hakanuzum/gmktec-k11-dual-fan-case/README.md

# GMKtec K11 Dual-Fan Case

**English** · [Türkçe](README.tr.md)

A 3D-printable enclosure that turns a GMKtec K11 mini PC into a small, closed tower with two 120 mm fans. The fans are powered from the K11's own USB ports, so there is no soldering and no extra power supply. The front and rear ports stay fully accessible.

| | |
|---|---|
| **Live 3D viewer** | **[hakanuzum.github.io/gmktec-k11-dual-fan-case](https://hakanuzum.github.io/gmktec-k11-dual-fan-case/viewer/)**: rotate, explode, cut a section, show the airflow, colour-code every part and see through the case (**Show how it fits together**), click any part to see what it does |
| **3D preview here** | [Below](#3d-preview): GitHub renders it, drag to rotate |
| **Single parts in 3D** | Click any file in [`stl/`](stl/): GitHub opens it in a 3D viewer |
| **Print files** | [`stl/`](stl/): 4 parts |
| **Editable source** | [`cad/k11_dual_fan_case.scad`](cad/k11_dual_fan_case.scad) (OpenSCAD, with Customizer sliders) |

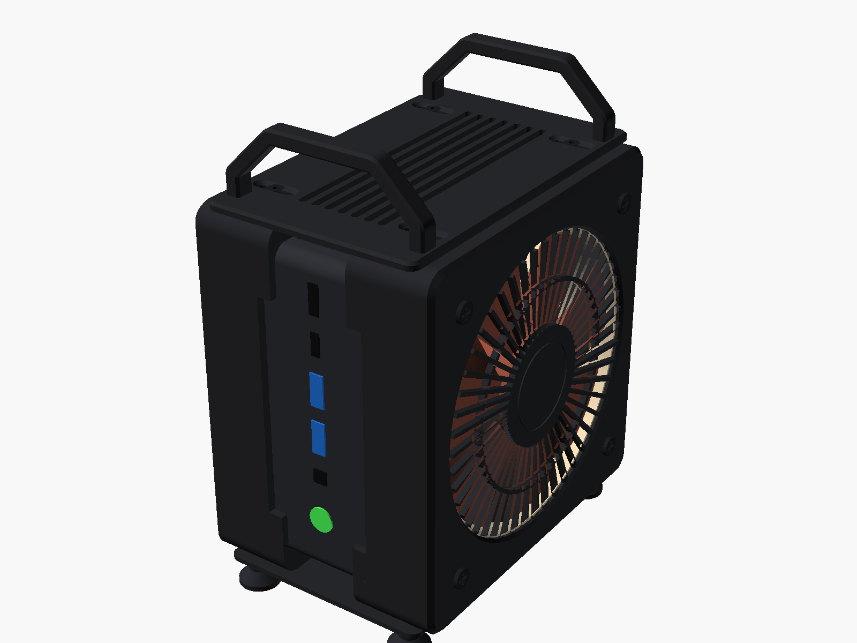
[picture p1: docs/images/hero.png]
Assembled case, black, with Noctua fans


> **Status:** designed and checked in software (see [Verification](#verification)); not yet printed and fitted on a real K11. Print one fan holder first and dry-fit it before printing the rest. Feedback and photos are welcome in the issues.

## 3D preview

Monochrome, low-poly preview of the closed case with a stand-in K11. Use the [live viewer](https://hakanuzum.github.io/gmktec-k11-dual-fan-case/viewer/) for colours, the exploded view and the airflow.

<!-- model:start -->
```stl
solid K11_DUAL_FAN_CASE_PREVIEW
facet normal 0.7 -0.3 -0.7
outer loop
vertex 50 -65.5 17
vertex 48 -61.5 13
vertex 50 -61.5 15
endloop
endfacet
facet normal 0.7 -0.3 -0.7
outer loop
vertex 50 -65.5 17
vertex 48 -67 15.5
vertex 48 -61.5 13
endloop
endfacet
facet normal 0.7 -0.7 -0.3
outer loop
vertex 50 -65.5 17
vertex 50 -67.5 21
vertex 48 -69.5 21
endloop
endfacet
facet normal 0.7 -0.7 -0.3
outer loop
vertex 50 -65.5 17
vertex 48 -69.5 21
vertex 48 -67 15.5
endloop
endfacet
facet normal 1 -0 -0
outer loop
vertex 50 -65.5 17
vertex 50 -61.5 15
vertex 50 -67.5 21
endloop
endfacet
facet normal 1 0 0
outer loop
vertex 50 -61.5 15
vertex 50 -55 30
vertex 50 -55 33
endloop
endfacet
facet normal 1 0 -0
outer loop
vertex 50 -61.5 15
vertex 50 -52.5 29
vertex 50 -55 30
endloop
endfacet
facet normal 1 0 -0
outer loop
vertex 50 -61.5 15
vertex 50 -18 29
vertex 50 -52.5 29
endloop
endfacet
facet normal 1 0 -0
outer loop
vertex 50 -61.5 15
vertex 50 -55 33
vertex 50 -55 66
endloop
endfacet
facet normal 1 0 0
outer loop
vertex 50 -52.5 34
vertex 50 -55 66
vertex 50 -55 33
endloop
endfacet
facet normal 1 0 -0
outer loop
vertex 50 -52.5 29
vertex 50 -34 37
vertex 50 -50 30
endloop
endfacet
facet normal 1 -0 0
outer loop
vertex 50 -52.5 34
vertex 50 -50 33
vertex 50 -47 50
endloop
endfacet
facet normal 1 0 -0
outer loop
vertex 50 -50 30
vertex 50 -41 44
vertex 50 -50 33
endloop
endfacet
facet normal 1 0 -0
outer loop
vertex 50 -50 30
vertex 50 -40 43
vertex 50 -41 44
endloop
endfacet
facet normal 1 -0 -0
outer loop
vertex 50 -52.5 29
vertex 50 -18 29
vertex 50 -34 37
endloop
endfacet
facet normal 1 0 -0
outer loop
vertex 50 -50 30
vertex 50 -34 37
vertex 50 -40 43
endloop
endfacet
facet normal 1 0 -0
outer loop
vertex 50 -50 33
vertex 50 -41 44
vertex 50 -47 50
endloop
endfacet
facet normal -0 -0.4 -0.9
outer loop
vertex 48 -67 15.5
vertex 22 -67 15.5
vertex 48 -61.5 13
endloop
endfacet
facet normal -0 -0.9 -0.4
outer loop
vertex 48 -67 15.5
vertex 48 -69.5 21
vertex 22 -69.5 21
endloop
endfacet
facet normal 0.7 0 -0.7
outer loop
vertex 50 -61.5 15
vertex 48 -61.5 13
vertex 48 61.5 13
endloop
endfacet
facet normal 1 0 -0
outer loop
vertex 50 -61.5 15
vertex 50 -1 26
vertex 50 -18 29
endloop
endfacet
facet normal 1 0 -0
outer loop
vertex 50 -61.5 15
vertex 50 1 26
vertex 50 -1 26
endloop
endfacet
facet normal 1 0 -0
outer loop
vertex 50 -61.5 15
vertex 50 -55 66
vertex 50 -58 83
endloop
endfacet
facet normal 1 0 0
outer loop
vertex 50 -61.5 15
vertex 50 -67.5 147
vertex 50 -67.5 21
endloop
endfacet
facet normal 0.7 -0.7 0
outer loop
vertex 50 -67.5 21
vertex 48 -69.5 147
vertex 48 -69.5 21
endloop
endfacet
facet normal 1 0 0
outer loop
vertex 50 -61.5 15
vertex 50 -58 83
vertex 50 -58 85
endloop
endfacet
facet normal 1 0 -0
outer loop
vertex 50 -52.5 34
vertex 50 -47 50
vertex 50 -55 66
endloop
endfacet
facet normal 1 0 -0
outer loop
vertex 50 -61.5 15
vertex 50 -58 85
vertex 50 -67.5 147
endloop
endfacet
facet normal 1 0 -0
outer loop
vertex 50 -58 83
vertex 50 -23 83
vertex 50 -58 85
endloop
endfacet
facet normal 1 0 -0
outer loop
vertex 50 -40 43
vertex 50 -15 67.5
vertex 50 -41 44
endloop
endfacet
facet normal 1 0 -0
outer loop
vertex 50 -41 44
vertex 50 -15 67.5
vertex 50 -16.5 69
endloop
endfacet
facet normal 1 0 -0
outer loop
vertex 50 -1 26
vertex 50 1 61
vertex 50 -1 61
endloop
endfacet
facet normal 1 0 0
outer loop
vertex 50 -15 67.5
vertex 50 -11.5 64
vertex 50 -1 61
endloop
endfacet
facet normal 1 -0 -0
outer loop
vertex 50 -15 67.5
vertex 50 -1 61
vertex 50 -16.5 69
endloop
endfacet
facet normal 1 -0 -0
outer loop
vertex 50 -23 83
vertex 50 -20 72.5
vertex 50 -23 85
endloop
endfacet
facet normal 1 0 0
outer loop
vertex 50 -1 61
vertex 50 -20 72.5
vertex 50 -16.5 69
endloop
endfacet
facet normal 1 0 0
outer loop
vertex 50 -1 61
vertex 50 -23 85
vertex 50 -20 72.5
endloop
endfacet
facet normal 1 0 0
outer loop
vertex 50 1 61
vertex 50 -23 85
vertex 50 -1 61
endloop
endfacet
facet normal 1 0 -0
outer loop
vertex 50 1 61
vertex 50 11.5 64
vertex 50 -23 85
endloop
endfacet
facet normal 1 0 0
outer loop
vertex 50 16.5 69
vertex 50 -20 95.5
vertex 50 -23 85
endloop
endfacet
facet normal 0 -0.9 -0.4
outer loop
vertex 48 -67 15.5
vertex 22 -69.5 21
vertex 22 -67 15.5
endloop
endfacet
facet normal 0 -0.4 -0.9
outer loop
vertex 48 -61.5 13
vertex 22 -67 15.5
vertex 22 -61.5 13
endloop
endfacet
facet normal 0 0 -1
outer loop
vertex 48 -61.5 13
vertex 22 -61.5 13
vertex 22 -51.5 13
endloop
endfacet
facet normal 0 0 -1
outer loop
vertex 48 -61.5 13
vertex 22 -51.5 13
vertex 22 -44 13
endloop
endfacet
facet normal -0 -1 -0
outer loop
vertex 48 -69.5 21
vertex 22 -69.5 40
vertex 22 -69.5 21
endloop
endfacet
facet normal 0 0 -1
outer loop
vertex 48 -61.5 13
vertex 22 -44 13
vertex 22 -42.5 13
endloop
endfacet
facet normal 0 -0.4 -0.9
outer loop
vertex 22 -67 15.5
vertex 22 -61.5 13
vertex 22 -61.5 13
endloop
endfacet
facet normal 0 0 -1
outer loop
vertex 22 -61.5 13
vertex 22 -61.5 13
vertex 22 -51.5 13
endloop
endfacet
facet normal -1 0 -0
outer loop
vertex 22 -60.5 21
vertex 22 -52.5 22
vertex 22 -52.5 21
endloop
endfacet
facet normal -1 0 0
outer loop
vertex 22 -65 22.5
vertex 22 -66.5 27
vertex 22 -66.5 40
endloop
endfacet
facet normal -1 0 0
outer loop
vertex 22 -60.5 21
vertex 22 -60.5 23.5
vertex 22 -52.5 22
endloop
endfacet
facet normal -1 0 0
outer loop
vertex 22 -52.5 22
vertex 22 -60.5 23.5
vertex 22 -52 22.5
endloop
endfacet
facet normal -1 0 0
outer loop
vertex 22 -52 22.5
vertex 22 -60.5 23.5
vertex 22 -51.5 23
endloop
endfacet
facet normal 0 0 -1
outer loop
vertex 48 -61.5 13
vertex 22 -42.5 13
vertex 22 42.5 13
endloop
endfacet
facet normal -1 0 0
outer loop
vertex 22 -42.5 13
vertex 22 -42 13.5
vertex 22 42 13.5
endloop
endfacet
facet normal -1 0 0
outer loop
vertex 22 -42 13.5
vertex 22 -41.5 14
vertex 22 41.5 14
endloop
endfacet
facet normal -1 0 0
outer loop
vertex 22 -41.5 14
vertex 22 -41.5 22
vertex 22 41.5 22
endloop
endfacet
facet normal -1 0 0
outer loop
vertex 22 -51.5 23
vertex 22 -60.5 23.5
vertex 22 60.5 23.5
endloop
endfacet
facet normal -1 0 0
outer loop
vertex 22 -41.5 22
vertex 22 -42 22.5
vertex 22 42 22.5
endloop
endfacet
facet normal -1 0 0
outer loop
vertex 22 -42 22.5
vertex 22 -42.5 23
vertex 22 42.5 23
endloop
endfacet
facet normal -1 0 -0
outer loop
vertex 22 -51.5 23
vertex 22 60.5 23.5
vertex 22 -42.5 23
endloop
endfacet
facet normal -0 -1 -0
outer loop
vertex 48 -69.5 21
vertex 22 -69.5 128
vertex 22 -69.5 40
endloop
endfacet
facet normal -1 0 0
outer loop
vertex 22 -60.5 21
vertex 22 -65 22.5
vertex 22 -66.5 128
endloop
endfacet
facet normal -1 0 0
outer loop
vertex 22 -60.5 21
vertex 22 -66.5 128
vertex 22 -60.5 23.5
endloop
endfacet
facet normal -1 0 0
outer loop
vertex 22 -65 22.5
vertex 22 -66.5 40
vertex 22 -66.5 128
endloop
endfacet
facet normal -1 0 0
outer loop
vertex 22 -69.5 40
vertex 22 -69.5 128
vertex 22 -66.5 40
endloop
endfacet
facet normal 1 0 -0
outer loop
vertex 50 -61.5 15
vertex 50 67.5 21
vertex 50 1 26
endloop
endfacet
facet normal 0 0 -1
outer loop
vertex 48 -61.5 13
vertex 47.5 42.5 13
vertex 47.5 51.5 13
endloop
endfacet
facet normal 0 0 -1
outer loop
vertex 48 -61.5 13
vertex 47.5 51.5 13
vertex 48 61.5 13
endloop
endfacet
facet normal 0.7 0 -0.7
outer loop
vertex 50 -61.5 15
vertex 48 61.5 13
vertex 50 61.5 15
endloop
endfacet
facet normal 1 0 0
outer loop
vertex 50 -61.5 15
vertex 50 61.5 15
vertex 50 67.5 21
endloop
endfacet
facet normal 1 0 0
outer loop
vertex 50 67.5 21
vertex 50 18 29
vertex 50 1 26
endloop
endfacet
facet normal 1 0 0
outer loop
vertex 50 -1 26
vertex 50 1 26
vertex 50 1 61
endloop
endfacet
facet normal 0 0 -1
outer loop
vertex 48 -61.5 13
vertex 22 42.5 13
vertex 47.5 42.5 13
endloop
endfacet
facet normal 1 0 0
outer loop
vertex 50 67.5 21
vertex 50 52.5 29
vertex 50 18 29
endloop
endfacet
facet normal 0.7 0.3 -0.7
outer loop
vertex 50 61.5 15
vertex 48 61.5 13
vertex 50 65.5 17
endloop
endfacet
facet normal 0.7 0.3 -0.7
outer loop
vertex 48 61.5 13
vertex 48 67 15.5
vertex 50 65.5 17
endloop
endfacet
facet normal 1 0 0
outer loop
vertex 50 61.5 15
vertex 50 65.5 17
vertex 50 67.5 21
endloop
endfacet
facet normal 0.7 0.7 -0.3
outer loop
vertex 50 65.5 17
vertex 48 69.5 21
vertex 50 67.5 21
endloop
endfacet
facet normal 0.7 0.7 -0.3
outer loop
vertex 50 65.5 17
vertex 48 67 15.5
vertex 48 69.5 21
endloop
endfacet
facet normal 1 0 0
outer loop
vertex 50 67.5 21
vertex 50 55 30
vertex 50 52.5 29
endloop
endfacet
facet normal 1 0 0
outer loop
vertex 50 67.5 21
vertex 50 55 33
vertex 50 55 30
endloop
endfacet
facet normal 1 0 -0
outer loop
vertex 50 18 29
vertex 50 52.5 29
vertex 50 34 37
endloop
endfacet
facet normal 1 0 0
outer loop
vertex 50 40 43
vertex 50 34 37
vertex 50 50 30
endloop
endfacet
facet normal 1 -0 -0
outer loop
vertex 50 34 37
vertex 50 52.5 29
vertex 50 50 30
endloop
endfacet
facet normal 1 0 -0
outer loop
vertex 50 50 30
vertex 50 50 33
vertex 50 41 44
endloop
endfacet
facet normal 1 -0 -0
outer loop
vertex 50 40 43
vertex 50 50 30
vertex 50 41 44
endloop
endfacet
facet normal 1 -0 0
outer loop
vertex 50 47 50
vertex 50 50 33
vertex 50 52.5 34
endloop
endfacet
facet normal 1 0 0
outer loop
vertex 50 47 50
vertex 50 52.5 34
vertex 50 55 33
endloop
endfacet
facet normal 1 0 0
outer loop
vertex 50 47 50
vertex 50 41 44
vertex 50 50 33
endloop
endfacet
facet normal 1 0 0
outer loop
vertex 50 67.5 21
vertex 50 47 50
vertex 50 55 33
endloop
endfacet
facet normal 1 0 0
outer loop
vertex 50 67.5 21
vertex 50 55 66
vertex 50 47 50
endloop
endfacet
facet normal 0 1 -0
outer loop
vertex 48 69.5 21
vertex 40 69.5 36.5
vertex 41.5 69.5 39
endloop
endfacet
facet normal 0 1 -0
outer loop
vertex 48 69.5 21
vertex 37.5 69.5 35
vertex 40 69.5 36.5
endloop
endfacet
facet normal 0 0 -1
outer loop
vertex 47.5 51.5 13
vertex 22 61.5 13
vertex 48 61.5 13
endloop
endfacet
facet normal 0 0.4 -0.9
outer loop
vertex 48 61.5 13
vertex 22 61.5 13
vertex 48 67 15.5
endloop
endfacet
facet normal 0 0.9 -0.4
outer loop
vertex 48 67 15.5
vertex 22 69.5 21
vertex 48 69.5 21
endloop
endfacet
facet normal 0 1 -0
outer loop
vertex 48 69.5 21
vertex 32 69.5 35
vertex 37.5 69.5 35
endloop
endfacet
facet normal 0 1 -0
outer loop
vertex 48 69.5 21
vertex 22 69.5 21
vertex 32 69.5 35
endloop
endfacet
facet normal 1 0 0
outer loop
vertex 50 41 44
vertex 50 16.5 69
vertex 50 40 43
endloop
endfacet
facet normal 1 -0 -0
outer loop
vertex 50 15 67.5
vertex 50 40 43
vertex 50 16.5 69
endloop
endfacet
facet normal 1 0 -0
outer loop
vertex 50 11.5 64
vertex 50 15 67.5
vertex 50 -23 85
endloop
endfacet
facet normal 1 0 0
outer loop
vertex 50 16.5 69
vertex 50 -23 85
vertex 50 15 67.5
endloop
endfacet
facet normal 1 0 -0
outer loop
vertex 50 16.5 69
vertex 50 20 72.5
vertex 50 15 100.5
endloop
endfacet
facet normal 1 0 -0
outer loop
vertex 50 23 83
vertex 50 58 83
vertex 50 23 85
endloop
endfacet
facet normal 1 0 0
outer loop
vertex 50 67.5 21
vertex 50 58 83
vertex 50 55 66
endloop
endfacet
facet normal 0.7 0.7 -0
outer loop
vertex 50 67.5 21
vertex 48 69.5 21
vertex 48 69.5 147
endloop
endfacet
facet normal 0 1 -0
outer loop
vertex 48 69.5 21
vertex 41.5 69.5 39
vertex 48 69.5 147
endloop
endfacet
facet normal 0 1 0
outer loop
vertex 48 69.5 147
vertex 41.5 69.5 39
vertex 40 69.5 41.5
endloop
endfacet
facet normal 0 1 0
outer loop
vertex 48 69.5 147
vertex 40 69.5 41.5
vertex 37.5 69.5 43
endloop
endfacet
facet normal 0 1 0
outer loop
vertex 48 69.5 147
vertex 37.5 69.5 43
vertex 32 69.5 43
endloop
endfacet
facet normal 0 1 0
outer loop
vertex 48 69.5 147
vertex 32 69.5 43
vertex 29.5 69.5 41.5
endloop
endfacet
facet normal 0 1 0
outer loop
vertex 48 69.5 147
vertex 29.5 69.5 41.5
vertex 28.5 69.5 39
endloop
endfacet
facet normal -1 0 0
outer loop
vertex 22 -42.5 13
vertex 22 42 13.5
vertex 22 42.5 13
endloop
endfacet
facet normal -1 0 0
outer loop
vertex 22 -42 13.5
vertex 22 41.5 14
vertex 22 42 13.5
endloop
endfacet
facet normal -1 0 0
outer loop
vertex 22 -41.5 14
vertex 22 41.5 22
vertex 22 41.5 14
endloop
endfacet
facet normal -1 0 -0
outer loop
vertex 22 -41.5 22
vertex 22 42 22.5
vertex 22 41.5 22
endloop
endfacet
facet normal -1 0 -0
outer loop
vertex 22 -42 22.5
vertex 22 42.5 23
vertex 22 42 22.5
endloop
endfacet
facet normal -1 0 -0
outer loop
vertex 22 -42.5 23
vertex 22 60.5 23.5
vertex 22 42.5 23
endloop
endfacet
facet normal 0 0 -1
outer loop
vertex 47.5 51.5 13
vertex 22 51.5 13
vertex 22 61.5 13
endloop
endfacet
facet normal 0 0.4 -0.9
outer loop
vertex 48 67 15.5
vertex 22 61.5 13
vertex 22 67 15.5
endloop
endfacet
facet normal 0 0.9 -0.4
outer loop
vertex 48 67 15.5
vertex 22 67 15.5
vertex 22 69.5 21
endloop
endfacet
facet normal -0 1 0
outer loop
vertex 22 69.5 21
vertex 29.5 69.5 36.5
vertex 32 69.5 35
endloop
endfacet
facet normal -0 1 0
outer loop
vertex 22 69.5 21
vertex 28.5 69.5 39
vertex 29.5 69.5 36.5
endloop
endfacet
facet normal 0 0 -1
outer loop
vertex 22 44 13
vertex 22 44 13
vertex 22 51.5 13
endloop
endfacet
facet normal -1 0 -0
outer loop
vertex 22 42.5 23
vertex 22 60.5 23.5
vertex 22 51.5 23
endloop
endfacet
facet normal 0 0 -1
outer loop
vertex 22 44 13
vertex 22 61.5 13
vertex 22 51.5 13
endloop
endfacet
facet normal -1 0 0
outer loop
vertex 22 52.5 21
vertex 22 52.5 22
vertex 22 60.5 21
endloop
endfacet
facet normal -1 0 0
outer loop
vertex 22 60.5 21
vertex 22 52.5 22
vertex 22 52 22.5
endloop
endfacet
facet normal -1 0 -0
outer loop
vertex 22 51.5 23
vertex 22 60.5 23.5
vertex 22 52 22.5
endloop
endfacet
facet normal -1 0 0
outer loop
vertex 22 60.5 21
vertex 22 52 22.5
vertex 22 60.5 23.5
endloop
endfacet
facet normal -1 0 0
outer loop
vertex 22 60.5 21
vertex 22 60.5 23.5
vertex 22 65 22.5
endloop
endfacet
facet normal -0 1 0
outer loop
vertex 22 69.5 21
vertex 48 69.5 147
vertex 28.5 69.5 39
endloop
endfacet
facet normal 0 1 0
outer loop
vertex 22 69.5 21
vertex 22 69.5 40
vertex 48 69.5 147
endloop
endfacet
facet normal -1 0 0
outer loop
vertex 22 65 22.5
vertex 22 60.5 23.5
vertex 22 60.5 144.5
endloop
endfacet
facet normal -1 0 0
outer loop
vertex 22 65 22.5
vertex 22 60.5 144.5
vertex 22 66.5 27
endloop
endfacet
facet normal -1 0 0
outer loop
vertex 22 66.5 27
vertex 22 60.5 144.5
vertex 22 66.5 40
endloop
endfacet
facet normal -1 0 0
outer loop
vertex 22 66.5 40
vertex 22 66.5 128
vertex 22 69.5 40
endloop
endfacet
facet normal 0.7 -0.7 0
outer loop
vertex 50 -67.5 21
vertex 50 -67.5 147
vertex 48 -69.5 147
endloop
endfacet
facet normal 1 -0 0
outer loop
vertex 50 -67.5 147
vertex 50 -58 85
vertex 50 -55 102
endloop
endfacet
facet normal 0 -1 0
outer loop
vertex 48 -69.5 21
vertex 48 -69.5 147
vertex 22 -69.5 147
endloop
endfacet
facet normal 1 0 -0
outer loop
vertex 50 -23 83
vertex 50 -23 85
vertex 50 -58 85
endloop
endfacet
facet normal 1 0 0
outer loop
vertex 50 16.5 69
vertex 50 -16.5 99
vertex 50 -20 95.5
endloop
endfacet
facet normal 1 -0 -0
outer loop
vertex 50 -16.5 99
vertex 50 16.5 69
vertex 50 -15 100.5
endloop
endfacet
facet normal 1 0 0
outer loop
vertex 50 16.5 69
vertex 50 -11.5 104
vertex 50 -15 100.5
endloop
endfacet
facet normal 1 0 0
outer loop
vertex 50 -15 100.5
vertex 50 -40 125
vertex 50 -16.5 99
endloop
endfacet
facet normal 1 0 0
outer loop
vertex 50 -16.5 99
vertex 50 -40 125
vertex 50 -41 124
endloop
endfacet
facet normal 1 -0 0
outer loop
vertex 50 -67.5 147
vertex 50 -55 102
vertex 50 -47 118
endloop
endfacet
facet normal 1 -0 -0
outer loop
vertex 50 -67.5 147
vertex 50 -47 118
vertex 50 -55 135
endloop
endfacet
facet normal 1 0 -0
outer loop
vertex 50 -47 118
vertex 50 -41 124
vertex 50 -50 135
endloop
endfacet
facet normal 1 0 0
outer loop
vertex 50 -40 125
vertex 50 -50 135
vertex 50 -41 124
endloop
endfacet
facet normal 1 0 0
outer loop
vertex 50 -47 118
vertex 50 -52.5 134
vertex 50 -55 135
endloop
endfacet
facet normal 1 0 0
outer loop
vertex 50 -47 118
vertex 50 -50 135
vertex 50 -52.5 134
endloop
endfacet
facet normal 1 0 0
outer loop
vertex 50 -34 131
vertex 50 -50 138
vertex 50 -50 135
endloop
endfacet
facet normal 1 0 -0
outer loop
vertex 50 -40 125
vertex 50 -34 131
vertex 50 -50 135
endloop
endfacet
facet normal 1 -0 0
outer loop
vertex 50 -67.5 147
vertex 50 -55 135
vertex 50 -55 138
endloop
endfacet
facet normal 1 -0 0
outer loop
vertex 50 -67.5 147
vertex 50 -55 138
vertex 50 -52.5 139
endloop
endfacet
facet normal 0.7 -0.7 0.3
outer loop
vertex 50 -67.5 147
vertex 50 -65.5 151
vertex 48 -69.5 147
endloop
endfacet
facet normal 0.7 -0.7 0.3
outer loop
vertex 48 -69.5 147
vertex 50 -65.5 151
vertex 48 -67 152.5
endloop
endfacet
facet normal 1 0 -0
outer loop
vertex 50 -67.5 147
vertex 50 -61.5 153
vertex 50 -65.5 151
endloop
endfacet
facet normal 0.7 -0.3 0.7
outer loop
vertex 50 -65.5 151
vertex 50 -61.5 153
vertex 48 -61.5 155
endloop
endfacet
facet normal 0.7 -0.3 0.7
outer loop
vertex 50 -65.5 151
vertex 48 -61.5 155
vertex 48 -67 152.5
endloop
endfacet
facet normal 1 -0 0
outer loop
vertex 50 -67.5 147
vertex 50 -52.5 139
vertex 50 -18 139
endloop
endfacet
facet normal 1 -0 0
outer loop
vertex 50 -52.5 139
vertex 50 -50 138
vertex 50 -18 139
endloop
endfacet
facet normal 0 -0.9 0.4
outer loop
vertex 48 -69.5 147
vertex 48 -67 152.5
vertex 22 -69.5 147
endloop
endfacet
facet normal 0 -0.4 0.9
outer loop
vertex 48 -67 152.5
vertex 48 -61.5 155
vertex 22 -67 152.5
endloop
endfacet
facet normal 0 0 1
outer loop
vertex 48 -61.5 155
vertex 47.5 -51.5 155
vertex 22 -51.5 155
endloop
endfacet
facet normal 1 0 -0
outer loop
vertex 50 -34 131
vertex 50 -18 139
vertex 50 -50 138
endloop
endfacet
facet normal 1 0 -0
outer loop
vertex 50 -1 107
vertex 50 1 142
vertex 50 -1 142
endloop
endfacet
facet normal 1 -0 0
outer loop
vertex 50 -67.5 147
vertex 50 -18 139
vertex 50 -1 142
endloop
endfacet
facet normal 1 -0 0
outer loop
vertex 50 -67.5 147
vertex 50 -1 142
vertex 50 1 142
endloop
endfacet
facet normal 1 0 -0
outer loop
vertex 50 -67.5 147
vertex 50 65.5 151
vertex 50 -61.5 153
endloop
endfacet
facet normal 0.7 0 0.7
outer loop
vertex 50 -61.5 153
vertex 48 61.5 155
vertex 48 -61.5 155
endloop
endfacet
facet normal 0 -0 1
outer loop
vertex 48 -61.5 155
vertex 48 61.5 155
vertex 47.5 -51.5 155
endloop
endfacet
facet normal 0 -0 1
outer loop
vertex 47.5 -51.5 155
vertex 48 61.5 155
vertex 47.5 -42.5 155
endloop
endfacet
facet normal 1 -0 0
outer loop
vertex 50 -67.5 147
vertex 50 1 142
vertex 50 65.5 151
endloop
endfacet
facet normal 0 -0 1
outer loop
vertex 47.5 -42.5 155
vertex 47.5 51.5 155
vertex 22 -44 155
endloop
endfacet
facet normal -0 -1 -0
outer loop
vertex 48 -69.5 21
vertex 22 -69.5 147
vertex 22 -69.5 128
endloop
endfacet
facet normal -1 0 0
outer loop
vertex 22 -66.5 40
vertex 22 -69.5 128
vertex 22 -66.5 128
endloop
endfacet
facet normal -1 0 0
outer loop
vertex 22 -66.5 128
vertex 22 -66.5 141
vertex 22 -60.5 23.5
endloop
endfacet
facet normal -1 0 0
outer loop
vertex 22 -66.5 141
vertex 22 -65 145.5
vertex 22 -60.5 23.5
endloop
endfacet
facet normal -1 0 0
outer loop
vertex 22 -65 145.5
vertex 22 -60.5 144.5
vertex 22 -60.5 23.5
endloop
endfacet
facet normal 0 -0.9 0.4
outer loop
vertex 48 -67 152.5
vertex 22 -67 152.5
vertex 22 -69.5 147
endloop
endfacet
facet normal 0 -0.4 0.9
outer loop
vertex 48 -61.5 155
vertex 22 -61.5 155
vertex 22 -67 152.5
endloop
endfacet
facet normal 0 0 1
outer loop
vertex 48 -61.5 155
vertex 22 -51.5 155
vertex 22 -61.5 155
endloop
endfacet
facet normal -1 0 0
outer loop
vertex 22 -65 145.5
vertex 22 -60.5 147
vertex 22 -60.5 144.5
endloop
endfacet
facet normal -1 -0 0
outer loop
vertex 22 -52 145.5
vertex 22 -60.5 144.5
vertex 22 -60.5 147
endloop
endfacet
facet normal -1 0 -0
outer loop
vertex 22 -52 145.5
vertex 22 -51.5 145
vertex 22 -60.5 144.5
endloop
endfacet
facet normal -1 0 0
outer loop
vertex 22 -52 145.5
vertex 22 -60.5 147
vertex 22 -52.5 146
endloop
endfacet
facet normal 0 -0.4 0.9
outer loop
vertex 22 -67 152.5
vertex 22 -61.5 155
vertex 22 -61.5 155
endloop
endfacet
facet normal -1 0 0
outer loop
vertex 22 -52.5 146
vertex 22 -60.5 147
vertex 22 -52.5 147
endloop
endfacet
facet normal -1 0 -0
outer loop
vertex 22 -51.5 145
vertex 22 -42.5 145
vertex 22 -60.5 144.5
endloop
endfacet
facet normal -1 -0 -0
outer loop
vertex 22 -42.5 145
vertex 22 -42 144.5
vertex 22 -60.5 144.5
endloop
endfacet
facet normal -1 0 -0
outer loop
vertex 22 -42.5 145
vertex 22 -42 145.5
vertex 22 -42 144.5
endloop
endfacet
facet normal 0 0 1
outer loop
vertex 22 -44 155
vertex 22 -42.5 155
vertex 22 -44 155
endloop
endfacet
facet normal -1 0 -0
outer loop
vertex 22 -42 145.5
vertex 22 42 145.5
vertex 22 -42 144.5
endloop
endfacet
facet normal -1 0 0
outer loop
vertex 22 -42 145.5
vertex 22 -41.5 146
vertex 22 41.5 146
endloop
endfacet
facet normal -1 0 0
outer loop
vertex 22 -41.5 146
vertex 22 -41.5 154
vertex 22 41.5 154
endloop
endfacet
facet normal 0 0 1
outer loop
vertex 22 -44 155
vertex 22 42.5 155
vertex 22 -42.5 155
endloop
endfacet
facet normal -1 -0 -0
outer loop
vertex 22 -42.5 155
vertex 22 42 154.5
vertex 22 -42 154.5
endloop
endfacet
facet normal -1 0 0
outer loop
vertex 22 -41.5 154
vertex 22 -42 154.5
vertex 22 41.5 154
endloop
endfacet
facet normal 1 0 0
outer loop
vertex 50 16.5 69
vertex 50 15 100.5
vertex 50 11.5 104
endloop
endfacet
facet normal 1 0 0
outer loop
vertex 50 16.5 69
vertex 50 -1 107
vertex 50 -11.5 104
endloop
endfacet
facet normal 1 0 0
outer loop
vertex 50 16.5 69
vertex 50 1 107
vertex 50 -1 107
endloop
endfacet
facet normal 1 0 0
outer loop
vertex 50 16.5 69
vertex 50 11.5 104
vertex 50 1 107
endloop
endfacet
facet normal 1 0 -0
outer loop
vertex 50 20 72.5
vertex 50 23 83
vertex 50 15 100.5
endloop
endfacet
facet normal 1 0 -0
outer loop
vertex 50 23 83
vertex 50 23 85
vertex 50 15 100.5
endloop
endfacet
facet normal 1 0 0
outer loop
vertex 50 16.5 99
vertex 50 15 100.5
vertex 50 23 85
endloop
endfacet
facet normal 1 0 0
outer loop
vertex 50 20 95.5
vertex 50 16.5 99
vertex 50 23 85
endloop
endfacet
facet normal 1 0 -0
outer loop
vertex 50 1 107
vertex 50 1 142
vertex 50 -1 107
endloop
endfacet
facet normal 1 0 -0
outer loop
vertex 50 16.5 99
vertex 50 41 124
vertex 50 15 100.5
endloop
endfacet
facet normal 1 0 -0
outer loop
vertex 50 15 100.5
vertex 50 41 124
vertex 50 40 125
endloop
endfacet
facet normal 1 0 -0
outer loop
vertex 50 58 83
vertex 50 58 85
vertex 50 23 85
endloop
endfacet
facet normal 1 0 0
outer loop
vertex 50 67.5 21
vertex 50 65.5 151
vertex 50 58 83
endloop
endfacet
facet normal 1 0 0
outer loop
vertex 50 55 102
vertex 50 52.5 134
vertex 50 47 118
endloop
endfacet
facet normal 1 0 0
outer loop
vertex 50 65.5 151
vertex 50 58 85
vertex 50 58 83
endloop
endfacet
facet normal 0.7 0.7 0
outer loop
vertex 50 67.5 21
vertex 48 69.5 147
vertex 50 67.5 147
endloop
endfacet
facet normal 1 0 -0
outer loop
vertex 50 67.5 21
vertex 50 67.5 147
vertex 50 65.5 151
endloop
endfacet
facet normal 1 0 0
outer loop
vertex 50 65.5 151
vertex 50 55 102
vertex 50 58 85
endloop
endfacet
facet normal 1 -0 0
outer loop
vertex 50 18 139
vertex 50 34 131
vertex 50 50 138
endloop
endfacet
facet normal 1 0 0
outer loop
vertex 50 65.5 151
vertex 50 1 142
vertex 50 18 139
endloop
endfacet
facet normal 0.7 -0 0.7
outer loop
vertex 50 -61.5 153
vertex 50 61.5 153
vertex 48 61.5 155
endloop
endfacet
facet normal 1 -0 -0
outer loop
vertex 50 -61.5 153
vertex 50 65.5 151
vertex 50 61.5 153
endloop
endfacet
facet normal 0 -0 1
outer loop
vertex 47.5 -42.5 155
vertex 48 61.5 155
vertex 47.5 51.5 155
endloop
endfacet
facet normal 1 -0 0
outer loop
vertex 50 41 124
vertex 50 47 118
vertex 50 50 135
endloop
endfacet
facet normal 1 -0 0
outer loop
vertex 50 34 131
vertex 50 40 125
vertex 50 50 138
endloop
endfacet
facet normal 1 0 -0
outer loop
vertex 50 41 124
vertex 50 50 138
vertex 50 40 125
endloop
endfacet
facet normal 1 0 0
outer loop
vertex 50 41 124
vertex 50 50 135
vertex 50 50 138
endloop
endfacet
facet normal 1 0 -0
outer loop
vertex 50 47 118
vertex 50 52.5 134
vertex 50 50 135
endloop
endfacet
facet normal 1 0 0
outer loop
vertex 50 55 102
vertex 50 55 135
vertex 50 52.5 134
endloop
endfacet
facet normal 1 0 0
outer loop
vertex 50 65.5 151
vertex 50 55 135
vertex 50 55 102
endloop
endfacet
facet normal 1 -0 0
outer loop
vertex 50 18 139
vertex 50 50 138
vertex 50 52.5 139
endloop
endfacet
facet normal 1 0 0
outer loop
vertex 50 65.5 151
vertex 50 18 139
vertex 50 52.5 139
endloop
endfacet
facet normal 1 0 0
outer loop
vertex 50 65.5 151
vertex 50 55 138
vertex 50 55 135
endloop
endfacet
facet normal 1 0 0
outer loop
vertex 50 65.5 151
vertex 50 52.5 139
vertex 50 55 138
endloop
endfacet
facet normal 0.7 0.7 0.3
outer loop
vertex 50 67.5 147
vertex 48 69.5 147
vertex 50 65.5 151
endloop
endfacet
facet normal 0.7 0.7 0.3
outer loop
vertex 48 69.5 147
vertex 48 67 152.5
vertex 50 65.5 151
endloop
endfacet
facet normal 0.7 0.3 0.7
outer loop
vertex 50 61.5 153
vertex 50 65.5 151
vertex 48 61.5 155
endloop
endfacet
facet normal 0.7 0.3 0.7
outer loop
vertex 48 61.5 155
vertex 50 65.5 151
vertex 48 67 152.5
endloop
endfacet
facet normal 0 -0 1
outer loop
vertex 47.5 51.5 155
vertex 48 61.5 155
vertex 22 51.5 155
endloop
endfacet
facet normal -0 0.9 0.4
outer loop
vertex 48 69.5 147
vertex 22 67 152.5
vertex 48 67 152.5
endloop
endfacet
facet normal 0 0.4 0.9
outer loop
vertex 48 61.5 155
vertex 48 67 152.5
vertex 22 67 152.5
endloop
endfacet
facet normal 0 1 0
outer loop
vertex 22 69.5 40
vertex 22 69.5 128
vertex 48 69.5 147
endloop
endfacet
facet normal -1 0 0
outer loop
vertex 22 69.5 40
vertex 22 66.5 128
vertex 22 69.5 128
endloop
endfacet
facet normal -1 0 0
outer loop
vertex 22 66.5 40
vertex 22 60.5 144.5
vertex 22 66.5 128
endloop
endfacet
facet normal 0 -0 1
outer loop
vertex 22 -44 155
vertex 47.5 51.5 155
vertex 22 42.5 155
endloop
endfacet
facet normal -1 -0 0
outer loop
vertex 22 42.5 145
vertex 22 -42 144.5
vertex 22 42 145.5
endloop
endfacet
facet normal -1 0 0
outer loop
vertex 22 -42 145.5
vertex 22 41.5 146
vertex 22 42 145.5
endloop
endfacet
facet normal -1 0 -0
outer loop
vertex 22 42.5 145
vertex 22 51.5 145
vertex 22 -42 144.5
endloop
endfacet
facet normal -1 0 0
outer loop
vertex 22 -41.5 146
vertex 22 41.5 154
vertex 22 41.5 146
endloop
endfacet
facet normal -1 0 -0
outer loop
vertex 22 -42 154.5
vertex 22 42 154.5
vertex 22 41.5 154
endloop
endfacet
facet normal -1 0 -0
outer loop
vertex 22 -42.5 155
vertex 22 42.5 155
vertex 22 42 154.5
endloop
endfacet
facet normal -1 -0 -0
outer loop
vertex 22 51.5 145
vertex 22 60.5 144.5
vertex 22 -42 144.5
endloop
endfacet
facet normal 0 1 -0
outer loop
vertex 48 69.5 147
vertex 22 69.5 128
vertex 22 69.5 147
endloop
endfacet
facet normal 0 0 1
outer loop
vertex 48 61.5 155
vertex 22 61.5 155
vertex 22 51.5 155
endloop
endfacet
facet normal 0 0.9 0.4
outer loop
vertex 48 69.5 147
vertex 22 69.5 147
vertex 22 67 152.5
endloop
endfacet
facet normal 0 0.4 0.9
outer loop
vertex 48 61.5 155
vertex 22 67 152.5
vertex 22 61.5 155
endloop
endfacet
facet normal -1 0 0
outer loop
vertex 22 51.5 145
vertex 22 52 145.5
vertex 22 60.5 144.5
endloop
endfacet
facet normal -1 0 0
outer loop
vertex 22 52 145.5
vertex 22 52.5 146
vertex 22 60.5 147
endloop
endfacet
facet normal -1 0 -0
outer loop
vertex 22 52 145.5
vertex 22 60.5 147
vertex 22 60.5 144.5
endloop
endfacet
facet normal -1 0 0
outer loop
vertex 22 66.5 128
vertex 22 60.5 147
vertex 22 66.5 141
endloop
endfacet
facet normal -1 0 0
outer loop
vertex 22 66.5 128
vertex 22 60.5 144.5
vertex 22 60.5 147
endloop
endfacet
facet normal -1 0 0
outer loop
vertex 22 66.5 141
vertex 22 60.5 147
vertex 22 65 145.5
endloop
endfacet
facet normal -1 0 0
outer loop
vertex 22 52.5 146
vertex 22 52.5 147
vertex 22 60.5 147
endloop
endfacet
facet normal 0 0.4 0.9
outer loop
vertex 22 61.5 155
vertex 22 67 152.5
vertex 22 61.5 155
endloop
endfacet
facet normal -1 0 -0
outer loop
vertex 47.5 -65.5 17
vertex 47.5 -52.5 22
vertex 47.5 -61.5 15.5
endloop
endfacet
facet normal -1 0 0
outer loop
vertex 47.5 -65.5 17
vertex 47.5 -52.5 24
vertex 47.5 -52.5 22
endloop
endfacet
facet normal -1 0 0
outer loop
vertex 47.5 -61.5 15.5
vertex 47.5 -52.5 22
vertex 47.5 -52.5 15.5
endloop
endfacet
facet normal -1 0 0
outer loop
vertex 47.5 -65.5 17
vertex 47.5 -55 30
vertex 47.5 -52.5 24
endloop
endfacet
facet normal -1 0 0
outer loop
vertex 47.5 -52.5 22
vertex 47.5 -52.5 24
vertex 47.5 -52 22.5
endloop
endfacet
facet normal -1 0 0
outer loop
vertex 47.5 -65.5 17
vertex 47.5 -55 33
vertex 47.5 -55 30
endloop
endfacet
facet normal -1 0 -0
outer loop
vertex 47.5 -65.5 17
vertex 47.5 -53.5 35.5
vertex 47.5 -55 33
endloop
endfacet
facet normal -1 -0 -0
outer loop
vertex 47.5 -53 29
vertex 47.5 -52.5 24
vertex 47.5 -55 30
endloop
endfacet
facet normal -1 0 -0
outer loop
vertex 47.5 -52.5 29
vertex 47.5 -52.5 29
vertex 47.5 -52.5 29
endloop
endfacet
facet normal -1 0 0
outer loop
vertex 47.5 -52.5 29
vertex 47.5 -52.5 29
vertex 47.5 -52 29
endloop
endfacet
facet normal -1 0 0
outer loop
vertex 47.5 -52.5 29
vertex 47.5 -52 29
vertex 47.5 -52 29
endloop
endfacet
facet normal 0 0.4 0.9
outer loop
vertex 47.5 -65.5 17
vertex 47.5 -61.5 15.5
vertex 31.5 -61.5 15.5
endloop
endfacet
facet normal -0 0.9 0.4
outer loop
vertex 47.5 -65.5 17
vertex 31.5 -67 21
vertex 47.5 -67 21
endloop
endfacet
facet normal 0 -0 1
outer loop
vertex 47.5 -61.5 15.5
vertex 47.5 -52.5 15.5
vertex 31.5 -61.5 15.5
endloop
endfacet
facet normal -1 0 0
outer loop
vertex 47.5 -52 22.5
vertex 47.5 -52.5 24
vertex 47.5 -51.5 23
endloop
endfacet
facet normal -1 0 0
outer loop
vertex 47.5 -51.5 23
vertex 47.5 -52.5 24
vertex 47.5 -42 24.5
endloop
endfacet
facet normal -1 0 -0
outer loop
vertex 47.5 -51.5 23
vertex 47.5 -42 24.5
vertex 47.5 -42.5 23
endloop
endfacet
facet normal -1 0 0
outer loop
vertex 47.5 -50 30
vertex 47.5 -52 29
vertex 47.5 -52.5 29
endloop
endfacet
facet normal -1 0 0
outer loop
vertex 47.5 -52 29
vertex 47.5 -50 30
vertex 47.5 -44 33
endloop
endfacet
facet normal -1 0 0
outer loop
vertex 47.5 -42 22.5
vertex 47.5 -42.5 23
vertex 47.5 -42 24.5
endloop
endfacet
facet normal -1 0 -0
outer loop
vertex 47.5 -53.5 35.5
vertex 47.5 -52.5 34
vertex 47.5 -55 33
endloop
endfacet
facet normal -1 0 -0
outer loop
vertex 47.5 -53 36
vertex 47.5 -52.5 34
vertex 47.5 -52.5 34
endloop
endfacet
facet normal -1 0 0
outer loop
vertex 47.5 -53 36
vertex 47.5 -52.5 34.5
vertex 47.5 -52.5 34
endloop
endfacet
facet normal -1 0 0
outer loop
vertex 47.5 -53.5 35.5
vertex 47.5 -53 36
vertex 47.5 -52.5 34
endloop
endfacet
facet normal -1 0 0
outer loop
vertex 47.5 -65.5 17
vertex 47.5 -56 70.5
vertex 47.5 -53.5 35.5
endloop
endfacet
facet normal -1 0 0
outer loop
vertex 47.5 -50 30
vertex 47.5 -50 33
vertex 47.5 -44 33
endloop
endfacet
facet normal -1 0 -0
outer loop
vertex 47.5 -52.5 34
vertex 47.5 -44 33
vertex 47.5 -50 33
endloop
endfacet
facet normal -1 0 0
outer loop
vertex 47.5 -52.5 34
vertex 47.5 -52.5 34
vertex 47.5 -44 33
endloop
endfacet
facet normal -1 0 0
outer loop
vertex 47.5 -52.5 34
vertex 47.5 -45 39.5
vertex 47.5 -44 33
endloop
endfacet
facet normal -1 0 0
outer loop
vertex 47.5 -42 24.5
vertex 47.5 -45.5 48.5
vertex 47.5 -34 37
endloop
endfacet
facet normal -1 -0 0
outer loop
vertex 47.5 -46.5 49.5
vertex 47.5 -52.5 34.5
vertex 47.5 -52.5 37.5
endloop
endfacet
facet normal -1 -0 0
outer loop
vertex 47.5 -46.5 49.5
vertex 47.5 -52.5 37.5
vertex 47.5 -47 50
endloop
endfacet
facet normal -1 0 0
outer loop
vertex 47.5 -34 37
vertex 47.5 -45.5 48.5
vertex 47.5 -40 43
endloop
endfacet
facet normal -1 0 0
outer loop
vertex 47.5 -45.5 48.5
vertex 47.5 -41 44
vertex 47.5 -40 43
endloop
endfacet
facet normal 0 0.4 0.9
outer loop
vertex 47.5 -65.5 17
vertex 31.5 -61.5 15.5
vertex 31.5 -65.5 17
endloop
endfacet
facet normal 0 0.9 0.4
outer loop
vertex 47.5 -65.5 17
vertex 31.5 -65.5 17
vertex 31.5 -67 21
endloop
endfacet
facet normal 0 0 1
outer loop
vertex 47.5 -52.5 15.5
vertex 31.5 -52.5 15.5
vertex 31.5 -61.5 15.5
endloop
endfacet
facet normal -1 0 0
outer loop
vertex 47.5 -42 22.5
vertex 47.5 -42 24.5
vertex 47.5 -18 29
endloop
endfacet
facet normal -1 0 0
outer loop
vertex 47.5 -42 24.5
vertex 47.5 -34 37
vertex 47.5 -18 29
endloop
endfacet
facet normal -1 0 0
outer loop
vertex 47.5 -42 22.5
vertex 47.5 -18 29
vertex 47.5 -1 26
endloop
endfacet
facet normal -1 0 0
outer loop
vertex 47.5 -41.5 15.5
vertex 47.5 -41.5 22
vertex 47.5 41.5 22
endloop
endfacet
facet normal -1 0 0
outer loop
vertex 47.5 -41.5 22
vertex 47.5 -42 22.5
vertex 47.5 42 22.5
endloop
endfacet
facet normal -1 0 0
outer loop
vertex 47.5 -42 22.5
vertex 47.5 -1 26
vertex 47.5 42 22.5
endloop
endfacet
facet normal 0 -0 1
outer loop
vertex 47.5 -41.5 15.5
vertex 47.5 41.5 15.5
vertex 31.5 -41.5 15.5
endloop
endfacet
facet normal -1 0 0
outer loop
vertex 47.5 -65.5 17
vertex 47.5 -58 83
vertex 47.5 -56 70.5
endloop
endfacet
facet normal -1 0 0
outer loop
vertex 47.5 -65.5 17
vertex 47.5 -67 21
vertex 47.5 -67 147
endloop
endfacet
facet normal -1 -0 0
outer loop
vertex 47.5 -55 65.5
vertex 47.5 -55 63.5
vertex 47.5 -55 66
endloop
endfacet
facet normal -1 0 0
outer loop
vertex 47.5 -55.5 68
vertex 47.5 -55 66
vertex 47.5 -55 63.5
endloop
endfacet
facet normal 0 1 -0
outer loop
vertex 47.5 -67 21
vertex 31.5 -67 21
vertex 47.5 -67 147
endloop
endfacet
facet normal -1 0 -0
outer loop
vertex 47.5 -55 65.5
vertex 47.5 -47 50
vertex 47.5 -52.5 37.5
endloop
endfacet
facet normal -1 0 -0
outer loop
vertex 47.5 -57 85
vertex 47.5 -56.5 83
vertex 47.5 -58 83
endloop
endfacet
facet normal -1 0 0
outer loop
vertex 47.5 -40 43
vertex 47.5 -41 44
vertex 47.5 -15 67.5
endloop
endfacet
facet normal -1 0 0
outer loop
vertex 47.5 -41 44
vertex 47.5 -16.5 69
vertex 47.5 -15 67.5
endloop
endfacet
facet normal -1 0 0
outer loop
vertex 47.5 -1 26
vertex 47.5 -1 61
vertex 47.5 1 61
endloop
endfacet
facet normal -1 0 -0
outer loop
vertex 47.5 -15 67.5
vertex 47.5 8.5 64.5
vertex 47.5 -11.5 64
endloop
endfacet
facet normal -1 0 0
outer loop
vertex 47.5 1 61
vertex 47.5 -1 61
vertex 47.5 -11.5 64
endloop
endfacet
facet normal -1 0 0
outer loop
vertex 47.5 1 61
vertex 47.5 -11.5 64
vertex 47.5 8.5 64.5
endloop
endfacet
facet normal -1 0 0
outer loop
vertex 47.5 -51 83
vertex 47.5 -23 85
vertex 47.5 -23 83
endloop
endfacet
facet normal -1 -0 -0
outer loop
vertex 47.5 -20 72.5
vertex 47.5 8.5 64.5
vertex 47.5 -16.5 69
endloop
endfacet
facet normal -1 -0 -0
outer loop
vertex 47.5 -23 83
vertex 47.5 8.5 64.5
vertex 47.5 -20 72.5
endloop
endfacet
facet normal -1 0 0
outer loop
vertex 47.5 -15 67.5
vertex 47.5 -16.5 69
vertex 47.5 8.5 64.5
endloop
endfacet
facet normal -1 0 0
outer loop
vertex 47.5 -23 83
vertex 47.5 -23 85
vertex 47.5 8.5 64.5
endloop
endfacet
facet normal -1 0 0
outer loop
vertex 47.5 8.5 64.5
vertex 47.5 -23 85
vertex 47.5 -20 95.5
endloop
endfacet
facet normal 0.7 0.3 0.7
outer loop
vertex 31.5 -65.5 17
vertex 31.5 -61.5 15.5
vertex 23 -60.5 23.5
endloop
endfacet
facet normal 0.7 0.7 0.3
outer loop
vertex 31.5 -65.5 17
vertex 23 -60.5 23.5
vertex 31.5 -67 21
endloop
endfacet
facet normal 0.7 -0 0.7
outer loop
vertex 31.5 -61.5 15.5
vertex 31.5 -52.5 15.5
vertex 23 -60.5 23.5
endloop
endfacet
facet normal 0.7 0 0.7
outer loop
vertex 31.5 -52.5 15.5
vertex 24.5 -52.5 22
vertex 23 -60.5 23.5
endloop
endfacet
facet normal 0.7 -0 0.7
outer loop
vertex 24.5 -52.5 22
vertex 24 -52 22.5
vertex 23 -60.5 23.5
endloop
endfacet
facet normal 0.7 0 0.7
outer loop
vertex 24 -52 22.5
vertex 23.5 -51.5 23
vertex 23 -60.5 23.5
endloop
endfacet
facet normal 0.7 -0 0.7
outer loop
vertex 31.5 -41.5 15.5
vertex 31.5 41.5 15.5
vertex 24.5 -41.5 22
endloop
endfacet
facet normal 0.7 -0 0.7
outer loop
vertex 24.5 -41.5 22
vertex 24.5 41.5 22
vertex 24 -42 22.5
endloop
endfacet
facet normal 0.7 0 0.7
outer loop
vertex 23.5 -51.5 23
vertex 23 60.5 23.5
vertex 23 -60.5 23.5
endloop
endfacet
facet normal 0.7 -0 0.7
outer loop
vertex 23.5 -51.5 23
vertex 23.5 -42.5 23
vertex 23 60.5 23.5
endloop
endfacet
facet normal 0.7 -0 0.7
outer loop
vertex 24 -42 22.5
vertex 23 60.5 23.5
vertex 23.5 -42.5 23
endloop
endfacet
facet normal 0.6 0.8 0
outer loop
vertex 31.5 -67 21
vertex 23 -60.5 23.5
vertex 31.5 -67 147
endloop
endfacet
facet normal -1 0 0
outer loop
vertex 47.5 -41.5 15.5
vertex 47.5 41.5 22
vertex 47.5 41.5 15.5
endloop
endfacet
facet normal -1 0 -0
outer loop
vertex 47.5 -41.5 22
vertex 47.5 42 22.5
vertex 47.5 41.5 22
endloop
endfacet
facet normal -1 0 0
outer loop
vertex 47.5 42 22.5
vertex 47.5 -1 26
vertex 47.5 1 26
endloop
endfacet
facet normal -1 0 0
outer loop
vertex 47.5 42 22.5
vertex 47.5 1 26
vertex 47.5 18 29
endloop
endfacet
facet normal -1 0 0
outer loop
vertex 47.5 42 22.5
vertex 47.5 18 29
vertex 47.5 40.5 24.5
endloop
endfacet
facet normal -1 0 0
outer loop
vertex 47.5 18 29
vertex 47.5 37 29
vertex 47.5 40.5 24.5
endloop
endfacet
facet normal -1 0 0
outer loop
vertex 47.5 -1 26
vertex 47.5 1 61
vertex 47.5 1 26
endloop
endfacet
facet normal -1 0 -0
outer loop
vertex 47.5 34 37
vertex 47.5 37 29
vertex 47.5 18 29
endloop
endfacet
facet normal 0 -0 1
outer loop
vertex 31.5 -41.5 15.5
vertex 47.5 41.5 15.5
vertex 31.5 41.5 15.5
endloop
endfacet
facet normal -1 0 0
outer loop
vertex 47.5 42 22.5
vertex 47.5 40.5 24.5
vertex 47.5 42.5 23
endloop
endfacet
facet normal -1 0 0
outer loop
vertex 47.5 42.5 23
vertex 47.5 40.5 24.5
vertex 47.5 60.5 23.5
endloop
endfacet
facet normal -1 0 -0
outer loop
vertex 47.5 42.5 23
vertex 47.5 60.5 23.5
vertex 47.5 51.5 23
endloop
endfacet
facet normal -1 0 0
outer loop
vertex 47.5 51 29
vertex 47.5 50 30
vertex 47.5 52.5 29
endloop
endfacet
facet normal -1 0 0
outer loop
vertex 47.5 51 29
vertex 47.5 50 30
vertex 47.5 50 30
endloop
endfacet
facet normal -1 0 0
outer loop
vertex 47.5 52.5 15.5
vertex 47.5 52.5 22
vertex 47.5 61.5 15.5
endloop
endfacet
facet normal -1 0 0
outer loop
vertex 47.5 61.5 15.5
vertex 47.5 52.5 22
vertex 47.5 52 22.5
endloop
endfacet
facet normal -1 0 0
outer loop
vertex 47.5 61.5 15.5
vertex 47.5 52 22.5
vertex 47.5 60.5 23.5
endloop
endfacet
facet normal -1 0 -0
outer loop
vertex 47.5 61.5 15.5
vertex 47.5 67 21
vertex 47.5 65.5 17
endloop
endfacet
facet normal -1 0 -0
outer loop
vertex 47.5 51.5 23
vertex 47.5 60.5 23.5
vertex 47.5 52 22.5
endloop
endfacet
facet normal -1 0 0
outer loop
vertex 47.5 61.5 15.5
vertex 47.5 60.5 23.5
vertex 47.5 60 35
endloop
endfacet
facet normal -1 0 0
outer loop
vertex 47.5 51 29
vertex 47.5 52.5 29
vertex 47.5 60 23.5
endloop
endfacet
facet normal -1 0 0
outer loop
vertex 47.5 52.5 29
vertex 47.5 55 30
vertex 47.5 60 23.5
endloop
endfacet
facet normal -1 -0 -0
outer loop
vertex 47.5 55 33
vertex 47.5 60 23.5
vertex 47.5 55 30
endloop
endfacet
facet normal -1 0 0
outer loop
vertex 47.5 61.5 15.5
vertex 47.5 60 35
vertex 47.5 59.5 41
endloop
endfacet
facet normal 0 -0 1
outer loop
vertex 47.5 52.5 15.5
vertex 47.5 61.5 15.5
vertex 31.5 52.5 15.5
endloop
endfacet
facet normal 0 -0.4 0.9
outer loop
vertex 47.5 61.5 15.5
vertex 47.5 65.5 17
vertex 31.5 65.5 17
endloop
endfacet
facet normal 0 -0.9 0.4
outer loop
vertex 47.5 65.5 17
vertex 47.5 67 21
vertex 31.5 65.5 17
endloop
endfacet
facet normal -1 0 0
outer loop
vertex 47.5 37 29
vertex 47.5 34 37
vertex 47.5 38 29
endloop
endfacet
facet normal -1 0 0
outer loop
vertex 47.5 38 29
vertex 47.5 34 37
vertex 47.5 42.5 33.5
endloop
endfacet
facet normal -1 -0 -0
outer loop
vertex 47.5 37 40
vertex 47.5 42.5 33.5
vertex 47.5 34 37
endloop
endfacet
facet normal -1 -0 -0
outer loop
vertex 47.5 40 43
vertex 47.5 50 33
vertex 47.5 40 42.5
endloop
endfacet
facet normal -1 -0 0
outer loop
vertex 47.5 50 30
vertex 47.5 50 30
vertex 47.5 50 33
endloop
endfacet
facet normal -1 0 0
outer loop
vertex 47.5 50 30
vertex 47.5 40 42.5
vertex 47.5 50 33
endloop
endfacet
facet normal -1 0 0
outer loop
vertex 47.5 50 33
vertex 47.5 41 44
vertex 47.5 52.5 34
endloop
endfacet
facet normal -1 0 -0
outer loop
vertex 47.5 38.5 44.5
vertex 47.5 41 44
vertex 47.5 40 43
endloop
endfacet
facet normal -1 -0 -0
outer loop
vertex 47.5 29.5 55.5
vertex 47.5 41 44
vertex 47.5 38.5 44.5
endloop
endfacet
facet normal -1 0 0
outer loop
vertex 47.5 40 43
vertex 47.5 41 44
vertex 47.5 50 33
endloop
endfacet
facet normal -1 0 0
outer loop
vertex 47.5 52.5 34
vertex 47.5 41 44
vertex 47.5 47 50
endloop
endfacet
facet normal -1 0 0
outer loop
vertex 47.5 55 33
vertex 47.5 54 64
vertex 47.5 60 23.5
endloop
endfacet
facet normal -1 0 0
outer loop
vertex 47.5 52.5 34
vertex 47.5 54 64
vertex 47.5 55 33
endloop
endfacet
facet normal -1 -0 -0
outer loop
vertex 47.5 60 35
vertex 47.5 60.5 23.5
vertex 47.5 54.5 64.5
endloop
endfacet
facet normal -1 0 0
outer loop
vertex 47.5 61.5 15.5
vertex 47.5 59.5 41
vertex 47.5 58 85
endloop
endfacet
facet normal -0 -1 0
outer loop
vertex 47.5 67 21
vertex 41.5 67 39
vertex 40 67 36.5
endloop
endfacet
facet normal -0 -1 0
outer loop
vertex 47.5 67 21
vertex 40 67 36.5
vertex 37.5 67 35
endloop
endfacet
facet normal 0 -1 0
outer loop
vertex 47.5 67 21
vertex 37.5 67 35
vertex 32 67 35
endloop
endfacet
facet normal 0 0 1
outer loop
vertex 47.5 61.5 15.5
vertex 31.5 61.5 15.5
vertex 31.5 52.5 15.5
endloop
endfacet
facet normal 0 -0.4 0.9
outer loop
vertex 47.5 61.5 15.5
vertex 31.5 65.5 17
vertex 31.5 61.5 15.5
endloop
endfacet
facet normal 0 -0.9 0.4
outer loop
vertex 47.5 67 21
vertex 31.5 67 21
vertex 31.5 65.5 17
endloop
endfacet
facet normal -0 -1 0
outer loop
vertex 47.5 67 21
vertex 32 67 35
vertex 31.5 67 21
endloop
endfacet
facet normal -1 -0 0
outer loop
vertex 47.5 9.5 63.5
vertex 47.5 1 61
vertex 47.5 8.5 64.5
endloop
endfacet
facet normal -1 0 -0
outer loop
vertex 47.5 10 63.5
vertex 47.5 13.5 67
vertex 47.5 11.5 64
endloop
endfacet
facet normal -1 0 -0
outer loop
vertex 47.5 13.5 67
vertex 47.5 15 67.5
vertex 47.5 11.5 64
endloop
endfacet
facet normal -1 -0 -0
outer loop
vertex 47.5 28 57
vertex 47.5 32 52
vertex 47.5 16.5 69
endloop
endfacet
facet normal -1 0 0
outer loop
vertex 47.5 11.5 64
vertex 47.5 15 67.5
vertex 47.5 15 67.5
endloop
endfacet
facet normal -1 0 0
outer loop
vertex 47.5 19.5 63.5
vertex 47.5 15 67.5
vertex 47.5 10 73
endloop
endfacet
facet normal -1 0 0
outer loop
vertex 47.5 15 67.5
vertex 47.5 10 73
vertex 47.5 15 67.5
endloop
endfacet
facet normal -1 0 0
outer loop
vertex 47.5 16.5 69
vertex 47.5 16 72
vertex 47.5 17 70.5
endloop
endfacet
facet normal -1 0 0
outer loop
vertex 47.5 5.5 79.5
vertex 47.5 16 72
vertex 47.5 16.5 69
endloop
endfacet
facet normal -1 -0 0
outer loop
vertex 47.5 20 72.5
vertex 47.5 17.5 71
vertex 47.5 -6 100.5
endloop
endfacet
facet normal -1 0 0
outer loop
vertex 47.5 5.5 79.5
vertex 47.5 16.5 69
vertex 47.5 32 52
endloop
endfacet
facet normal -1 0 -0
outer loop
vertex 47.5 17 70.5
vertex 47.5 20 72.5
vertex 47.5 16.5 69
endloop
endfacet
facet normal -1 0 0
outer loop
vertex 47.5 17 70.5
vertex 47.5 17.5 71
vertex 47.5 20 72.5
endloop
endfacet
facet normal -1 -0 0
outer loop
vertex 47.5 54 64
vertex 47.5 52.5 34
vertex 47.5 47 50
endloop
endfacet
facet normal -1 0 0
outer loop
vertex 47.5 54.5 64.5
vertex 47.5 55 66
vertex 47.5 60 35
endloop
endfacet
facet normal -1 -0 -0
outer loop
vertex 47.5 57 76.5
vertex 47.5 60 35
vertex 47.5 55 66
endloop
endfacet
facet normal -1 0 0
outer loop
vertex 47.5 61.5 15.5
vertex 47.5 65.5 151
vertex 47.5 67 21
endloop
endfacet
facet normal -1 -0 -0
outer loop
vertex 47.5 51 85
vertex 47.5 51 83
vertex 47.5 23 83
endloop
endfacet
facet normal -1 0 0
outer loop
vertex 47.5 57 78.5
vertex 47.5 58 83
vertex 47.5 59.5 41
endloop
endfacet
facet normal -1 0 0
outer loop
vertex 47.5 59.5 41
vertex 47.5 58 83
vertex 47.5 58 85
endloop
endfacet
facet normal -1 0 0
outer loop
vertex 47.5 57 83
vertex 47.5 58 85
vertex 47.5 58 83
endloop
endfacet
facet normal -1 0 0
outer loop
vertex 47.5 61.5 15.5
vertex 47.5 58 85
vertex 47.5 65.5 151
endloop
endfacet
facet normal -0 -1 0
outer loop
vertex 47.5 67 21
vertex 47.5 67 147
vertex 41.5 67 39
endloop
endfacet
facet normal 0 -1 -0
outer loop
vertex 47.5 67 147
vertex 40 67 41.5
vertex 41.5 67 39
endloop
endfacet
facet normal 0 -1 -0
outer loop
vertex 47.5 67 147
vertex 37.5 67 43
vertex 40 67 41.5
endloop
endfacet
facet normal 0 -1 0
outer loop
vertex 31.5 67 147
vertex 32 67 43
vertex 37.5 67 43
endloop
endfacet
facet normal 0.7 0 0.7
outer loop
vertex 24.5 -41.5 22
vertex 31.5 41.5 15.5
vertex 24.5 41.5 22
endloop
endfacet
facet normal 0.7 0 0.7
outer loop
vertex 24 -42 22.5
vertex 24.5 41.5 22
vertex 24 42 22.5
endloop
endfacet
facet normal 0.7 -0 0.7
outer loop
vertex 24 -42 22.5
vertex 24 42 22.5
vertex 23.5 42.5 23
endloop
endfacet
facet normal 0.7 0 0.7
outer loop
vertex 24 -42 22.5
vertex 23.5 42.5 23
vertex 23 60.5 23.5
endloop
endfacet
facet normal 0.7 -0 0.7
outer loop
vertex 31.5 52.5 15.5
vertex 31.5 61.5 15.5
vertex 24.5 52.5 22
endloop
endfacet
facet normal 0 -1 0
outer loop
vertex 31.5 67 21
vertex 32 67 35
vertex 31.5 67 35.5
endloop
endfacet
facet normal 0.7 -0 0.7
outer loop
vertex 31.5 61.5 15.5
vertex 23 60.5 23.5
vertex 24.5 52.5 22
endloop
endfacet
facet normal 0.7 -0.3 0.7
outer loop
vertex 31.5 61.5 15.5
vertex 31.5 65.5 17
vertex 23 60.5 23.5
endloop
endfacet
facet normal 0.7 -0.7 0.3
outer loop
vertex 31.5 65.5 17
vertex 31.5 67 21
vertex 23 60.5 23.5
endloop
endfacet
facet normal 0.6 -0.8 -0
outer loop
vertex 31.5 67 21
vertex 29.5 65.5 36.5
vertex 23 60.5 23.5
endloop
endfacet
facet normal 0.6 -0.8 0
outer loop
vertex 31.5 67 21
vertex 31.5 67 35.5
vertex 29.5 65.5 36.5
endloop
endfacet
facet normal 0.6 -0.8 0
outer loop
vertex 29.5 65.5 36.5
vertex 28.5 64.5 39
vertex 23 60.5 23.5
endloop
endfacet
facet normal 0.7 -0 0.7
outer loop
vertex 23.5 42.5 23
vertex 23.5 51.5 23
vertex 23 60.5 23.5
endloop
endfacet
facet normal 0.7 0 0.7
outer loop
vertex 24.5 52.5 22
vertex 23 60.5 23.5
vertex 24 52 22.5
endloop
endfacet
facet normal 0.7 -0 0.7
outer loop
vertex 23.5 51.5 23
vertex 24 52 22.5
vertex 23 60.5 23.5
endloop
endfacet
facet normal 0 -1 0
outer loop
vertex 31.5 67 147
vertex 31.5 67 42.5
vertex 32 67 43
endloop
endfacet
facet normal 0.6 -0.8 0
outer loop
vertex 28.5 64.5 39
vertex 29.5 65.5 41.5
vertex 23 60.5 144.5
endloop
endfacet
facet normal 0.6 -0.8 0
outer loop
vertex 28.5 64.5 39
vertex 23 60.5 144.5
vertex 23 60.5 23.5
endloop
endfacet
facet normal 0.6 -0.8 -0
outer loop
vertex 31.5 67 42.5
vertex 23 60.5 144.5
vertex 29.5 65.5 41.5
endloop
endfacet
facet normal -1 0 0
outer loop
vertex 47.5 -65.5 17
vertex 47.5 -61.5 152.5
vertex 47.5 -58 83
endloop
endfacet
facet normal -1 -0 0
outer loop
vertex 47.5 -57 85
vertex 47.5 -58 83
vertex 47.5 -58 85
endloop
endfacet
facet normal -1 0 0
outer loop
vertex 47.5 -51 83
vertex 47.5 -51 85
vertex 47.5 -23 85
endloop
endfacet
facet normal -1 0 0
outer loop
vertex 47.5 -65.5 17
vertex 47.5 -67 147
vertex 47.5 -61.5 152.5
endloop
endfacet
facet normal -1 0 0
outer loop
vertex 47.5 -58 83
vertex 47.5 -60.5 138
vertex 47.5 -58 85
endloop
endfacet
facet normal -1 -0 0
outer loop
vertex 47.5 -57 89.5
vertex 47.5 -58 85
vertex 47.5 -60.5 138
endloop
endfacet
facet normal -1 0 0
outer loop
vertex 47.5 -57 91.5
vertex 47.5 -60.5 139.5
vertex 47.5 -55 102
endloop
endfacet
facet normal -1 -0 0
outer loop
vertex 47.5 -54.5 103.5
vertex 47.5 -55 102
vertex 47.5 -60.5 139.5
endloop
endfacet
facet normal 0 1 0
outer loop
vertex 31.5 -67 21
vertex 31.5 -67 147
vertex 47.5 -67 147
endloop
endfacet
facet normal -1 -0 -0
outer loop
vertex 47.5 -18 97.5
vertex 47.5 8.5 64.5
vertex 47.5 -20 95.5
endloop
endfacet
facet normal -1 0 0
outer loop
vertex 47.5 -17.5 98
vertex 47.5 -16.5 99
vertex 47.5 -5.5 88.5
endloop
endfacet
facet normal -1 -0 -0
outer loop
vertex 47.5 -17.5 98
vertex 47.5 -5.5 88.5
vertex 47.5 -13.5 92.5
endloop
endfacet
facet normal -1 -0 -0
outer loop
vertex 47.5 -28 111
vertex 47.5 -5.5 88.5
vertex 47.5 -16.5 99
endloop
endfacet
facet normal -1 0 0
outer loop
vertex 47.5 -19.5 104.5
vertex 47.5 -15 100.5
vertex 47.5 -8 92.5
endloop
endfacet
facet normal -1 -0 0
outer loop
vertex 47.5 -11.5 104
vertex 47.5 -14.5 100.5
vertex 47.5 -15 100.5
endloop
endfacet
facet normal -1 0 0
outer loop
vertex 47.5 -8 92.5
vertex 47.5 -15 100.5
vertex 47.5 -14.5 100.5
endloop
endfacet
facet normal -1 0 -0
outer loop
vertex 47.5 -14.5 100.5
vertex 47.5 -11.5 104
vertex 47.5 -12.5 100.5
endloop
endfacet
facet normal -1 -0 -0
outer loop
vertex 47.5 -19.5 104.5
vertex 47.5 -15 100.5
vertex 47.5 -19.5 104.5
endloop
endfacet
facet normal -1 0 0
outer loop
vertex 47.5 -12.5 100.5
vertex 47.5 -11.5 104
vertex 47.5 -9.5 103.5
endloop
endfacet
facet normal -1 -0 -0
outer loop
vertex 47.5 -10 104.5
vertex 47.5 -9.5 103.5
vertex 47.5 -11.5 104
endloop
endfacet
facet normal -1 0 -0
outer loop
vertex 47.5 -9.5 104.5
vertex 47.5 -1 107
vertex 47.5 -6 100.5
endloop
endfacet
facet normal -1 0 0
outer loop
vertex 47.5 -54 104
vertex 47.5 -60 144.5
vertex 47.5 -47 118
endloop
endfacet
facet normal -1 0 0
outer loop
vertex 47.5 -61.5 152.5
vertex 47.5 -60.5 138
vertex 47.5 -58 83
endloop
endfacet
facet normal -1 0 0
outer loop
vertex 47.5 -60.5 139.5
vertex 47.5 -60.5 144.5
vertex 47.5 -54.5 103.5
endloop
endfacet
facet normal -1 0 0
outer loop
vertex 47.5 -47 118
vertex 47.5 -60 144.5
vertex 47.5 -55 135
endloop
endfacet
facet normal -1 0 -0
outer loop
vertex 47.5 -47 134.5
vertex 47.5 -41 124
vertex 47.5 -47 118
endloop
endfacet
facet normal -1 -0 -0
outer loop
vertex 47.5 -38.5 123.5
vertex 47.5 -29.5 112.5
vertex 47.5 -41 124
endloop
endfacet
facet normal -1 0 0
outer loop
vertex 47.5 -38.5 123.5
vertex 47.5 -41 124
vertex 47.5 -40 125
endloop
endfacet
facet normal -1 0 -0
outer loop
vertex 47.5 -47 134.5
vertex 47.5 -40 125
vertex 47.5 -41 124
endloop
endfacet
facet normal -1 0 0
outer loop
vertex 47.5 -47 118
vertex 47.5 -55 135
vertex 47.5 -52.5 134
endloop
endfacet
facet normal -1 0 0
outer loop
vertex 47.5 -47 118
vertex 47.5 -52.5 134
vertex 47.5 -50 135
endloop
endfacet
facet normal -1 -0 -0
outer loop
vertex 47.5 -47 134.5
vertex 47.5 -47 118
vertex 47.5 -50 135
endloop
endfacet
facet normal -1 0 0
outer loop
vertex 47.5 -50 135
vertex 47.5 -50 138
vertex 47.5 -49.5 138
endloop
endfacet
facet normal -1 0 0
outer loop
vertex 47.5 -50 135
vertex 47.5 -49.5 138
vertex 47.5 -47 134.5
endloop
endfacet
facet normal -1 0 0
outer loop
vertex 47.5 -40 125
vertex 47.5 -47 134.5
vertex 47.5 -41 132.5
endloop
endfacet
facet normal -1 0 0
outer loop
vertex 47.5 -40 125
vertex 47.5 -41 132.5
vertex 47.5 -34 131
endloop
endfacet
facet normal -1 -0 0
outer loop
vertex 47.5 -37 138.5
vertex 47.5 -41 132.5
vertex 47.5 -42.5 134.5
endloop
endfacet
facet normal -1 -0 -0
outer loop
vertex 47.5 -37 138.5
vertex 47.5 -34 131
vertex 47.5 -41 132.5
endloop
endfacet
facet normal -1 0 0
outer loop
vertex 47.5 -37 138.5
vertex 47.5 -36.5 138.5
vertex 47.5 -34 131
endloop
endfacet
facet normal -1 0 0
outer loop
vertex 47.5 -61.5 152.5
vertex 47.5 -60.5 139.5
vertex 47.5 -60.5 138
endloop
endfacet
facet normal -1 0 0
outer loop
vertex 47.5 -60 144.5
vertex 47.5 -55 138
vertex 47.5 -55 135
endloop
endfacet
facet normal -1 0 0
outer loop
vertex 47.5 -55 138
vertex 47.5 -60 144.5
vertex 47.5 -52.5 139
endloop
endfacet
facet normal -1 0 0
outer loop
vertex 47.5 -52.5 139
vertex 47.5 -60 144.5
vertex 47.5 -51 139
endloop
endfacet
facet normal -1 0 -0
outer loop
vertex 47.5 -61.5 152.5
vertex 47.5 -60.5 144.5
vertex 47.5 -60.5 139.5
endloop
endfacet
facet normal -1 0 -0
outer loop
vertex 47.5 -52 145.5
vertex 47.5 -51.5 145
vertex 47.5 -60.5 144.5
endloop
endfacet
facet normal -1 0 0
outer loop
vertex 47.5 -67 147
vertex 47.5 -65.5 151
vertex 47.5 -61.5 152.5
endloop
endfacet
facet normal -1 -0 0
outer loop
vertex 47.5 -52 145.5
vertex 47.5 -60.5 144.5
vertex 47.5 -61.5 152.5
endloop
endfacet
facet normal -1 0 0
outer loop
vertex 47.5 -52 145.5
vertex 47.5 -61.5 152.5
vertex 47.5 -52.5 146
endloop
endfacet
facet normal -1 0 0
outer loop
vertex 47.5 -52.5 146
vertex 47.5 -61.5 152.5
vertex 47.5 -52.5 152.5
endloop
endfacet
facet normal 0 0.9 -0.4
outer loop
vertex 47.5 -67 147
vertex 31.5 -67 147
vertex 47.5 -65.5 151
endloop
endfacet
facet normal 0 0.4 -0.9
outer loop
vertex 47.5 -65.5 151
vertex 31.5 -61.5 152.5
vertex 47.5 -61.5 152.5
endloop
endfacet
facet normal 0 0 -1
outer loop
vertex 47.5 -61.5 152.5
vertex 31.5 -52.5 152.5
vertex 47.5 -52.5 152.5
endloop
endfacet
facet normal -1 0 0
outer loop
vertex 47.5 -50 138
vertex 47.5 -51 139
vertex 47.5 -49.5 138
endloop
endfacet
facet normal -1 0 0
outer loop
vertex 47.5 -52.5 139
vertex 47.5 -51 139
vertex 47.5 -50 138
endloop
endfacet
facet normal -1 0 -0
outer loop
vertex 47.5 -51.5 145
vertex 47.5 -42.5 145
vertex 47.5 -60.5 144.5
endloop
endfacet
facet normal -1 -0 -0
outer loop
vertex 47.5 -42.5 145
vertex 47.5 -41 144.5
vertex 47.5 -60.5 144.5
endloop
endfacet
facet normal -1 0 0
outer loop
vertex 47.5 -42.5 145
vertex 47.5 -42 145.5
vertex 47.5 -41 144.5
endloop
endfacet
facet normal 0 0.9 -0.4
outer loop
vertex 47.5 -65.5 151
vertex 31.5 -67 147
vertex 31.5 -65.5 151
endloop
endfacet
facet normal 0 0.4 -0.9
outer loop
vertex 47.5 -65.5 151
vertex 31.5 -65.5 151
vertex 31.5 -61.5 152.5
endloop
endfacet
facet normal 0 0 -1
outer loop
vertex 47.5 -61.5 152.5
vertex 31.5 -61.5 152.5
vertex 31.5 -52.5 152.5
endloop
endfacet
facet normal -1 0 0
outer loop
vertex 47.5 -34 131
vertex 47.5 -36.5 138.5
vertex 47.5 -18 139
endloop
endfacet
facet normal -1 0 0
outer loop
vertex 47.5 -1 107
vertex 47.5 -1 142
vertex 47.5 1 142
endloop
endfacet
facet normal -1 0 0
outer loop
vertex 47.5 -36.5 138.5
vertex 47.5 -41 144.5
vertex 47.5 -18 139
endloop
endfacet
facet normal -1 -0 -0
outer loop
vertex 47.5 -42 145.5
vertex 47.5 -18 139
vertex 47.5 -41 144.5
endloop
endfacet
facet normal -1 0 -0
outer loop
vertex 47.5 -42 145.5
vertex 47.5 -1 142
vertex 47.5 -18 139
endloop
endfacet
facet normal -1 0 0
outer loop
vertex 47.5 -42 145.5
vertex 47.5 -41.5 146
vertex 47.5 41.5 146
endloop
endfacet
facet normal -1 0 -0
outer loop
vertex 47.5 -42 145.5
vertex 47.5 42 145.5
vertex 47.5 -1 142
endloop
endfacet
facet normal -1 0 0
outer loop
vertex 47.5 -41.5 146
vertex 47.5 -41.5 152.5
vertex 47.5 41.5 152.5
endloop
endfacet
facet normal 0 0 -1
outer loop
vertex 47.5 -41.5 152.5
vertex 31.5 -41.5 152.5
vertex 31.5 41.5 152.5
endloop
endfacet
facet normal 0.6 0.8 -0
outer loop
vertex 31.5 -67 147
vertex 23 -60.5 23.5
vertex 23 -60.5 144.5
endloop
endfacet
facet normal 0.7 0 -0.7
outer loop
vertex 31.5 -61.5 152.5
vertex 24.5 -52.5 146
vertex 31.5 -52.5 152.5
endloop
endfacet
facet normal 0.7 0.7 -0.3
outer loop
vertex 31.5 -67 147
vertex 23 -60.5 144.5
vertex 31.5 -65.5 151
endloop
endfacet
facet normal 0.7 0.3 -0.7
outer loop
vertex 31.5 -65.5 151
vertex 23 -60.5 144.5
vertex 31.5 -61.5 152.5
endloop
endfacet
facet normal 0.7 0 -0.7
outer loop
vertex 31.5 -61.5 152.5
vertex 23 -60.5 144.5
vertex 24.5 -52.5 146
endloop
endfacet
facet normal 0.7 0 -0.7
outer loop
vertex 24 -52 145.5
vertex 23 -60.5 144.5
vertex 23.5 -51.5 145
endloop
endfacet
facet normal 0.7 -0 -0.7
outer loop
vertex 24.5 -52.5 146
vertex 23 -60.5 144.5
vertex 24 -52 145.5
endloop
endfacet
facet normal 0.7 0 -0.7
outer loop
vertex 23.5 -51.5 145
vertex 23 -60.5 144.5
vertex 23.5 -42.5 145
endloop
endfacet
facet normal 0.7 0 -0.7
outer loop
vertex 31.5 -41.5 152.5
vertex 24.5 -41.5 146
vertex 24.5 41.5 146
endloop
endfacet
facet normal 0.7 -0 -0.7
outer loop
vertex 23.5 -42.5 145
vertex 23 -60.5 144.5
vertex 24 42 145.5
endloop
endfacet
facet normal 0.7 0 -0.7
outer loop
vertex 24.5 -41.5 146
vertex 24 -42 145.5
vertex 24 42 145.5
endloop
endfacet
facet normal 0.7 0 -0.7
outer loop
vertex 24 -42 145.5
vertex 23.5 -42.5 145
vertex 24 42 145.5
endloop
endfacet
facet normal -1 0 0
outer loop
vertex 47.5 20 72.5
vertex 47.5 -6 100.5
vertex 47.5 23 83
endloop
endfacet
facet normal -1 0 0
outer loop
vertex 47.5 23 83
vertex 47.5 -1 107
vertex 47.5 23 85
endloop
endfacet
facet normal -1 0 0
outer loop
vertex 47.5 23 83
vertex 47.5 -6 100.5
vertex 47.5 -1 107
endloop
endfacet
facet normal -1 0 0
outer loop
vertex 47.5 -1 107
vertex 47.5 16.5 99
vertex 47.5 23 85
endloop
endfacet
facet normal -1 -0 0
outer loop
vertex 47.5 51 85
vertex 47.5 23 83
vertex 47.5 23 85
endloop
endfacet
facet normal -1 -0 -0
outer loop
vertex 47.5 20 95.5
vertex 47.5 23 85
vertex 47.5 16.5 99
endloop
endfacet
facet normal -1 -0 -0
outer loop
vertex 47.5 1 107
vertex 47.5 11.5 104
vertex 47.5 -1 107
endloop
endfacet
facet normal -1 0 0
outer loop
vertex 47.5 -1 107
vertex 47.5 11.5 104
vertex 47.5 15 100.5
endloop
endfacet
facet normal -1 0 0
outer loop
vertex 47.5 -1 107
vertex 47.5 15 100.5
vertex 47.5 16.5 99
endloop
endfacet
facet normal -1 0 0
outer loop
vertex 47.5 1 107
vertex 47.5 -1 107
vertex 47.5 1 142
endloop
endfacet
facet normal -1 0 0
outer loop
vertex 47.5 16.5 99
vertex 47.5 15 100.5
vertex 47.5 41 124
endloop
endfacet
facet normal -1 0 0
outer loop
vertex 47.5 15 100.5
vertex 47.5 40 125
vertex 47.5 41 124
endloop
endfacet
facet normal -1 0 0
outer loop
vertex 47.5 57 83
vertex 47.5 56.5 85
vertex 47.5 58 85
endloop
endfacet
facet normal -1 0 0
outer loop
vertex 47.5 55.5 100
vertex 47.5 55 102
vertex 47.5 55.5 102.5
endloop
endfacet
facet normal -1 0 0
outer loop
vertex 47.5 47 118
vertex 47.5 52.5 133.5
vertex 47.5 55.5 102.5
endloop
endfacet
facet normal -1 0 -0
outer loop
vertex 47.5 47 118
vertex 47.5 55.5 102.5
vertex 47.5 55 102
endloop
endfacet
facet normal -1 0 0
outer loop
vertex 47.5 67 21
vertex 47.5 65.5 151
vertex 47.5 67 147
endloop
endfacet
facet normal -1 -0 0
outer loop
vertex 47.5 65.5 151
vertex 47.5 58 85
vertex 47.5 56 97.5
endloop
endfacet
facet normal -0 -1 -0
outer loop
vertex 47.5 67 147
vertex 31.5 67 147
vertex 37.5 67 43
endloop
endfacet
facet normal -1 -0 0
outer loop
vertex 47.5 42 145.5
vertex 47.5 1 142
vertex 47.5 -1 142
endloop
endfacet
facet normal -1 0 0
outer loop
vertex 47.5 -42 145.5
vertex 47.5 41.5 146
vertex 47.5 42 145.5
endloop
endfacet
facet normal -1 0 0
outer loop
vertex 47.5 -41.5 146
vertex 47.5 41.5 152.5
vertex 47.5 41.5 146
endloop
endfacet
facet normal 0 0 -1
outer loop
vertex 47.5 -41.5 152.5
vertex 31.5 41.5 152.5
vertex 47.5 41.5 152.5
endloop
endfacet
facet normal -1 -0 0
outer loop
vertex 47.5 42 145.5
vertex 47.5 18 139
vertex 47.5 1 142
endloop
endfacet
facet normal -1 0 -0
outer loop
vertex 47.5 18 139
vertex 47.5 42 144.5
vertex 47.5 34 131
endloop
endfacet
facet normal -1 0 -0
outer loop
vertex 47.5 42 145.5
vertex 47.5 42 144.5
vertex 47.5 18 139
endloop
endfacet
facet normal -1 -0 0
outer loop
vertex 47.5 44.5 127
vertex 47.5 41 124
vertex 47.5 40 125
endloop
endfacet
facet normal -1 0 -0
outer loop
vertex 47.5 34 131
vertex 47.5 44.5 127
vertex 47.5 40 125
endloop
endfacet
facet normal -1 0 -0
outer loop
vertex 47.5 41 124
vertex 47.5 52.5 133.5
vertex 47.5 47 118
endloop
endfacet
facet normal -1 0 0
outer loop
vertex 47.5 41 124
vertex 47.5 44.5 127
vertex 47.5 52.5 133.5
endloop
endfacet
facet normal -1 0 0
outer loop
vertex 47.5 34 131
vertex 47.5 42 144.5
vertex 47.5 44.5 127
endloop
endfacet
facet normal -1 0 0
outer loop
vertex 47.5 44.5 127
vertex 47.5 45 127.5
vertex 47.5 52.5 133.5
endloop
endfacet
facet normal -1 -0 0
outer loop
vertex 47.5 52.5 134
vertex 47.5 45 128.5
vertex 47.5 44 135
endloop
endfacet
facet normal -1 0 0
outer loop
vertex 47.5 52.5 134
vertex 47.5 44 135
vertex 47.5 50 135
endloop
endfacet
facet normal -1 0 0
outer loop
vertex 47.5 44 135
vertex 47.5 50 138
vertex 47.5 50 135
endloop
endfacet
facet normal -1 0 0
outer loop
vertex 47.5 52.5 133.5
vertex 47.5 52.5 134
vertex 47.5 55.5 102.5
endloop
endfacet
facet normal -1 0 0
outer loop
vertex 47.5 55.5 102.5
vertex 47.5 52.5 134
vertex 47.5 52.5 134
endloop
endfacet
facet normal -1 -0 -0
outer loop
vertex 47.5 53 134
vertex 47.5 55.5 102.5
vertex 47.5 52.5 134
endloop
endfacet
facet normal -1 0 0
outer loop
vertex 47.5 53.5 134.5
vertex 47.5 55 135
vertex 47.5 56 97.5
endloop
endfacet
facet normal -1 -0 0
outer loop
vertex 47.5 65.5 151
vertex 47.5 56 97.5
vertex 47.5 55 135
endloop
endfacet
facet normal -1 -0 0
outer loop
vertex 47.5 42.5 145
vertex 47.5 42 144.5
vertex 47.5 42 145.5
endloop
endfacet
facet normal -1 0 0
outer loop
vertex 47.5 52 139
vertex 47.5 50 138
vertex 47.5 44 135
endloop
endfacet
facet normal -1 0 0
outer loop
vertex 47.5 50 138
vertex 47.5 52 139
vertex 47.5 52.5 139
endloop
endfacet
facet normal -1 0 -0
outer loop
vertex 47.5 42.5 145
vertex 47.5 51.5 145
vertex 47.5 42 144.5
endloop
endfacet
facet normal -1 -0 -0
outer loop
vertex 47.5 51.5 145
vertex 47.5 52.5 144.5
vertex 47.5 42 144.5
endloop
endfacet
facet normal -1 0 0
outer loop
vertex 47.5 51.5 145
vertex 47.5 52 145.5
vertex 47.5 52.5 144.5
endloop
endfacet
facet normal -1 0 -0
outer loop
vertex 47.5 52 139
vertex 47.5 52.5 139
vertex 47.5 52.5 139
endloop
endfacet
facet normal -1 0 0
outer loop
vertex 47.5 52.5 139
vertex 47.5 52.5 139
vertex 47.5 52.5 139
endloop
endfacet
facet normal -1 0 0
outer loop
vertex 47.5 53 139
vertex 47.5 52.5 144.5
vertex 47.5 55 138
endloop
endfacet
facet normal -1 -0 0
outer loop
vertex 47.5 65.5 151
vertex 47.5 55 135
vertex 47.5 55 138
endloop
endfacet
facet normal -1 0 0
outer loop
vertex 47.5 52 145.5
vertex 47.5 52.5 146
vertex 47.5 52.5 144.5
endloop
endfacet
facet normal -1 -0 0
outer loop
vertex 47.5 65.5 151
vertex 47.5 55 138
vertex 47.5 52.5 144.5
endloop
endfacet
facet normal -1 0 0
outer loop
vertex 47.5 52.5 146
vertex 47.5 52.5 152.5
vertex 47.5 61.5 152.5
endloop
endfacet
facet normal -1 0 -0
outer loop
vertex 47.5 52.5 146
vertex 47.5 65.5 151
vertex 47.5 52.5 144.5
endloop
endfacet
facet normal -1 0 0
outer loop
vertex 47.5 52.5 146
vertex 47.5 61.5 152.5
vertex 47.5 65.5 151
endloop
endfacet
facet normal 0 0 -1
outer loop
vertex 47.5 52.5 152.5
vertex 31.5 61.5 152.5
vertex 47.5 61.5 152.5
endloop
endfacet
facet normal -0 -0.9 -0.4
outer loop
vertex 47.5 67 147
vertex 47.5 65.5 151
vertex 31.5 65.5 151
endloop
endfacet
facet normal 0 -0.4 -0.9
outer loop
vertex 47.5 61.5 152.5
vertex 31.5 65.5 151
vertex 47.5 65.5 151
endloop
endfacet
facet normal 0 0 -1
outer loop
vertex 47.5 52.5 152.5
vertex 31.5 52.5 152.5
vertex 31.5 61.5 152.5
endloop
endfacet
facet normal 0 -0.9 -0.4
outer loop
vertex 47.5 67 147
vertex 31.5 65.5 151
vertex 31.5 67 147
endloop
endfacet
facet normal -0 -0.4 -0.9
outer loop
vertex 47.5 61.5 152.5
vertex 31.5 61.5 152.5
vertex 31.5 65.5 151
endloop
endfacet
facet normal 0.6 -0.8 0
outer loop
vertex 31.5 67 147
vertex 23 60.5 144.5
vertex 31.5 67 42.5
endloop
endfacet
facet normal 0.7 0 -0.7
outer loop
vertex 31.5 -41.5 152.5
vertex 24.5 41.5 146
vertex 31.5 41.5 152.5
endloop
endfacet
facet normal 0.7 0 -0.7
outer loop
vertex 24 42 145.5
vertex 23 -60.5 144.5
vertex 23.5 42.5 145
endloop
endfacet
facet normal 0.7 0 -0.7
outer loop
vertex 23.5 42.5 145
vertex 23 -60.5 144.5
vertex 23.5 51.5 145
endloop
endfacet
facet normal 0.7 0 -0.7
outer loop
vertex 24.5 -41.5 146
vertex 24 42 145.5
vertex 24.5 41.5 146
endloop
endfacet
facet normal 0.7 0 -0.7
outer loop
vertex 23.5 51.5 145
vertex 23 -60.5 144.5
vertex 23 60.5 144.5
endloop
endfacet
facet normal 0.7 0 -0.7
outer loop
vertex 31.5 52.5 152.5
vertex 23 60.5 144.5
vertex 31.5 61.5 152.5
endloop
endfacet
facet normal 0.7 -0 -0.7
outer loop
vertex 31.5 52.5 152.5
vertex 24.5 52.5 146
vertex 23 60.5 144.5
endloop
endfacet
facet normal 0.7 -0.7 -0.3
outer loop
vertex 31.5 67 147
vertex 31.5 65.5 151
vertex 23 60.5 144.5
endloop
endfacet
facet normal 0.7 -0.3 -0.7
outer loop
vertex 31.5 61.5 152.5
vertex 23 60.5 144.5
vertex 31.5 65.5 151
endloop
endfacet
facet normal 0.7 -0 -0.7
outer loop
vertex 23.5 51.5 145
vertex 23 60.5 144.5
vertex 24 52 145.5
endloop
endfacet
facet normal 0.7 0 -0.7
outer loop
vertex 24.5 52.5 146
vertex 24 52 145.5
vertex 23 60.5 144.5
endloop
endfacet
facet normal -0 -1 0
outer loop
vertex 47.5 -52.5 15.5
vertex 47.5 -52.5 22
vertex 31.5 -52.5 15.5
endloop
endfacet
facet normal 0 1 -0
outer loop
vertex 47.5 -41.5 15.5
vertex 31.5 -41.5 15.5
vertex 47.5 -41.5 22
endloop
endfacet
facet normal 0 -0.9 0.4
outer loop
vertex 47.5 -52.5 22
vertex 47.5 -52 22.5
vertex 24.5 -52.5 22
endloop
endfacet
facet normal -0 -1 -0
outer loop
vertex 47.5 -52.5 22
vertex 24.5 -52.5 22
vertex 31.5 -52.5 15.5
endloop
endfacet
facet normal 0 -0.4 0.9
outer loop
vertex 47.5 -52 22.5
vertex 47.5 -51.5 23
vertex 24 -52 22.5
endloop
endfacet
facet normal 0 -0 1
outer loop
vertex 47.5 -51.5 23
vertex 47.5 -42.5 23
vertex 23.5 -51.5 23
endloop
endfacet
facet normal -0 0.9 0.4
outer loop
vertex 47.5 -41.5 22
vertex 24 -42 22.5
vertex 47.5 -42 22.5
endloop
endfacet
facet normal -0 0.4 0.9
outer loop
vertex 47.5 -42 22.5
vertex 23.5 -42.5 23
vertex 47.5 -42.5 23
endloop
endfacet
facet normal 0 1 0
outer loop
vertex 47.5 -41.5 22
vertex 31.5 -41.5 15.5
vertex 24.5 -41.5 22
endloop
endfacet
facet normal 0 -0.9 0.4
outer loop
vertex 47.5 -52 22.5
vertex 24 -52 22.5
vertex 24.5 -52.5 22
endloop
endfacet
facet normal 0 -0.4 0.9
outer loop
vertex 47.5 -51.5 23
vertex 23.5 -51.5 23
vertex 24 -52 22.5
endloop
endfacet
facet normal 0 0 1
outer loop
vertex 47.5 -42.5 23
vertex 23.5 -42.5 23
vertex 23.5 -51.5 23
endloop
endfacet
facet normal 0 0.9 0.4
outer loop
vertex 47.5 -41.5 22
vertex 24.5 -41.5 22
vertex 24 -42 22.5
endloop
endfacet
facet normal 0 0.4 0.9
outer loop
vertex 47.5 -42 22.5
vertex 24 -42 22.5
vertex 23.5 -42.5 23
endloop
endfacet
facet normal -1 0 0
outer loop
vertex 22 -52.5 21
vertex 22 -52.5 22
vertex 22 -51.5 23
endloop
endfacet
facet normal 0 0 -1
outer loop
vertex 22 -51.5 13
vertex 22 -51.5 13
vertex 22 -44 13
endloop
endfacet
facet normal -1 0 0
outer loop
vertex 22 -44 13
vertex 22 -44 21
vertex 22 -42.5 13
endloop
endfacet
facet normal -1 -0 0
outer loop
vertex 22 -52.5 21
vertex 22 -42.5 23
vertex 22 -44 21
endloop
endfacet
facet normal -1 0 -0
outer loop
vertex 22 -42.5 13
vertex 22 -41.5 14
vertex 22 -42 13.5
endloop
endfacet
facet normal -1 0 0
outer loop
vertex 22 -42.5 13
vertex 22 -41.5 22
vertex 22 -41.5 14
endloop
endfacet
facet normal -1 0 -0
outer loop
vertex 22 -44 21
vertex 22 -41.5 22
vertex 22 -42.5 13
endloop
endfacet
facet normal -1 0 0
outer loop
vertex 22 -52.5 22
vertex 22 -52 22.5
vertex 22 -51.5 23
endloop
endfacet
facet normal -1 0 0
outer loop
vertex 22 -52.5 21
vertex 22 -51.5 23
vertex 22 -42.5 23
endloop
endfacet
facet normal -1 0 0
outer loop
vertex 22 -44 21
vertex 22 -42 22.5
vertex 22 -41.5 22
endloop
endfacet
facet normal -1 0 0
outer loop
vertex 22 -44 21
vertex 22 -42.5 23
vertex 22 -42 22.5
endloop
endfacet
facet normal -0 -1 0
outer loop
vertex 47.5 41.5 15.5
vertex 47.5 41.5 22
vertex 31.5 41.5 15.5
endloop
endfacet
facet normal 0 1 -0
outer loop
vertex 47.5 52.5 15.5
vertex 31.5 52.5 15.5
vertex 47.5 52.5 22
endloop
endfacet
facet normal 0 0 -1
outer loop
vertex 47.5 42.5 13
vertex 22 51.5 13
vertex 47.5 51.5 13
endloop
endfacet
facet normal 0 -0.9 0.4
outer loop
vertex 47.5 41.5 22
vertex 47.5 42 22.5
vertex 24.5 41.5 22
endloop
endfacet
facet normal 0 -0.4 0.9
outer loop
vertex 47.5 42 22.5
vertex 47.5 42.5 23
vertex 24 42 22.5
endloop
endfacet
facet normal 0 -0 1
outer loop
vertex 47.5 42.5 23
vertex 47.5 51.5 23
vertex 23.5 42.5 23
endloop
endfacet
facet normal 0 0.4 0.9
outer loop
vertex 47.5 51.5 23
vertex 47.5 52 22.5
vertex 23.5 51.5 23
endloop
endfacet
facet normal -0 -1 -0
outer loop
vertex 47.5 41.5 22
vertex 24.5 41.5 22
vertex 31.5 41.5 15.5
endloop
endfacet
facet normal -0 0.9 0.4
outer loop
vertex 47.5 52.5 22
vertex 24 52 22.5
vertex 47.5 52 22.5
endloop
endfacet
facet normal 0 1 0
outer loop
vertex 47.5 52.5 22
vertex 31.5 52.5 15.5
vertex 24.5 52.5 22
endloop
endfacet
facet normal 0 0 -1
outer loop
vertex 47.5 42.5 13
vertex 22 42.5 13
vertex 22 44 13
endloop
endfacet
facet normal 0 0 -1
outer loop
vertex 47.5 42.5 13
vertex 22 44 13
vertex 22 51.5 13
endloop
endfacet
facet normal 0 -0.9 0.4
outer loop
vertex 47.5 42 22.5
vertex 24 42 22.5
vertex 24.5 41.5 22
endloop
endfacet
facet normal 0 -0.4 0.9
outer loop
vertex 47.5 42.5 23
vertex 23.5 42.5 23
vertex 24 42 22.5
endloop
endfacet
facet normal 0 0 1
outer loop
vertex 47.5 51.5 23
vertex 23.5 51.5 23
vertex 23.5 42.5 23
endloop
endfacet
facet normal 0 0.4 0.9
outer loop
vertex 47.5 52 22.5
vertex 24 52 22.5
vertex 23.5 51.5 23
endloop
endfacet
facet normal 0 0.9 0.4
outer loop
vertex 47.5 52.5 22
vertex 24.5 52.5 22
vertex 24 52 22.5
endloop
endfacet
facet normal -1 -0 -0
outer loop
vertex 22 42 13.5
vertex 22 44 13
vertex 22 42.5 13
endloop
endfacet
facet normal -1 0 0
outer loop
vertex 22 42 13.5
vertex 22 41.5 14
vertex 22 44 13
endloop
endfacet
facet normal -1 0 0
outer loop
vertex 22 41.5 14
vertex 22 42.5 23
vertex 22 44 13
endloop
endfacet
facet normal -1 0 0
outer loop
vertex 22 41.5 14
vertex 22 41.5 22
vertex 22 42.5 23
endloop
endfacet
facet normal 0 0 -1
outer loop
vertex 22 42.5 13
vertex 22 44 13
vertex 22 44 13
endloop
endfacet
facet normal -1 -0 -0
outer loop
vertex 22 44 13
vertex 22 42.5 23
vertex 22 44 21
endloop
endfacet
facet normal -1 0 0
outer loop
vertex 22 44 21
vertex 22 52.5 22
vertex 22 52.5 21
endloop
endfacet
facet normal -1 0 0
outer loop
vertex 22 41.5 22
vertex 22 42 22.5
vertex 22 42.5 23
endloop
endfacet
facet normal -1 0 0
outer loop
vertex 22 44 21
vertex 22 42.5 23
vertex 22 51.5 23
endloop
endfacet
facet normal -1 0 0
outer loop
vertex 22 44 21
vertex 22 51.5 23
vertex 22 52 22.5
endloop
endfacet
facet normal -1 0 0
outer loop
vertex 22 44 21
vertex 22 52 22.5
vertex 22 52.5 22
endloop
endfacet
facet normal 0 -1 0
outer loop
vertex 47.5 -52.5 146
vertex 47.5 -52.5 152.5
vertex 31.5 -52.5 152.5
endloop
endfacet
facet normal 0 1 -0
outer loop
vertex 47.5 -41.5 146
vertex 31.5 -41.5 152.5
vertex 47.5 -41.5 152.5
endloop
endfacet
facet normal 0 -0.9 -0.4
outer loop
vertex 47.5 -52 145.5
vertex 47.5 -52.5 146
vertex 24 -52 145.5
endloop
endfacet
facet normal -0 -1 0
outer loop
vertex 47.5 -52.5 146
vertex 31.5 -52.5 152.5
vertex 24.5 -52.5 146
endloop
endfacet
facet normal 0 -0.4 -0.9
outer loop
vertex 47.5 -52 145.5
vertex 23.5 -51.5 145
vertex 47.5 -51.5 145
endloop
endfacet
facet normal 0 0 -1
outer loop
vertex 47.5 -51.5 145
vertex 23.5 -42.5 145
vertex 47.5 -42.5 145
endloop
endfacet
facet normal 0 0.9 -0.4
outer loop
vertex 47.5 -42 145.5
vertex 24.5 -41.5 146
vertex 47.5 -41.5 146
endloop
endfacet
facet normal 0 0.4 -0.9
outer loop
vertex 47.5 -42.5 145
vertex 24 -42 145.5
vertex 47.5 -42 145.5
endloop
endfacet
facet normal 0 -0 1
outer loop
vertex 47.5 -51.5 155
vertex 47.5 -42.5 155
vertex 22 -51.5 155
endloop
endfacet
facet normal 0 1 -0
outer loop
vertex 47.5 -41.5 146
vertex 24.5 -41.5 146
vertex 31.5 -41.5 152.5
endloop
endfacet
facet normal -0 -0.9 -0.4
outer loop
vertex 47.5 -52.5 146
vertex 24.5 -52.5 146
vertex 24 -52 145.5
endloop
endfacet
facet normal -0 -0.4 -0.9
outer loop
vertex 47.5 -52 145.5
vertex 24 -52 145.5
vertex 23.5 -51.5 145
endloop
endfacet
facet normal 0 0 -1
outer loop
vertex 47.5 -51.5 145
vertex 23.5 -51.5 145
vertex 23.5 -42.5 145
endloop
endfacet
facet normal 0 0.9 -0.4
outer loop
vertex 47.5 -42 145.5
vertex 24 -42 145.5
vertex 24.5 -41.5 146
endloop
endfacet
facet normal 0 0.4 -0.9
outer loop
vertex 47.5 -42.5 145
vertex 23.5 -42.5 145
vertex 24 -42 145.5
endloop
endfacet
facet normal 0 0 1
outer loop
vertex 47.5 -42.5 155
vertex 22 -44 155
vertex 22 -51.5 155
endloop
endfacet
facet normal -1 -0 -0
outer loop
vertex 22 -52 145.5
vertex 22 -52.5 146
vertex 22 -44 147
endloop
endfacet
facet normal -1 -0 -0
outer loop
vertex 22 -52 145.5
vertex 22 -44 147
vertex 22 -51.5 145
endloop
endfacet
facet normal -1 0 -0
outer loop
vertex 22 -51.5 145
vertex 22 -44 147
vertex 22 -42.5 145
endloop
endfacet
facet normal -1 0 -0
outer loop
vertex 22 -42.5 145
vertex 22 -41.5 146
vertex 22 -42 145.5
endloop
endfacet
facet normal -1 -0 0
outer loop
vertex 22 -52.5 146
vertex 22 -52.5 147
vertex 22 -44 147
endloop
endfacet
facet normal -1 0 0
outer loop
vertex 22 -42.5 145
vertex 22 -44 147
vertex 22 -44 155
endloop
endfacet
facet normal 0 0 1
outer loop
vertex 22 -44 155
vertex 22 -44 155
vertex 22 -44 155
endloop
endfacet
facet normal -1 0 0
outer loop
vertex 22 -42.5 145
vertex 22 -41.5 154
vertex 22 -41.5 146
endloop
endfacet
facet normal -1 0 -0
outer loop
vertex 22 -42.5 145
vertex 22 -44 155
vertex 22 -41.5 154
endloop
endfacet
facet normal -1 0 0
outer loop
vertex 22 -44 155
vertex 22 -42 154.5
vertex 22 -41.5 154
endloop
endfacet
facet normal -1 0 0
outer loop
vertex 22 -44 155
vertex 22 -42.5 155
vertex 22 -42 154.5
endloop
endfacet
facet normal 0 -1 0
outer loop
vertex 47.5 41.5 146
vertex 47.5 41.5 152.5
vertex 31.5 41.5 152.5
endloop
endfacet
facet normal 0 1 -0
outer loop
vertex 47.5 52.5 146
vertex 31.5 52.5 152.5
vertex 47.5 52.5 152.5
endloop
endfacet
facet normal 0 -0.9 -0.4
outer loop
vertex 47.5 42 145.5
vertex 47.5 41.5 146
vertex 24 42 145.5
endloop
endfacet
facet normal 0 -0.4 -0.9
outer loop
vertex 47.5 42.5 145
vertex 47.5 42 145.5
vertex 23.5 42.5 145
endloop
endfacet
facet normal 0 0 -1
outer loop
vertex 47.5 42.5 145
vertex 23.5 51.5 145
vertex 47.5 51.5 145
endloop
endfacet
facet normal 0 0.4 -0.9
outer loop
vertex 47.5 51.5 145
vertex 24 52 145.5
vertex 47.5 52 145.5
endloop
endfacet
facet normal -0 -1 0
outer loop
vertex 47.5 41.5 146
vertex 31.5 41.5 152.5
vertex 24.5 41.5 146
endloop
endfacet
facet normal 0 0.9 -0.4
outer loop
vertex 47.5 52 145.5
vertex 24.5 52.5 146
vertex 47.5 52.5 146
endloop
endfacet
facet normal 0 1 -0
outer loop
vertex 47.5 52.5 146
vertex 24.5 52.5 146
vertex 31.5 52.5 152.5
endloop
endfacet
facet normal -0 -0.9 -0.4
outer loop
vertex 47.5 41.5 146
vertex 24.5 41.5 146
vertex 24 42 145.5
endloop
endfacet
facet normal -0 -0.4 -0.9
outer loop
vertex 47.5 42 145.5
vertex 24 42 145.5
vertex 23.5 42.5 145
endloop
endfacet
facet normal 0 0 -1
outer loop
vertex 47.5 42.5 145
vertex 23.5 42.5 145
vertex 23.5 51.5 145
endloop
endfacet
facet normal 0 0.4 -0.9
outer loop
vertex 47.5 51.5 145
vertex 23.5 51.5 145
vertex 24 52 145.5
endloop
endfacet
facet normal 0 0 1
outer loop
vertex 47.5 51.5 155
vertex 22 51.5 155
vertex 22 42.5 155
endloop
endfacet
facet normal 0 0.9 -0.4
outer loop
vertex 47.5 52 145.5
vertex 24 52 145.5
vertex 24.5 52.5 146
endloop
endfacet
facet normal -1 -0 -0
outer loop
vertex 22 42.5 145
vertex 22 42 145.5
vertex 22 44 147
endloop
endfacet
facet normal -1 -0 -0
outer loop
vertex 22 42 145.5
vertex 22 41.5 146
vertex 22 44 147
endloop
endfacet
facet normal -1 0 -0
outer loop
vertex 22 42.5 145
vertex 22 52.5 147
vertex 22 51.5 145
endloop
endfacet
facet normal -1 0 -0
outer loop
vertex 22 51.5 145
vertex 22 52.5 146
vertex 22 52 145.5
endloop
endfacet
facet normal -1 -0 0
outer loop
vertex 22 41.5 146
vertex 22 42.5 155
vertex 22 44 147
endloop
endfacet
facet normal -1 0 0
outer loop
vertex 22 41.5 146
vertex 22 41.5 154
vertex 22 42.5 155
endloop
endfacet
facet normal -1 0 0
outer loop
vertex 22 41.5 154
vertex 22 42 154.5
vertex 22 42.5 155
endloop
endfacet
facet normal -1 0 -0
outer loop
vertex 22 42.5 145
vertex 22 44 147
vertex 22 52.5 147
endloop
endfacet
facet normal -1 -0 -0
outer loop
vertex 22 42.5 155
vertex 22 44 155
vertex 22 44 147
endloop
endfacet
facet normal 0 -0 1
outer loop
vertex 22 42.5 155
vertex 22 51.5 155
vertex 22 44 155
endloop
endfacet
facet normal 0 -0 1
outer loop
vertex 22 44 155
vertex 22 51.5 155
vertex 22 51.5 155
endloop
endfacet
facet normal -1 0 0
outer loop
vertex 22 51.5 145
vertex 22 52.5 147
vertex 22 52.5 146
endloop
endfacet
facet normal 0 0 -1
outer loop
vertex 22 -61.5 13
vertex 22 -51.5 13
vertex 22 -51.5 13
endloop
endfacet
facet normal 0 -0.9 -0.4
outer loop
vertex 22 -67 15.5
vertex 22 -69.5 21
vertex 16 -67 15.5
endloop
endfacet
facet normal 0 -0.4 -0.9
outer loop
vertex 22 -67 15.5
vertex 16 -61.5 13
vertex 22 -61.5 13
endloop
endfacet
facet normal -0 -0.4 -0.9
outer loop
vertex 22 -67 15.5
vertex 16 -67 15.5
vertex 16 -61.5 13
endloop
endfacet
facet normal -1 0 -0
outer loop
vertex 16 -67 15.5
vertex 16 -60.5 21
vertex 16 -61.5 13
endloop
endfacet
facet normal -0 -0.9 -0.4
outer loop
vertex 22 -69.5 21
vertex 16 -69.5 21
vertex 16 -67 15.5
endloop
endfacet
facet normal -1 0 0
outer loop
vertex 16 -67 15.5
vertex 16 -69.5 21
vertex 16 -65 22.5
endloop
endfacet
facet normal 0 0.4 0.9
outer loop
vertex 22 -60.5 21
vertex 16 -60.5 21
vertex 16 -65 22.5
endloop
endfacet
facet normal -1 0 0
outer loop
vertex 16 -67 15.5
vertex 16 -65 22.5
vertex 16 -60.5 21
endloop
endfacet
facet normal 0 0 -1
outer loop
vertex 22 -61.5 13
vertex 16 -44 13
vertex 22 -51.5 13
endloop
endfacet
facet normal 0 -0 1
outer loop
vertex 22 -60.5 21
vertex 22 -52.5 21
vertex 16 -60.5 21
endloop
endfacet
facet normal 0 0 -1
outer loop
vertex 22 -61.5 13
vertex 16 -61.5 13
vertex 16 -44 13
endloop
endfacet
facet normal -1 0 0
outer loop
vertex 16 -61.5 13
vertex 16 -60.5 21
vertex 16 -44 13
endloop
endfacet
facet normal 0 0 1
outer loop
vertex 22 -52.5 21
vertex 16 -44 21
vertex 16 -60.5 21
endloop
endfacet
facet normal -0 0.9 0.4
outer loop
vertex 22 -65 22.5
vertex 16 -66.5 27
vertex 22 -66.5 27
endloop
endfacet
facet normal -0 0.4 0.9
outer loop
vertex 22 -60.5 21
vertex 16 -65 22.5
vertex 22 -65 22.5
endloop
endfacet
facet normal -0 -1 0
outer loop
vertex 22 -69.5 21
vertex 22 -69.5 40
vertex 16 -69.5 21
endloop
endfacet
facet normal 0 0.9 0.4
outer loop
vertex 22 -65 22.5
vertex 16 -65 22.5
vertex 16 -66.5 27
endloop
endfacet
facet normal -1 0 0
outer loop
vertex 16 -69.5 21
vertex 16 -66.5 27
vertex 16 -65 22.5
endloop
endfacet
facet normal -1 0 0
outer loop
vertex 16 -69.5 21
vertex 16 -69.5 40
vertex 16 -66.5 27
endloop
endfacet
facet normal 0 0 -1
outer loop
vertex 22 -51.5 13
vertex 16 -44 13
vertex 22 -44 13
endloop
endfacet
facet normal 0 1 -0
outer loop
vertex 22 -44 13
vertex 16 -44 13
vertex 22 -44 21
endloop
endfacet
facet normal 0 0 1
outer loop
vertex 22 -52.5 21
vertex 22 -44 21
vertex 16 -44 21
endloop
endfacet
facet normal -1 0 0
outer loop
vertex 16 -60.5 21
vertex 16 -44 21
vertex 16 -44 13
endloop
endfacet
facet normal 0 1 -0
outer loop
vertex 22 -44 21
vertex 16 -44 13
vertex 16 -44 21
endloop
endfacet
facet normal 0 1 -0
outer loop
vertex 22 -66.5 27
vertex 16 -66.5 40
vertex 22 -66.5 40
endloop
endfacet
facet normal 0 1 -0
outer loop
vertex 22 -66.5 27
vertex 16 -66.5 27
vertex 16 -66.5 40
endloop
endfacet
facet normal 0 -1 0
outer loop
vertex 16 -69.5 21
vertex 22 -69.5 40
vertex 16 -69.5 40
endloop
endfacet
facet normal -1 0 0
outer loop
vertex 16 -66.5 27
vertex 16 -69.5 40
vertex 16 -66.5 40
endloop
endfacet
facet normal 0 -0 1
outer loop
vertex 22 -69.5 40
vertex 22 -66.5 40
vertex 16 -69.5 40
endloop
endfacet
facet normal 0 0 1
outer loop
vertex 22 -66.5 40
vertex 16 -66.5 40
vertex 16 -69.5 40
endloop
endfacet
facet normal 0 -1 0
outer loop
vertex 22 44 13
vertex 22 44 21
vertex 16 44 21
endloop
endfacet
facet normal 0 -0 1
outer loop
vertex 22 44 21
vertex 22 52.5 21
vertex 16 44 21
endloop
endfacet
facet normal -0 -1 -0
outer loop
vertex 22 44 13
vertex 16 44 21
vertex 16 44 13
endloop
endfacet
facet normal 0 0 -1
outer loop
vertex 22 44 13
vertex 16 44 13
vertex 16 61.5 13
endloop
endfacet
facet normal -1 0 0
outer loop
vertex 16 44 13
vertex 16 44 21
vertex 16 60.5 21
endloop
endfacet
facet normal 0 0 -1
outer loop
vertex 22 44 13
vertex 16 61.5 13
vertex 22 61.5 13
endloop
endfacet
facet normal 0 0 1
outer loop
vertex 16 44 21
vertex 22 52.5 21
vertex 22 60.5 21
endloop
endfacet
facet normal -1 0 0
outer loop
vertex 16 44 13
vertex 16 60.5 21
vertex 16 61.5 13
endloop
endfacet
facet normal 0 -0 1
outer loop
vertex 16 44 21
vertex 22 60.5 21
vertex 16 60.5 21
endloop
endfacet
facet normal 0 0.4 -0.9
outer loop
vertex 22 61.5 13
vertex 16 67 15.5
vertex 22 67 15.5
endloop
endfacet
facet normal 0 -0.4 0.9
outer loop
vertex 22 60.5 21
vertex 22 65 22.5
vertex 16 60.5 21
endloop
endfacet
facet normal 0 0.9 -0.4
outer loop
vertex 22 67 15.5
vertex 16 69.5 21
vertex 22 69.5 21
endloop
endfacet
facet normal 0 0.4 -0.9
outer loop
vertex 22 61.5 13
vertex 16 61.5 13
vertex 16 67 15.5
endloop
endfacet
facet normal -1 0 -0
outer loop
vertex 16 60.5 21
vertex 16 67 15.5
vertex 16 61.5 13
endloop
endfacet
facet normal 0 0.9 -0.4
outer loop
vertex 22 67 15.5
vertex 16 67 15.5
vertex 16 69.5 21
endloop
endfacet
facet normal -1 0 0
outer loop
vertex 16 60.5 21
vertex 16 65 22.5
vertex 16 67 15.5
endloop
endfacet
facet normal -1 0 0
outer loop
vertex 16 67 15.5
vertex 16 65 22.5
vertex 16 69.5 21
endloop
endfacet
facet normal 0 -0.9 0.4
outer loop
vertex 22 65 22.5
vertex 22 66.5 27
vertex 16 65 22.5
endloop
endfacet
facet normal 0 -0.4 0.9
outer loop
vertex 22 65 22.5
vertex 16 65 22.5
vertex 16 60.5 21
endloop
endfacet
facet normal 0 -0.9 0.4
outer loop
vertex 22 66.5 27
vertex 16 66.5 27
vertex 16 65 22.5
endloop
endfacet
facet normal -1 0 0
outer loop
vertex 16 69.5 21
vertex 16 65 22.5
vertex 16 66.5 27
endloop
endfacet
facet normal 0 1 -0
outer loop
vertex 22 69.5 21
vertex 16 69.5 21
vertex 16 69.5 40
endloop
endfacet
facet normal -1 0 0
outer loop
vertex 16 69.5 21
vertex 16 66.5 27
vertex 16 69.5 40
endloop
endfacet
facet normal -0 -1 0
outer loop
vertex 22 66.5 27
vertex 22 66.5 40
vertex 16 66.5 27
endloop
endfacet
facet normal 0 1 -0
outer loop
vertex 22 69.5 21
vertex 16 69.5 40
vertex 22 69.5 40
endloop
endfacet
facet normal 0 -1 0
outer loop
vertex 16 66.5 27
vertex 22 66.5 40
vertex 16 66.5 40
endloop
endfacet
facet normal -1 0 0
outer loop
vertex 16 66.5 27
vertex 16 66.5 40
vertex 16 69.5 40
endloop
endfacet
facet normal 0 -0 1
outer loop
vertex 22 66.5 40
vertex 22 69.5 40
vertex 16 66.5 40
endloop
endfacet
facet normal 0 0 1
outer loop
vertex 22 69.5 40
vertex 16 69.5 40
vertex 16 66.5 40
endloop
endfacet
facet normal 0 0 -1
outer loop
vertex 22 -69.5 128
vertex 16 -66.5 128
vertex 22 -66.5 128
endloop
endfacet
facet normal 0 0 -1
outer loop
vertex 22 -69.5 128
vertex 16 -69.5 128
vertex 16 -66.5 128
endloop
endfacet
facet normal -0 -1 0
outer loop
vertex 22 -69.5 128
vertex 22 -69.5 147
vertex 16 -69.5 128
endloop
endfacet
facet normal 0 1 -0
outer loop
vertex 22 -66.5 128
vertex 16 -66.5 141
vertex 22 -66.5 141
endloop
endfacet
facet normal 0 1 -0
outer loop
vertex 22 -66.5 128
vertex 16 -66.5 128
vertex 16 -66.5 141
endloop
endfacet
facet normal -1 0 0
outer loop
vertex 16 -69.5 128
vertex 16 -66.5 141
vertex 16 -66.5 128
endloop
endfacet
facet normal 0 -0 1
outer loop
vertex 22 -61.5 155
vertex 22 -51.5 155
vertex 22 -61.5 155
endloop
endfacet
facet normal 0 0.9 -0.4
outer loop
vertex 22 -66.5 141
vertex 16 -65 145.5
vertex 22 -65 145.5
endloop
endfacet
facet normal 0 -1 0
outer loop
vertex 16 -69.5 128
vertex 22 -69.5 147
vertex 16 -69.5 147
endloop
endfacet
facet normal -1 0 0
outer loop
vertex 16 -69.5 128
vertex 16 -69.5 147
vertex 16 -66.5 141
endloop
endfacet
facet normal 0 0.9 -0.4
outer loop
vertex 22 -66.5 141
vertex 16 -66.5 141
vertex 16 -65 145.5
endloop
endfacet
facet normal -1 0 0
outer loop
vertex 16 -66.5 141
vertex 16 -69.5 147
vertex 16 -65 145.5
endloop
endfacet
facet normal 0 0.4 -0.9
outer loop
vertex 22 -65 145.5
vertex 16 -65 145.5
vertex 16 -60.5 147
endloop
endfacet
facet normal 0 -0.9 0.4
outer loop
vertex 22 -69.5 147
vertex 22 -67 152.5
vertex 16 -69.5 147
endloop
endfacet
facet normal 0 0.4 -0.9
outer loop
vertex 22 -65 145.5
vertex 16 -60.5 147
vertex 22 -60.5 147
endloop
endfacet
facet normal 0 -0.4 0.9
outer loop
vertex 22 -67 152.5
vertex 22 -61.5 155
vertex 16 -67 152.5
endloop
endfacet
facet normal -1 0 0
outer loop
vertex 16 -65 145.5
vertex 16 -69.5 147
vertex 16 -67 152.5
endloop
endfacet
facet normal -1 0 0
outer loop
vertex 16 -65 145.5
vertex 16 -67 152.5
vertex 16 -60.5 147
endloop
endfacet
facet normal 0 -0.9 0.4
outer loop
vertex 22 -67 152.5
vertex 16 -67 152.5
vertex 16 -69.5 147
endloop
endfacet
facet normal 0 -0.4 0.9
outer loop
vertex 22 -61.5 155
vertex 16 -61.5 155
vertex 16 -67 152.5
endloop
endfacet
facet normal -1 0 0
outer loop
vertex 16 -67 152.5
vertex 16 -61.5 155
vertex 16 -60.5 147
endloop
endfacet
facet normal 0 0 -1
outer loop
vertex 22 -60.5 147
vertex 16 -44 147
vertex 22 -52.5 147
endloop
endfacet
facet normal 0 -0 1
outer loop
vertex 22 -61.5 155
vertex 22 -51.5 155
vertex 16 -61.5 155
endloop
endfacet
facet normal 0 -0 1
outer loop
vertex 16 -61.5 155
vertex 22 -51.5 155
vertex 22 -44 155
endloop
endfacet
facet normal 0 0 -1
outer loop
vertex 22 -60.5 147
vertex 16 -60.5 147
vertex 16 -44 147
endloop
endfacet
facet normal -1 0 -0
outer loop
vertex 16 -61.5 155
vertex 16 -44 155
vertex 16 -60.5 147
endloop
endfacet
facet normal 0 -0 1
outer loop
vertex 22 -51.5 155
vertex 22 -44 155
vertex 22 -44 155
endloop
endfacet
facet normal 0 0 -1
outer loop
vertex 22 -52.5 147
vertex 16 -44 147
vertex 22 -44 147
endloop
endfacet
facet normal 0 1 -0
outer loop
vertex 22 -44 147
vertex 16 -44 147
vertex 22 -44 155
endloop
endfacet
facet normal 0 -0 1
outer loop
vertex 22 -44 155
vertex 22 -44 155
vertex 16 -44 155
endloop
endfacet
facet normal -1 0 0
outer loop
vertex 16 -60.5 147
vertex 16 -44 155
vertex 16 -44 147
endloop
endfacet
facet normal 0 -0 1
outer loop
vertex 16 -61.5 155
vertex 22 -44 155
vertex 16 -44 155
endloop
endfacet
facet normal 0 1 -0
outer loop
vertex 22 -44 155
vertex 16 -44 147
vertex 16 -44 155
endloop
endfacet
facet normal 0 0 -1
outer loop
vertex 22 66.5 128
vertex 16 69.5 128
vertex 22 69.5 128
endloop
endfacet
facet normal 0 0 -1
outer loop
vertex 22 66.5 128
vertex 16 66.5 128
vertex 16 69.5 128
endloop
endfacet
facet normal -0 -1 0
outer loop
vertex 22 66.5 128
vertex 22 66.5 141
vertex 16 66.5 128
endloop
endfacet
facet normal -1 0 0
outer loop
vertex 16 66.5 128
vertex 16 66.5 141
vertex 16 69.5 128
endloop
endfacet
facet normal 0 1 -0
outer loop
vertex 22 69.5 128
vertex 16 69.5 128
vertex 16 69.5 147
endloop
endfacet
facet normal 0 -1 0
outer loop
vertex 16 66.5 128
vertex 22 66.5 141
vertex 16 66.5 141
endloop
endfacet
facet normal 0 0 -1
outer loop
vertex 22 44 147
vertex 16 44 147
vertex 22 52.5 147
endloop
endfacet
facet normal 0 -1 0
outer loop
vertex 22 44 147
vertex 22 44 155
vertex 16 44 155
endloop
endfacet
facet normal 0 -0 1
outer loop
vertex 22 44 155
vertex 22 51.5 155
vertex 16 44 155
endloop
endfacet
facet normal -0 -1 -0
outer loop
vertex 22 44 147
vertex 16 44 155
vertex 16 44 147
endloop
endfacet
facet normal -1 0 0
outer loop
vertex 16 44 147
vertex 16 44 155
vertex 16 60.5 147
endloop
endfacet
facet normal 0 -0 1
outer loop
vertex 22 51.5 155
vertex 22 61.5 155
vertex 22 51.5 155
endloop
endfacet
facet normal 0 1 -0
outer loop
vertex 22 69.5 128
vertex 16 69.5 147
vertex 22 69.5 147
endloop
endfacet
facet normal 0 -0.4 -0.9
outer loop
vertex 22 65 145.5
vertex 22 60.5 147
vertex 16 65 145.5
endloop
endfacet
facet normal 0 -0.9 -0.4
outer loop
vertex 22 66.5 141
vertex 22 65 145.5
vertex 16 66.5 141
endloop
endfacet
facet normal -1 0 0
outer loop
vertex 16 69.5 128
vertex 16 66.5 141
vertex 16 69.5 147
endloop
endfacet
facet normal -0 -0.9 -0.4
outer loop
vertex 22 65 145.5
vertex 16 65 145.5
vertex 16 66.5 141
endloop
endfacet
facet normal -1 0 0
outer loop
vertex 16 66.5 141
vertex 16 65 145.5
vertex 16 69.5 147
endloop
endfacet
facet normal 0 0 -1
outer loop
vertex 22 52.5 147
vertex 16 60.5 147
vertex 22 60.5 147
endloop
endfacet
facet normal 0 -0 1
outer loop
vertex 22 51.5 155
vertex 22 61.5 155
vertex 16 44 155
endloop
endfacet
facet normal 0 -0 1
outer loop
vertex 16 44 155
vertex 22 61.5 155
vertex 22 61.5 155
endloop
endfacet
facet normal 0 0 -1
outer loop
vertex 16 44 147
vertex 16 60.5 147
vertex 22 52.5 147
endloop
endfacet
facet normal 0 -0 1
outer loop
vertex 16 44 155
vertex 22 61.5 155
vertex 16 61.5 155
endloop
endfacet
facet normal -1 0 -0
outer loop
vertex 16 44 155
vertex 16 61.5 155
vertex 16 60.5 147
endloop
endfacet
facet normal 0 0.4 0.9
outer loop
vertex 22 61.5 155
vertex 22 67 152.5
vertex 16 61.5 155
endloop
endfacet
facet normal -0 0.9 0.4
outer loop
vertex 22 69.5 147
vertex 16 67 152.5
vertex 22 67 152.5
endloop
endfacet
facet normal -0 -0.4 -0.9
outer loop
vertex 22 60.5 147
vertex 16 60.5 147
vertex 16 65 145.5
endloop
endfacet
facet normal -1 0 0
outer loop
vertex 16 65 145.5
vertex 16 60.5 147
vertex 16 67 152.5
endloop
endfacet
facet normal 0 0.9 0.4
outer loop
vertex 22 69.5 147
vertex 16 69.5 147
vertex 16 67 152.5
endloop
endfacet
facet normal -1 0 0
outer loop
vertex 16 65 145.5
vertex 16 67 152.5
vertex 16 69.5 147
endloop
endfacet
facet normal -1 0 0
outer loop
vertex 16 60.5 147
vertex 16 61.5 155
vertex 16 67 152.5
endloop
endfacet
facet normal 0 0.4 0.9
outer loop
vertex 22 67 152.5
vertex 16 67 152.5
vertex 16 61.5 155
endloop
endfacet
facet normal 0 0.5 0.9
outer loop
vertex 47.5 -52.5 29
vertex 50 -55 30
vertex 50 -52.5 29
endloop
endfacet
facet normal 0 0.5 0.9
outer loop
vertex 47.5 -53 29
vertex 50 -55 30
vertex 47.5 -52.5 29
endloop
endfacet
facet normal 0 0.5 0.9
outer loop
vertex 47.5 -52.5 29
vertex 50 -55 30
vertex 47.5 -52.5 29
endloop
endfacet
facet normal -0 0.5 0.9
outer loop
vertex 47.5 -53 29
vertex 47.5 -55 30
vertex 50 -55 30
endloop
endfacet
facet normal 0 -0.5 0.9
outer loop
vertex 47.5 -50 30
vertex 50 -52.5 29
vertex 50 -50 30
endloop
endfacet
facet normal 0 -0.5 0.9
outer loop
vertex 47.5 -50 30
vertex 47.5 -52.5 29
vertex 50 -52.5 29
endloop
endfacet
facet normal 0 1 -0
outer loop
vertex 50 -55 30
vertex 47.5 -55 30
vertex 50 -55 33
endloop
endfacet
facet normal 0 0.5 -0.9
outer loop
vertex 47.5 -55 33
vertex 50 -52.5 34
vertex 50 -55 33
endloop
endfacet
facet normal -0 1 0
outer loop
vertex 47.5 -55 33
vertex 50 -55 33
vertex 47.5 -55 30
endloop
endfacet
facet normal 0 0.5 -0.9
outer loop
vertex 47.5 -55 33
vertex 47.5 -52.5 34
vertex 50 -52.5 34
endloop
endfacet
facet normal 0 -1 0
outer loop
vertex 47.5 -50 33
vertex 50 -50 30
vertex 50 -50 33
endloop
endfacet
facet normal -0 -0.5 -0.9
outer loop
vertex 50 -52.5 34
vertex 47.5 -52.5 34
vertex 50 -50 33
endloop
endfacet
facet normal 0 -1 0
outer loop
vertex 47.5 -50 33
vertex 47.5 -50 30
vertex 50 -50 30
endloop
endfacet
facet normal 0 -0.5 -0.9
outer loop
vertex 47.5 -52.5 34
vertex 47.5 -50 33
vertex 50 -50 33
endloop
endfacet
facet normal 0 0.5 0.9
outer loop
vertex 50 50 30
vertex 50 52.5 29
vertex 47.5 52.5 29
endloop
endfacet
facet normal 0 0.5 0.9
outer loop
vertex 50 50 30
vertex 47.5 52.5 29
vertex 47.5 50 30
endloop
endfacet
facet normal 0 -0.5 0.9
outer loop
vertex 50 52.5 29
vertex 50 55 30
vertex 47.5 55 30
endloop
endfacet
facet normal 0 -0.5 0.9
outer loop
vertex 50 52.5 29
vertex 47.5 55 30
vertex 47.5 52.5 29
endloop
endfacet
facet normal 0 1 -0
outer loop
vertex 50 50 30
vertex 47.5 50 30
vertex 50 50 33
endloop
endfacet
facet normal 0 0.5 -0.9
outer loop
vertex 50 52.5 34
vertex 50 50 33
vertex 47.5 50 33
endloop
endfacet
facet normal -0 1 0
outer loop
vertex 47.5 50 33
vertex 50 50 33
vertex 47.5 50 30
endloop
endfacet
facet normal 0 0.5 -0.9
outer loop
vertex 50 52.5 34
vertex 47.5 50 33
vertex 47.5 52.5 34
endloop
endfacet
facet normal -0 -1 -0
outer loop
vertex 50 55 33
vertex 47.5 55 33
vertex 50 55 30
endloop
endfacet
facet normal -0 -0.5 -0.9
outer loop
vertex 50 52.5 34
vertex 47.5 52.5 34
vertex 50 55 33
endloop
endfacet
facet normal -0 -1 -0
outer loop
vertex 50 55 30
vertex 47.5 55 33
vertex 47.5 55 30
endloop
endfacet
facet normal 0 -0.5 -0.9
outer loop
vertex 47.5 55 33
vertex 50 55 33
vertex 47.5 52.5 34
endloop
endfacet
facet normal 0 0.5 0.9
outer loop
vertex 47.5 -52.5 134
vertex 50 -55 135
vertex 50 -52.5 134
endloop
endfacet
facet normal 0 1 -0
outer loop
vertex 50 -55 135
vertex 47.5 -55 135
vertex 50 -55 138
endloop
endfacet
facet normal -0 0.5 0.9
outer loop
vertex 47.5 -52.5 134
vertex 47.5 -55 135
vertex 50 -55 135
endloop
endfacet
facet normal -0 1 0
outer loop
vertex 47.5 -55 138
vertex 50 -55 138
vertex 47.5 -55 135
endloop
endfacet
facet normal 0 -0.5 0.9
outer loop
vertex 47.5 -50 135
vertex 50 -52.5 134
vertex 50 -50 135
endloop
endfacet
facet normal 0 -1 0
outer loop
vertex 47.5 -50 138
vertex 50 -50 135
vertex 50 -50 138
endloop
endfacet
facet normal 0 -0.5 0.9
outer loop
vertex 47.5 -50 135
vertex 47.5 -52.5 134
vertex 50 -52.5 134
endloop
endfacet
facet normal 0 -1 0
outer loop
vertex 47.5 -50 138
vertex 47.5 -50 135
vertex 50 -50 135
endloop
endfacet
facet normal 0 0.5 -0.9
outer loop
vertex 50 -55 138
vertex 47.5 -55 138
vertex 50 -52.5 139
endloop
endfacet
facet normal 0 0.5 -0.9
outer loop
vertex 47.5 -55 138
vertex 47.5 -52.5 139
vertex 50 -52.5 139
endloop
endfacet
facet normal -0 -0.5 -0.9
outer loop
vertex 50 -52.5 139
vertex 47.5 -52.5 139
vertex 50 -50 138
endloop
endfacet
facet normal 0 -0.5 -0.9
outer loop
vertex 47.5 -50 138
vertex 50 -50 138
vertex 47.5 -52.5 139
endloop
endfacet
facet normal 0 0.5 0.9
outer loop
vertex 50 50 135
vertex 50 52.5 134
vertex 47.5 52.5 134
endloop
endfacet
facet normal 0 1 -0
outer loop
vertex 50 50 135
vertex 47.5 50 135
vertex 50 50 138
endloop
endfacet
facet normal -0 0.5 0.9
outer loop
vertex 47.5 52.5 134
vertex 47.5 50 135
vertex 50 50 135
endloop
endfacet
facet normal -0 0.5 0.9
outer loop
vertex 47.5 52.5 134
vertex 50 50 135
vertex 47.5 52.5 134
endloop
endfacet
facet normal -0 1 0
outer loop
vertex 47.5 50 138
vertex 50 50 138
vertex 47.5 50 135
endloop
endfacet
facet normal 0 -0.5 0.9
outer loop
vertex 50 52.5 134
vertex 50 55 135
vertex 47.5 55 135
endloop
endfacet
facet normal -0 -1 -0
outer loop
vertex 50 55 138
vertex 47.5 55 138
vertex 50 55 135
endloop
endfacet
facet normal 0 -0.5 0.9
outer loop
vertex 47.5 53 134
vertex 47.5 52.5 134
vertex 50 52.5 134
endloop
endfacet
facet normal -0 -0.5 0.9
outer loop
vertex 47.5 53 134
vertex 50 52.5 134
vertex 47.5 53.5 134.5
endloop
endfacet
facet normal 0 -0.5 0.9
outer loop
vertex 47.5 53.5 134.5
vertex 50 52.5 134
vertex 47.5 55 135
endloop
endfacet
facet normal -0 -1 -0
outer loop
vertex 50 55 135
vertex 47.5 55 138
vertex 47.5 55 135
endloop
endfacet
facet normal 0 0.5 -0.9
outer loop
vertex 50 50 138
vertex 47.5 50 138
vertex 50 52.5 139
endloop
endfacet
facet normal 0 0.5 -0.9
outer loop
vertex 47.5 50 138
vertex 47.5 52.5 139
vertex 50 52.5 139
endloop
endfacet
facet normal -0 -0.5 -0.9
outer loop
vertex 50 52.5 139
vertex 47.5 52.5 139
vertex 50 55 138
endloop
endfacet
facet normal 0 -0.5 -0.9
outer loop
vertex 47.5 53 139
vertex 47.5 55 138
vertex 50 55 138
endloop
endfacet
facet normal 0 -0.5 -0.9
outer loop
vertex 47.5 52.5 139
vertex 50 55 138
vertex 47.5 52.5 139
endloop
endfacet
facet normal -0 -0.5 -0.9
outer loop
vertex 47.5 52.5 139
vertex 47.5 53 139
vertex 50 55 138
endloop
endfacet
facet normal -1 0 0
outer loop
vertex 47.5 -53 29
vertex 47.5 -52.5 29
vertex 47.5 -52.5 24
endloop
endfacet
facet normal -1 0 0
outer loop
vertex 47.5 -52.5 29
vertex 47.5 -52.5 29
vertex 47.5 -52.5 24
endloop
endfacet
facet normal -1 0 -0
outer loop
vertex 47.5 -52.5 29
vertex 47.5 -52 29
vertex 47.5 -52.5 24
endloop
endfacet
facet normal -1 0 0
outer loop
vertex 47.5 -52.5 24
vertex 47.5 -52 29
vertex 47.5 -42 24.5
endloop
endfacet
facet normal -1 -0 -0
outer loop
vertex 47.5 -52 29
vertex 47.5 -42 24.5
vertex 47.5 -52 29
endloop
endfacet
facet normal -1 0 0
outer loop
vertex 47.5 -52 29
vertex 47.5 -44 33
vertex 47.5 -42 24.5
endloop
endfacet
facet normal -1 0 0
outer loop
vertex 47.5 -53 36
vertex 47.5 -52.5 37.5
vertex 47.5 -52.5 34.5
endloop
endfacet
facet normal -1 0 0
outer loop
vertex 47.5 -53.5 35.5
vertex 47.5 -55 63.5
vertex 47.5 -53 36
endloop
endfacet
facet normal -1 0 0
outer loop
vertex 47.5 -53 36
vertex 47.5 -55 63.5
vertex 47.5 -52.5 37.5
endloop
endfacet
facet normal -1 0 -0
outer loop
vertex 47.5 -52.5 34.5
vertex 47.5 -45.5 48.5
vertex 47.5 -52.5 34
endloop
endfacet
facet normal -1 0 0
outer loop
vertex 47.5 -42 24.5
vertex 47.5 -44 33
vertex 47.5 -45.5 48.5
endloop
endfacet
facet normal -1 -0 0
outer loop
vertex 47.5 -45 39.5
vertex 47.5 -52.5 34
vertex 47.5 -45.5 48.5
endloop
endfacet
facet normal -1 0 0
outer loop
vertex 47.5 -44 33
vertex 47.5 -45 39.5
vertex 47.5 -45.5 48.5
endloop
endfacet
facet normal -1 0 -0
outer loop
vertex 47.5 -46.5 49.5
vertex 47.5 -45.5 48.5
vertex 47.5 -52.5 34.5
endloop
endfacet
facet normal -1 0 0
outer loop
vertex 47.5 -55.5 68
vertex 47.5 -55 63.5
vertex 47.5 -53.5 35.5
endloop
endfacet
facet normal -1 -0 -0
outer loop
vertex 47.5 -55 65.5
vertex 47.5 -52.5 37.5
vertex 47.5 -55 63.5
endloop
endfacet
facet normal -1 0 0
outer loop
vertex 47.5 -56 70.5
vertex 47.5 -55.5 68
vertex 47.5 -53.5 35.5
endloop
endfacet
facet normal -1 -0 0
outer loop
vertex 47.5 -51 83
vertex 47.5 -56.5 83
vertex 47.5 -51 85
endloop
endfacet
facet normal -1 0 0
outer loop
vertex 47.5 8.5 64.5
vertex 47.5 -13.5 92.5
vertex 47.5 -5.5 88.5
endloop
endfacet
facet normal -1 0 0
outer loop
vertex 47.5 19.5 63.5
vertex 47.5 10 73
vertex 47.5 -29.5 112.5
endloop
endfacet
facet normal 0 -0 1
outer loop
vertex 22 -60.5 23.5
vertex 23 -60.5 23.5
vertex 22 60.5 23.5
endloop
endfacet
facet normal 0 1 -0
outer loop
vertex 23 -60.5 23.5
vertex 22 -60.5 23.5
vertex 23 -60.5 144.5
endloop
endfacet
facet normal -1 0 0
outer loop
vertex 47.5 37 29
vertex 47.5 38 29
vertex 47.5 40.5 24.5
endloop
endfacet
facet normal -1 0 -0
outer loop
vertex 47.5 38 29
vertex 47.5 51 29
vertex 47.5 40.5 24.5
endloop
endfacet
facet normal -1 -0 -0
outer loop
vertex 47.5 51 29
vertex 47.5 60.5 23.5
vertex 47.5 40.5 24.5
endloop
endfacet
facet normal -1 0 0
outer loop
vertex 47.5 38 29
vertex 47.5 50 30
vertex 47.5 51 29
endloop
endfacet
facet normal -1 0 0
outer loop
vertex 47.5 51 29
vertex 47.5 60 23.5
vertex 47.5 60.5 23.5
endloop
endfacet
facet normal -1 0 0
outer loop
vertex 47.5 38 29
vertex 47.5 42.5 33.5
vertex 47.5 50 30
endloop
endfacet
facet normal -1 0 0
outer loop
vertex 47.5 37 40
vertex 47.5 40 42.5
vertex 47.5 42.5 33.5
endloop
endfacet
facet normal -1 0 0
outer loop
vertex 47.5 42.5 33.5
vertex 47.5 40 42.5
vertex 47.5 50 30
endloop
endfacet
facet normal -1 -0 -0
outer loop
vertex 47.5 54.5 64.5
vertex 47.5 60.5 23.5
vertex 47.5 60 23.5
endloop
endfacet
facet normal -1 0 -0
outer loop
vertex 47.5 9.5 63.5
vertex 47.5 13.5 67
vertex 47.5 10 63.5
endloop
endfacet
facet normal -1 0 0
outer loop
vertex 47.5 9.5 63.5
vertex 47.5 8.5 64.5
vertex 47.5 13.5 67
endloop
endfacet
facet normal -1 -0 -0
outer loop
vertex 47.5 29.5 55.5
vertex 47.5 38.5 44.5
vertex 47.5 32 52
endloop
endfacet
facet normal -1 0 0
outer loop
vertex 47.5 28 57
vertex 47.5 29.5 55.5
vertex 47.5 32 52
endloop
endfacet
facet normal -1 0 0
outer loop
vertex 47.5 5.5 79.5
vertex 47.5 32 52
vertex 47.5 38.5 44.5
endloop
endfacet
facet normal -1 0 0
outer loop
vertex 47.5 8.5 64.5
vertex 47.5 10 73
vertex 47.5 13.5 67
endloop
endfacet
facet normal -1 0 0
outer loop
vertex 47.5 13.5 67
vertex 47.5 10 73
vertex 47.5 15 67.5
endloop
endfacet
facet normal -1 -0 -0
outer loop
vertex 47.5 5.5 79.5
vertex 47.5 38.5 44.5
vertex 47.5 -8 92.5
endloop
endfacet
facet normal -1 0 0
outer loop
vertex 47.5 19.5 63.5
vertex 47.5 -29.5 112.5
vertex 47.5 38.5 44.5
endloop
endfacet
facet normal -1 0 0
outer loop
vertex 47.5 8.5 64.5
vertex 47.5 -5.5 88.5
vertex 47.5 10 73
endloop
endfacet
facet normal -1 0 0
outer loop
vertex 47.5 38.5 44.5
vertex 47.5 -19.5 104.5
vertex 47.5 -8 92.5
endloop
endfacet
facet normal -1 0 0
outer loop
vertex 47.5 5.5 79.5
vertex 47.5 -6 100.5
vertex 47.5 16 72
endloop
endfacet
facet normal -1 -0 0
outer loop
vertex 47.5 17.5 71
vertex 47.5 17 70.5
vertex 47.5 -6 100.5
endloop
endfacet
facet normal -1 0 0
outer loop
vertex 47.5 16 72
vertex 47.5 -6 100.5
vertex 47.5 17 70.5
endloop
endfacet
facet normal -1 0 0
outer loop
vertex 47.5 60 23.5
vertex 47.5 54 64
vertex 47.5 54.5 64.5
endloop
endfacet
facet normal -1 0 0
outer loop
vertex 47.5 57 76.5
vertex 47.5 59.5 41
vertex 47.5 60 35
endloop
endfacet
facet normal -1 0 0
outer loop
vertex 47.5 57 76.5
vertex 47.5 57 78.5
vertex 47.5 59.5 41
endloop
endfacet
facet normal -1 0 0
outer loop
vertex 47.5 57 83
vertex 47.5 51 83
vertex 47.5 56.5 85
endloop
endfacet
facet normal -0 0 1
outer loop
vertex 22 60.5 23.5
vertex 23 -60.5 23.5
vertex 23 60.5 23.5
endloop
endfacet
facet normal -0 -1 -0
outer loop
vertex 23 60.5 23.5
vertex 22 60.5 144.5
vertex 22 60.5 23.5
endloop
endfacet
facet normal -1 0 -0
outer loop
vertex 47.5 -57 85
vertex 47.5 -51 85
vertex 47.5 -56.5 83
endloop
endfacet
facet normal -1 0 0
outer loop
vertex 47.5 -57 89.5
vertex 47.5 -60.5 138
vertex 47.5 -57 91.5
endloop
endfacet
facet normal -1 -0 0
outer loop
vertex 47.5 -54 104
vertex 47.5 -54.5 103.5
vertex 47.5 -60 144.5
endloop
endfacet
facet normal -1 0 0
outer loop
vertex 47.5 -18 97.5
vertex 47.5 -17.5 98
vertex 47.5 8.5 64.5
endloop
endfacet
facet normal -1 0 0
outer loop
vertex 47.5 8.5 64.5
vertex 47.5 -17.5 98
vertex 47.5 -13.5 92.5
endloop
endfacet
facet normal -1 0 0
outer loop
vertex 47.5 -29.5 112.5
vertex 47.5 -19.5 104.5
vertex 47.5 38.5 44.5
endloop
endfacet
facet normal -1 0 0
outer loop
vertex 47.5 -5.5 88.5
vertex 47.5 -29.5 112.5
vertex 47.5 10 73
endloop
endfacet
facet normal -1 0 0
outer loop
vertex 47.5 -8 92.5
vertex 47.5 -6 100.5
vertex 47.5 5.5 79.5
endloop
endfacet
facet normal -1 0 0
outer loop
vertex 47.5 -14.5 100.5
vertex 47.5 -12.5 100.5
vertex 47.5 -8 92.5
endloop
endfacet
facet normal -1 0 0
outer loop
vertex 47.5 -8 92.5
vertex 47.5 -12.5 100.5
vertex 47.5 -6 100.5
endloop
endfacet
facet normal -1 0 0
outer loop
vertex 47.5 -12.5 100.5
vertex 47.5 -9.5 103.5
vertex 47.5 -6 100.5
endloop
endfacet
facet normal -1 0 0
outer loop
vertex 47.5 -28 111
vertex 47.5 -29.5 112.5
vertex 47.5 -5.5 88.5
endloop
endfacet
facet normal -1 -0 -0
outer loop
vertex 47.5 -19.5 104.5
vertex 47.5 -19.5 104.5
vertex 47.5 -29.5 112.5
endloop
endfacet
facet normal -1 -0 -0
outer loop
vertex 47.5 -38.5 123.5
vertex 47.5 -19.5 104.5
vertex 47.5 -29.5 112.5
endloop
endfacet
facet normal -1 0 0
outer loop
vertex 47.5 -10 104.5
vertex 47.5 -9.5 104.5
vertex 47.5 -9.5 103.5
endloop
endfacet
facet normal -1 -0 -0
outer loop
vertex 47.5 -9.5 104.5
vertex 47.5 -6 100.5
vertex 47.5 -9.5 103.5
endloop
endfacet
facet normal -1 0 0
outer loop
vertex 47.5 -57 91.5
vertex 47.5 -60.5 138
vertex 47.5 -60.5 139.5
endloop
endfacet
facet normal -1 0 0
outer loop
vertex 47.5 -54.5 103.5
vertex 47.5 -60.5 144.5
vertex 47.5 -60 144.5
endloop
endfacet
facet normal -1 0 0
outer loop
vertex 47.5 -47 134.5
vertex 47.5 -49.5 138
vertex 47.5 -42.5 134.5
endloop
endfacet
facet normal -1 0 0
outer loop
vertex 47.5 -47 134.5
vertex 47.5 -42.5 134.5
vertex 47.5 -41 132.5
endloop
endfacet
facet normal -1 -0 0
outer loop
vertex 47.5 -37 138.5
vertex 47.5 -42.5 134.5
vertex 47.5 -49.5 138
endloop
endfacet
facet normal -1 -0 -0
outer loop
vertex 47.5 -60.5 144.5
vertex 47.5 -51 139
vertex 47.5 -60 144.5
endloop
endfacet
facet normal -1 0 0
outer loop
vertex 47.5 -49.5 138
vertex 47.5 -51 139
vertex 47.5 -41 144.5
endloop
endfacet
facet normal -1 0 0
outer loop
vertex 47.5 -51 139
vertex 47.5 -60.5 144.5
vertex 47.5 -41 144.5
endloop
endfacet
facet normal -1 0 0
outer loop
vertex 47.5 -49.5 138
vertex 47.5 -41 144.5
vertex 47.5 -37 138.5
endloop
endfacet
facet normal -1 0 0
outer loop
vertex 47.5 -37 138.5
vertex 47.5 -41 144.5
vertex 47.5 -36.5 138.5
endloop
endfacet
facet normal 0 1 0
outer loop
vertex 22 -60.5 23.5
vertex 22 -60.5 144.5
vertex 23 -60.5 144.5
endloop
endfacet
facet normal 0 0 -1
outer loop
vertex 22 -60.5 144.5
vertex 23 60.5 144.5
vertex 23 -60.5 144.5
endloop
endfacet
facet normal 0 0 -1
outer loop
vertex 22 -60.5 144.5
vertex 22 -42 144.5
vertex 23 60.5 144.5
endloop
endfacet
facet normal -1 0 -0
outer loop
vertex 47.5 51 85
vertex 47.5 56.5 85
vertex 47.5 51 83
endloop
endfacet
facet normal -1 0 0
outer loop
vertex 47.5 55.5 100
vertex 47.5 55.5 102.5
vertex 47.5 56 97.5
endloop
endfacet
facet normal -1 -0 -0
outer loop
vertex 47.5 53 134
vertex 47.5 56 97.5
vertex 47.5 55.5 102.5
endloop
endfacet
facet normal -1 0 0
outer loop
vertex 47.5 44.5 127
vertex 47.5 44 135
vertex 47.5 45 128.5
endloop
endfacet
facet normal -1 -0 0
outer loop
vertex 47.5 45 127.5
vertex 47.5 44.5 127
vertex 47.5 52.5 134
endloop
endfacet
facet normal -1 -0 0
outer loop
vertex 47.5 52.5 134
vertex 47.5 44.5 127
vertex 47.5 45 128.5
endloop
endfacet
facet normal -1 0 0
outer loop
vertex 47.5 45 127.5
vertex 47.5 52.5 134
vertex 47.5 52.5 133.5
endloop
endfacet
facet normal -1 0 0
outer loop
vertex 47.5 44.5 127
vertex 47.5 42 144.5
vertex 47.5 44 135
endloop
endfacet
facet normal -1 0 0
outer loop
vertex 47.5 53 134
vertex 47.5 53.5 134.5
vertex 47.5 56 97.5
endloop
endfacet
facet normal -1 -0 0
outer loop
vertex 47.5 52 139
vertex 47.5 44 135
vertex 47.5 42 144.5
endloop
endfacet
facet normal -1 0 -0
outer loop
vertex 47.5 42 144.5
vertex 47.5 52.5 139
vertex 47.5 52 139
endloop
endfacet
facet normal -1 0 0
outer loop
vertex 47.5 42 144.5
vertex 47.5 52.5 144.5
vertex 47.5 52.5 139
endloop
endfacet
facet normal -1 0 0
outer loop
vertex 47.5 52.5 139
vertex 47.5 52.5 139
vertex 47.5 52.5 144.5
endloop
endfacet
facet normal -1 0 0
outer loop
vertex 47.5 52.5 139
vertex 47.5 52.5 144.5
vertex 47.5 53 139
endloop
endfacet
facet normal 0 -1 0
outer loop
vertex 22 60.5 144.5
vertex 23 60.5 23.5
vertex 23 60.5 144.5
endloop
endfacet
facet normal 0 0 -1
outer loop
vertex 22 -42 144.5
vertex 22 60.5 144.5
vertex 23 60.5 144.5
endloop
endfacet
facet normal 0 0.7 0.7
outer loop
vertex 50 -34 37
vertex 47.5 -34 37
vertex 50 -40 43
endloop
endfacet
facet normal 0 0.7 0.7
outer loop
vertex 47.5 -45.5 48.5
vertex 50 -47 50
vertex 47.5 -41 44
endloop
endfacet
facet normal -0 0.7 0.7
outer loop
vertex 47.5 -40 43
vertex 50 -40 43
vertex 47.5 -34 37
endloop
endfacet
facet normal 0 0.7 0.7
outer loop
vertex 50 -47 50
vertex 50 -41 44
vertex 47.5 -41 44
endloop
endfacet
facet normal -0 0.2 1
outer loop
vertex 47.5 -18 29
vertex 50 -18 29
vertex 47.5 -1 26
endloop
endfacet
facet normal 0 0.2 1
outer loop
vertex 50 -18 29
vertex 50 -1 26
vertex 47.5 -1 26
endloop
endfacet
facet normal -0 0.5 0.9
outer loop
vertex 47.5 -34 37
vertex 50 -34 37
vertex 47.5 -18 29
endloop
endfacet
facet normal 0 0.5 0.9
outer loop
vertex 50 -18 29
vertex 47.5 -18 29
vertex 50 -34 37
endloop
endfacet
facet normal 0 -1 0
outer loop
vertex 47.5 -1 26
vertex 50 -1 26
vertex 47.5 -1 61
endloop
endfacet
facet normal -0 0.9 0.5
outer loop
vertex 47.5 -55 65.5
vertex 50 -55 66
vertex 47.5 -47 50
endloop
endfacet
facet normal -0 0.9 0.5
outer loop
vertex 47.5 -55 65.5
vertex 47.5 -55 66
vertex 50 -55 66
endloop
endfacet
facet normal -0 0.7 0.7
outer loop
vertex 47.5 -46.5 49.5
vertex 50 -47 50
vertex 47.5 -45.5 48.5
endloop
endfacet
facet normal -0 0.7 0.7
outer loop
vertex 47.5 -46.5 49.5
vertex 47.5 -47 50
vertex 50 -47 50
endloop
endfacet
facet normal 0 0.9 0.5
outer loop
vertex 50 -47 50
vertex 47.5 -47 50
vertex 50 -55 66
endloop
endfacet
facet normal 0 1 0.2
outer loop
vertex 50 -55 66
vertex 47.5 -55 66
vertex 50 -58 83
endloop
endfacet
facet normal 0 1 0.2
outer loop
vertex 47.5 -55.5 68
vertex 50 -58 83
vertex 47.5 -55 66
endloop
endfacet
facet normal 0 1 0.2
outer loop
vertex 47.5 -56 70.5
vertex 50 -58 83
vertex 47.5 -55.5 68
endloop
endfacet
facet normal -0 1 0.2
outer loop
vertex 47.5 -56 70.5
vertex 47.5 -58 83
vertex 50 -58 83
endloop
endfacet
facet normal 0 0 -1
outer loop
vertex 50 -58 83
vertex 47.5 -58 83
vertex 50 -23 83
endloop
endfacet
facet normal -0 0 -1
outer loop
vertex 47.5 -56.5 83
vertex 50 -23 83
vertex 47.5 -58 83
endloop
endfacet
facet normal 0 0 -1
outer loop
vertex 47.5 -56.5 83
vertex 47.5 -51 83
vertex 50 -23 83
endloop
endfacet
facet normal 0 0.7 -0.7
outer loop
vertex 50 -40 43
vertex 47.5 -40 43
vertex 50 -15 67.5
endloop
endfacet
facet normal 0 -0.7 0.7
outer loop
vertex 47.5 -41 44
vertex 50 -41 44
vertex 47.5 -16.5 69
endloop
endfacet
facet normal 0 -0.7 0.7
outer loop
vertex 50 -41 44
vertex 50 -16.5 69
vertex 47.5 -16.5 69
endloop
endfacet
facet normal 0 0.7 -0.7
outer loop
vertex 47.5 -15 67.5
vertex 50 -15 67.5
vertex 47.5 -40 43
endloop
endfacet
facet normal 0 -1 0
outer loop
vertex 50 -1 26
vertex 50 -1 61
vertex 47.5 -1 61
endloop
endfacet
facet normal 0 -0.7 -0.7
outer loop
vertex 50 -11.5 64
vertex 47.5 -15 67.5
vertex 47.5 -11.5 64
endloop
endfacet
facet normal -0 -0.3 -1
outer loop
vertex 50 -11.5 64
vertex 47.5 -11.5 64
vertex 50 -1 61
endloop
endfacet
facet normal 0 -0.3 -1
outer loop
vertex 47.5 -1 61
vertex 50 -1 61
vertex 47.5 -11.5 64
endloop
endfacet
facet normal 0 -0.7 -0.7
outer loop
vertex 50 -16.5 69
vertex 47.5 -20 72.5
vertex 47.5 -16.5 69
endloop
endfacet
facet normal -0 -0.7 -0.7
outer loop
vertex 50 -20 72.5
vertex 47.5 -20 72.5
vertex 50 -16.5 69
endloop
endfacet
facet normal 0 0 -1
outer loop
vertex 47.5 -51 83
vertex 47.5 -23 83
vertex 50 -23 83
endloop
endfacet
facet normal 0 -1 -0.3
outer loop
vertex 47.5 -20 72.5
vertex 50 -20 72.5
vertex 47.5 -23 83
endloop
endfacet
facet normal -0 -1 -0.3
outer loop
vertex 50 -23 83
vertex 47.5 -23 83
vertex 50 -20 72.5
endloop
endfacet
facet normal -0 -0.7 -0.7
outer loop
vertex 50 -15 67.5
vertex 47.5 -15 67.5
vertex 50 -11.5 64
endloop
endfacet
facet normal 0 -0.2 1
outer loop
vertex 50 1 26
vertex 47.5 18 29
vertex 47.5 1 26
endloop
endfacet
facet normal 0 -0.2 1
outer loop
vertex 50 1 26
vertex 50 18 29
vertex 47.5 18 29
endloop
endfacet
facet normal 0 1 0
outer loop
vertex 50 1 61
vertex 50 1 26
vertex 47.5 1 26
endloop
endfacet
facet normal 0 -0.5 0.9
outer loop
vertex 47.5 34 37
vertex 47.5 18 29
vertex 50 18 29
endloop
endfacet
facet normal 0 -0.5 0.9
outer loop
vertex 50 18 29
vertex 50 34 37
vertex 47.5 34 37
endloop
endfacet
facet normal 0 -0.7 0.7
outer loop
vertex 47.5 37 40
vertex 47.5 34 37
vertex 50 34 37
endloop
endfacet
facet normal 0 -0.7 0.7
outer loop
vertex 50 40 43
vertex 47.5 40 43
vertex 50 34 37
endloop
endfacet
facet normal -0 -0.7 0.7
outer loop
vertex 47.5 37 40
vertex 50 34 37
vertex 47.5 40 42.5
endloop
endfacet
facet normal 0 -0.7 0.7
outer loop
vertex 47.5 40 42.5
vertex 50 34 37
vertex 47.5 40 43
endloop
endfacet
facet normal 0 -0.7 -0.7
outer loop
vertex 47.5 38.5 44.5
vertex 47.5 40 43
vertex 50 40 43
endloop
endfacet
facet normal 0 -0.7 0.7
outer loop
vertex 50 47 50
vertex 47.5 41 44
vertex 50 41 44
endloop
endfacet
facet normal 0 -0.7 0.7
outer loop
vertex 47.5 41 44
vertex 50 47 50
vertex 47.5 47 50
endloop
endfacet
facet normal -0 1 0
outer loop
vertex 47.5 1 61
vertex 50 1 61
vertex 47.5 1 26
endloop
endfacet
facet normal 0 0.3 -1
outer loop
vertex 50 1 61
vertex 47.5 1 61
vertex 50 11.5 64
endloop
endfacet
facet normal 0 0.3 -1
outer loop
vertex 47.5 9.5 63.5
vertex 50 11.5 64
vertex 47.5 1 61
endloop
endfacet
facet normal 0 0.7 -0.7
outer loop
vertex 50 11.5 64
vertex 47.5 11.5 64
vertex 50 15 67.5
endloop
endfacet
facet normal -0 0.3 -1
outer loop
vertex 47.5 9.5 63.5
vertex 47.5 10 63.5
vertex 50 11.5 64
endloop
endfacet
facet normal 0 0.3 -1
outer loop
vertex 47.5 10 63.5
vertex 47.5 11.5 64
vertex 50 11.5 64
endloop
endfacet
facet normal 0 0.7 0.7
outer loop
vertex 50 41 44
vertex 47.5 41 44
vertex 50 16.5 69
endloop
endfacet
facet normal 0 -0.7 -0.7
outer loop
vertex 47.5 19.5 63.5
vertex 47.5 38.5 44.5
vertex 50 40 43
endloop
endfacet
facet normal 0 0.7 0.7
outer loop
vertex 47.5 29.5 55.5
vertex 50 16.5 69
vertex 47.5 41 44
endloop
endfacet
facet normal -0 -0.7 -0.7
outer loop
vertex 50 15 67.5
vertex 47.5 15 67.5
vertex 50 40 43
endloop
endfacet
facet normal 0 -0.7 -0.7
outer loop
vertex 47.5 19.5 63.5
vertex 50 40 43
vertex 47.5 15 67.5
endloop
endfacet
facet normal 0 0.7 0.7
outer loop
vertex 47.5 28 57
vertex 50 16.5 69
vertex 47.5 29.5 55.5
endloop
endfacet
facet normal -0 0.7 0.7
outer loop
vertex 47.5 28 57
vertex 47.5 16.5 69
vertex 50 16.5 69
endloop
endfacet
facet normal 0 0.7 -0.7
outer loop
vertex 47.5 11.5 64
vertex 47.5 15 67.5
vertex 50 15 67.5
endloop
endfacet
facet normal 0 0.7 -0.7
outer loop
vertex 50 16.5 69
vertex 47.5 16.5 69
vertex 50 20 72.5
endloop
endfacet
facet normal 0 0.7 -0.7
outer loop
vertex 47.5 16.5 69
vertex 47.5 20 72.5
vertex 50 20 72.5
endloop
endfacet
facet normal 0 1 -0.3
outer loop
vertex 50 20 72.5
vertex 47.5 20 72.5
vertex 50 23 83
endloop
endfacet
facet normal 0 1 -0.3
outer loop
vertex 47.5 23 83
vertex 50 23 83
vertex 47.5 20 72.5
endloop
endfacet
facet normal 0 0 -1
outer loop
vertex 50 23 83
vertex 47.5 23 83
vertex 50 58 83
endloop
endfacet
facet normal 0 -0.9 0.5
outer loop
vertex 47.5 54 64
vertex 47.5 47 50
vertex 50 47 50
endloop
endfacet
facet normal 0 -0.9 0.5
outer loop
vertex 47.5 54 64
vertex 50 47 50
vertex 47.5 54.5 64.5
endloop
endfacet
facet normal 0 -0.9 0.5
outer loop
vertex 50 47 50
vertex 50 55 66
vertex 47.5 55 66
endloop
endfacet
facet normal -0 -0.9 0.5
outer loop
vertex 47.5 54.5 64.5
vertex 50 47 50
vertex 47.5 55 66
endloop
endfacet
facet normal 0 -0 -1
outer loop
vertex 47.5 51 83
vertex 50 58 83
vertex 47.5 23 83
endloop
endfacet
facet normal 0 -1 0.2
outer loop
vertex 47.5 57 76.5
vertex 47.5 55 66
vertex 50 55 66
endloop
endfacet
facet normal 0 -1 0.2
outer loop
vertex 47.5 57 76.5
vertex 50 55 66
vertex 47.5 57 78.5
endloop
endfacet
facet normal 0 -1 0.2
outer loop
vertex 50 58 83
vertex 47.5 58 83
vertex 50 55 66
endloop
endfacet
facet normal -0 -1 0.2
outer loop
vertex 47.5 57 78.5
vertex 50 55 66
vertex 47.5 58 83
endloop
endfacet
facet normal 0 0 -1
outer loop
vertex 47.5 51 83
vertex 47.5 57 83
vertex 50 58 83
endloop
endfacet
facet normal 0 0 -1
outer loop
vertex 47.5 57 83
vertex 47.5 58 83
vertex 50 58 83
endloop
endfacet
facet normal -0 0 1
outer loop
vertex 47.5 -57 85
vertex 47.5 -58 85
vertex 50 -58 85
endloop
endfacet
facet normal -0 -0 1
outer loop
vertex 47.5 -57 85
vertex 50 -58 85
vertex 47.5 -51 85
endloop
endfacet
facet normal 0 1 -0.2
outer loop
vertex 50 -58 85
vertex 47.5 -58 85
vertex 50 -55 102
endloop
endfacet
facet normal 0 1 -0.2
outer loop
vertex 47.5 -57 89.5
vertex 50 -55 102
vertex 47.5 -58 85
endloop
endfacet
facet normal 0 1 -0.2
outer loop
vertex 47.5 -57 89.5
vertex 47.5 -57 91.5
vertex 50 -55 102
endloop
endfacet
facet normal 0 1 -0.2
outer loop
vertex 47.5 -57 91.5
vertex 47.5 -55 102
vertex 50 -55 102
endloop
endfacet
facet normal -0 -0 1
outer loop
vertex 47.5 -51 85
vertex 50 -58 85
vertex 47.5 -23 85
endloop
endfacet
facet normal 0 0.9 -0.5
outer loop
vertex 50 -55 102
vertex 47.5 -55 102
vertex 50 -47 118
endloop
endfacet
facet normal -0 0.9 -0.5
outer loop
vertex 47.5 -54.5 103.5
vertex 50 -47 118
vertex 47.5 -55 102
endloop
endfacet
facet normal 0 0.9 -0.5
outer loop
vertex 47.5 -54.5 103.5
vertex 47.5 -54 104
vertex 50 -47 118
endloop
endfacet
facet normal 0 0.9 -0.5
outer loop
vertex 47.5 -54 104
vertex 47.5 -47 118
vertex 50 -47 118
endloop
endfacet
facet normal 0 -0 1
outer loop
vertex 50 -58 85
vertex 50 -23 85
vertex 47.5 -23 85
endloop
endfacet
facet normal 0 -1 0.3
outer loop
vertex 47.5 -23 85
vertex 50 -23 85
vertex 47.5 -20 95.5
endloop
endfacet
facet normal 0 -1 0.3
outer loop
vertex 50 -23 85
vertex 50 -20 95.5
vertex 47.5 -20 95.5
endloop
endfacet
facet normal 0 -0.7 0.7
outer loop
vertex 47.5 -18 97.5
vertex 47.5 -20 95.5
vertex 50 -20 95.5
endloop
endfacet
facet normal -0 -0.7 0.7
outer loop
vertex 47.5 -18 97.5
vertex 50 -20 95.5
vertex 47.5 -17.5 98
endloop
endfacet
facet normal 0 -0.7 0.7
outer loop
vertex 50 -20 95.5
vertex 50 -16.5 99
vertex 47.5 -16.5 99
endloop
endfacet
facet normal -0 -0.7 0.7
outer loop
vertex 47.5 -17.5 98
vertex 50 -20 95.5
vertex 47.5 -16.5 99
endloop
endfacet
facet normal 0 -0.7 0.7
outer loop
vertex 47.5 -11.5 104
vertex 47.5 -15 100.5
vertex 50 -15 100.5
endloop
endfacet
facet normal 0 -0.7 -0.7
outer loop
vertex 47.5 -28 111
vertex 47.5 -16.5 99
vertex 50 -16.5 99
endloop
endfacet
facet normal 0 0.7 0.7
outer loop
vertex 50 -15 100.5
vertex 47.5 -15 100.5
vertex 50 -40 125
endloop
endfacet
facet normal 0 -0.7 -0.7
outer loop
vertex 47.5 -29.5 112.5
vertex 47.5 -28 111
vertex 50 -16.5 99
endloop
endfacet
facet normal 0 0.7 0.7
outer loop
vertex 47.5 -19.5 104.5
vertex 50 -40 125
vertex 47.5 -15 100.5
endloop
endfacet
facet normal -0 -0.7 -0.7
outer loop
vertex 47.5 -29.5 112.5
vertex 50 -16.5 99
vertex 47.5 -41 124
endloop
endfacet
facet normal 0 -0.7 -0.7
outer loop
vertex 47.5 -41 124
vertex 50 -16.5 99
vertex 50 -41 124
endloop
endfacet
facet normal -0 0.7 0.7
outer loop
vertex 47.5 -38.5 123.5
vertex 50 -40 125
vertex 47.5 -19.5 104.5
endloop
endfacet
facet normal 0 -0.7 0.7
outer loop
vertex 47.5 -11.5 104
vertex 50 -15 100.5
vertex 50 -11.5 104
endloop
endfacet
facet normal 0 -0.3 1
outer loop
vertex 47.5 -10 104.5
vertex 47.5 -11.5 104
vertex 50 -11.5 104
endloop
endfacet
facet normal 0 -0.3 1
outer loop
vertex 47.5 -10 104.5
vertex 50 -11.5 104
vertex 47.5 -9.5 104.5
endloop
endfacet
facet normal 0 -0.3 1
outer loop
vertex 50 -11.5 104
vertex 50 -1 107
vertex 47.5 -1 107
endloop
endfacet
facet normal 0 -0.3 1
outer loop
vertex 47.5 -9.5 104.5
vertex 50 -11.5 104
vertex 47.5 -1 107
endloop
endfacet
facet normal 0 -1 0
outer loop
vertex 47.5 -1 107
vertex 50 -1 107
vertex 47.5 -1 142
endloop
endfacet
facet normal 0 0.7 -0.7
outer loop
vertex 47.5 -41 124
vertex 50 -47 118
vertex 47.5 -47 118
endloop
endfacet
facet normal 0 0.7 -0.7
outer loop
vertex 50 -47 118
vertex 47.5 -41 124
vertex 50 -41 124
endloop
endfacet
facet normal -0 0.7 0.7
outer loop
vertex 47.5 -38.5 123.5
vertex 47.5 -40 125
vertex 50 -40 125
endloop
endfacet
facet normal 0 0.7 -0.7
outer loop
vertex 50 -40 125
vertex 47.5 -40 125
vertex 50 -34 131
endloop
endfacet
facet normal 0 0.7 -0.7
outer loop
vertex 47.5 -40 125
vertex 47.5 -34 131
vertex 50 -34 131
endloop
endfacet
facet normal 0 0.5 -0.9
outer loop
vertex 50 -34 131
vertex 47.5 -34 131
vertex 50 -18 139
endloop
endfacet
facet normal 0 0.5 -0.9
outer loop
vertex 47.5 -34 131
vertex 47.5 -18 139
vertex 50 -18 139
endloop
endfacet
facet normal 0 -1 0
outer loop
vertex 50 -1 107
vertex 50 -1 142
vertex 47.5 -1 142
endloop
endfacet
facet normal 0 0.2 -1
outer loop
vertex 50 -18 139
vertex 47.5 -18 139
vertex 50 -1 142
endloop
endfacet
facet normal 0 0.2 -1
outer loop
vertex 47.5 -1 142
vertex 50 -1 142
vertex 47.5 -18 139
endloop
endfacet
facet normal 0 0.7 0.7
outer loop
vertex 50 11.5 104
vertex 50 15 100.5
vertex 47.5 15 100.5
endloop
endfacet
facet normal 0 1 0.3
outer loop
vertex 47.5 20 95.5
vertex 50 23 85
vertex 47.5 23 85
endloop
endfacet
facet normal 0 1 0.3
outer loop
vertex 50 20 95.5
vertex 50 23 85
vertex 47.5 20 95.5
endloop
endfacet
facet normal -0 0 1
outer loop
vertex 47.5 51 85
vertex 47.5 23 85
vertex 50 23 85
endloop
endfacet
facet normal 0 0.7 0.7
outer loop
vertex 50 20 95.5
vertex 47.5 20 95.5
vertex 50 16.5 99
endloop
endfacet
facet normal -0 0.7 0.7
outer loop
vertex 47.5 16.5 99
vertex 50 16.5 99
vertex 47.5 20 95.5
endloop
endfacet
facet normal 0 0.3 1
outer loop
vertex 50 1 107
vertex 50 11.5 104
vertex 47.5 11.5 104
endloop
endfacet
facet normal -0 0.3 1
outer loop
vertex 47.5 1 107
vertex 50 1 107
vertex 47.5 11.5 104
endloop
endfacet
facet normal -0 0.7 0.7
outer loop
vertex 47.5 11.5 104
vertex 50 11.5 104
vertex 47.5 15 100.5
endloop
endfacet
facet normal 0 1 -0
outer loop
vertex 50 1 107
vertex 47.5 1 107
vertex 50 1 142
endloop
endfacet
facet normal 0 0.7 -0.7
outer loop
vertex 50 16.5 99
vertex 47.5 16.5 99
vertex 50 41 124
endloop
endfacet
facet normal 0 -0.7 0.7
outer loop
vertex 47.5 15 100.5
vertex 50 15 100.5
vertex 47.5 40 125
endloop
endfacet
facet normal 0 -0.7 0.7
outer loop
vertex 50 15 100.5
vertex 50 40 125
vertex 47.5 40 125
endloop
endfacet
facet normal 0 0.7 -0.7
outer loop
vertex 47.5 41 124
vertex 50 41 124
vertex 47.5 16.5 99
endloop
endfacet
facet normal 0 -0 1
outer loop
vertex 50 23 85
vertex 50 58 85
vertex 47.5 58 85
endloop
endfacet
facet normal -0 -0 1
outer loop
vertex 47.5 51 85
vertex 50 23 85
vertex 47.5 56.5 85
endloop
endfacet
facet normal -0 -0 1
outer loop
vertex 47.5 56.5 85
vertex 50 23 85
vertex 47.5 58 85
endloop
endfacet
facet normal 0 -1 -0.2
outer loop
vertex 47.5 56 97.5
vertex 47.5 58 85
vertex 50 58 85
endloop
endfacet
facet normal -0 -1 -0.2
outer loop
vertex 50 58 85
vertex 50 55 102
vertex 47.5 55 102
endloop
endfacet
facet normal 0 -1 -0.2
outer loop
vertex 47.5 55.5 100
vertex 47.5 56 97.5
vertex 50 58 85
endloop
endfacet
facet normal 0 -1 -0.2
outer loop
vertex 47.5 55.5 100
vertex 50 58 85
vertex 47.5 55 102
endloop
endfacet
facet normal -0 -0.9 -0.5
outer loop
vertex 50 55 102
vertex 50 47 118
vertex 47.5 47 118
endloop
endfacet
facet normal 0 -0.9 -0.5
outer loop
vertex 47.5 47 118
vertex 47.5 55 102
vertex 50 55 102
endloop
endfacet
facet normal -0 1 0
outer loop
vertex 47.5 1 142
vertex 50 1 142
vertex 47.5 1 107
endloop
endfacet
facet normal -0 -0.5 -0.9
outer loop
vertex 50 18 139
vertex 47.5 18 139
vertex 50 34 131
endloop
endfacet
facet normal 0 -0.5 -0.9
outer loop
vertex 47.5 34 131
vertex 50 34 131
vertex 47.5 18 139
endloop
endfacet
facet normal -0 -0.2 -1
outer loop
vertex 50 1 142
vertex 47.5 1 142
vertex 50 18 139
endloop
endfacet
facet normal 0 -0.2 -1
outer loop
vertex 47.5 18 139
vertex 50 18 139
vertex 47.5 1 142
endloop
endfacet
facet normal -0 -0.7 -0.7
outer loop
vertex 50 41 124
vertex 47.5 41 124
vertex 50 47 118
endloop
endfacet
facet normal 0 -0.7 -0.7
outer loop
vertex 47.5 40 125
vertex 50 40 125
vertex 47.5 34 131
endloop
endfacet
facet normal 0 -0.7 -0.7
outer loop
vertex 47.5 41 124
vertex 47.5 47 118
vertex 50 47 118
endloop
endfacet
facet normal -0 -0.7 -0.7
outer loop
vertex 50 34 131
vertex 47.5 34 131
vertex 50 40 125
endloop
endfacet
facet normal -0.9 0 0.4
outer loop
vertex 40 67 36.5
vertex 41.5 69.5 39
vertex 40 69.5 36.5
endloop
endfacet
facet normal -0.9 0 0.4
outer loop
vertex 40 67 36.5
vertex 41.5 67 39
vertex 41.5 69.5 39
endloop
endfacet
facet normal -0.4 0 0.9
outer loop
vertex 40 67 36.5
vertex 40 69.5 36.5
vertex 37.5 67 35
endloop
endfacet
facet normal -0.4 0 0.9
outer loop
vertex 37.5 67 35
vertex 40 69.5 36.5
vertex 37.5 69.5 35
endloop
endfacet
facet normal -0.9 0 -0.4
outer loop
vertex 41.5 67 39
vertex 40 69.5 41.5
vertex 41.5 69.5 39
endloop
endfacet
facet normal -0.9 0 -0.4
outer loop
vertex 41.5 67 39
vertex 40 67 41.5
vertex 40 69.5 41.5
endloop
endfacet
facet normal -0.4 0 -0.9
outer loop
vertex 40 67 41.5
vertex 37.5 69.5 43
vertex 40 69.5 41.5
endloop
endfacet
facet normal -0.4 0 -0.9
outer loop
vertex 40 67 41.5
vertex 37.5 67 43
vertex 37.5 69.5 43
endloop
endfacet
facet normal 0 -0 1
outer loop
vertex 37.5 67 35
vertex 37.5 69.5 35
vertex 32 67 35
endloop
endfacet
facet normal 0 -0 1
outer loop
vertex 32 67 35
vertex 37.5 69.5 35
vertex 32 69.5 35
endloop
endfacet
facet normal 0 0 -1
outer loop
vertex 37.5 67 43
vertex 32 69.5 43
vertex 37.5 69.5 43
endloop
endfacet
facet normal -0 -0 -1
outer loop
vertex 32 69.5 43
vertex 37.5 67 43
vertex 32 67 43
endloop
endfacet
facet normal 0.4 -0 0.9
outer loop
vertex 31.5 67 35.5
vertex 32 67 35
vertex 32 69.5 35
endloop
endfacet
facet normal 0.4 -0 0.9
outer loop
vertex 31.5 67 35.5
vertex 32 69.5 35
vertex 29.5 65.5 36.5
endloop
endfacet
facet normal 0.4 0 0.9
outer loop
vertex 32 69.5 35
vertex 29.5 69.5 36.5
vertex 29.5 65.5 36.5
endloop
endfacet
facet normal 0.9 -0 0.4
outer loop
vertex 29.5 65.5 36.5
vertex 29.5 69.5 36.5
vertex 28.5 64.5 39
endloop
endfacet
facet normal 0.4 0 -0.9
outer loop
vertex 31.5 67 42.5
vertex 32 69.5 43
vertex 32 67 43
endloop
endfacet
facet normal 0.4 -0 -0.9
outer loop
vertex 31.5 67 42.5
vertex 29.5 69.5 41.5
vertex 32 69.5 43
endloop
endfacet
facet normal 0.4 0 -0.9
outer loop
vertex 31.5 67 42.5
vertex 29.5 65.5 41.5
vertex 29.5 69.5 41.5
endloop
endfacet
facet normal 0.9 0 -0.4
outer loop
vertex 28.5 69.5 39
vertex 29.5 69.5 41.5
vertex 29.5 65.5 41.5
endloop
endfacet
facet normal 0.9 0 0.4
outer loop
vertex 29.5 69.5 36.5
vertex 28.5 69.5 39
vertex 28.5 64.5 39
endloop
endfacet
facet normal 0.9 0 -0.4
outer loop
vertex 28.5 69.5 39
vertex 29.5 65.5 41.5
vertex 28.5 64.5 39
endloop
endfacet
facet normal -0.7 -0.3 0.7
outer loop
vertex -50 -65.5 151
vertex -48 -61.5 155
vertex -50 -61.5 153
endloop
endfacet
facet normal -0.7 -0.3 0.7
outer loop
vertex -50 -65.5 151
vertex -48 -67 152.5
vertex -48 -61.5 155
endloop
endfacet
facet normal -0.7 -0.7 0.3
outer loop
vertex -50 -65.5 151
vertex -50 -67.5 147
vertex -48 -69.5 147
endloop
endfacet
facet normal -0.7 -0.7 0.3
outer loop
vertex -50 -65.5 151
vertex -48 -69.5 147
vertex -48 -67 152.5
endloop
endfacet
facet normal -1 0 -0
outer loop
vertex -50 -65.5 151
vertex -50 -61.5 153
vertex -50 -67.5 147
endloop
endfacet
facet normal -1 0 0
outer loop
vertex -50 -61.5 153
vertex -50 -55 138
vertex -50 -55 135
endloop
endfacet
facet normal -1 0 -0
outer loop
vertex -50 -61.5 153
vertex -50 -52.5 139
vertex -50 -55 138
endloop
endfacet
facet normal -1 0 -0
outer loop
vertex -50 -61.5 153
vertex -50 -18 139
vertex -50 -52.5 139
endloop
endfacet
facet normal -1 0 -0
outer loop
vertex -50 -61.5 153
vertex -50 -55 135
vertex -50 -55 102
endloop
endfacet
facet normal -1 -0 0
outer loop
vertex -50 -52.5 134
vertex -50 -55 102
vertex -50 -55 135
endloop
endfacet
facet normal -1 -0 -0
outer loop
vertex -50 -52.5 139
vertex -50 -34 131
vertex -50 -50 138
endloop
endfacet
facet normal -1 0 0
outer loop
vertex -50 -52.5 134
vertex -50 -50 135
vertex -50 -47 118
endloop
endfacet
facet normal -1 -0 -0
outer loop
vertex -50 -50 138
vertex -50 -41 124
vertex -50 -50 135
endloop
endfacet
facet normal -1 0 -0
outer loop
vertex -50 -50 138
vertex -50 -40 125
vertex -50 -41 124
endloop
endfacet
facet normal -1 0 -0
outer loop
vertex -50 -52.5 139
vertex -50 -18 139
vertex -50 -34 131
endloop
endfacet
facet normal -1 0 -0
outer loop
vertex -50 -50 138
vertex -50 -34 131
vertex -50 -40 125
endloop
endfacet
facet normal -1 0 -0
outer loop
vertex -50 -50 135
vertex -50 -41 124
vertex -50 -47 118
endloop
endfacet
facet normal 0 -0.4 0.9
outer loop
vertex -48 -67 152.5
vertex -22 -67 152.5
vertex -48 -61.5 155
endloop
endfacet
facet normal 0 -0.9 0.4
outer loop
vertex -48 -67 152.5
vertex -48 -69.5 147
vertex -22 -69.5 147
endloop
endfacet
facet normal -0.7 0 0.7
outer loop
vertex -50 -61.5 153
vertex -48 -61.5 155
vertex -48 61.5 155
endloop
endfacet
facet normal -1 0 -0
outer loop
vertex -50 -61.5 153
vertex -50 -1 142
vertex -50 -18 139
endloop
endfacet
facet normal -1 -0 -0
outer loop
vertex -50 -61.5 153
vertex -50 1 142
vertex -50 -1 142
endloop
endfacet
facet normal -1 0 -0
outer loop
vertex -50 -61.5 153
vertex -50 -55 102
vertex -50 -58 85
endloop
endfacet
facet normal -1 -0 0
outer loop
vertex -50 -61.5 153
vertex -50 -67.5 21
vertex -50 -67.5 147
endloop
endfacet
facet normal -0.7 -0.7 0
outer loop
vertex -50 -67.5 147
vertex -48 -69.5 21
vertex -48 -69.5 147
endloop
endfacet
facet normal -1 0 0
outer loop
vertex -50 -61.5 153
vertex -50 -58 85
vertex -50 -58 83
endloop
endfacet
facet normal -1 0 -0
outer loop
vertex -50 -52.5 134
vertex -50 -47 118
vertex -50 -55 102
endloop
endfacet
facet normal -1 0 -0
outer loop
vertex -50 -61.5 153
vertex -50 -58 83
vertex -50 -67.5 21
endloop
endfacet
facet normal -1 0 -0
outer loop
vertex -50 -58 85
vertex -50 -23 85
vertex -50 -58 83
endloop
endfacet
facet normal -1 -0 -0
outer loop
vertex -50 -40 125
vertex -50 -15 100.5
vertex -50 -41 124
endloop
endfacet
facet normal -1 0 -0
outer loop
vertex -50 -41 124
vertex -50 -15 100.5
vertex -50 -16.5 99
endloop
endfacet
facet normal -1 -0 -0
outer loop
vertex -50 -1 142
vertex -50 1 107
vertex -50 -1 107
endloop
endfacet
facet normal -1 0 0
outer loop
vertex -50 -15 100.5
vertex -50 -11.5 104
vertex -50 -1 107
endloop
endfacet
facet normal -1 0 -0
outer loop
vertex -50 -15 100.5
vertex -50 -1 107
vertex -50 -16.5 99
endloop
endfacet
facet normal -1 0 -0
outer loop
vertex -50 -23 85
vertex -50 -20 95.5
vertex -50 -23 83
endloop
endfacet
facet normal -1 -0 0
outer loop
vertex -50 -1 107
vertex -50 -20 95.5
vertex -50 -16.5 99
endloop
endfacet
facet normal -1 -0 0
outer loop
vertex -50 -1 107
vertex -50 -23 83
vertex -50 -20 95.5
endloop
endfacet
facet normal -1 -0 0
outer loop
vertex -50 1 107
vertex -50 -23 83
vertex -50 -1 107
endloop
endfacet
facet normal -1 0 -0
outer loop
vertex -50 1 107
vertex -50 11.5 104
vertex -50 -23 83
endloop
endfacet
facet normal -1 -0 0
outer loop
vertex -50 16.5 99
vertex -50 -20 72.5
vertex -50 -23 83
endloop
endfacet
facet normal 0 -0.9 0.4
outer loop
vertex -48 -67 152.5
vertex -22 -69.5 147
vertex -22 -67 152.5
endloop
endfacet
facet normal 0 -0.4 0.9
outer loop
vertex -48 -61.5 155
vertex -22 -67 152.5
vertex -22 -61.5 155
endloop
endfacet
facet normal 0 0 1
outer loop
vertex -48 -61.5 155
vertex -22 -61.5 155
vertex -22 -51.5 155
endloop
endfacet
facet normal 0 0 1
outer loop
vertex -48 -61.5 155
vertex -22 -51.5 155
vertex -22 -44 155
endloop
endfacet
facet normal 0 -1 0
outer loop
vertex -48 -69.5 147
vertex -22 -69.5 128
vertex -22 -69.5 147
endloop
endfacet
facet normal 0 -0 1
outer loop
vertex -48 -61.5 155
vertex -22 -44 155
vertex -22 -42.5 155
endloop
endfacet
facet normal 0 -0.4 0.9
outer loop
vertex -22 -67 152.5
vertex -22 -61.5 155
vertex -22 -61.5 155
endloop
endfacet
facet normal 0 0 1
outer loop
vertex -22 -61.5 155
vertex -22 -61.5 155
vertex -22 -51.5 155
endloop
endfacet
facet normal 1 -0 -0
outer loop
vertex -22 -60.5 147
vertex -22 -52.5 146
vertex -22 -52.5 147
endloop
endfacet
facet normal 1 0 0
outer loop
vertex -22 -65 145.5
vertex -22 -66.5 141
vertex -22 -66.5 128
endloop
endfacet
facet normal 1 -0 0
outer loop
vertex -22 -60.5 147
vertex -22 -60.5 144.5
vertex -22 -52.5 146
endloop
endfacet
facet normal 1 -0 0
outer loop
vertex -22 -52.5 146
vertex -22 -60.5 144.5
vertex -22 -52 145.5
endloop
endfacet
facet normal 1 -0 0
outer loop
vertex -22 -52 145.5
vertex -22 -60.5 144.5
vertex -22 -51.5 145
endloop
endfacet
facet normal 0 0 1
outer loop
vertex -48 -61.5 155
vertex -22 -42.5 155
vertex -22 42.5 155
endloop
endfacet
facet normal 1 -0 0
outer loop
vertex -22 -42.5 155
vertex -22 -42 154.5
vertex -22 42 154.5
endloop
endfacet
facet normal 1 -0 0
outer loop
vertex -22 -42 154.5
vertex -22 -41.5 154
vertex -22 41.5 154
endloop
endfacet
facet normal 1 -0 0
outer loop
vertex -22 -41.5 154
vertex -22 -41.5 146
vertex -22 41.5 146
endloop
endfacet
facet normal 1 -0 0
outer loop
vertex -22 -51.5 145
vertex -22 -60.5 144.5
vertex -22 60.5 144.5
endloop
endfacet
facet normal 1 -0 0
outer loop
vertex -22 -41.5 146
vertex -22 -42 145.5
vertex -22 42 145.5
endloop
endfacet
facet normal 1 -0 0
outer loop
vertex -22 -42 145.5
vertex -22 -42.5 145
vertex -22 42.5 145
endloop
endfacet
facet normal 1 -0 -0
outer loop
vertex -22 -51.5 145
vertex -22 60.5 144.5
vertex -22 -42.5 145
endloop
endfacet
facet normal 0 -1 0
outer loop
vertex -48 -69.5 147
vertex -22 -69.5 40
vertex -22 -69.5 128
endloop
endfacet
facet normal 1 0 0
outer loop
vertex -22 -60.5 147
vertex -22 -65 145.5
vertex -22 -66.5 40
endloop
endfacet
facet normal 1 -0 0
outer loop
vertex -22 -60.5 147
vertex -22 -66.5 40
vertex -22 -60.5 144.5
endloop
endfacet
facet normal 1 0 0
outer loop
vertex -22 -65 145.5
vertex -22 -66.5 128
vertex -22 -66.5 40
endloop
endfacet
facet normal 1 -0 0
outer loop
vertex -22 -69.5 128
vertex -22 -69.5 40
vertex -22 -66.5 128
endloop
endfacet
facet normal -1 0 -0
outer loop
vertex -50 -61.5 153
vertex -50 67.5 147
vertex -50 1 142
endloop
endfacet
facet normal 0 0 1
outer loop
vertex -48 -61.5 155
vertex -47.5 42.5 155
vertex -47.5 51.5 155
endloop
endfacet
facet normal 0 -0 1
outer loop
vertex -48 -61.5 155
vertex -47.5 51.5 155
vertex -48 61.5 155
endloop
endfacet
facet normal -0.7 0 0.7
outer loop
vertex -50 -61.5 153
vertex -48 61.5 155
vertex -50 61.5 153
endloop
endfacet
facet normal -1 0 0
outer loop
vertex -50 -61.5 153
vertex -50 61.5 153
vertex -50 67.5 147
endloop
endfacet
facet normal -1 -0 0
outer loop
vertex -50 67.5 147
vertex -50 18 139
vertex -50 1 142
endloop
endfacet
facet normal -1 0 0
outer loop
vertex -50 -1 142
vertex -50 1 142
vertex -50 1 107
endloop
endfacet
facet normal 0 -0 1
outer loop
vertex -48 -61.5 155
vertex -22 42.5 155
vertex -47.5 42.5 155
endloop
endfacet
facet normal -1 -0 0
outer loop
vertex -50 67.5 147
vertex -50 52.5 139
vertex -50 18 139
endloop
endfacet
facet normal -0.7 0.3 0.7
outer loop
vertex -50 61.5 153
vertex -48 61.5 155
vertex -50 65.5 151
endloop
endfacet
facet normal -0.7 0.3 0.7
outer loop
vertex -48 61.5 155
vertex -48 67 152.5
vertex -50 65.5 151
endloop
endfacet
facet normal -1 0 0
outer loop
vertex -50 61.5 153
vertex -50 65.5 151
vertex -50 67.5 147
endloop
endfacet
facet normal -0.7 0.7 0.3
outer loop
vertex -50 65.5 151
vertex -48 69.5 147
vertex -50 67.5 147
endloop
endfacet
facet normal -0.7 0.7 0.3
outer loop
vertex -50 65.5 151
vertex -48 67 152.5
vertex -48 69.5 147
endloop
endfacet
facet normal -1 -0 0
outer loop
vertex -50 67.5 147
vertex -50 55 138
vertex -50 52.5 139
endloop
endfacet
facet normal -1 -0 0
outer loop
vertex -50 67.5 147
vertex -50 55 135
vertex -50 55 138
endloop
endfacet
facet normal -1 0 -0
outer loop
vertex -50 18 139
vertex -50 52.5 139
vertex -50 34 131
endloop
endfacet
facet normal -1 0 0
outer loop
vertex -50 40 125
vertex -50 34 131
vertex -50 50 138
endloop
endfacet
facet normal -1 0 -0
outer loop
vertex -50 34 131
vertex -50 52.5 139
vertex -50 50 138
endloop
endfacet
facet normal -1 0 -0
outer loop
vertex -50 50 138
vertex -50 50 135
vertex -50 41 124
endloop
endfacet
facet normal -1 0 -0
outer loop
vertex -50 40 125
vertex -50 50 138
vertex -50 41 124
endloop
endfacet
facet normal -1 0 0
outer loop
vertex -50 47 118
vertex -50 50 135
vertex -50 52.5 134
endloop
endfacet
facet normal -1 0 0
outer loop
vertex -50 47 118
vertex -50 52.5 134
vertex -50 55 135
endloop
endfacet
facet normal -1 0 0
outer loop
vertex -50 47 118
vertex -50 41 124
vertex -50 50 135
endloop
endfacet
facet normal -1 -0 0
outer loop
vertex -50 67.5 147
vertex -50 47 118
vertex -50 55 135
endloop
endfacet
facet normal -1 -0 0
outer loop
vertex -50 67.5 147
vertex -50 55 102
vertex -50 47 118
endloop
endfacet
facet normal 0 -0 1
outer loop
vertex -47.5 51.5 155
vertex -22 61.5 155
vertex -48 61.5 155
endloop
endfacet
facet normal -0 0.4 0.9
outer loop
vertex -48 61.5 155
vertex -22 61.5 155
vertex -48 67 152.5
endloop
endfacet
facet normal 0 0.9 0.4
outer loop
vertex -48 67 152.5
vertex -22 69.5 147
vertex -48 69.5 147
endloop
endfacet
facet normal -1 -0 0
outer loop
vertex -50 41 124
vertex -50 16.5 99
vertex -50 40 125
endloop
endfacet
facet normal -1 0 -0
outer loop
vertex -50 15 100.5
vertex -50 40 125
vertex -50 16.5 99
endloop
endfacet
facet normal -1 0 -0
outer loop
vertex -50 11.5 104
vertex -50 15 100.5
vertex -50 -23 83
endloop
endfacet
facet normal -1 -0 0
outer loop
vertex -50 16.5 99
vertex -50 -23 83
vertex -50 15 100.5
endloop
endfacet
facet normal -1 0 -0
outer loop
vertex -50 16.5 99
vertex -50 20 95.5
vertex -50 15 67.5
endloop
endfacet
facet normal -1 0 -0
outer loop
vertex -50 23 85
vertex -50 58 85
vertex -50 23 83
endloop
endfacet
facet normal -1 -0 0
outer loop
vertex -50 67.5 147
vertex -50 58 85
vertex -50 55 102
endloop
endfacet
facet normal -0.7 0.7 0
outer loop
vertex -50 67.5 147
vertex -48 69.5 147
vertex -48 69.5 21
endloop
endfacet
facet normal -0 1 0
outer loop
vertex -48 69.5 147
vertex -22 69.5 147
vertex -48 69.5 21
endloop
endfacet
facet normal 1 -0 0
outer loop
vertex -22 -42.5 155
vertex -22 42 154.5
vertex -22 42.5 155
endloop
endfacet
facet normal 1 -0 0
outer loop
vertex -22 -42 154.5
vertex -22 41.5 154
vertex -22 42 154.5
endloop
endfacet
facet normal 1 -0 0
outer loop
vertex -22 -41.5 154
vertex -22 41.5 146
vertex -22 41.5 154
endloop
endfacet
facet normal 1 -0 -0
outer loop
vertex -22 -41.5 146
vertex -22 42 145.5
vertex -22 41.5 146
endloop
endfacet
facet normal 1 -0 -0
outer loop
vertex -22 -42 145.5
vertex -22 42.5 145
vertex -22 42 145.5
endloop
endfacet
facet normal 1 -0 -0
outer loop
vertex -22 -42.5 145
vertex -22 60.5 144.5
vertex -22 42.5 145
endloop
endfacet
facet normal 0 0 1
outer loop
vertex -47.5 51.5 155
vertex -22 51.5 155
vertex -22 61.5 155
endloop
endfacet
facet normal 0 0.4 0.9
outer loop
vertex -48 67 152.5
vertex -22 61.5 155
vertex -22 67 152.5
endloop
endfacet
facet normal -0 0.9 0.4
outer loop
vertex -48 67 152.5
vertex -22 67 152.5
vertex -22 69.5 147
endloop
endfacet
facet normal 0 -0 1
outer loop
vertex -22 44 155
vertex -22 44 155
vertex -22 51.5 155
endloop
endfacet
facet normal 1 -0 -0
outer loop
vertex -22 42.5 145
vertex -22 60.5 144.5
vertex -22 51.5 145
endloop
endfacet
facet normal 0 -0 1
outer loop
vertex -22 44 155
vertex -22 61.5 155
vertex -22 51.5 155
endloop
endfacet
facet normal 1 0 -0
outer loop
vertex -22 52.5 147
vertex -22 52.5 146
vertex -22 60.5 147
endloop
endfacet
facet normal 1 0 0
outer loop
vertex -22 60.5 147
vertex -22 52.5 146
vertex -22 52 145.5
endloop
endfacet
facet normal 1 -0 -0
outer loop
vertex -22 51.5 145
vertex -22 60.5 144.5
vertex -22 52 145.5
endloop
endfacet
facet normal 1 0 0
outer loop
vertex -22 60.5 147
vertex -22 52 145.5
vertex -22 60.5 144.5
endloop
endfacet
facet normal 1 -0 0
outer loop
vertex -22 60.5 147
vertex -22 60.5 144.5
vertex -22 65 145.5
endloop
endfacet
facet normal 0 1 0
outer loop
vertex -22 69.5 147
vertex -22 69.5 128
vertex -48 69.5 21
endloop
endfacet
facet normal 1 0 0
outer loop
vertex -22 65 145.5
vertex -22 60.5 144.5
vertex -22 60.5 23.5
endloop
endfacet
facet normal 1 -0 0
outer loop
vertex -22 65 145.5
vertex -22 60.5 23.5
vertex -22 66.5 141
endloop
endfacet
facet normal 1 -0 0
outer loop
vertex -22 66.5 141
vertex -22 60.5 23.5
vertex -22 66.5 128
endloop
endfacet
facet normal 1 -0 0
outer loop
vertex -22 66.5 128
vertex -22 66.5 40
vertex -22 69.5 128
endloop
endfacet
facet normal -0.7 -0.7 -0
outer loop
vertex -50 -67.5 147
vertex -50 -67.5 21
vertex -48 -69.5 21
endloop
endfacet
facet normal -1 0 0
outer loop
vertex -50 -67.5 21
vertex -50 -58 83
vertex -50 -55 66
endloop
endfacet
facet normal 0 -1 0
outer loop
vertex -48 -69.5 147
vertex -48 -69.5 21
vertex -22 -69.5 21
endloop
endfacet
facet normal -1 -0 -0
outer loop
vertex -50 -23 85
vertex -50 -23 83
vertex -50 -58 83
endloop
endfacet
facet normal -1 -0 0
outer loop
vertex -50 16.5 99
vertex -50 -16.5 69
vertex -50 -20 72.5
endloop
endfacet
facet normal -1 0 -0
outer loop
vertex -50 -16.5 69
vertex -50 16.5 99
vertex -50 -15 67.5
endloop
endfacet
facet normal -1 -0 0
outer loop
vertex -50 16.5 99
vertex -50 -11.5 64
vertex -50 -15 67.5
endloop
endfacet
facet normal -1 -0 0
outer loop
vertex -50 -15 67.5
vertex -50 -40 43
vertex -50 -16.5 69
endloop
endfacet
facet normal -1 -0 0
outer loop
vertex -50 -16.5 69
vertex -50 -40 43
vertex -50 -41 44
endloop
endfacet
facet normal -1 0 0
outer loop
vertex -50 -67.5 21
vertex -50 -55 66
vertex -50 -47 50
endloop
endfacet
facet normal -1 0 -0
outer loop
vertex -50 -67.5 21
vertex -50 -47 50
vertex -50 -55 33
endloop
endfacet
facet normal -1 0 -0
outer loop
vertex -50 -47 50
vertex -50 -41 44
vertex -50 -50 33
endloop
endfacet
facet normal -1 -0 0
outer loop
vertex -50 -40 43
vertex -50 -50 33
vertex -50 -41 44
endloop
endfacet
facet normal -1 0 0
outer loop
vertex -50 -47 50
vertex -50 -52.5 34
vertex -50 -55 33
endloop
endfacet
facet normal -1 -0 0
outer loop
vertex -50 -47 50
vertex -50 -50 33
vertex -50 -52.5 34
endloop
endfacet
facet normal -1 -0 0
outer loop
vertex -50 -34 37
vertex -50 -50 30
vertex -50 -50 33
endloop
endfacet
facet normal -1 0 -0
outer loop
vertex -50 -40 43
vertex -50 -34 37
vertex -50 -50 33
endloop
endfacet
facet normal -1 0 0
outer loop
vertex -50 -67.5 21
vertex -50 -55 33
vertex -50 -55 30
endloop
endfacet
facet normal -1 0 0
outer loop
vertex -50 -67.5 21
vertex -50 -55 30
vertex -50 -52.5 29
endloop
endfacet
facet normal -0.7 -0.7 -0.3
outer loop
vertex -50 -67.5 21
vertex -50 -65.5 17
vertex -48 -69.5 21
endloop
endfacet
facet normal -0.7 -0.7 -0.3
outer loop
vertex -48 -69.5 21
vertex -50 -65.5 17
vertex -48 -67 15.5
endloop
endfacet
facet normal -1 -0 -0
outer loop
vertex -50 -67.5 21
vertex -50 -61.5 15
vertex -50 -65.5 17
endloop
endfacet
facet normal -0.7 -0.3 -0.7
outer loop
vertex -50 -65.5 17
vertex -50 -61.5 15
vertex -48 -61.5 13
endloop
endfacet
facet normal -0.7 -0.3 -0.7
outer loop
vertex -50 -65.5 17
vertex -48 -61.5 13
vertex -48 -67 15.5
endloop
endfacet
facet normal -1 0 0
outer loop
vertex -50 -67.5 21
vertex -50 -52.5 29
vertex -50 -18 29
endloop
endfacet
facet normal -1 0 0
outer loop
vertex -50 -52.5 29
vertex -50 -50 30
vertex -50 -18 29
endloop
endfacet
facet normal 0 -0.9 -0.4
outer loop
vertex -48 -69.5 21
vertex -48 -67 15.5
vertex -22 -69.5 21
endloop
endfacet
facet normal 0 -0.4 -0.9
outer loop
vertex -48 -67 15.5
vertex -48 -61.5 13
vertex -22 -67 15.5
endloop
endfacet
facet normal 0 0 -1
outer loop
vertex -48 -61.5 13
vertex -47.5 -51.5 13
vertex -22 -51.5 13
endloop
endfacet
facet normal -1 -0 -0
outer loop
vertex -50 -34 37
vertex -50 -18 29
vertex -50 -50 30
endloop
endfacet
facet normal -1 -0 -0
outer loop
vertex -50 -1 61
vertex -50 1 26
vertex -50 -1 26
endloop
endfacet
facet normal -1 0 0
outer loop
vertex -50 -67.5 21
vertex -50 -18 29
vertex -50 -1 26
endloop
endfacet
facet normal -1 0 0
outer loop
vertex -50 -67.5 21
vertex -50 -1 26
vertex -50 1 26
endloop
endfacet
facet normal -1 0 -0
outer loop
vertex -50 -67.5 21
vertex -50 65.5 17
vertex -50 -61.5 15
endloop
endfacet
facet normal -0.7 -0 -0.7
outer loop
vertex -50 -61.5 15
vertex -48 61.5 13
vertex -48 -61.5 13
endloop
endfacet
facet normal 0 0 -1
outer loop
vertex -48 -61.5 13
vertex -48 61.5 13
vertex -47.5 -51.5 13
endloop
endfacet
facet normal 0 0 -1
outer loop
vertex -47.5 -51.5 13
vertex -48 61.5 13
vertex -47.5 -42.5 13
endloop
endfacet
facet normal -1 0 0
outer loop
vertex -50 -67.5 21
vertex -50 1 26
vertex -50 65.5 17
endloop
endfacet
facet normal 0 0 -1
outer loop
vertex -47.5 -42.5 13
vertex -47.5 51.5 13
vertex -22 -44 13
endloop
endfacet
facet normal 0 -1 0
outer loop
vertex -48 -69.5 147
vertex -22 -69.5 21
vertex -22 -69.5 40
endloop
endfacet
facet normal 1 -0 0
outer loop
vertex -22 -66.5 128
vertex -22 -69.5 40
vertex -22 -66.5 40
endloop
endfacet
facet normal 1 -0 0
outer loop
vertex -22 -66.5 40
vertex -22 -66.5 27
vertex -22 -60.5 144.5
endloop
endfacet
facet normal 1 -0 0
outer loop
vertex -22 -66.5 27
vertex -22 -65 22.5
vertex -22 -60.5 144.5
endloop
endfacet
facet normal 1 0 0
outer loop
vertex -22 -65 22.5
vertex -22 -60.5 23.5
vertex -22 -60.5 144.5
endloop
endfacet
facet normal 0 -0.9 -0.4
outer loop
vertex -48 -67 15.5
vertex -22 -67 15.5
vertex -22 -69.5 21
endloop
endfacet
facet normal 0 -0.4 -0.9
outer loop
vertex -48 -61.5 13
vertex -22 -61.5 13
vertex -22 -67 15.5
endloop
endfacet
facet normal 0 0 -1
outer loop
vertex -48 -61.5 13
vertex -22 -51.5 13
vertex -22 -61.5 13
endloop
endfacet
facet normal 1 -0 0
outer loop
vertex -22 -65 22.5
vertex -22 -60.5 21
vertex -22 -60.5 23.5
endloop
endfacet
facet normal 1 0 0
outer loop
vertex -22 -52 22.5
vertex -22 -60.5 23.5
vertex -22 -60.5 21
endloop
endfacet
facet normal 1 0 -0
outer loop
vertex -22 -52 22.5
vertex -22 -51.5 23
vertex -22 -60.5 23.5
endloop
endfacet
facet normal 1 -0 0
outer loop
vertex -22 -52 22.5
vertex -22 -60.5 21
vertex -22 -52.5 22
endloop
endfacet
facet normal 0 -0.4 -0.9
outer loop
vertex -22 -67 15.5
vertex -22 -61.5 13
vertex -22 -61.5 13
endloop
endfacet
facet normal 1 -0 0
outer loop
vertex -22 -52.5 22
vertex -22 -60.5 21
vertex -22 -52.5 21
endloop
endfacet
facet normal 1 0 -0
outer loop
vertex -22 -51.5 23
vertex -22 -42.5 23
vertex -22 -60.5 23.5
endloop
endfacet
facet normal 1 0 -0
outer loop
vertex -22 -42.5 23
vertex -22 -42 23.5
vertex -22 -60.5 23.5
endloop
endfacet
facet normal 1 -0 -0
outer loop
vertex -22 -42.5 23
vertex -22 -42 22.5
vertex -22 -42 23.5
endloop
endfacet
facet normal 0 0 -1
outer loop
vertex -22 -44 13
vertex -22 -42.5 13
vertex -22 -44 13
endloop
endfacet
facet normal 1 0 -0
outer loop
vertex -22 -42 22.5
vertex -22 42 22.5
vertex -22 -42 23.5
endloop
endfacet
facet normal 1 -0 0
outer loop
vertex -22 -42 22.5
vertex -22 -41.5 22
vertex -22 41.5 22
endloop
endfacet
facet normal 1 -0 0
outer loop
vertex -22 -41.5 22
vertex -22 -41.5 14
vertex -22 41.5 14
endloop
endfacet
facet normal 0 0 -1
outer loop
vertex -22 -44 13
vertex -22 42.5 13
vertex -22 -42.5 13
endloop
endfacet
facet normal 1 0 -0
outer loop
vertex -22 -42.5 13
vertex -22 42 13.5
vertex -22 -42 13.5
endloop
endfacet
facet normal 1 -0 0
outer loop
vertex -22 -41.5 14
vertex -22 -42 13.5
vertex -22 41.5 14
endloop
endfacet
facet normal -1 0 0
outer loop
vertex -50 16.5 99
vertex -50 15 67.5
vertex -50 11.5 64
endloop
endfacet
facet normal -1 -0 0
outer loop
vertex -50 16.5 99
vertex -50 -1 61
vertex -50 -11.5 64
endloop
endfacet
facet normal -1 -0 0
outer loop
vertex -50 16.5 99
vertex -50 1 61
vertex -50 -1 61
endloop
endfacet
facet normal -1 0 0
outer loop
vertex -50 16.5 99
vertex -50 11.5 64
vertex -50 1 61
endloop
endfacet
facet normal -1 0 -0
outer loop
vertex -50 20 95.5
vertex -50 23 85
vertex -50 15 67.5
endloop
endfacet
facet normal -1 0 -0
outer loop
vertex -50 23 85
vertex -50 23 83
vertex -50 15 67.5
endloop
endfacet
facet normal -1 -0 0
outer loop
vertex -50 16.5 69
vertex -50 15 67.5
vertex -50 23 83
endloop
endfacet
facet normal -1 -0 0
outer loop
vertex -50 20 72.5
vertex -50 16.5 69
vertex -50 23 83
endloop
endfacet
facet normal -1 -0 -0
outer loop
vertex -50 1 61
vertex -50 1 26
vertex -50 -1 61
endloop
endfacet
facet normal -1 -0 -0
outer loop
vertex -50 16.5 69
vertex -50 41 44
vertex -50 15 67.5
endloop
endfacet
facet normal -1 0 -0
outer loop
vertex -50 15 67.5
vertex -50 41 44
vertex -50 40 43
endloop
endfacet
facet normal -1 -0 -0
outer loop
vertex -50 58 85
vertex -50 58 83
vertex -50 23 83
endloop
endfacet
facet normal -1 -0 0
outer loop
vertex -50 67.5 147
vertex -50 65.5 17
vertex -50 58 85
endloop
endfacet
facet normal -1 -0 0
outer loop
vertex -50 55 66
vertex -50 52.5 34
vertex -50 47 50
endloop
endfacet
facet normal -1 0 0
outer loop
vertex -50 65.5 17
vertex -50 58 83
vertex -50 58 85
endloop
endfacet
facet normal -0.7 0.7 0
outer loop
vertex -50 67.5 147
vertex -48 69.5 21
vertex -50 67.5 21
endloop
endfacet
facet normal -1 0 -0
outer loop
vertex -50 67.5 147
vertex -50 67.5 21
vertex -50 65.5 17
endloop
endfacet
facet normal -1 0 0
outer loop
vertex -50 65.5 17
vertex -50 55 66
vertex -50 58 83
endloop
endfacet
facet normal 0 1 0
outer loop
vertex -22 69.5 128
vertex -37.5 69.5 43
vertex -40 69.5 41.5
endloop
endfacet
facet normal 0 1 0
outer loop
vertex -22 69.5 128
vertex -40 69.5 41.5
vertex -41.5 69.5 39
endloop
endfacet
facet normal 0 1 0
outer loop
vertex -22 69.5 128
vertex -41.5 69.5 39
vertex -48 69.5 21
endloop
endfacet
facet normal -1 0 0
outer loop
vertex -50 18 29
vertex -50 34 37
vertex -50 50 30
endloop
endfacet
facet normal -1 0 0
outer loop
vertex -50 65.5 17
vertex -50 1 26
vertex -50 18 29
endloop
endfacet
facet normal -0.7 0 -0.7
outer loop
vertex -50 -61.5 15
vertex -50 61.5 15
vertex -48 61.5 13
endloop
endfacet
facet normal -1 0 -0
outer loop
vertex -50 -61.5 15
vertex -50 65.5 17
vertex -50 61.5 15
endloop
endfacet
facet normal 0 0 -1
outer loop
vertex -47.5 -42.5 13
vertex -48 61.5 13
vertex -47.5 51.5 13
endloop
endfacet
facet normal -1 0 0
outer loop
vertex -50 41 44
vertex -50 47 50
vertex -50 50 33
endloop
endfacet
facet normal -1 0 0
outer loop
vertex -50 34 37
vertex -50 40 43
vertex -50 50 30
endloop
endfacet
facet normal -1 -0 -0
outer loop
vertex -50 41 44
vertex -50 50 30
vertex -50 40 43
endloop
endfacet
facet normal -1 0 0
outer loop
vertex -50 41 44
vertex -50 50 33
vertex -50 50 30
endloop
endfacet
facet normal -1 0 -0
outer loop
vertex -50 47 50
vertex -50 52.5 34
vertex -50 50 33
endloop
endfacet
facet normal -1 -0 0
outer loop
vertex -50 55 66
vertex -50 55 33
vertex -50 52.5 34
endloop
endfacet
facet normal -1 0 0
outer loop
vertex -50 65.5 17
vertex -50 55 33
vertex -50 55 66
endloop
endfacet
facet normal -0 1 0
outer loop
vertex -48 69.5 21
vertex -41.5 69.5 39
vertex -40 69.5 36.5
endloop
endfacet
facet normal -0 1 0
outer loop
vertex -48 69.5 21
vertex -40 69.5 36.5
vertex -37.5 69.5 35
endloop
endfacet
facet normal -1 0 0
outer loop
vertex -50 18 29
vertex -50 50 30
vertex -50 52.5 29
endloop
endfacet
facet normal -1 0 0
outer loop
vertex -50 65.5 17
vertex -50 18 29
vertex -50 52.5 29
endloop
endfacet
facet normal -1 0 0
outer loop
vertex -50 65.5 17
vertex -50 55 30
vertex -50 55 33
endloop
endfacet
facet normal -1 0 0
outer loop
vertex -50 65.5 17
vertex -50 52.5 29
vertex -50 55 30
endloop
endfacet
facet normal -0.7 0.7 -0.3
outer loop
vertex -50 67.5 21
vertex -48 69.5 21
vertex -50 65.5 17
endloop
endfacet
facet normal -0.7 0.7 -0.3
outer loop
vertex -48 69.5 21
vertex -48 67 15.5
vertex -50 65.5 17
endloop
endfacet
facet normal -0.7 0.3 -0.7
outer loop
vertex -50 61.5 15
vertex -50 65.5 17
vertex -48 61.5 13
endloop
endfacet
facet normal -0.7 0.3 -0.7
outer loop
vertex -48 61.5 13
vertex -50 65.5 17
vertex -48 67 15.5
endloop
endfacet
facet normal 0 1 0
outer loop
vertex -48 69.5 21
vertex -32 69.5 35
vertex -29.5 69.5 36.5
endloop
endfacet
facet normal 0 1 0
outer loop
vertex -48 69.5 21
vertex -29.5 69.5 36.5
vertex -22 69.5 40
endloop
endfacet
facet normal 0 1 0
outer loop
vertex -48 69.5 21
vertex -37.5 69.5 35
vertex -32 69.5 35
endloop
endfacet
facet normal 0 0 -1
outer loop
vertex -47.5 51.5 13
vertex -48 61.5 13
vertex -22 51.5 13
endloop
endfacet
facet normal 0 0.9 -0.4
outer loop
vertex -48 69.5 21
vertex -22 67 15.5
vertex -48 67 15.5
endloop
endfacet
facet normal 0 0.4 -0.9
outer loop
vertex -48 61.5 13
vertex -48 67 15.5
vertex -22 67 15.5
endloop
endfacet
facet normal 0 1 0
outer loop
vertex -22 69.5 128
vertex -32 69.5 43
vertex -37.5 69.5 43
endloop
endfacet
facet normal 0 1 0
outer loop
vertex -22 69.5 128
vertex -29.5 69.5 41.5
vertex -32 69.5 43
endloop
endfacet
facet normal 0 1 0
outer loop
vertex -22 69.5 128
vertex -28.5 69.5 39
vertex -29.5 69.5 41.5
endloop
endfacet
facet normal 0 1 0
outer loop
vertex -22 69.5 128
vertex -22 69.5 40
vertex -28.5 69.5 39
endloop
endfacet
facet normal 1 -0 0
outer loop
vertex -22 69.5 128
vertex -22 66.5 40
vertex -22 69.5 40
endloop
endfacet
facet normal 1 -0 0
outer loop
vertex -22 66.5 128
vertex -22 60.5 23.5
vertex -22 66.5 40
endloop
endfacet
facet normal 0 0 -1
outer loop
vertex -22 -44 13
vertex -47.5 51.5 13
vertex -22 42.5 13
endloop
endfacet
facet normal 1 0 0
outer loop
vertex -22 42.5 23
vertex -22 -42 23.5
vertex -22 42 22.5
endloop
endfacet
facet normal 1 -0 0
outer loop
vertex -22 -42 22.5
vertex -22 41.5 22
vertex -22 42 22.5
endloop
endfacet
facet normal 1 0 -0
outer loop
vertex -22 42.5 23
vertex -22 51.5 23
vertex -22 -42 23.5
endloop
endfacet
facet normal 1 -0 0
outer loop
vertex -22 -41.5 22
vertex -22 41.5 14
vertex -22 41.5 22
endloop
endfacet
facet normal 1 0 -0
outer loop
vertex -22 -42 13.5
vertex -22 42 13.5
vertex -22 41.5 14
endloop
endfacet
facet normal 1 0 -0
outer loop
vertex -22 -42.5 13
vertex -22 42.5 13
vertex -22 42 13.5
endloop
endfacet
facet normal 1 0 -0
outer loop
vertex -22 51.5 23
vertex -22 60.5 23.5
vertex -22 -42 23.5
endloop
endfacet
facet normal 0 1 -0
outer loop
vertex -22 69.5 40
vertex -29.5 69.5 36.5
vertex -28.5 69.5 39
endloop
endfacet
facet normal -0 1 0
outer loop
vertex -48 69.5 21
vertex -22 69.5 40
vertex -22 69.5 21
endloop
endfacet
facet normal 0 0 -1
outer loop
vertex -48 61.5 13
vertex -22 61.5 13
vertex -22 51.5 13
endloop
endfacet
facet normal 0 0.9 -0.4
outer loop
vertex -48 69.5 21
vertex -22 69.5 21
vertex -22 67 15.5
endloop
endfacet
facet normal 0 0.4 -0.9
outer loop
vertex -48 61.5 13
vertex -22 67 15.5
vertex -22 61.5 13
endloop
endfacet
facet normal 1 -0 0
outer loop
vertex -22 51.5 23
vertex -22 52 22.5
vertex -22 60.5 23.5
endloop
endfacet
facet normal 1 0 0
outer loop
vertex -22 52 22.5
vertex -22 52.5 22
vertex -22 60.5 21
endloop
endfacet
facet normal 1 -0 -0
outer loop
vertex -22 52 22.5
vertex -22 60.5 21
vertex -22 60.5 23.5
endloop
endfacet
facet normal 1 -0 0
outer loop
vertex -22 66.5 40
vertex -22 60.5 21
vertex -22 66.5 27
endloop
endfacet
facet normal 1 0 0
outer loop
vertex -22 66.5 40
vertex -22 60.5 23.5
vertex -22 60.5 21
endloop
endfacet
facet normal 1 -0 0
outer loop
vertex -22 66.5 27
vertex -22 60.5 21
vertex -22 65 22.5
endloop
endfacet
facet normal 1 -0 0
outer loop
vertex -22 52.5 22
vertex -22 52.5 21
vertex -22 60.5 21
endloop
endfacet
facet normal 0 0.4 -0.9
outer loop
vertex -22 61.5 13
vertex -22 67 15.5
vertex -22 61.5 13
endloop
endfacet
facet normal 1 -0 -0
outer loop
vertex -47.5 -65.5 151
vertex -47.5 -52.5 146
vertex -47.5 -61.5 152.5
endloop
endfacet
facet normal 1 -0 0
outer loop
vertex -47.5 -65.5 151
vertex -47.5 -52.5 144
vertex -47.5 -52.5 146
endloop
endfacet
facet normal 1 -0 0
outer loop
vertex -47.5 -61.5 152.5
vertex -47.5 -52.5 146
vertex -47.5 -52.5 152.5
endloop
endfacet
facet normal 1 -0 0
outer loop
vertex -47.5 -65.5 151
vertex -47.5 -55 138
vertex -47.5 -52.5 144
endloop
endfacet
facet normal 1 -0 0
outer loop
vertex -47.5 -52.5 146
vertex -47.5 -52.5 144
vertex -47.5 -52 145.5
endloop
endfacet
facet normal 1 -0 0
outer loop
vertex -47.5 -65.5 151
vertex -47.5 -55 135
vertex -47.5 -55 138
endloop
endfacet
facet normal 1 -0 -0
outer loop
vertex -47.5 -65.5 151
vertex -47.5 -53.5 132.5
vertex -47.5 -55 135
endloop
endfacet
facet normal 1 0 -0
outer loop
vertex -47.5 -53 139
vertex -47.5 -52.5 144
vertex -47.5 -55 138
endloop
endfacet
facet normal 1 0 -0
outer loop
vertex -47.5 -52.5 139
vertex -47.5 -52.5 139
vertex -47.5 -52.5 139
endloop
endfacet
facet normal 1 -0 0
outer loop
vertex -47.5 -52.5 139
vertex -47.5 -52.5 139
vertex -47.5 -52 139
endloop
endfacet
facet normal 1 -0 0
outer loop
vertex -47.5 -52.5 139
vertex -47.5 -52 139
vertex -47.5 -52 139
endloop
endfacet
facet normal 0 0.4 -0.9
outer loop
vertex -47.5 -65.5 151
vertex -47.5 -61.5 152.5
vertex -31.5 -61.5 152.5
endloop
endfacet
facet normal 0 0.9 -0.4
outer loop
vertex -47.5 -65.5 151
vertex -31.5 -67 147
vertex -47.5 -67 147
endloop
endfacet
facet normal 0 0 -1
outer loop
vertex -47.5 -61.5 152.5
vertex -47.5 -52.5 152.5
vertex -31.5 -61.5 152.5
endloop
endfacet
facet normal 1 -0 0
outer loop
vertex -47.5 -52 145.5
vertex -47.5 -52.5 144
vertex -47.5 -51.5 145
endloop
endfacet
facet normal 1 0 0
outer loop
vertex -47.5 -51.5 145
vertex -47.5 -52.5 144
vertex -47.5 -42 143.5
endloop
endfacet
facet normal 1 -0 -0
outer loop
vertex -47.5 -51.5 145
vertex -47.5 -42 143.5
vertex -47.5 -42.5 145
endloop
endfacet
facet normal 1 0 0
outer loop
vertex -47.5 -50 138
vertex -47.5 -52 139
vertex -47.5 -52.5 139
endloop
endfacet
facet normal 1 0 0
outer loop
vertex -47.5 -52 139
vertex -47.5 -50 138
vertex -47.5 -44 135
endloop
endfacet
facet normal 1 0 0
outer loop
vertex -47.5 -42 145.5
vertex -47.5 -42.5 145
vertex -47.5 -42 143.5
endloop
endfacet
facet normal 1 0 -0
outer loop
vertex -47.5 -53.5 132.5
vertex -47.5 -52.5 134
vertex -47.5 -55 135
endloop
endfacet
facet normal 1 0 -0
outer loop
vertex -47.5 -53 132
vertex -47.5 -52.5 134
vertex -47.5 -52.5 134
endloop
endfacet
facet normal 1 0 0
outer loop
vertex -47.5 -53 132
vertex -47.5 -52.5 133.5
vertex -47.5 -52.5 134
endloop
endfacet
facet normal 1 -0 0
outer loop
vertex -47.5 -53.5 132.5
vertex -47.5 -53 132
vertex -47.5 -52.5 134
endloop
endfacet
facet normal 1 -0 0
outer loop
vertex -47.5 -65.5 151
vertex -47.5 -56 97.5
vertex -47.5 -53.5 132.5
endloop
endfacet
facet normal 1 0 0
outer loop
vertex -47.5 -50 138
vertex -47.5 -50 135
vertex -47.5 -44 135
endloop
endfacet
facet normal 1 0 -0
outer loop
vertex -47.5 -52.5 134
vertex -47.5 -44 135
vertex -47.5 -50 135
endloop
endfacet
facet normal 1 -0 0
outer loop
vertex -47.5 -52.5 134
vertex -47.5 -52.5 134
vertex -47.5 -44 135
endloop
endfacet
facet normal 1 -0 0
outer loop
vertex -47.5 -52.5 134
vertex -47.5 -45 128.5
vertex -47.5 -44 135
endloop
endfacet
facet normal 1 -0 0
outer loop
vertex -47.5 -42 143.5
vertex -47.5 -45.5 119.5
vertex -47.5 -34 131
endloop
endfacet
facet normal 1 0 0
outer loop
vertex -47.5 -46.5 118.5
vertex -47.5 -52.5 133.5
vertex -47.5 -52.5 130.5
endloop
endfacet
facet normal 1 0 0
outer loop
vertex -47.5 -46.5 118.5
vertex -47.5 -52.5 130.5
vertex -47.5 -47 118
endloop
endfacet
facet normal 1 -0 0
outer loop
vertex -47.5 -34 131
vertex -47.5 -45.5 119.5
vertex -47.5 -40 125
endloop
endfacet
facet normal 1 0 0
outer loop
vertex -47.5 -45.5 119.5
vertex -47.5 -41 124
vertex -47.5 -40 125
endloop
endfacet
facet normal 0 0.4 -0.9
outer loop
vertex -47.5 -65.5 151
vertex -31.5 -61.5 152.5
vertex -31.5 -65.5 151
endloop
endfacet
facet normal 0 0.9 -0.4
outer loop
vertex -47.5 -65.5 151
vertex -31.5 -65.5 151
vertex -31.5 -67 147
endloop
endfacet
facet normal 0 0 -1
outer loop
vertex -47.5 -52.5 152.5
vertex -31.5 -52.5 152.5
vertex -31.5 -61.5 152.5
endloop
endfacet
facet normal 1 0 0
outer loop
vertex -47.5 -42 145.5
vertex -47.5 -42 143.5
vertex -47.5 -18 139
endloop
endfacet
facet normal 1 -0 0
outer loop
vertex -47.5 -42 143.5
vertex -47.5 -34 131
vertex -47.5 -18 139
endloop
endfacet
facet normal 1 -0 0
outer loop
vertex -47.5 -42 145.5
vertex -47.5 -18 139
vertex -47.5 -1 142
endloop
endfacet
facet normal 1 -0 0
outer loop
vertex -47.5 -41.5 152.5
vertex -47.5 -41.5 146
vertex -47.5 41.5 146
endloop
endfacet
facet normal 1 -0 0
outer loop
vertex -47.5 -41.5 146
vertex -47.5 -42 145.5
vertex -47.5 42 145.5
endloop
endfacet
facet normal 1 -0 0
outer loop
vertex -47.5 -42 145.5
vertex -47.5 -1 142
vertex -47.5 42 145.5
endloop
endfacet
facet normal 0 0 -1
outer loop
vertex -47.5 -41.5 152.5
vertex -47.5 41.5 152.5
vertex -31.5 -41.5 152.5
endloop
endfacet
facet normal 1 -0 0
outer loop
vertex -47.5 -65.5 151
vertex -47.5 -58 85
vertex -47.5 -56 97.5
endloop
endfacet
facet normal 1 0 0
outer loop
vertex -47.5 -65.5 151
vertex -47.5 -67 147
vertex -47.5 -67 21
endloop
endfacet
facet normal 1 0 0
outer loop
vertex -47.5 -55 102.5
vertex -47.5 -55 104.5
vertex -47.5 -55 102
endloop
endfacet
facet normal 1 0 0
outer loop
vertex -47.5 -55.5 100
vertex -47.5 -55 102
vertex -47.5 -55 104.5
endloop
endfacet
facet normal -0 1 0
outer loop
vertex -47.5 -67 147
vertex -31.5 -67 147
vertex -47.5 -67 21
endloop
endfacet
facet normal 1 0 -0
outer loop
vertex -47.5 -55 102.5
vertex -47.5 -47 118
vertex -47.5 -52.5 130.5
endloop
endfacet
facet normal 1 0 -0
outer loop
vertex -47.5 -57 83
vertex -47.5 -56.5 85
vertex -47.5 -58 85
endloop
endfacet
facet normal 1 0 0
outer loop
vertex -47.5 -40 125
vertex -47.5 -41 124
vertex -47.5 -15 100.5
endloop
endfacet
facet normal 1 -0 0
outer loop
vertex -47.5 -41 124
vertex -47.5 -16.5 99
vertex -47.5 -15 100.5
endloop
endfacet
facet normal 1 -0 0
outer loop
vertex -47.5 -1 142
vertex -47.5 -1 107
vertex -47.5 1 107
endloop
endfacet
facet normal 1 0 -0
outer loop
vertex -47.5 -15 100.5
vertex -47.5 8.5 103.5
vertex -47.5 -11.5 104
endloop
endfacet
facet normal 1 0 0
outer loop
vertex -47.5 1 107
vertex -47.5 -1 107
vertex -47.5 -11.5 104
endloop
endfacet
facet normal 1 0 0
outer loop
vertex -47.5 1 107
vertex -47.5 -11.5 104
vertex -47.5 8.5 103.5
endloop
endfacet
facet normal 1 -0 0
outer loop
vertex -47.5 -51 85
vertex -47.5 -23 83
vertex -47.5 -23 85
endloop
endfacet
facet normal 1 0 -0
outer loop
vertex -47.5 -20 95.5
vertex -47.5 8.5 103.5
vertex -47.5 -16.5 99
endloop
endfacet
facet normal 1 0 -0
outer loop
vertex -47.5 -23 85
vertex -47.5 8.5 103.5
vertex -47.5 -20 95.5
endloop
endfacet
facet normal 1 -0 0
outer loop
vertex -47.5 -15 100.5
vertex -47.5 -16.5 99
vertex -47.5 8.5 103.5
endloop
endfacet
facet normal 1 -0 0
outer loop
vertex -47.5 -23 85
vertex -47.5 -23 83
vertex -47.5 8.5 103.5
endloop
endfacet
facet normal 1 0 0
outer loop
vertex -47.5 8.5 103.5
vertex -47.5 -23 83
vertex -47.5 -20 72.5
endloop
endfacet
facet normal -0.7 0.3 -0.7
outer loop
vertex -31.5 -65.5 151
vertex -31.5 -61.5 152.5
vertex -23 -60.5 144.5
endloop
endfacet
facet normal -0.7 0.7 -0.3
outer loop
vertex -31.5 -65.5 151
vertex -23 -60.5 144.5
vertex -31.5 -67 147
endloop
endfacet
facet normal -0.7 0 -0.7
outer loop
vertex -31.5 -61.5 152.5
vertex -31.5 -52.5 152.5
vertex -23 -60.5 144.5
endloop
endfacet
facet normal -0.7 0 -0.7
outer loop
vertex -31.5 -52.5 152.5
vertex -24.5 -52.5 146
vertex -23 -60.5 144.5
endloop
endfacet
facet normal -0.7 -0 -0.7
outer loop
vertex -24.5 -52.5 146
vertex -24 -52 145.5
vertex -23 -60.5 144.5
endloop
endfacet
facet normal -0.7 0 -0.7
outer loop
vertex -24 -52 145.5
vertex -23.5 -51.5 145
vertex -23 -60.5 144.5
endloop
endfacet
facet normal -0.7 0 -0.7
outer loop
vertex -31.5 -41.5 152.5
vertex -31.5 41.5 152.5
vertex -24.5 -41.5 146
endloop
endfacet
facet normal -0.7 0 -0.7
outer loop
vertex -24.5 -41.5 146
vertex -24.5 41.5 146
vertex -24 -42 145.5
endloop
endfacet
facet normal -0.7 -0 -0.7
outer loop
vertex -23.5 -51.5 145
vertex -23 60.5 144.5
vertex -23 -60.5 144.5
endloop
endfacet
facet normal -0.7 0 -0.7
outer loop
vertex -23.5 -51.5 145
vertex -23.5 -42.5 145
vertex -23 60.5 144.5
endloop
endfacet
facet normal -0.7 -0 -0.7
outer loop
vertex -24 -42 145.5
vertex -23 60.5 144.5
vertex -23.5 -42.5 145
endloop
endfacet
facet normal -0.6 0.8 0
outer loop
vertex -31.5 -67 147
vertex -23 -60.5 144.5
vertex -31.5 -67 21
endloop
endfacet
facet normal 1 -0 0
outer loop
vertex -47.5 -41.5 152.5
vertex -47.5 41.5 146
vertex -47.5 41.5 152.5
endloop
endfacet
facet normal 1 -0 -0
outer loop
vertex -47.5 -41.5 146
vertex -47.5 42 145.5
vertex -47.5 41.5 146
endloop
endfacet
facet normal 1 -0 0
outer loop
vertex -47.5 42 145.5
vertex -47.5 -1 142
vertex -47.5 1 142
endloop
endfacet
facet normal 1 0 0
outer loop
vertex -47.5 42 145.5
vertex -47.5 1 142
vertex -47.5 18 139
endloop
endfacet
facet normal 1 -0 0
outer loop
vertex -47.5 42 145.5
vertex -47.5 18 139
vertex -47.5 40.5 143.5
endloop
endfacet
facet normal 1 -0 0
outer loop
vertex -47.5 18 139
vertex -47.5 37 139
vertex -47.5 40.5 143.5
endloop
endfacet
facet normal 1 -0 0
outer loop
vertex -47.5 -1 142
vertex -47.5 1 107
vertex -47.5 1 142
endloop
endfacet
facet normal 1 0 -0
outer loop
vertex -47.5 34 131
vertex -47.5 37 139
vertex -47.5 18 139
endloop
endfacet
facet normal 0 0 -1
outer loop
vertex -31.5 -41.5 152.5
vertex -47.5 41.5 152.5
vertex -31.5 41.5 152.5
endloop
endfacet
facet normal 1 -0 0
outer loop
vertex -47.5 42 145.5
vertex -47.5 40.5 143.5
vertex -47.5 42.5 145
endloop
endfacet
facet normal 1 -0 0
outer loop
vertex -47.5 42.5 145
vertex -47.5 40.5 143.5
vertex -47.5 60.5 144.5
endloop
endfacet
facet normal 1 -0 -0
outer loop
vertex -47.5 42.5 145
vertex -47.5 60.5 144.5
vertex -47.5 51.5 145
endloop
endfacet
facet normal 1 -0 0
outer loop
vertex -47.5 51 139
vertex -47.5 50 138
vertex -47.5 52.5 139
endloop
endfacet
facet normal 1 0 0
outer loop
vertex -47.5 51 139
vertex -47.5 50 138
vertex -47.5 50 138
endloop
endfacet
facet normal 1 -0 0
outer loop
vertex -47.5 52.5 152.5
vertex -47.5 52.5 146
vertex -47.5 61.5 152.5
endloop
endfacet
facet normal 1 0 0
outer loop
vertex -47.5 61.5 152.5
vertex -47.5 52.5 146
vertex -47.5 52 145.5
endloop
endfacet
facet normal 1 0 0
outer loop
vertex -47.5 61.5 152.5
vertex -47.5 52 145.5
vertex -47.5 60.5 144.5
endloop
endfacet
facet normal 1 -0 -0
outer loop
vertex -47.5 61.5 152.5
vertex -47.5 67 147
vertex -47.5 65.5 151
endloop
endfacet
facet normal 1 -0 -0
outer loop
vertex -47.5 51.5 145
vertex -47.5 60.5 144.5
vertex -47.5 52 145.5
endloop
endfacet
facet normal 1 0 0
outer loop
vertex -47.5 61.5 152.5
vertex -47.5 60.5 144.5
vertex -47.5 60 133
endloop
endfacet
facet normal 1 -0 0
outer loop
vertex -47.5 51 139
vertex -47.5 52.5 139
vertex -47.5 60 144.5
endloop
endfacet
facet normal 1 -0 0
outer loop
vertex -47.5 52.5 139
vertex -47.5 55 138
vertex -47.5 60 144.5
endloop
endfacet
facet normal 1 0 -0
outer loop
vertex -47.5 55 135
vertex -47.5 60 144.5
vertex -47.5 55 138
endloop
endfacet
facet normal 1 0 0
outer loop
vertex -47.5 61.5 152.5
vertex -47.5 60 133
vertex -47.5 59.5 127
endloop
endfacet
facet normal 0 0 -1
outer loop
vertex -47.5 52.5 152.5
vertex -47.5 61.5 152.5
vertex -31.5 52.5 152.5
endloop
endfacet
facet normal 0 -0.4 -0.9
outer loop
vertex -47.5 61.5 152.5
vertex -47.5 65.5 151
vertex -31.5 65.5 151
endloop
endfacet
facet normal 0 -0.9 -0.4
outer loop
vertex -47.5 65.5 151
vertex -47.5 67 147
vertex -31.5 65.5 151
endloop
endfacet
facet normal 1 -0 0
outer loop
vertex -47.5 37 139
vertex -47.5 34 131
vertex -47.5 38 139
endloop
endfacet
facet normal 1 -0 0
outer loop
vertex -47.5 38 139
vertex -47.5 34 131
vertex -47.5 42.5 134.5
endloop
endfacet
facet normal 1 0 -0
outer loop
vertex -47.5 37 128
vertex -47.5 42.5 134.5
vertex -47.5 34 131
endloop
endfacet
facet normal 1 0 -0
outer loop
vertex -47.5 40 125
vertex -47.5 50 135
vertex -47.5 40 125.5
endloop
endfacet
facet normal 1 0 0
outer loop
vertex -47.5 50 138
vertex -47.5 50 138
vertex -47.5 50 135
endloop
endfacet
facet normal 1 -0 0
outer loop
vertex -47.5 50 138
vertex -47.5 40 125.5
vertex -47.5 50 135
endloop
endfacet
facet normal 1 -0 0
outer loop
vertex -47.5 50 135
vertex -47.5 41 124
vertex -47.5 52.5 134
endloop
endfacet
facet normal 1 0 -0
outer loop
vertex -47.5 38.5 123.5
vertex -47.5 41 124
vertex -47.5 40 125
endloop
endfacet
facet normal 1 0 -0
outer loop
vertex -47.5 29.5 112.5
vertex -47.5 41 124
vertex -47.5 38.5 123.5
endloop
endfacet
facet normal 1 -0 0
outer loop
vertex -47.5 40 125
vertex -47.5 41 124
vertex -47.5 50 135
endloop
endfacet
facet normal 1 0 0
outer loop
vertex -47.5 52.5 134
vertex -47.5 41 124
vertex -47.5 47 118
endloop
endfacet
facet normal 1 -0 0
outer loop
vertex -47.5 55 135
vertex -47.5 54 104
vertex -47.5 60 144.5
endloop
endfacet
facet normal 1 -0 0
outer loop
vertex -47.5 52.5 134
vertex -47.5 54 104
vertex -47.5 55 135
endloop
endfacet
facet normal 1 0 -0
outer loop
vertex -47.5 60 133
vertex -47.5 60.5 144.5
vertex -47.5 54.5 103.5
endloop
endfacet
facet normal 1 0 0
outer loop
vertex -47.5 61.5 152.5
vertex -47.5 59.5 127
vertex -47.5 58 83
endloop
endfacet
facet normal 0 0 -1
outer loop
vertex -47.5 61.5 152.5
vertex -31.5 61.5 152.5
vertex -31.5 52.5 152.5
endloop
endfacet
facet normal 0 -0.4 -0.9
outer loop
vertex -47.5 61.5 152.5
vertex -31.5 65.5 151
vertex -31.5 61.5 152.5
endloop
endfacet
facet normal 0 -0.9 -0.4
outer loop
vertex -47.5 67 147
vertex -31.5 67 147
vertex -31.5 65.5 151
endloop
endfacet
facet normal 1 0 0
outer loop
vertex -47.5 9.5 104.5
vertex -47.5 1 107
vertex -47.5 8.5 103.5
endloop
endfacet
facet normal 1 -0 -0
outer loop
vertex -47.5 10 104.5
vertex -47.5 13.5 101
vertex -47.5 11.5 104
endloop
endfacet
facet normal 1 -0 -0
outer loop
vertex -47.5 13.5 101
vertex -47.5 15 100.5
vertex -47.5 11.5 104
endloop
endfacet
facet normal 1 0 -0
outer loop
vertex -47.5 28 111
vertex -47.5 32 116
vertex -47.5 16.5 99
endloop
endfacet
facet normal 1 0 0
outer loop
vertex -47.5 11.5 104
vertex -47.5 15 100.5
vertex -47.5 15 100.5
endloop
endfacet
facet normal 1 0 0
outer loop
vertex -47.5 19.5 104.5
vertex -47.5 15 100.5
vertex -47.5 10 95
endloop
endfacet
facet normal 1 -0 0
outer loop
vertex -47.5 15 100.5
vertex -47.5 10 95
vertex -47.5 15 100.5
endloop
endfacet
facet normal 1 -0 0
outer loop
vertex -47.5 16.5 99
vertex -47.5 16 96
vertex -47.5 17 97.5
endloop
endfacet
facet normal 1 0 0
outer loop
vertex -47.5 5.5 88.5
vertex -47.5 16 96
vertex -47.5 16.5 99
endloop
endfacet
facet normal 1 0 0
outer loop
vertex -47.5 20 95.5
vertex -47.5 17.5 97
vertex -47.5 -6 67.5
endloop
endfacet
facet normal 1 0 0
outer loop
vertex -47.5 5.5 88.5
vertex -47.5 16.5 99
vertex -47.5 32 116
endloop
endfacet
facet normal 1 -0 -0
outer loop
vertex -47.5 17 97.5
vertex -47.5 20 95.5
vertex -47.5 16.5 99
endloop
endfacet
facet normal 1 0 0
outer loop
vertex -47.5 17 97.5
vertex -47.5 17.5 97
vertex -47.5 20 95.5
endloop
endfacet
facet normal 1 0 0
outer loop
vertex -47.5 54 104
vertex -47.5 52.5 134
vertex -47.5 47 118
endloop
endfacet
facet normal 1 -0 0
outer loop
vertex -47.5 54.5 103.5
vertex -47.5 55 102
vertex -47.5 60 133
endloop
endfacet
facet normal 1 0 -0
outer loop
vertex -47.5 57 91.5
vertex -47.5 60 133
vertex -47.5 55 102
endloop
endfacet
facet normal 1 -0 0
outer loop
vertex -47.5 61.5 152.5
vertex -47.5 65.5 17
vertex -47.5 67 147
endloop
endfacet
facet normal 0 -1 0
outer loop
vertex -47.5 67 147
vertex -47.5 67 21
vertex -31.5 67 147
endloop
endfacet
facet normal 1 0 -0
outer loop
vertex -47.5 51 83
vertex -47.5 51 85
vertex -47.5 23 85
endloop
endfacet
facet normal 1 -0 0
outer loop
vertex -47.5 57 89.5
vertex -47.5 58 85
vertex -47.5 59.5 127
endloop
endfacet
facet normal 1 0 0
outer loop
vertex -47.5 59.5 127
vertex -47.5 58 85
vertex -47.5 58 83
endloop
endfacet
facet normal 1 -0 0
outer loop
vertex -47.5 57 85
vertex -47.5 58 83
vertex -47.5 58 85
endloop
endfacet
facet normal 1 0 0
outer loop
vertex -47.5 61.5 152.5
vertex -47.5 58 83
vertex -47.5 65.5 17
endloop
endfacet
facet normal -0.7 0 -0.7
outer loop
vertex -24.5 -41.5 146
vertex -31.5 41.5 152.5
vertex -24.5 41.5 146
endloop
endfacet
facet normal -0.7 0 -0.7
outer loop
vertex -24 -42 145.5
vertex -24.5 41.5 146
vertex -24 42 145.5
endloop
endfacet
facet normal -0.7 0 -0.7
outer loop
vertex -24 -42 145.5
vertex -24 42 145.5
vertex -23.5 42.5 145
endloop
endfacet
facet normal -0.7 0 -0.7
outer loop
vertex -24 -42 145.5
vertex -23.5 42.5 145
vertex -23 60.5 144.5
endloop
endfacet
facet normal -0.7 0 -0.7
outer loop
vertex -31.5 52.5 152.5
vertex -31.5 61.5 152.5
vertex -24.5 52.5 146
endloop
endfacet
facet normal -0.7 -0 -0.7
outer loop
vertex -31.5 61.5 152.5
vertex -23 60.5 144.5
vertex -24.5 52.5 146
endloop
endfacet
facet normal -0.7 -0.3 -0.7
outer loop
vertex -31.5 61.5 152.5
vertex -31.5 65.5 151
vertex -23 60.5 144.5
endloop
endfacet
facet normal -0.7 -0.7 -0.3
outer loop
vertex -31.5 65.5 151
vertex -31.5 67 147
vertex -23 60.5 144.5
endloop
endfacet
facet normal -0.7 0 -0.7
outer loop
vertex -23.5 42.5 145
vertex -23.5 51.5 145
vertex -23 60.5 144.5
endloop
endfacet
facet normal -0.7 0 -0.7
outer loop
vertex -24.5 52.5 146
vertex -23 60.5 144.5
vertex -24 52 145.5
endloop
endfacet
facet normal -0.7 -0 -0.7
outer loop
vertex -23.5 51.5 145
vertex -24 52 145.5
vertex -23 60.5 144.5
endloop
endfacet
facet normal -0.6 -0.8 0
outer loop
vertex -31.5 67 147
vertex -23 60.5 23.5
vertex -23 60.5 144.5
endloop
endfacet
facet normal 1 -0 0
outer loop
vertex -47.5 -65.5 151
vertex -47.5 -61.5 15.5
vertex -47.5 -58 85
endloop
endfacet
facet normal 1 0 0
outer loop
vertex -47.5 -57 83
vertex -47.5 -58 85
vertex -47.5 -58 83
endloop
endfacet
facet normal 1 -0 0
outer loop
vertex -47.5 -51 85
vertex -47.5 -51 83
vertex -47.5 -23 83
endloop
endfacet
facet normal 1 0 0
outer loop
vertex -47.5 -65.5 151
vertex -47.5 -67 21
vertex -47.5 -61.5 15.5
endloop
endfacet
facet normal 1 -0 0
outer loop
vertex -47.5 -58 85
vertex -47.5 -60.5 30
vertex -47.5 -58 83
endloop
endfacet
facet normal 1 0 0
outer loop
vertex -47.5 -57 78.5
vertex -47.5 -58 83
vertex -47.5 -60.5 30
endloop
endfacet
facet normal 1 -0 0
outer loop
vertex -47.5 -57 76.5
vertex -47.5 -60.5 28.5
vertex -47.5 -55 66
endloop
endfacet
facet normal 1 0 0
outer loop
vertex -47.5 -54.5 64.5
vertex -47.5 -55 66
vertex -47.5 -60.5 28.5
endloop
endfacet
facet normal 0 1 0
outer loop
vertex -31.5 -67 147
vertex -31.5 -67 21
vertex -47.5 -67 21
endloop
endfacet
facet normal 1 0 -0
outer loop
vertex -47.5 -18 70.5
vertex -47.5 8.5 103.5
vertex -47.5 -20 72.5
endloop
endfacet
facet normal 1 -0 0
outer loop
vertex -47.5 -17.5 70
vertex -47.5 -16.5 69
vertex -47.5 -5.5 79.5
endloop
endfacet
facet normal 1 0 -0
outer loop
vertex -47.5 -17.5 70
vertex -47.5 -5.5 79.5
vertex -47.5 -13.5 75.5
endloop
endfacet
facet normal 1 0 -0
outer loop
vertex -47.5 -28 57
vertex -47.5 -5.5 79.5
vertex -47.5 -16.5 69
endloop
endfacet
facet normal 1 0 0
outer loop
vertex -47.5 -19.5 63.5
vertex -47.5 -15 67.5
vertex -47.5 -8 75.5
endloop
endfacet
facet normal 1 0 0
outer loop
vertex -47.5 -11.5 64
vertex -47.5 -14.5 67.5
vertex -47.5 -15 67.5
endloop
endfacet
facet normal 1 -0 0
outer loop
vertex -47.5 -8 75.5
vertex -47.5 -15 67.5
vertex -47.5 -14.5 67.5
endloop
endfacet
facet normal 1 -0 -0
outer loop
vertex -47.5 -14.5 67.5
vertex -47.5 -11.5 64
vertex -47.5 -12.5 67.5
endloop
endfacet
facet normal 1 0 -0
outer loop
vertex -47.5 -19.5 63.5
vertex -47.5 -15 67.5
vertex -47.5 -19.5 63.5
endloop
endfacet
facet normal 1 -0 0
outer loop
vertex -47.5 -12.5 67.5
vertex -47.5 -11.5 64
vertex -47.5 -9.5 64.5
endloop
endfacet
facet normal 1 0 -0
outer loop
vertex -47.5 -10 63.5
vertex -47.5 -9.5 64.5
vertex -47.5 -11.5 64
endloop
endfacet
facet normal 1 -0 -0
outer loop
vertex -47.5 -9.5 63.5
vertex -47.5 -1 61
vertex -47.5 -6 67.5
endloop
endfacet
facet normal 1 -0 0
outer loop
vertex -47.5 -54 64
vertex -47.5 -60 23.5
vertex -47.5 -47 50
endloop
endfacet
facet normal 1 0 0
outer loop
vertex -47.5 -61.5 15.5
vertex -47.5 -60.5 30
vertex -47.5 -58 85
endloop
endfacet
facet normal 1 -0 0
outer loop
vertex -47.5 -60.5 28.5
vertex -47.5 -60.5 23.5
vertex -47.5 -54.5 64.5
endloop
endfacet
facet normal 1 -0 0
outer loop
vertex -47.5 -47 50
vertex -47.5 -60 23.5
vertex -47.5 -55 33
endloop
endfacet
facet normal 1 0 -0
outer loop
vertex -47.5 -47 33.5
vertex -47.5 -41 44
vertex -47.5 -47 50
endloop
endfacet
facet normal 1 0 -0
outer loop
vertex -47.5 -38.5 44.5
vertex -47.5 -29.5 55.5
vertex -47.5 -41 44
endloop
endfacet
facet normal 1 0 0
outer loop
vertex -47.5 -38.5 44.5
vertex -47.5 -41 44
vertex -47.5 -40 43
endloop
endfacet
facet normal 1 0 -0
outer loop
vertex -47.5 -47 33.5
vertex -47.5 -40 43
vertex -47.5 -41 44
endloop
endfacet
facet normal 1 -0 0
outer loop
vertex -47.5 -47 50
vertex -47.5 -55 33
vertex -47.5 -52.5 34
endloop
endfacet
facet normal 1 0 0
outer loop
vertex -47.5 -47 50
vertex -47.5 -52.5 34
vertex -47.5 -50 33
endloop
endfacet
facet normal 1 0 -0
outer loop
vertex -47.5 -47 33.5
vertex -47.5 -47 50
vertex -47.5 -50 33
endloop
endfacet
facet normal 1 0 0
outer loop
vertex -47.5 -50 33
vertex -47.5 -50 30
vertex -47.5 -49.5 30
endloop
endfacet
facet normal 1 -0 0
outer loop
vertex -47.5 -50 33
vertex -47.5 -49.5 30
vertex -47.5 -47 33.5
endloop
endfacet
facet normal 1 -0 0
outer loop
vertex -47.5 -40 43
vertex -47.5 -47 33.5
vertex -47.5 -41 35.5
endloop
endfacet
facet normal 1 -0 0
outer loop
vertex -47.5 -40 43
vertex -47.5 -41 35.5
vertex -47.5 -34 37
endloop
endfacet
facet normal 1 0 0
outer loop
vertex -47.5 -37 29.5
vertex -47.5 -41 35.5
vertex -47.5 -42.5 33.5
endloop
endfacet
facet normal 1 0 -0
outer loop
vertex -47.5 -37 29.5
vertex -47.5 -34 37
vertex -47.5 -41 35.5
endloop
endfacet
facet normal 1 -0 0
outer loop
vertex -47.5 -37 29.5
vertex -47.5 -36.5 29.5
vertex -47.5 -34 37
endloop
endfacet
facet normal 1 0 0
outer loop
vertex -47.5 -61.5 15.5
vertex -47.5 -60.5 28.5
vertex -47.5 -60.5 30
endloop
endfacet
facet normal 1 0 0
outer loop
vertex -47.5 -60 23.5
vertex -47.5 -55 30
vertex -47.5 -55 33
endloop
endfacet
facet normal 1 -0 0
outer loop
vertex -47.5 -55 30
vertex -47.5 -60 23.5
vertex -47.5 -52.5 29
endloop
endfacet
facet normal 1 -0 0
outer loop
vertex -47.5 -52.5 29
vertex -47.5 -60 23.5
vertex -47.5 -51 29
endloop
endfacet
facet normal 1 0 -0
outer loop
vertex -47.5 -61.5 15.5
vertex -47.5 -60.5 23.5
vertex -47.5 -60.5 28.5
endloop
endfacet
facet normal 1 0 -0
outer loop
vertex -47.5 -52 22.5
vertex -47.5 -51.5 23
vertex -47.5 -60.5 23.5
endloop
endfacet
facet normal 1 0 0
outer loop
vertex -47.5 -67 21
vertex -47.5 -65.5 17
vertex -47.5 -61.5 15.5
endloop
endfacet
facet normal 1 0 0
outer loop
vertex -47.5 -52 22.5
vertex -47.5 -60.5 23.5
vertex -47.5 -61.5 15.5
endloop
endfacet
facet normal 1 -0 0
outer loop
vertex -47.5 -52 22.5
vertex -47.5 -61.5 15.5
vertex -47.5 -52.5 22
endloop
endfacet
facet normal 1 -0 0
outer loop
vertex -47.5 -52.5 22
vertex -47.5 -61.5 15.5
vertex -47.5 -52.5 15.5
endloop
endfacet
facet normal -0 0.9 0.4
outer loop
vertex -47.5 -67 21
vertex -31.5 -67 21
vertex -47.5 -65.5 17
endloop
endfacet
facet normal 0 0.4 0.9
outer loop
vertex -47.5 -65.5 17
vertex -31.5 -61.5 15.5
vertex -47.5 -61.5 15.5
endloop
endfacet
facet normal 0 -0 1
outer loop
vertex -47.5 -61.5 15.5
vertex -31.5 -52.5 15.5
vertex -47.5 -52.5 15.5
endloop
endfacet
facet normal 1 -0 0
outer loop
vertex -47.5 -50 30
vertex -47.5 -51 29
vertex -47.5 -49.5 30
endloop
endfacet
facet normal 1 -0 0
outer loop
vertex -47.5 -52.5 29
vertex -47.5 -51 29
vertex -47.5 -50 30
endloop
endfacet
facet normal 1 0 -0
outer loop
vertex -47.5 -51.5 23
vertex -47.5 -42.5 23
vertex -47.5 -60.5 23.5
endloop
endfacet
facet normal 1 0 -0
outer loop
vertex -47.5 -42.5 23
vertex -47.5 -41 23.5
vertex -47.5 -60.5 23.5
endloop
endfacet
facet normal 1 -0 0
outer loop
vertex -47.5 -42.5 23
vertex -47.5 -42 22.5
vertex -47.5 -41 23.5
endloop
endfacet
facet normal 0 0.9 0.4
outer loop
vertex -47.5 -65.5 17
vertex -31.5 -67 21
vertex -31.5 -65.5 17
endloop
endfacet
facet normal -0 0.4 0.9
outer loop
vertex -47.5 -65.5 17
vertex -31.5 -65.5 17
vertex -31.5 -61.5 15.5
endloop
endfacet
facet normal 0 0 1
outer loop
vertex -47.5 -61.5 15.5
vertex -31.5 -61.5 15.5
vertex -31.5 -52.5 15.5
endloop
endfacet
facet normal 1 0 0
outer loop
vertex -47.5 -34 37
vertex -47.5 -36.5 29.5
vertex -47.5 -18 29
endloop
endfacet
facet normal 1 -0 0
outer loop
vertex -47.5 -1 61
vertex -47.5 -1 26
vertex -47.5 1 26
endloop
endfacet
facet normal 1 -0 0
outer loop
vertex -47.5 -36.5 29.5
vertex -47.5 -41 23.5
vertex -47.5 -18 29
endloop
endfacet
facet normal 1 0 -0
outer loop
vertex -47.5 -42 22.5
vertex -47.5 -18 29
vertex -47.5 -41 23.5
endloop
endfacet
facet normal 1 0 -0
outer loop
vertex -47.5 -42 22.5
vertex -47.5 -1 26
vertex -47.5 -18 29
endloop
endfacet
facet normal 1 -0 0
outer loop
vertex -47.5 -42 22.5
vertex -47.5 -41.5 22
vertex -47.5 41.5 22
endloop
endfacet
facet normal 1 0 -0
outer loop
vertex -47.5 -42 22.5
vertex -47.5 42 22.5
vertex -47.5 -1 26
endloop
endfacet
facet normal 1 -0 0
outer loop
vertex -47.5 -41.5 22
vertex -47.5 -41.5 15.5
vertex -47.5 41.5 15.5
endloop
endfacet
facet normal 0 0 1
outer loop
vertex -47.5 -41.5 15.5
vertex -31.5 -41.5 15.5
vertex -31.5 41.5 15.5
endloop
endfacet
facet normal -0.6 0.8 0
outer loop
vertex -31.5 -67 21
vertex -23 -60.5 144.5
vertex -23 -60.5 23.5
endloop
endfacet
facet normal -0.7 0 0.7
outer loop
vertex -31.5 -61.5 15.5
vertex -24.5 -52.5 22
vertex -31.5 -52.5 15.5
endloop
endfacet
facet normal -0.7 0.7 0.3
outer loop
vertex -31.5 -67 21
vertex -23 -60.5 23.5
vertex -31.5 -65.5 17
endloop
endfacet
facet normal -0.7 0.3 0.7
outer loop
vertex -31.5 -65.5 17
vertex -23 -60.5 23.5
vertex -31.5 -61.5 15.5
endloop
endfacet
facet normal -0.7 0 0.7
outer loop
vertex -31.5 -61.5 15.5
vertex -23 -60.5 23.5
vertex -24.5 -52.5 22
endloop
endfacet
facet normal -0.7 0 0.7
outer loop
vertex -24 -52 22.5
vertex -23 -60.5 23.5
vertex -23.5 -51.5 23
endloop
endfacet
facet normal -0.7 -0 0.7
outer loop
vertex -24.5 -52.5 22
vertex -23 -60.5 23.5
vertex -24 -52 22.5
endloop
endfacet
facet normal -0.7 0 0.7
outer loop
vertex -23.5 -51.5 23
vertex -23 -60.5 23.5
vertex -23.5 -42.5 23
endloop
endfacet
facet normal -0.7 0 0.7
outer loop
vertex -31.5 -41.5 15.5
vertex -24.5 -41.5 22
vertex -24.5 41.5 22
endloop
endfacet
facet normal -0.7 -0 0.7
outer loop
vertex -23.5 -42.5 23
vertex -23 -60.5 23.5
vertex -24 42 22.5
endloop
endfacet
facet normal -0.7 0 0.7
outer loop
vertex -24.5 -41.5 22
vertex -24 -42 22.5
vertex -24 42 22.5
endloop
endfacet
facet normal -0.7 0 0.7
outer loop
vertex -24 -42 22.5
vertex -23.5 -42.5 23
vertex -24 42 22.5
endloop
endfacet
facet normal 1 -0 0
outer loop
vertex -47.5 20 95.5
vertex -47.5 -6 67.5
vertex -47.5 23 85
endloop
endfacet
facet normal 1 -0 0
outer loop
vertex -47.5 23 85
vertex -47.5 -1 61
vertex -47.5 23 83
endloop
endfacet
facet normal 1 0 0
outer loop
vertex -47.5 23 85
vertex -47.5 -6 67.5
vertex -47.5 -1 61
endloop
endfacet
facet normal 1 0 0
outer loop
vertex -47.5 -1 61
vertex -47.5 16.5 69
vertex -47.5 23 83
endloop
endfacet
facet normal 1 0 0
outer loop
vertex -47.5 51 83
vertex -47.5 23 85
vertex -47.5 23 83
endloop
endfacet
facet normal 1 0 -0
outer loop
vertex -47.5 20 72.5
vertex -47.5 23 83
vertex -47.5 16.5 69
endloop
endfacet
facet normal 1 0 -0
outer loop
vertex -47.5 1 61
vertex -47.5 11.5 64
vertex -47.5 -1 61
endloop
endfacet
facet normal 1 0 0
outer loop
vertex -47.5 -1 61
vertex -47.5 11.5 64
vertex -47.5 15 67.5
endloop
endfacet
facet normal 1 0 0
outer loop
vertex -47.5 -1 61
vertex -47.5 15 67.5
vertex -47.5 16.5 69
endloop
endfacet
facet normal 1 0 0
outer loop
vertex -47.5 1 61
vertex -47.5 -1 61
vertex -47.5 1 26
endloop
endfacet
facet normal 1 0 0
outer loop
vertex -47.5 16.5 69
vertex -47.5 15 67.5
vertex -47.5 41 44
endloop
endfacet
facet normal 1 -0 0
outer loop
vertex -47.5 15 67.5
vertex -47.5 40 43
vertex -47.5 41 44
endloop
endfacet
facet normal 1 -0 0
outer loop
vertex -47.5 57 85
vertex -47.5 56.5 83
vertex -47.5 58 83
endloop
endfacet
facet normal 1 0 0
outer loop
vertex -47.5 55.5 68
vertex -47.5 55 66
vertex -47.5 55.5 65.5
endloop
endfacet
facet normal 1 -0 0
outer loop
vertex -47.5 47 50
vertex -47.5 52.5 34.5
vertex -47.5 55.5 65.5
endloop
endfacet
facet normal 1 0 -0
outer loop
vertex -47.5 47 50
vertex -47.5 55.5 65.5
vertex -47.5 55 66
endloop
endfacet
facet normal 1 -0 0
outer loop
vertex -47.5 67 147
vertex -47.5 65.5 17
vertex -47.5 67 21
endloop
endfacet
facet normal 1 0 0
outer loop
vertex -47.5 65.5 17
vertex -47.5 58 83
vertex -47.5 56 70.5
endloop
endfacet
facet normal 0 -1 -0
outer loop
vertex -31.5 67 147
vertex -41.5 67 39
vertex -40 67 41.5
endloop
endfacet
facet normal 0 -1 -0
outer loop
vertex -31.5 67 147
vertex -47.5 67 21
vertex -41.5 67 39
endloop
endfacet
facet normal 0 -1 -0
outer loop
vertex -31.5 67 147
vertex -40 67 41.5
vertex -37.5 67 43
endloop
endfacet
facet normal 0 -1 -0
outer loop
vertex -31.5 67 147
vertex -37.5 67 43
vertex -32 67 43
endloop
endfacet
facet normal 1 0 0
outer loop
vertex -47.5 42 22.5
vertex -47.5 1 26
vertex -47.5 -1 26
endloop
endfacet
facet normal 1 -0 0
outer loop
vertex -47.5 -42 22.5
vertex -47.5 41.5 22
vertex -47.5 42 22.5
endloop
endfacet
facet normal 1 -0 0
outer loop
vertex -47.5 -41.5 22
vertex -47.5 41.5 15.5
vertex -47.5 41.5 22
endloop
endfacet
facet normal 0 -0 1
outer loop
vertex -47.5 -41.5 15.5
vertex -31.5 41.5 15.5
vertex -47.5 41.5 15.5
endloop
endfacet
facet normal 1 0 0
outer loop
vertex -47.5 42 22.5
vertex -47.5 18 29
vertex -47.5 1 26
endloop
endfacet
facet normal 1 -0 -0
outer loop
vertex -47.5 18 29
vertex -47.5 42 23.5
vertex -47.5 34 37
endloop
endfacet
facet normal 1 0 -0
outer loop
vertex -47.5 42 22.5
vertex -47.5 42 23.5
vertex -47.5 18 29
endloop
endfacet
facet normal 1 0 0
outer loop
vertex -47.5 44.5 41
vertex -47.5 41 44
vertex -47.5 40 43
endloop
endfacet
facet normal 1 0 -0
outer loop
vertex -47.5 34 37
vertex -47.5 44.5 41
vertex -47.5 40 43
endloop
endfacet
facet normal 1 -0 -0
outer loop
vertex -47.5 41 44
vertex -47.5 52.5 34.5
vertex -47.5 47 50
endloop
endfacet
facet normal 1 0 0
outer loop
vertex -47.5 41 44
vertex -47.5 44.5 41
vertex -47.5 52.5 34.5
endloop
endfacet
facet normal 1 -0 0
outer loop
vertex -47.5 34 37
vertex -47.5 42 23.5
vertex -47.5 44.5 41
endloop
endfacet
facet normal 1 0 0
outer loop
vertex -47.5 44.5 41
vertex -47.5 45 40.5
vertex -47.5 52.5 34.5
endloop
endfacet
facet normal 1 0 0
outer loop
vertex -47.5 52.5 34
vertex -47.5 45 39.5
vertex -47.5 44 33
endloop
endfacet
facet normal 1 0 0
outer loop
vertex -47.5 52.5 34
vertex -47.5 44 33
vertex -47.5 50 33
endloop
endfacet
facet normal 1 -0 0
outer loop
vertex -47.5 44 33
vertex -47.5 50 30
vertex -47.5 50 33
endloop
endfacet
facet normal 1 -0 0
outer loop
vertex -47.5 52.5 34.5
vertex -47.5 52.5 34
vertex -47.5 55.5 65.5
endloop
endfacet
facet normal 1 -0 0
outer loop
vertex -47.5 55.5 65.5
vertex -47.5 52.5 34
vertex -47.5 52.5 34
endloop
endfacet
facet normal 1 0 -0
outer loop
vertex -47.5 53 34
vertex -47.5 55.5 65.5
vertex -47.5 52.5 34
endloop
endfacet
facet normal 1 -0 0
outer loop
vertex -47.5 53.5 33.5
vertex -47.5 55 33
vertex -47.5 56 70.5
endloop
endfacet
facet normal 1 0 0
outer loop
vertex -47.5 65.5 17
vertex -47.5 56 70.5
vertex -47.5 55 33
endloop
endfacet
facet normal 0 -1 0
outer loop
vertex -47.5 67 21
vertex -40 67 36.5
vertex -41.5 67 39
endloop
endfacet
facet normal 0 -1 0
outer loop
vertex -47.5 67 21
vertex -37.5 67 35
vertex -40 67 36.5
endloop
endfacet
facet normal 1 0 0
outer loop
vertex -47.5 42.5 23
vertex -47.5 42 23.5
vertex -47.5 42 22.5
endloop
endfacet
facet normal 1 0 0
outer loop
vertex -47.5 52 29
vertex -47.5 50 30
vertex -47.5 44 33
endloop
endfacet
facet normal 1 0 0
outer loop
vertex -47.5 50 30
vertex -47.5 52 29
vertex -47.5 52.5 29
endloop
endfacet
facet normal 1 0 -0
outer loop
vertex -47.5 42.5 23
vertex -47.5 51.5 23
vertex -47.5 42 23.5
endloop
endfacet
facet normal 1 0 -0
outer loop
vertex -47.5 51.5 23
vertex -47.5 52.5 23.5
vertex -47.5 42 23.5
endloop
endfacet
facet normal 1 -0 0
outer loop
vertex -47.5 51.5 23
vertex -47.5 52 22.5
vertex -47.5 52.5 23.5
endloop
endfacet
facet normal 1 -0 -0
outer loop
vertex -47.5 52 29
vertex -47.5 52.5 29
vertex -47.5 52.5 29
endloop
endfacet
facet normal 1 0 0
outer loop
vertex -47.5 52.5 29
vertex -47.5 52.5 29
vertex -47.5 52.5 29
endloop
endfacet
facet normal 1 -0 0
outer loop
vertex -47.5 53 29
vertex -47.5 52.5 23.5
vertex -47.5 55 30
endloop
endfacet
facet normal 1 0 0
outer loop
vertex -47.5 65.5 17
vertex -47.5 55 33
vertex -47.5 55 30
endloop
endfacet
facet normal 1 -0 0
outer loop
vertex -47.5 52 22.5
vertex -47.5 52.5 22
vertex -47.5 52.5 23.5
endloop
endfacet
facet normal 1 0 0
outer loop
vertex -47.5 65.5 17
vertex -47.5 55 30
vertex -47.5 52.5 23.5
endloop
endfacet
facet normal 1 -0 0
outer loop
vertex -47.5 52.5 22
vertex -47.5 52.5 15.5
vertex -47.5 61.5 15.5
endloop
endfacet
facet normal 1 -0 -0
outer loop
vertex -47.5 52.5 22
vertex -47.5 65.5 17
vertex -47.5 52.5 23.5
endloop
endfacet
facet normal 1 -0 0
outer loop
vertex -47.5 52.5 22
vertex -47.5 61.5 15.5
vertex -47.5 65.5 17
endloop
endfacet
facet normal 0 -0 1
outer loop
vertex -47.5 52.5 15.5
vertex -31.5 61.5 15.5
vertex -47.5 61.5 15.5
endloop
endfacet
facet normal 0 -0.9 0.4
outer loop
vertex -47.5 67 21
vertex -47.5 65.5 17
vertex -31.5 65.5 17
endloop
endfacet
facet normal 0 -0.4 0.9
outer loop
vertex -47.5 61.5 15.5
vertex -31.5 65.5 17
vertex -47.5 65.5 17
endloop
endfacet
facet normal 0 -1 0
outer loop
vertex -47.5 67 21
vertex -31.5 67 21
vertex -37.5 67 35
endloop
endfacet
facet normal 0 -1 0
outer loop
vertex -31.5 67 21
vertex -32 67 35
vertex -37.5 67 35
endloop
endfacet
facet normal 0 0 1
outer loop
vertex -47.5 52.5 15.5
vertex -31.5 52.5 15.5
vertex -31.5 61.5 15.5
endloop
endfacet
facet normal 0 -0.9 0.4
outer loop
vertex -47.5 67 21
vertex -31.5 65.5 17
vertex -31.5 67 21
endloop
endfacet
facet normal 0 -0.4 0.9
outer loop
vertex -47.5 61.5 15.5
vertex -31.5 61.5 15.5
vertex -31.5 65.5 17
endloop
endfacet
facet normal 0 -1 -0
outer loop
vertex -31.5 67 147
vertex -32 67 43
vertex -31.5 67 42.5
endloop
endfacet
facet normal -0.6 -0.8 -0
outer loop
vertex -31.5 67 147
vertex -31.5 67 42.5
vertex -29.5 65.5 41.5
endloop
endfacet
facet normal -0.6 -0.8 0
outer loop
vertex -31.5 67 147
vertex -29.5 65.5 41.5
vertex -28.5 64.5 39
endloop
endfacet
facet normal -0.6 -0.8 0
outer loop
vertex -31.5 67 147
vertex -28.5 64.5 39
vertex -23 60.5 23.5
endloop
endfacet
facet normal -0.7 0 0.7
outer loop
vertex -31.5 -41.5 15.5
vertex -24.5 41.5 22
vertex -31.5 41.5 15.5
endloop
endfacet
facet normal -0.7 0 0.7
outer loop
vertex -24 42 22.5
vertex -23 -60.5 23.5
vertex -23.5 42.5 23
endloop
endfacet
facet normal -0.7 0 0.7
outer loop
vertex -23.5 42.5 23
vertex -23 -60.5 23.5
vertex -23.5 51.5 23
endloop
endfacet
facet normal -0.7 0 0.7
outer loop
vertex -24.5 -41.5 22
vertex -24 42 22.5
vertex -24.5 41.5 22
endloop
endfacet
facet normal -0.7 0 0.7
outer loop
vertex -23.5 51.5 23
vertex -23 -60.5 23.5
vertex -23 60.5 23.5
endloop
endfacet
facet normal -0.6 -0.8 0
outer loop
vertex -23 60.5 23.5
vertex -29.5 65.5 36.5
vertex -31.5 67 35.5
endloop
endfacet
facet normal -0.6 -0.8 -0
outer loop
vertex -23 60.5 23.5
vertex -28.5 64.5 39
vertex -29.5 65.5 36.5
endloop
endfacet
facet normal -0 -1 0
outer loop
vertex -31.5 67 21
vertex -31.5 67 35.5
vertex -32 67 35
endloop
endfacet
facet normal -0.6 -0.8 0
outer loop
vertex -31.5 67 21
vertex -23 60.5 23.5
vertex -31.5 67 35.5
endloop
endfacet
facet normal -0.7 0 0.7
outer loop
vertex -31.5 52.5 15.5
vertex -23 60.5 23.5
vertex -31.5 61.5 15.5
endloop
endfacet
facet normal -0.7 -0 0.7
outer loop
vertex -31.5 52.5 15.5
vertex -24.5 52.5 22
vertex -23 60.5 23.5
endloop
endfacet
facet normal -0.7 -0.7 0.3
outer loop
vertex -31.5 67 21
vertex -31.5 65.5 17
vertex -23 60.5 23.5
endloop
endfacet
facet normal -0.7 -0.3 0.7
outer loop
vertex -31.5 61.5 15.5
vertex -23 60.5 23.5
vertex -31.5 65.5 17
endloop
endfacet
facet normal -0.7 -0 0.7
outer loop
vertex -23.5 51.5 23
vertex -23 60.5 23.5
vertex -24 52 22.5
endloop
endfacet
facet normal -0.7 0 0.7
outer loop
vertex -24.5 52.5 22
vertex -24 52 22.5
vertex -23 60.5 23.5
endloop
endfacet
facet normal 0 -1 0
outer loop
vertex -47.5 -52.5 152.5
vertex -47.5 -52.5 146
vertex -31.5 -52.5 152.5
endloop
endfacet
facet normal -0 1 0
outer loop
vertex -47.5 -41.5 152.5
vertex -31.5 -41.5 152.5
vertex -47.5 -41.5 146
endloop
endfacet
facet normal 0 -0.9 -0.4
outer loop
vertex -47.5 -52.5 146
vertex -47.5 -52 145.5
vertex -24.5 -52.5 146
endloop
endfacet
facet normal 0 -1 0
outer loop
vertex -47.5 -52.5 146
vertex -24.5 -52.5 146
vertex -31.5 -52.5 152.5
endloop
endfacet
facet normal 0 -0.4 -0.9
outer loop
vertex -47.5 -52 145.5
vertex -47.5 -51.5 145
vertex -24 -52 145.5
endloop
endfacet
facet normal 0 0 -1
outer loop
vertex -47.5 -51.5 145
vertex -47.5 -42.5 145
vertex -23.5 -51.5 145
endloop
endfacet
facet normal 0 0.9 -0.4
outer loop
vertex -47.5 -41.5 146
vertex -24 -42 145.5
vertex -47.5 -42 145.5
endloop
endfacet
facet normal 0 0.4 -0.9
outer loop
vertex -47.5 -42 145.5
vertex -23.5 -42.5 145
vertex -47.5 -42.5 145
endloop
endfacet
facet normal -0 1 0
outer loop
vertex -47.5 -41.5 146
vertex -31.5 -41.5 152.5
vertex -24.5 -41.5 146
endloop
endfacet
facet normal 0 -0.9 -0.4
outer loop
vertex -47.5 -52 145.5
vertex -24 -52 145.5
vertex -24.5 -52.5 146
endloop
endfacet
facet normal 0 -0.4 -0.9
outer loop
vertex -47.5 -51.5 145
vertex -23.5 -51.5 145
vertex -24 -52 145.5
endloop
endfacet
facet normal 0 0 -1
outer loop
vertex -47.5 -42.5 145
vertex -23.5 -42.5 145
vertex -23.5 -51.5 145
endloop
endfacet
facet normal 0 0.9 -0.4
outer loop
vertex -47.5 -41.5 146
vertex -24.5 -41.5 146
vertex -24 -42 145.5
endloop
endfacet
facet normal 0 0.4 -0.9
outer loop
vertex -47.5 -42 145.5
vertex -24 -42 145.5
vertex -23.5 -42.5 145
endloop
endfacet
facet normal 1 0 0
outer loop
vertex -22 -52.5 147
vertex -22 -52.5 146
vertex -22 -51.5 145
endloop
endfacet
facet normal 0 0 1
outer loop
vertex -22 -51.5 155
vertex -22 -51.5 155
vertex -22 -44 155
endloop
endfacet
facet normal 1 0 0
outer loop
vertex -22 -44 155
vertex -22 -44 147
vertex -22 -42.5 155
endloop
endfacet
facet normal 1 -0 -0
outer loop
vertex -22 -52.5 147
vertex -22 -42.5 145
vertex -22 -44 147
endloop
endfacet
facet normal 1 -0 -0
outer loop
vertex -22 -42.5 155
vertex -22 -41.5 154
vertex -22 -42 154.5
endloop
endfacet
facet normal 1 -0 0
outer loop
vertex -22 -42.5 155
vertex -22 -41.5 146
vertex -22 -41.5 154
endloop
endfacet
facet normal 1 0 0
outer loop
vertex -22 -44 147
vertex -22 -41.5 146
vertex -22 -42.5 155
endloop
endfacet
facet normal 1 0 0
outer loop
vertex -22 -52.5 146
vertex -22 -52 145.5
vertex -22 -51.5 145
endloop
endfacet
facet normal 1 -0 0
outer loop
vertex -22 -52.5 147
vertex -22 -51.5 145
vertex -22 -42.5 145
endloop
endfacet
facet normal 1 0 -0
outer loop
vertex -22 -44 147
vertex -22 -42 145.5
vertex -22 -41.5 146
endloop
endfacet
facet normal 1 0 -0
outer loop
vertex -22 -44 147
vertex -22 -42.5 145
vertex -22 -42 145.5
endloop
endfacet
facet normal 0 -1 0
outer loop
vertex -47.5 41.5 152.5
vertex -47.5 41.5 146
vertex -31.5 41.5 152.5
endloop
endfacet
facet normal -0 1 0
outer loop
vertex -47.5 52.5 152.5
vertex -31.5 52.5 152.5
vertex -47.5 52.5 146
endloop
endfacet
facet normal 0 -0 1
outer loop
vertex -47.5 42.5 155
vertex -22 51.5 155
vertex -47.5 51.5 155
endloop
endfacet
facet normal 0 -0.9 -0.4
outer loop
vertex -47.5 41.5 146
vertex -47.5 42 145.5
vertex -24.5 41.5 146
endloop
endfacet
facet normal 0 -0.4 -0.9
outer loop
vertex -47.5 42 145.5
vertex -47.5 42.5 145
vertex -24 42 145.5
endloop
endfacet
facet normal 0 0 -1
outer loop
vertex -47.5 42.5 145
vertex -47.5 51.5 145
vertex -23.5 42.5 145
endloop
endfacet
facet normal 0 0.4 -0.9
outer loop
vertex -47.5 51.5 145
vertex -47.5 52 145.5
vertex -23.5 51.5 145
endloop
endfacet
facet normal 0 -1 0
outer loop
vertex -47.5 41.5 146
vertex -24.5 41.5 146
vertex -31.5 41.5 152.5
endloop
endfacet
facet normal 0 0.9 -0.4
outer loop
vertex -47.5 52.5 146
vertex -24 52 145.5
vertex -47.5 52 145.5
endloop
endfacet
facet normal -0 1 0
outer loop
vertex -47.5 52.5 146
vertex -31.5 52.5 152.5
vertex -24.5 52.5 146
endloop
endfacet
facet normal 0 -0 1
outer loop
vertex -47.5 42.5 155
vertex -22 42.5 155
vertex -22 44 155
endloop
endfacet
facet normal 0 0 1
outer loop
vertex -47.5 42.5 155
vertex -22 44 155
vertex -22 51.5 155
endloop
endfacet
facet normal 0 -0.9 -0.4
outer loop
vertex -47.5 42 145.5
vertex -24 42 145.5
vertex -24.5 41.5 146
endloop
endfacet
facet normal 0 -0.4 -0.9
outer loop
vertex -47.5 42.5 145
vertex -23.5 42.5 145
vertex -24 42 145.5
endloop
endfacet
facet normal 0 0 -1
outer loop
vertex -47.5 51.5 145
vertex -23.5 51.5 145
vertex -23.5 42.5 145
endloop
endfacet
facet normal 0 0.4 -0.9
outer loop
vertex -47.5 52 145.5
vertex -24 52 145.5
vertex -23.5 51.5 145
endloop
endfacet
facet normal 0 0.9 -0.4
outer loop
vertex -47.5 52.5 146
vertex -24.5 52.5 146
vertex -24 52 145.5
endloop
endfacet
facet normal 1 0 -0
outer loop
vertex -22 42 154.5
vertex -22 44 155
vertex -22 42.5 155
endloop
endfacet
facet normal 1 -0 0
outer loop
vertex -22 42 154.5
vertex -22 41.5 154
vertex -22 44 155
endloop
endfacet
facet normal 1 -0 0
outer loop
vertex -22 41.5 154
vertex -22 42.5 145
vertex -22 44 155
endloop
endfacet
facet normal 1 0 0
outer loop
vertex -22 41.5 154
vertex -22 41.5 146
vertex -22 42.5 145
endloop
endfacet
facet normal 0 -0 1
outer loop
vertex -22 42.5 155
vertex -22 44 155
vertex -22 44 155
endloop
endfacet
facet normal 1 -0 0
outer loop
vertex -22 44 155
vertex -22 42.5 145
vertex -22 44 147
endloop
endfacet
facet normal 1 0 -0
outer loop
vertex -22 44 147
vertex -22 52.5 146
vertex -22 52.5 147
endloop
endfacet
facet normal 1 0 0
outer loop
vertex -22 41.5 146
vertex -22 42 145.5
vertex -22 42.5 145
endloop
endfacet
facet normal 1 0 -0
outer loop
vertex -22 44 147
vertex -22 42.5 145
vertex -22 51.5 145
endloop
endfacet
facet normal 1 0 -0
outer loop
vertex -22 44 147
vertex -22 51.5 145
vertex -22 52 145.5
endloop
endfacet
facet normal 1 0 -0
outer loop
vertex -22 44 147
vertex -22 52 145.5
vertex -22 52.5 146
endloop
endfacet
facet normal 0 -1 0
outer loop
vertex -47.5 -52.5 22
vertex -47.5 -52.5 15.5
vertex -31.5 -52.5 15.5
endloop
endfacet
facet normal 0 1 0
outer loop
vertex -47.5 -41.5 22
vertex -31.5 -41.5 15.5
vertex -47.5 -41.5 15.5
endloop
endfacet
facet normal 0 -0.9 0.4
outer loop
vertex -47.5 -52 22.5
vertex -47.5 -52.5 22
vertex -24 -52 22.5
endloop
endfacet
facet normal 0 -1 0
outer loop
vertex -47.5 -52.5 22
vertex -31.5 -52.5 15.5
vertex -24.5 -52.5 22
endloop
endfacet
facet normal 0 -0.4 0.9
outer loop
vertex -47.5 -52 22.5
vertex -23.5 -51.5 23
vertex -47.5 -51.5 23
endloop
endfacet
facet normal 0 -0 1
outer loop
vertex -47.5 -51.5 23
vertex -23.5 -42.5 23
vertex -47.5 -42.5 23
endloop
endfacet
facet normal 0 0.9 0.4
outer loop
vertex -47.5 -42 22.5
vertex -24.5 -41.5 22
vertex -47.5 -41.5 22
endloop
endfacet
facet normal 0 0.4 0.9
outer loop
vertex -47.5 -42.5 23
vertex -24 -42 22.5
vertex -47.5 -42 22.5
endloop
endfacet
facet normal 0 0 -1
outer loop
vertex -47.5 -51.5 13
vertex -47.5 -42.5 13
vertex -22 -51.5 13
endloop
endfacet
facet normal -0 1 0
outer loop
vertex -47.5 -41.5 22
vertex -24.5 -41.5 22
vertex -31.5 -41.5 15.5
endloop
endfacet
facet normal 0 -0.9 0.4
outer loop
vertex -47.5 -52.5 22
vertex -24.5 -52.5 22
vertex -24 -52 22.5
endloop
endfacet
facet normal 0 -0.4 0.9
outer loop
vertex -47.5 -52 22.5
vertex -24 -52 22.5
vertex -23.5 -51.5 23
endloop
endfacet
facet normal 0 0 1
outer loop
vertex -47.5 -51.5 23
vertex -23.5 -51.5 23
vertex -23.5 -42.5 23
endloop
endfacet
facet normal -0 0.9 0.4
outer loop
vertex -47.5 -42 22.5
vertex -24 -42 22.5
vertex -24.5 -41.5 22
endloop
endfacet
facet normal -0 0.4 0.9
outer loop
vertex -47.5 -42.5 23
vertex -23.5 -42.5 23
vertex -24 -42 22.5
endloop
endfacet
facet normal 0 0 -1
outer loop
vertex -47.5 -42.5 13
vertex -22 -44 13
vertex -22 -51.5 13
endloop
endfacet
facet normal 1 -0 0
outer loop
vertex -22 -52 22.5
vertex -22 -52.5 22
vertex -22 -44 21
endloop
endfacet
facet normal 1 -0 0
outer loop
vertex -22 -52 22.5
vertex -22 -44 21
vertex -22 -51.5 23
endloop
endfacet
facet normal 1 0 0
outer loop
vertex -22 -51.5 23
vertex -22 -44 21
vertex -22 -42.5 23
endloop
endfacet
facet normal 1 -0 -0
outer loop
vertex -22 -42.5 23
vertex -22 -41.5 22
vertex -22 -42 22.5
endloop
endfacet
facet normal 1 -0 0
outer loop
vertex -22 -52.5 22
vertex -22 -52.5 21
vertex -22 -44 21
endloop
endfacet
facet normal 1 0 0
outer loop
vertex -22 -42.5 23
vertex -22 -44 21
vertex -22 -44 13
endloop
endfacet
facet normal 0 0 -1
outer loop
vertex -22 -44 13
vertex -22 -44 13
vertex -22 -44 13
endloop
endfacet
facet normal 1 -0 0
outer loop
vertex -22 -42.5 23
vertex -22 -41.5 14
vertex -22 -41.5 22
endloop
endfacet
facet normal 1 0 0
outer loop
vertex -22 -42.5 23
vertex -22 -44 13
vertex -22 -41.5 14
endloop
endfacet
facet normal 1 0 -0
outer loop
vertex -22 -44 13
vertex -22 -42 13.5
vertex -22 -41.5 14
endloop
endfacet
facet normal 1 0 -0
outer loop
vertex -22 -44 13
vertex -22 -42.5 13
vertex -22 -42 13.5
endloop
endfacet
facet normal 0 -1 0
outer loop
vertex -47.5 41.5 22
vertex -47.5 41.5 15.5
vertex -31.5 41.5 15.5
endloop
endfacet
facet normal 0 1 0
outer loop
vertex -47.5 52.5 22
vertex -31.5 52.5 15.5
vertex -47.5 52.5 15.5
endloop
endfacet
facet normal 0 -0.9 0.4
outer loop
vertex -47.5 42 22.5
vertex -47.5 41.5 22
vertex -24 42 22.5
endloop
endfacet
facet normal 0 -0.4 0.9
outer loop
vertex -47.5 42.5 23
vertex -47.5 42 22.5
vertex -23.5 42.5 23
endloop
endfacet
facet normal 0 -0 1
outer loop
vertex -47.5 42.5 23
vertex -23.5 51.5 23
vertex -47.5 51.5 23
endloop
endfacet
facet normal 0 0.4 0.9
outer loop
vertex -47.5 51.5 23
vertex -24 52 22.5
vertex -47.5 52 22.5
endloop
endfacet
facet normal 0 -1 0
outer loop
vertex -47.5 41.5 22
vertex -31.5 41.5 15.5
vertex -24.5 41.5 22
endloop
endfacet
facet normal 0 0.9 0.4
outer loop
vertex -47.5 52 22.5
vertex -24.5 52.5 22
vertex -47.5 52.5 22
endloop
endfacet
facet normal -0 1 0
outer loop
vertex -47.5 52.5 22
vertex -24.5 52.5 22
vertex -31.5 52.5 15.5
endloop
endfacet
facet normal 0 -0.9 0.4
outer loop
vertex -47.5 41.5 22
vertex -24.5 41.5 22
vertex -24 42 22.5
endloop
endfacet
facet normal 0 -0.4 0.9
outer loop
vertex -47.5 42 22.5
vertex -24 42 22.5
vertex -23.5 42.5 23
endloop
endfacet
facet normal 0 0 1
outer loop
vertex -47.5 42.5 23
vertex -23.5 42.5 23
vertex -23.5 51.5 23
endloop
endfacet
facet normal -0 0.4 0.9
outer loop
vertex -47.5 51.5 23
vertex -23.5 51.5 23
vertex -24 52 22.5
endloop
endfacet
facet normal 0 0 -1
outer loop
vertex -47.5 51.5 13
vertex -22 51.5 13
vertex -22 42.5 13
endloop
endfacet
facet normal -0 0.9 0.4
outer loop
vertex -47.5 52 22.5
vertex -24 52 22.5
vertex -24.5 52.5 22
endloop
endfacet
facet normal 1 -0 0
outer loop
vertex -22 42.5 23
vertex -22 42 22.5
vertex -22 44 21
endloop
endfacet
facet normal 1 -0 0
outer loop
vertex -22 42 22.5
vertex -22 41.5 22
vertex -22 44 21
endloop
endfacet
facet normal 1 -0 -0
outer loop
vertex -22 42.5 23
vertex -22 52.5 21
vertex -22 51.5 23
endloop
endfacet
facet normal 1 -0 -0
outer loop
vertex -22 51.5 23
vertex -22 52.5 22
vertex -22 52 22.5
endloop
endfacet
facet normal 1 -0 -0
outer loop
vertex -22 41.5 22
vertex -22 42.5 13
vertex -22 44 21
endloop
endfacet
facet normal 1 0 0
outer loop
vertex -22 41.5 22
vertex -22 41.5 14
vertex -22 42.5 13
endloop
endfacet
facet normal 1 0 0
outer loop
vertex -22 41.5 14
vertex -22 42 13.5
vertex -22 42.5 13
endloop
endfacet
facet normal 1 0 0
outer loop
vertex -22 42.5 23
vertex -22 44 21
vertex -22 52.5 21
endloop
endfacet
facet normal 1 -0 0
outer loop
vertex -22 42.5 13
vertex -22 44 13
vertex -22 44 21
endloop
endfacet
facet normal 0 0 -1
outer loop
vertex -22 42.5 13
vertex -22 51.5 13
vertex -22 44 13
endloop
endfacet
facet normal 0 0 -1
outer loop
vertex -22 44 13
vertex -22 51.5 13
vertex -22 51.5 13
endloop
endfacet
facet normal 1 -0 0
outer loop
vertex -22 51.5 23
vertex -22 52.5 21
vertex -22 52.5 22
endloop
endfacet
facet normal 0 -0 1
outer loop
vertex -22 -61.5 155
vertex -22 -51.5 155
vertex -22 -51.5 155
endloop
endfacet
facet normal 0 -0.9 0.4
outer loop
vertex -22 -67 152.5
vertex -22 -69.5 147
vertex -16 -67 152.5
endloop
endfacet
facet normal 0 -0.4 0.9
outer loop
vertex -22 -67 152.5
vertex -16 -61.5 155
vertex -22 -61.5 155
endloop
endfacet
facet normal 0 -0.4 0.9
outer loop
vertex -22 -67 152.5
vertex -16 -67 152.5
vertex -16 -61.5 155
endloop
endfacet
facet normal 1 -0 -0
outer loop
vertex -16 -67 152.5
vertex -16 -60.5 147
vertex -16 -61.5 155
endloop
endfacet
facet normal 0 -0.9 0.4
outer loop
vertex -22 -69.5 147
vertex -16 -69.5 147
vertex -16 -67 152.5
endloop
endfacet
facet normal 1 0 0
outer loop
vertex -16 -67 152.5
vertex -16 -69.5 147
vertex -16 -65 145.5
endloop
endfacet
facet normal 0 0.4 -0.9
outer loop
vertex -22 -60.5 147
vertex -16 -60.5 147
vertex -16 -65 145.5
endloop
endfacet
facet normal 1 -0 0
outer loop
vertex -16 -67 152.5
vertex -16 -65 145.5
vertex -16 -60.5 147
endloop
endfacet
facet normal 0 -0 1
outer loop
vertex -22 -61.5 155
vertex -16 -44 155
vertex -22 -51.5 155
endloop
endfacet
facet normal 0 0 -1
outer loop
vertex -22 -60.5 147
vertex -22 -52.5 147
vertex -16 -60.5 147
endloop
endfacet
facet normal 0 0 1
outer loop
vertex -22 -61.5 155
vertex -16 -61.5 155
vertex -16 -44 155
endloop
endfacet
facet normal 1 -0 0
outer loop
vertex -16 -61.5 155
vertex -16 -60.5 147
vertex -16 -44 155
endloop
endfacet
facet normal 0 0 -1
outer loop
vertex -22 -52.5 147
vertex -16 -44 147
vertex -16 -60.5 147
endloop
endfacet
facet normal 0 0.9 -0.4
outer loop
vertex -22 -65 145.5
vertex -16 -66.5 141
vertex -22 -66.5 141
endloop
endfacet
facet normal 0 0.4 -0.9
outer loop
vertex -22 -60.5 147
vertex -16 -65 145.5
vertex -22 -65 145.5
endloop
endfacet
facet normal 0 -1 0
outer loop
vertex -22 -69.5 147
vertex -22 -69.5 128
vertex -16 -69.5 147
endloop
endfacet
facet normal 0 0.9 -0.4
outer loop
vertex -22 -65 145.5
vertex -16 -65 145.5
vertex -16 -66.5 141
endloop
endfacet
facet normal 1 -0 0
outer loop
vertex -16 -69.5 147
vertex -16 -66.5 141
vertex -16 -65 145.5
endloop
endfacet
facet normal 1 -0 0
outer loop
vertex -16 -69.5 147
vertex -16 -69.5 128
vertex -16 -66.5 141
endloop
endfacet
facet normal 0 -0 1
outer loop
vertex -22 -51.5 155
vertex -16 -44 155
vertex -22 -44 155
endloop
endfacet
facet normal -0 1 0
outer loop
vertex -22 -44 155
vertex -16 -44 155
vertex -22 -44 147
endloop
endfacet
facet normal 0 0 -1
outer loop
vertex -22 -52.5 147
vertex -22 -44 147
vertex -16 -44 147
endloop
endfacet
facet normal 1 0 0
outer loop
vertex -16 -60.5 147
vertex -16 -44 147
vertex -16 -44 155
endloop
endfacet
facet normal -0 1 0
outer loop
vertex -22 -44 147
vertex -16 -44 155
vertex -16 -44 147
endloop
endfacet
facet normal 0 1 0
outer loop
vertex -22 -66.5 141
vertex -16 -66.5 128
vertex -22 -66.5 128
endloop
endfacet
facet normal -0 1 0
outer loop
vertex -22 -66.5 141
vertex -16 -66.5 141
vertex -16 -66.5 128
endloop
endfacet
facet normal 0 -1 -0
outer loop
vertex -16 -69.5 147
vertex -22 -69.5 128
vertex -16 -69.5 128
endloop
endfacet
facet normal 1 -0 0
outer loop
vertex -16 -66.5 141
vertex -16 -69.5 128
vertex -16 -66.5 128
endloop
endfacet
facet normal 0 0 -1
outer loop
vertex -22 -69.5 128
vertex -22 -66.5 128
vertex -16 -69.5 128
endloop
endfacet
facet normal 0 0 -1
outer loop
vertex -22 -66.5 128
vertex -16 -66.5 128
vertex -16 -69.5 128
endloop
endfacet
facet normal 0 -1 0
outer loop
vertex -22 44 155
vertex -22 44 147
vertex -16 44 147
endloop
endfacet
facet normal 0 0 -1
outer loop
vertex -22 44 147
vertex -22 52.5 147
vertex -16 44 147
endloop
endfacet
facet normal 0 -1 0
outer loop
vertex -22 44 155
vertex -16 44 147
vertex -16 44 155
endloop
endfacet
facet normal 0 0 1
outer loop
vertex -22 44 155
vertex -16 44 155
vertex -16 61.5 155
endloop
endfacet
facet normal 1 -0 0
outer loop
vertex -16 44 155
vertex -16 44 147
vertex -16 60.5 147
endloop
endfacet
facet normal 0 -0 1
outer loop
vertex -22 44 155
vertex -16 61.5 155
vertex -22 61.5 155
endloop
endfacet
facet normal 0 0 -1
outer loop
vertex -16 44 147
vertex -22 52.5 147
vertex -22 60.5 147
endloop
endfacet
facet normal 1 -0 0
outer loop
vertex -16 44 155
vertex -16 60.5 147
vertex -16 61.5 155
endloop
endfacet
facet normal 0 0 -1
outer loop
vertex -16 44 147
vertex -22 60.5 147
vertex -16 60.5 147
endloop
endfacet
facet normal 0 0.4 0.9
outer loop
vertex -22 61.5 155
vertex -16 67 152.5
vertex -22 67 152.5
endloop
endfacet
facet normal 0 -0.4 -0.9
outer loop
vertex -22 60.5 147
vertex -22 65 145.5
vertex -16 60.5 147
endloop
endfacet
facet normal 0 0.9 0.4
outer loop
vertex -22 67 152.5
vertex -16 69.5 147
vertex -22 69.5 147
endloop
endfacet
facet normal -0 0.4 0.9
outer loop
vertex -22 61.5 155
vertex -16 61.5 155
vertex -16 67 152.5
endloop
endfacet
facet normal 1 0 -0
outer loop
vertex -16 60.5 147
vertex -16 67 152.5
vertex -16 61.5 155
endloop
endfacet
facet normal -0 0.9 0.4
outer loop
vertex -22 67 152.5
vertex -16 67 152.5
vertex -16 69.5 147
endloop
endfacet
facet normal 1 -0 0
outer loop
vertex -16 60.5 147
vertex -16 65 145.5
vertex -16 67 152.5
endloop
endfacet
facet normal 1 -0 0
outer loop
vertex -16 67 152.5
vertex -16 65 145.5
vertex -16 69.5 147
endloop
endfacet
facet normal 0 -0.9 -0.4
outer loop
vertex -22 65 145.5
vertex -22 66.5 141
vertex -16 65 145.5
endloop
endfacet
facet normal 0 -0.4 -0.9
outer loop
vertex -22 65 145.5
vertex -16 65 145.5
vertex -16 60.5 147
endloop
endfacet
facet normal 0 -0.9 -0.4
outer loop
vertex -22 66.5 141
vertex -16 66.5 141
vertex -16 65 145.5
endloop
endfacet
facet normal 1 0 0
outer loop
vertex -16 69.5 147
vertex -16 65 145.5
vertex -16 66.5 141
endloop
endfacet
facet normal -0 1 0
outer loop
vertex -22 69.5 147
vertex -16 69.5 147
vertex -16 69.5 128
endloop
endfacet
facet normal 1 0 0
outer loop
vertex -16 69.5 147
vertex -16 66.5 141
vertex -16 69.5 128
endloop
endfacet
facet normal 0 -1 0
outer loop
vertex -22 66.5 141
vertex -22 66.5 128
vertex -16 66.5 141
endloop
endfacet
facet normal 0 1 0
outer loop
vertex -22 69.5 147
vertex -16 69.5 128
vertex -22 69.5 128
endloop
endfacet
facet normal 0 -1 -0
outer loop
vertex -16 66.5 141
vertex -22 66.5 128
vertex -16 66.5 128
endloop
endfacet
facet normal 1 -0 0
outer loop
vertex -16 66.5 141
vertex -16 66.5 128
vertex -16 69.5 128
endloop
endfacet
facet normal 0 0 -1
outer loop
vertex -22 66.5 128
vertex -22 69.5 128
vertex -16 66.5 128
endloop
endfacet
facet normal 0 0 -1
outer loop
vertex -22 69.5 128
vertex -16 69.5 128
vertex -16 66.5 128
endloop
endfacet
facet normal 0 -0 1
outer loop
vertex -22 -69.5 40
vertex -16 -66.5 40
vertex -22 -66.5 40
endloop
endfacet
facet normal 0 0 1
outer loop
vertex -22 -69.5 40
vertex -16 -69.5 40
vertex -16 -66.5 40
endloop
endfacet
facet normal 0 -1 0
outer loop
vertex -22 -69.5 40
vertex -22 -69.5 21
vertex -16 -69.5 40
endloop
endfacet
facet normal 0 1 0
outer loop
vertex -22 -66.5 40
vertex -16 -66.5 27
vertex -22 -66.5 27
endloop
endfacet
facet normal -0 1 0
outer loop
vertex -22 -66.5 40
vertex -16 -66.5 40
vertex -16 -66.5 27
endloop
endfacet
facet normal 1 -0 0
outer loop
vertex -16 -69.5 40
vertex -16 -66.5 27
vertex -16 -66.5 40
endloop
endfacet
facet normal 0 0 -1
outer loop
vertex -22 -61.5 13
vertex -22 -51.5 13
vertex -22 -61.5 13
endloop
endfacet
facet normal 0 0.9 0.4
outer loop
vertex -22 -66.5 27
vertex -16 -65 22.5
vertex -22 -65 22.5
endloop
endfacet
facet normal 0 -1 -0
outer loop
vertex -16 -69.5 40
vertex -22 -69.5 21
vertex -16 -69.5 21
endloop
endfacet
facet normal 1 -0 0
outer loop
vertex -16 -69.5 40
vertex -16 -69.5 21
vertex -16 -66.5 27
endloop
endfacet
facet normal -0 0.9 0.4
outer loop
vertex -22 -66.5 27
vertex -16 -66.5 27
vertex -16 -65 22.5
endloop
endfacet
facet normal 1 -0 0
outer loop
vertex -16 -66.5 27
vertex -16 -69.5 21
vertex -16 -65 22.5
endloop
endfacet
facet normal -0 0.4 0.9
outer loop
vertex -22 -65 22.5
vertex -16 -65 22.5
vertex -16 -60.5 21
endloop
endfacet
facet normal 0 -0.9 -0.4
outer loop
vertex -22 -69.5 21
vertex -22 -67 15.5
vertex -16 -69.5 21
endloop
endfacet
facet normal 0 0.4 0.9
outer loop
vertex -22 -65 22.5
vertex -16 -60.5 21
vertex -22 -60.5 21
endloop
endfacet
facet normal 0 -0.4 -0.9
outer loop
vertex -22 -67 15.5
vertex -22 -61.5 13
vertex -16 -67 15.5
endloop
endfacet
facet normal 1 0 0
outer loop
vertex -16 -65 22.5
vertex -16 -69.5 21
vertex -16 -67 15.5
endloop
endfacet
facet normal 1 -0 0
outer loop
vertex -16 -65 22.5
vertex -16 -67 15.5
vertex -16 -60.5 21
endloop
endfacet
facet normal 0 -0.9 -0.4
outer loop
vertex -22 -67 15.5
vertex -16 -67 15.5
vertex -16 -69.5 21
endloop
endfacet
facet normal 0 -0.4 -0.9
outer loop
vertex -22 -61.5 13
vertex -16 -61.5 13
vertex -16 -67 15.5
endloop
endfacet
facet normal 1 -0 0
outer loop
vertex -16 -67 15.5
vertex -16 -61.5 13
vertex -16 -60.5 21
endloop
endfacet
facet normal 0 -0 1
outer loop
vertex -22 -60.5 21
vertex -16 -44 21
vertex -22 -52.5 21
endloop
endfacet
facet normal 0 0 -1
outer loop
vertex -22 -61.5 13
vertex -22 -51.5 13
vertex -16 -61.5 13
endloop
endfacet
facet normal 0 0 -1
outer loop
vertex -16 -61.5 13
vertex -22 -51.5 13
vertex -22 -44 13
endloop
endfacet
facet normal 0 0 1
outer loop
vertex -22 -60.5 21
vertex -16 -60.5 21
vertex -16 -44 21
endloop
endfacet
facet normal 1 0 -0
outer loop
vertex -16 -61.5 13
vertex -16 -44 13
vertex -16 -60.5 21
endloop
endfacet
facet normal 0 0 -1
outer loop
vertex -22 -51.5 13
vertex -22 -44 13
vertex -22 -44 13
endloop
endfacet
facet normal 0 -0 1
outer loop
vertex -22 -52.5 21
vertex -16 -44 21
vertex -22 -44 21
endloop
endfacet
facet normal -0 1 0
outer loop
vertex -22 -44 21
vertex -16 -44 21
vertex -22 -44 13
endloop
endfacet
facet normal 0 0 -1
outer loop
vertex -22 -44 13
vertex -22 -44 13
vertex -16 -44 13
endloop
endfacet
facet normal 1 -0 0
outer loop
vertex -16 -60.5 21
vertex -16 -44 13
vertex -16 -44 21
endloop
endfacet
facet normal 0 0 -1
outer loop
vertex -16 -61.5 13
vertex -22 -44 13
vertex -16 -44 13
endloop
endfacet
facet normal -0 1 0
outer loop
vertex -22 -44 13
vertex -16 -44 21
vertex -16 -44 13
endloop
endfacet
facet normal 0 -0 1
outer loop
vertex -22 66.5 40
vertex -16 69.5 40
vertex -22 69.5 40
endloop
endfacet
facet normal 0 0 1
outer loop
vertex -22 66.5 40
vertex -16 66.5 40
vertex -16 69.5 40
endloop
endfacet
facet normal 0 -1 0
outer loop
vertex -22 66.5 40
vertex -22 66.5 27
vertex -16 66.5 40
endloop
endfacet
facet normal 1 -0 0
outer loop
vertex -16 66.5 40
vertex -16 66.5 27
vertex -16 69.5 40
endloop
endfacet
facet normal -0 1 0
outer loop
vertex -22 69.5 40
vertex -16 69.5 40
vertex -16 69.5 21
endloop
endfacet
facet normal 0 -1 -0
outer loop
vertex -16 66.5 40
vertex -22 66.5 27
vertex -16 66.5 27
endloop
endfacet
facet normal 0 -0 1
outer loop
vertex -22 44 21
vertex -16 44 21
vertex -22 52.5 21
endloop
endfacet
facet normal 0 -1 0
outer loop
vertex -22 44 21
vertex -22 44 13
vertex -16 44 13
endloop
endfacet
facet normal 0 0 -1
outer loop
vertex -22 44 13
vertex -22 51.5 13
vertex -16 44 13
endloop
endfacet
facet normal 0 -1 0
outer loop
vertex -22 44 21
vertex -16 44 13
vertex -16 44 21
endloop
endfacet
facet normal 1 -0 0
outer loop
vertex -16 44 21
vertex -16 44 13
vertex -16 60.5 21
endloop
endfacet
facet normal 0 0 -1
outer loop
vertex -22 51.5 13
vertex -22 61.5 13
vertex -22 51.5 13
endloop
endfacet
facet normal 0 1 0
outer loop
vertex -22 69.5 40
vertex -16 69.5 21
vertex -22 69.5 21
endloop
endfacet
facet normal 0 -0.4 0.9
outer loop
vertex -22 65 22.5
vertex -22 60.5 21
vertex -16 65 22.5
endloop
endfacet
facet normal 0 -0.9 0.4
outer loop
vertex -22 66.5 27
vertex -22 65 22.5
vertex -16 66.5 27
endloop
endfacet
facet normal 1 0 0
outer loop
vertex -16 69.5 40
vertex -16 66.5 27
vertex -16 69.5 21
endloop
endfacet
facet normal 0 -0.9 0.4
outer loop
vertex -22 65 22.5
vertex -16 65 22.5
vertex -16 66.5 27
endloop
endfacet
facet normal 1 0 0
outer loop
vertex -16 66.5 27
vertex -16 65 22.5
vertex -16 69.5 21
endloop
endfacet
facet normal 0 -0 1
outer loop
vertex -22 52.5 21
vertex -16 60.5 21
vertex -22 60.5 21
endloop
endfacet
facet normal 0 0 -1
outer loop
vertex -22 51.5 13
vertex -22 61.5 13
vertex -16 44 13
endloop
endfacet
facet normal 0 0 -1
outer loop
vertex -16 44 13
vertex -22 61.5 13
vertex -22 61.5 13
endloop
endfacet
facet normal 0 -0 1
outer loop
vertex -16 44 21
vertex -16 60.5 21
vertex -22 52.5 21
endloop
endfacet
facet normal 0 0 -1
outer loop
vertex -16 44 13
vertex -22 61.5 13
vertex -16 61.5 13
endloop
endfacet
facet normal 1 0 -0
outer loop
vertex -16 44 13
vertex -16 61.5 13
vertex -16 60.5 21
endloop
endfacet
facet normal 0 0.4 -0.9
outer loop
vertex -22 61.5 13
vertex -22 67 15.5
vertex -16 61.5 13
endloop
endfacet
facet normal 0 0.9 -0.4
outer loop
vertex -22 69.5 21
vertex -16 67 15.5
vertex -22 67 15.5
endloop
endfacet
facet normal 0 -0.4 0.9
outer loop
vertex -22 60.5 21
vertex -16 60.5 21
vertex -16 65 22.5
endloop
endfacet
facet normal 1 0 0
outer loop
vertex -16 65 22.5
vertex -16 60.5 21
vertex -16 67 15.5
endloop
endfacet
facet normal 0 0.9 -0.4
outer loop
vertex -22 69.5 21
vertex -16 69.5 21
vertex -16 67 15.5
endloop
endfacet
facet normal 1 -0 0
outer loop
vertex -16 65 22.5
vertex -16 67 15.5
vertex -16 69.5 21
endloop
endfacet
facet normal 1 -0 0
outer loop
vertex -16 60.5 21
vertex -16 61.5 13
vertex -16 67 15.5
endloop
endfacet
facet normal 0 0.4 -0.9
outer loop
vertex -22 67 15.5
vertex -16 67 15.5
vertex -16 61.5 13
endloop
endfacet
facet normal 0 0.5 -0.9
outer loop
vertex -47.5 -52.5 139
vertex -50 -55 138
vertex -50 -52.5 139
endloop
endfacet
facet normal 0 0.5 -0.9
outer loop
vertex -47.5 -53 139
vertex -50 -55 138
vertex -47.5 -52.5 139
endloop
endfacet
facet normal -0 0.5 -0.9
outer loop
vertex -47.5 -52.5 139
vertex -50 -55 138
vertex -47.5 -52.5 139
endloop
endfacet
facet normal 0 0.5 -0.9
outer loop
vertex -47.5 -53 139
vertex -47.5 -55 138
vertex -50 -55 138
endloop
endfacet
facet normal 0 -0.5 -0.9
outer loop
vertex -47.5 -50 138
vertex -50 -52.5 139
vertex -50 -50 138
endloop
endfacet
facet normal -0 -0.5 -0.9
outer loop
vertex -47.5 -50 138
vertex -47.5 -52.5 139
vertex -50 -52.5 139
endloop
endfacet
facet normal -0 1 0
outer loop
vertex -50 -55 138
vertex -47.5 -55 138
vertex -50 -55 135
endloop
endfacet
facet normal 0 0.5 0.9
outer loop
vertex -47.5 -55 135
vertex -50 -52.5 134
vertex -50 -55 135
endloop
endfacet
facet normal 0 1 -0
outer loop
vertex -47.5 -55 135
vertex -50 -55 135
vertex -47.5 -55 138
endloop
endfacet
facet normal 0 0.5 0.9
outer loop
vertex -47.5 -55 135
vertex -47.5 -52.5 134
vertex -50 -52.5 134
endloop
endfacet
facet normal -0 -1 -0
outer loop
vertex -47.5 -50 135
vertex -50 -50 138
vertex -50 -50 135
endloop
endfacet
facet normal 0 -0.5 0.9
outer loop
vertex -50 -52.5 134
vertex -47.5 -52.5 134
vertex -50 -50 135
endloop
endfacet
facet normal 0 -1 0
outer loop
vertex -47.5 -50 135
vertex -47.5 -50 138
vertex -50 -50 138
endloop
endfacet
facet normal 0 -0.5 0.9
outer loop
vertex -47.5 -52.5 134
vertex -47.5 -50 135
vertex -50 -50 135
endloop
endfacet
facet normal 0 0.5 -0.9
outer loop
vertex -50 50 138
vertex -50 52.5 139
vertex -47.5 52.5 139
endloop
endfacet
facet normal 0 0.5 -0.9
outer loop
vertex -50 50 138
vertex -47.5 52.5 139
vertex -47.5 50 138
endloop
endfacet
facet normal 0 -0.5 -0.9
outer loop
vertex -50 52.5 139
vertex -50 55 138
vertex -47.5 55 138
endloop
endfacet
facet normal 0 -0.5 -0.9
outer loop
vertex -50 52.5 139
vertex -47.5 55 138
vertex -47.5 52.5 139
endloop
endfacet
facet normal -0 1 0
outer loop
vertex -50 50 138
vertex -47.5 50 138
vertex -50 50 135
endloop
endfacet
facet normal -0 0.5 0.9
outer loop
vertex -50 52.5 134
vertex -50 50 135
vertex -47.5 50 135
endloop
endfacet
facet normal 0 1 -0
outer loop
vertex -47.5 50 135
vertex -50 50 135
vertex -47.5 50 138
endloop
endfacet
facet normal 0 0.5 0.9
outer loop
vertex -50 52.5 134
vertex -47.5 50 135
vertex -47.5 52.5 134
endloop
endfacet
facet normal 0 -1 0
outer loop
vertex -50 55 135
vertex -47.5 55 135
vertex -50 55 138
endloop
endfacet
facet normal 0 -0.5 0.9
outer loop
vertex -50 52.5 134
vertex -47.5 52.5 134
vertex -50 55 135
endloop
endfacet
facet normal 0 -1 0
outer loop
vertex -50 55 138
vertex -47.5 55 135
vertex -47.5 55 138
endloop
endfacet
facet normal 0 -0.5 0.9
outer loop
vertex -47.5 55 135
vertex -50 55 135
vertex -47.5 52.5 134
endloop
endfacet
facet normal 0 0.5 -0.9
outer loop
vertex -47.5 -52.5 34
vertex -50 -55 33
vertex -50 -52.5 34
endloop
endfacet
facet normal -0 1 0
outer loop
vertex -50 -55 33
vertex -47.5 -55 33
vertex -50 -55 30
endloop
endfacet
facet normal 0 0.5 -0.9
outer loop
vertex -47.5 -52.5 34
vertex -47.5 -55 33
vertex -50 -55 33
endloop
endfacet
facet normal 0 1 -0
outer loop
vertex -47.5 -55 30
vertex -50 -55 30
vertex -47.5 -55 33
endloop
endfacet
facet normal 0 -0.5 -0.9
outer loop
vertex -47.5 -50 33
vertex -50 -52.5 34
vertex -50 -50 33
endloop
endfacet
facet normal -0 -1 -0
outer loop
vertex -47.5 -50 30
vertex -50 -50 33
vertex -50 -50 30
endloop
endfacet
facet normal -0 -0.5 -0.9
outer loop
vertex -47.5 -50 33
vertex -47.5 -52.5 34
vertex -50 -52.5 34
endloop
endfacet
facet normal 0 -1 0
outer loop
vertex -47.5 -50 30
vertex -47.5 -50 33
vertex -50 -50 33
endloop
endfacet
facet normal -0 0.5 0.9
outer loop
vertex -50 -55 30
vertex -47.5 -55 30
vertex -50 -52.5 29
endloop
endfacet
facet normal 0 0.5 0.9
outer loop
vertex -47.5 -55 30
vertex -47.5 -52.5 29
vertex -50 -52.5 29
endloop
endfacet
facet normal 0 -0.5 0.9
outer loop
vertex -50 -52.5 29
vertex -47.5 -52.5 29
vertex -50 -50 30
endloop
endfacet
facet normal 0 -0.5 0.9
outer loop
vertex -47.5 -50 30
vertex -50 -50 30
vertex -47.5 -52.5 29
endloop
endfacet
facet normal 0 0.5 -0.9
outer loop
vertex -50 50 33
vertex -50 52.5 34
vertex -47.5 52.5 34
endloop
endfacet
facet normal -0 1 0
outer loop
vertex -50 50 33
vertex -47.5 50 33
vertex -50 50 30
endloop
endfacet
facet normal 0 0.5 -0.9
outer loop
vertex -47.5 52.5 34
vertex -47.5 50 33
vertex -50 50 33
endloop
endfacet
facet normal 0 0.5 -0.9
outer loop
vertex -47.5 52.5 34
vertex -50 50 33
vertex -47.5 52.5 34
endloop
endfacet
facet normal 0 1 -0
outer loop
vertex -47.5 50 30
vertex -50 50 30
vertex -47.5 50 33
endloop
endfacet
facet normal 0 -0.5 -0.9
outer loop
vertex -50 52.5 34
vertex -50 55 33
vertex -47.5 55 33
endloop
endfacet
facet normal 0 -1 0
outer loop
vertex -50 55 30
vertex -47.5 55 30
vertex -50 55 33
endloop
endfacet
facet normal -0 -0.5 -0.9
outer loop
vertex -47.5 53 34
vertex -47.5 52.5 34
vertex -50 52.5 34
endloop
endfacet
facet normal -0 -0.5 -0.9
outer loop
vertex -47.5 53 34
vertex -50 52.5 34
vertex -47.5 53.5 33.5
endloop
endfacet
facet normal 0 -0.5 -0.9
outer loop
vertex -47.5 53.5 33.5
vertex -50 52.5 34
vertex -47.5 55 33
endloop
endfacet
facet normal 0 -1 0
outer loop
vertex -50 55 33
vertex -47.5 55 30
vertex -47.5 55 33
endloop
endfacet
facet normal -0 0.5 0.9
outer loop
vertex -50 50 30
vertex -47.5 50 30
vertex -50 52.5 29
endloop
endfacet
facet normal 0 0.5 0.9
outer loop
vertex -47.5 50 30
vertex -47.5 52.5 29
vertex -50 52.5 29
endloop
endfacet
facet normal 0 -0.5 0.9
outer loop
vertex -50 52.5 29
vertex -47.5 52.5 29
vertex -50 55 30
endloop
endfacet
facet normal 0 -0.5 0.9
outer loop
vertex -47.5 53 29
vertex -47.5 55 30
vertex -50 55 30
endloop
endfacet
facet normal 0 -0.5 0.9
outer loop
vertex -47.5 52.5 29
vertex -50 55 30
vertex -47.5 52.5 29
endloop
endfacet
facet normal -0 -0.5 0.9
outer loop
vertex -47.5 52.5 29
vertex -47.5 53 29
vertex -50 55 30
endloop
endfacet
facet normal 1 0 0
outer loop
vertex -47.5 -53 139
vertex -47.5 -52.5 139
vertex -47.5 -52.5 144
endloop
endfacet
facet normal 1 0 0
outer loop
vertex -47.5 -52.5 139
vertex -47.5 -52.5 139
vertex -47.5 -52.5 144
endloop
endfacet
facet normal 1 -0 -0
outer loop
vertex -47.5 -52.5 139
vertex -47.5 -52 139
vertex -47.5 -52.5 144
endloop
endfacet
facet normal 1 -0 0
outer loop
vertex -47.5 -52.5 144
vertex -47.5 -52 139
vertex -47.5 -42 143.5
endloop
endfacet
facet normal 1 0 -0
outer loop
vertex -47.5 -52 139
vertex -47.5 -42 143.5
vertex -47.5 -52 139
endloop
endfacet
facet normal 1 -0 0
outer loop
vertex -47.5 -52 139
vertex -47.5 -44 135
vertex -47.5 -42 143.5
endloop
endfacet
facet normal 1 -0 0
outer loop
vertex -47.5 -53 132
vertex -47.5 -52.5 130.5
vertex -47.5 -52.5 133.5
endloop
endfacet
facet normal 1 -0 0
outer loop
vertex -47.5 -53.5 132.5
vertex -47.5 -55 104.5
vertex -47.5 -53 132
endloop
endfacet
facet normal 1 -0 0
outer loop
vertex -47.5 -53 132
vertex -47.5 -55 104.5
vertex -47.5 -52.5 130.5
endloop
endfacet
facet normal 1 -0 -0
outer loop
vertex -47.5 -52.5 133.5
vertex -47.5 -45.5 119.5
vertex -47.5 -52.5 134
endloop
endfacet
facet normal 1 0 0
outer loop
vertex -47.5 -42 143.5
vertex -47.5 -44 135
vertex -47.5 -45.5 119.5
endloop
endfacet
facet normal 1 0 0
outer loop
vertex -47.5 -45 128.5
vertex -47.5 -52.5 134
vertex -47.5 -45.5 119.5
endloop
endfacet
facet normal 1 0 0
outer loop
vertex -47.5 -44 135
vertex -47.5 -45 128.5
vertex -47.5 -45.5 119.5
endloop
endfacet
facet normal 1 0 -0
outer loop
vertex -47.5 -46.5 118.5
vertex -47.5 -45.5 119.5
vertex -47.5 -52.5 133.5
endloop
endfacet
facet normal 1 0 0
outer loop
vertex -47.5 -55.5 100
vertex -47.5 -55 104.5
vertex -47.5 -53.5 132.5
endloop
endfacet
facet normal 1 0 -0
outer loop
vertex -47.5 -55 102.5
vertex -47.5 -52.5 130.5
vertex -47.5 -55 104.5
endloop
endfacet
facet normal 1 0 0
outer loop
vertex -47.5 -56 97.5
vertex -47.5 -55.5 100
vertex -47.5 -53.5 132.5
endloop
endfacet
facet normal 1 0 0
outer loop
vertex -47.5 -51 85
vertex -47.5 -56.5 85
vertex -47.5 -51 83
endloop
endfacet
facet normal 1 -0 0
outer loop
vertex -47.5 8.5 103.5
vertex -47.5 -13.5 75.5
vertex -47.5 -5.5 79.5
endloop
endfacet
facet normal 1 0 0
outer loop
vertex -47.5 19.5 104.5
vertex -47.5 10 95
vertex -47.5 -29.5 55.5
endloop
endfacet
facet normal 0 0 -1
outer loop
vertex -22 -60.5 144.5
vertex -23 -60.5 144.5
vertex -22 60.5 144.5
endloop
endfacet
facet normal -0 1 0
outer loop
vertex -23 -60.5 144.5
vertex -22 -60.5 144.5
vertex -23 -60.5 23.5
endloop
endfacet
facet normal 1 -0 0
outer loop
vertex -47.5 37 139
vertex -47.5 38 139
vertex -47.5 40.5 143.5
endloop
endfacet
facet normal 1 -0 -0
outer loop
vertex -47.5 38 139
vertex -47.5 51 139
vertex -47.5 40.5 143.5
endloop
endfacet
facet normal 1 0 -0
outer loop
vertex -47.5 51 139
vertex -47.5 60.5 144.5
vertex -47.5 40.5 143.5
endloop
endfacet
facet normal 1 -0 0
outer loop
vertex -47.5 38 139
vertex -47.5 50 138
vertex -47.5 51 139
endloop
endfacet
facet normal 1 0 0
outer loop
vertex -47.5 51 139
vertex -47.5 60 144.5
vertex -47.5 60.5 144.5
endloop
endfacet
facet normal 1 -0 0
outer loop
vertex -47.5 38 139
vertex -47.5 42.5 134.5
vertex -47.5 50 138
endloop
endfacet
facet normal 1 -0 0
outer loop
vertex -47.5 37 128
vertex -47.5 40 125.5
vertex -47.5 42.5 134.5
endloop
endfacet
facet normal 1 -0 0
outer loop
vertex -47.5 42.5 134.5
vertex -47.5 40 125.5
vertex -47.5 50 138
endloop
endfacet
facet normal 1 0 -0
outer loop
vertex -47.5 54.5 103.5
vertex -47.5 60.5 144.5
vertex -47.5 60 144.5
endloop
endfacet
facet normal 1 -0 -0
outer loop
vertex -47.5 9.5 104.5
vertex -47.5 13.5 101
vertex -47.5 10 104.5
endloop
endfacet
facet normal 1 0 0
outer loop
vertex -47.5 9.5 104.5
vertex -47.5 8.5 103.5
vertex -47.5 13.5 101
endloop
endfacet
facet normal 1 0 -0
outer loop
vertex -47.5 29.5 112.5
vertex -47.5 38.5 123.5
vertex -47.5 32 116
endloop
endfacet
facet normal 1 0 0
outer loop
vertex -47.5 28 111
vertex -47.5 29.5 112.5
vertex -47.5 32 116
endloop
endfacet
facet normal 1 0 0
outer loop
vertex -47.5 5.5 88.5
vertex -47.5 32 116
vertex -47.5 38.5 123.5
endloop
endfacet
facet normal 1 -0 0
outer loop
vertex -47.5 8.5 103.5
vertex -47.5 10 95
vertex -47.5 13.5 101
endloop
endfacet
facet normal 1 -0 0
outer loop
vertex -47.5 13.5 101
vertex -47.5 10 95
vertex -47.5 15 100.5
endloop
endfacet
facet normal 1 0 -0
outer loop
vertex -47.5 5.5 88.5
vertex -47.5 38.5 123.5
vertex -47.5 -8 75.5
endloop
endfacet
facet normal 1 -0 0
outer loop
vertex -47.5 19.5 104.5
vertex -47.5 -29.5 55.5
vertex -47.5 38.5 123.5
endloop
endfacet
facet normal 1 -0 0
outer loop
vertex -47.5 8.5 103.5
vertex -47.5 -5.5 79.5
vertex -47.5 10 95
endloop
endfacet
facet normal 1 -0 0
outer loop
vertex -47.5 38.5 123.5
vertex -47.5 -19.5 63.5
vertex -47.5 -8 75.5
endloop
endfacet
facet normal 1 -0 0
outer loop
vertex -47.5 5.5 88.5
vertex -47.5 -6 67.5
vertex -47.5 16 96
endloop
endfacet
facet normal 1 0 0
outer loop
vertex -47.5 17.5 97
vertex -47.5 17 97.5
vertex -47.5 -6 67.5
endloop
endfacet
facet normal 1 -0 0
outer loop
vertex -47.5 16 96
vertex -47.5 -6 67.5
vertex -47.5 17 97.5
endloop
endfacet
facet normal 1 0 0
outer loop
vertex -47.5 60 144.5
vertex -47.5 54 104
vertex -47.5 54.5 103.5
endloop
endfacet
facet normal 1 0 0
outer loop
vertex -47.5 57 91.5
vertex -47.5 59.5 127
vertex -47.5 60 133
endloop
endfacet
facet normal 1 -0 0
outer loop
vertex -47.5 57 91.5
vertex -47.5 57 89.5
vertex -47.5 59.5 127
endloop
endfacet
facet normal 1 0 0
outer loop
vertex -47.5 57 85
vertex -47.5 51 85
vertex -47.5 56.5 83
endloop
endfacet
facet normal -0 0 -1
outer loop
vertex -22 60.5 144.5
vertex -23 -60.5 144.5
vertex -23 60.5 144.5
endloop
endfacet
facet normal 0 -1 0
outer loop
vertex -23 60.5 144.5
vertex -22 60.5 23.5
vertex -22 60.5 144.5
endloop
endfacet
facet normal 1 0 -0
outer loop
vertex -47.5 -57 83
vertex -47.5 -51 83
vertex -47.5 -56.5 85
endloop
endfacet
facet normal 1 -0 0
outer loop
vertex -47.5 -57 78.5
vertex -47.5 -60.5 30
vertex -47.5 -57 76.5
endloop
endfacet
facet normal 1 0 0
outer loop
vertex -47.5 -54 64
vertex -47.5 -54.5 64.5
vertex -47.5 -60 23.5
endloop
endfacet
facet normal 1 -0 0
outer loop
vertex -47.5 -18 70.5
vertex -47.5 -17.5 70
vertex -47.5 8.5 103.5
endloop
endfacet
facet normal 1 -0 0
outer loop
vertex -47.5 8.5 103.5
vertex -47.5 -17.5 70
vertex -47.5 -13.5 75.5
endloop
endfacet
facet normal 1 0 0
outer loop
vertex -47.5 -29.5 55.5
vertex -47.5 -19.5 63.5
vertex -47.5 38.5 123.5
endloop
endfacet
facet normal 1 -0 0
outer loop
vertex -47.5 -5.5 79.5
vertex -47.5 -29.5 55.5
vertex -47.5 10 95
endloop
endfacet
facet normal 1 -0 0
outer loop
vertex -47.5 -8 75.5
vertex -47.5 -6 67.5
vertex -47.5 5.5 88.5
endloop
endfacet
facet normal 1 0 0
outer loop
vertex -47.5 -14.5 67.5
vertex -47.5 -12.5 67.5
vertex -47.5 -8 75.5
endloop
endfacet
facet normal 1 -0 0
outer loop
vertex -47.5 -8 75.5
vertex -47.5 -12.5 67.5
vertex -47.5 -6 67.5
endloop
endfacet
facet normal 1 -0 0
outer loop
vertex -47.5 -12.5 67.5
vertex -47.5 -9.5 64.5
vertex -47.5 -6 67.5
endloop
endfacet
facet normal 1 -0 0
outer loop
vertex -47.5 -28 57
vertex -47.5 -29.5 55.5
vertex -47.5 -5.5 79.5
endloop
endfacet
facet normal 1 0 -0
outer loop
vertex -47.5 -19.5 63.5
vertex -47.5 -19.5 63.5
vertex -47.5 -29.5 55.5
endloop
endfacet
facet normal 1 0 -0
outer loop
vertex -47.5 -38.5 44.5
vertex -47.5 -19.5 63.5
vertex -47.5 -29.5 55.5
endloop
endfacet
facet normal 1 -0 0
outer loop
vertex -47.5 -10 63.5
vertex -47.5 -9.5 63.5
vertex -47.5 -9.5 64.5
endloop
endfacet
facet normal 1 0 -0
outer loop
vertex -47.5 -9.5 63.5
vertex -47.5 -6 67.5
vertex -47.5 -9.5 64.5
endloop
endfacet
facet normal 1 0 0
outer loop
vertex -47.5 -57 76.5
vertex -47.5 -60.5 30
vertex -47.5 -60.5 28.5
endloop
endfacet
facet normal 1 -0 0
outer loop
vertex -47.5 -54.5 64.5
vertex -47.5 -60.5 23.5
vertex -47.5 -60 23.5
endloop
endfacet
facet normal 1 -0 0
outer loop
vertex -47.5 -47 33.5
vertex -47.5 -49.5 30
vertex -47.5 -42.5 33.5
endloop
endfacet
facet normal 1 -0 0
outer loop
vertex -47.5 -47 33.5
vertex -47.5 -42.5 33.5
vertex -47.5 -41 35.5
endloop
endfacet
facet normal 1 0 0
outer loop
vertex -47.5 -37 29.5
vertex -47.5 -42.5 33.5
vertex -47.5 -49.5 30
endloop
endfacet
facet normal 1 0 -0
outer loop
vertex -47.5 -60.5 23.5
vertex -47.5 -51 29
vertex -47.5 -60 23.5
endloop
endfacet
facet normal 1 0 0
outer loop
vertex -47.5 -49.5 30
vertex -47.5 -51 29
vertex -47.5 -41 23.5
endloop
endfacet
facet normal 1 -0 0
outer loop
vertex -47.5 -51 29
vertex -47.5 -60.5 23.5
vertex -47.5 -41 23.5
endloop
endfacet
facet normal 1 -0 0
outer loop
vertex -47.5 -49.5 30
vertex -47.5 -41 23.5
vertex -47.5 -37 29.5
endloop
endfacet
facet normal 1 -0 0
outer loop
vertex -47.5 -37 29.5
vertex -47.5 -41 23.5
vertex -47.5 -36.5 29.5
endloop
endfacet
facet normal 0 1 0
outer loop
vertex -22 -60.5 144.5
vertex -22 -60.5 23.5
vertex -23 -60.5 23.5
endloop
endfacet
facet normal 0 0 1
outer loop
vertex -22 -60.5 23.5
vertex -23 60.5 23.5
vertex -23 -60.5 23.5
endloop
endfacet
facet normal 0 -0 1
outer loop
vertex -22 -60.5 23.5
vertex -22 -42 23.5
vertex -23 60.5 23.5
endloop
endfacet
facet normal 1 0 -0
outer loop
vertex -47.5 51 83
vertex -47.5 56.5 83
vertex -47.5 51 85
endloop
endfacet
facet normal 1 -0 0
outer loop
vertex -47.5 55.5 68
vertex -47.5 55.5 65.5
vertex -47.5 56 70.5
endloop
endfacet
facet normal 1 0 -0
outer loop
vertex -47.5 53 34
vertex -47.5 56 70.5
vertex -47.5 55.5 65.5
endloop
endfacet
facet normal 1 -0 0
outer loop
vertex -47.5 44.5 41
vertex -47.5 44 33
vertex -47.5 45 39.5
endloop
endfacet
facet normal 1 0 0
outer loop
vertex -47.5 45 40.5
vertex -47.5 44.5 41
vertex -47.5 52.5 34
endloop
endfacet
facet normal 1 0 0
outer loop
vertex -47.5 52.5 34
vertex -47.5 44.5 41
vertex -47.5 45 39.5
endloop
endfacet
facet normal 1 -0 0
outer loop
vertex -47.5 45 40.5
vertex -47.5 52.5 34
vertex -47.5 52.5 34.5
endloop
endfacet
facet normal 1 -0 0
outer loop
vertex -47.5 44.5 41
vertex -47.5 42 23.5
vertex -47.5 44 33
endloop
endfacet
facet normal 1 -0 0
outer loop
vertex -47.5 53 34
vertex -47.5 53.5 33.5
vertex -47.5 56 70.5
endloop
endfacet
facet normal 1 0 0
outer loop
vertex -47.5 52 29
vertex -47.5 44 33
vertex -47.5 42 23.5
endloop
endfacet
facet normal 1 0 -0
outer loop
vertex -47.5 42 23.5
vertex -47.5 52.5 29
vertex -47.5 52 29
endloop
endfacet
facet normal 1 0 0
outer loop
vertex -47.5 42 23.5
vertex -47.5 52.5 23.5
vertex -47.5 52.5 29
endloop
endfacet
facet normal 1 0 0
outer loop
vertex -47.5 52.5 29
vertex -47.5 52.5 29
vertex -47.5 52.5 23.5
endloop
endfacet
facet normal 1 -0 0
outer loop
vertex -47.5 52.5 29
vertex -47.5 52.5 23.5
vertex -47.5 53 29
endloop
endfacet
facet normal 0 -1 0
outer loop
vertex -23 60.5 23.5
vertex -22 60.5 23.5
vertex -23 60.5 144.5
endloop
endfacet
facet normal 0 -0 1
outer loop
vertex -22 -42 23.5
vertex -22 60.5 23.5
vertex -23 60.5 23.5
endloop
endfacet
facet normal 0 0.7 -0.7
outer loop
vertex -50 -34 131
vertex -47.5 -34 131
vertex -50 -40 125
endloop
endfacet
facet normal -0 0.7 -0.7
outer loop
vertex -47.5 -45.5 119.5
vertex -50 -47 118
vertex -47.5 -41 124
endloop
endfacet
facet normal 0 0.7 -0.7
outer loop
vertex -47.5 -40 125
vertex -50 -40 125
vertex -47.5 -34 131
endloop
endfacet
facet normal 0 0.7 -0.7
outer loop
vertex -50 -47 118
vertex -50 -41 124
vertex -47.5 -41 124
endloop
endfacet
facet normal 0 0.2 -1
outer loop
vertex -47.5 -18 139
vertex -50 -18 139
vertex -47.5 -1 142
endloop
endfacet
facet normal 0 0.2 -1
outer loop
vertex -50 -18 139
vertex -50 -1 142
vertex -47.5 -1 142
endloop
endfacet
facet normal 0 0.5 -0.9
outer loop
vertex -47.5 -34 131
vertex -50 -34 131
vertex -47.5 -18 139
endloop
endfacet
facet normal 0 0.5 -0.9
outer loop
vertex -50 -18 139
vertex -47.5 -18 139
vertex -50 -34 131
endloop
endfacet
facet normal -0 -1 -0
outer loop
vertex -47.5 -1 142
vertex -50 -1 142
vertex -47.5 -1 107
endloop
endfacet
facet normal 0 0.9 -0.5
outer loop
vertex -47.5 -55 102.5
vertex -50 -55 102
vertex -47.5 -47 118
endloop
endfacet
facet normal 0 0.9 -0.5
outer loop
vertex -47.5 -55 102.5
vertex -47.5 -55 102
vertex -50 -55 102
endloop
endfacet
facet normal 0 0.7 -0.7
outer loop
vertex -47.5 -46.5 118.5
vertex -50 -47 118
vertex -47.5 -45.5 119.5
endloop
endfacet
facet normal 0 0.7 -0.7
outer loop
vertex -47.5 -46.5 118.5
vertex -47.5 -47 118
vertex -50 -47 118
endloop
endfacet
facet normal 0 0.9 -0.5
outer loop
vertex -50 -47 118
vertex -47.5 -47 118
vertex -50 -55 102
endloop
endfacet
facet normal 0 1 -0.2
outer loop
vertex -50 -55 102
vertex -47.5 -55 102
vertex -50 -58 85
endloop
endfacet
facet normal -0 1 -0.2
outer loop
vertex -47.5 -55.5 100
vertex -50 -58 85
vertex -47.5 -55 102
endloop
endfacet
facet normal 0 1 -0.2
outer loop
vertex -47.5 -56 97.5
vertex -50 -58 85
vertex -47.5 -55.5 100
endloop
endfacet
facet normal 0 1 -0.2
outer loop
vertex -47.5 -56 97.5
vertex -47.5 -58 85
vertex -50 -58 85
endloop
endfacet
facet normal -0 0 1
outer loop
vertex -50 -58 85
vertex -47.5 -58 85
vertex -50 -23 85
endloop
endfacet
facet normal 0 0 1
outer loop
vertex -47.5 -56.5 85
vertex -50 -23 85
vertex -47.5 -58 85
endloop
endfacet
facet normal -0 0 1
outer loop
vertex -47.5 -56.5 85
vertex -47.5 -51 85
vertex -50 -23 85
endloop
endfacet
facet normal -0 0.7 0.7
outer loop
vertex -50 -40 125
vertex -47.5 -40 125
vertex -50 -15 100.5
endloop
endfacet
facet normal -0 -0.7 -0.7
outer loop
vertex -47.5 -41 124
vertex -50 -41 124
vertex -47.5 -16.5 99
endloop
endfacet
facet normal 0 -0.7 -0.7
outer loop
vertex -50 -41 124
vertex -50 -16.5 99
vertex -47.5 -16.5 99
endloop
endfacet
facet normal 0 0.7 0.7
outer loop
vertex -47.5 -15 100.5
vertex -50 -15 100.5
vertex -47.5 -40 125
endloop
endfacet
facet normal 0 -1 0
outer loop
vertex -50 -1 142
vertex -50 -1 107
vertex -47.5 -1 107
endloop
endfacet
facet normal 0 -0.7 0.7
outer loop
vertex -50 -11.5 104
vertex -47.5 -15 100.5
vertex -47.5 -11.5 104
endloop
endfacet
facet normal 0 -0.3 1
outer loop
vertex -50 -11.5 104
vertex -47.5 -11.5 104
vertex -50 -1 107
endloop
endfacet
facet normal 0 -0.3 1
outer loop
vertex -47.5 -1 107
vertex -50 -1 107
vertex -47.5 -11.5 104
endloop
endfacet
facet normal 0 -0.7 0.7
outer loop
vertex -50 -16.5 99
vertex -47.5 -20 95.5
vertex -47.5 -16.5 99
endloop
endfacet
facet normal 0 -0.7 0.7
outer loop
vertex -50 -20 95.5
vertex -47.5 -20 95.5
vertex -50 -16.5 99
endloop
endfacet
facet normal 0 0 1
outer loop
vertex -47.5 -51 85
vertex -47.5 -23 85
vertex -50 -23 85
endloop
endfacet
facet normal 0 -1 0.3
outer loop
vertex -47.5 -20 95.5
vertex -50 -20 95.5
vertex -47.5 -23 85
endloop
endfacet
facet normal 0 -1 0.3
outer loop
vertex -50 -23 85
vertex -47.5 -23 85
vertex -50 -20 95.5
endloop
endfacet
facet normal 0 -0.7 0.7
outer loop
vertex -50 -15 100.5
vertex -47.5 -15 100.5
vertex -50 -11.5 104
endloop
endfacet
facet normal 0 -0.2 -1
outer loop
vertex -50 1 142
vertex -47.5 18 139
vertex -47.5 1 142
endloop
endfacet
facet normal 0 -0.2 -1
outer loop
vertex -50 1 142
vertex -50 18 139
vertex -47.5 18 139
endloop
endfacet
facet normal 0 1 0
outer loop
vertex -50 1 107
vertex -50 1 142
vertex -47.5 1 142
endloop
endfacet
facet normal -0 -0.5 -0.9
outer loop
vertex -47.5 34 131
vertex -47.5 18 139
vertex -50 18 139
endloop
endfacet
facet normal 0 -0.5 -0.9
outer loop
vertex -50 18 139
vertex -50 34 131
vertex -47.5 34 131
endloop
endfacet
facet normal -0 -0.7 -0.7
outer loop
vertex -47.5 37 128
vertex -47.5 34 131
vertex -50 34 131
endloop
endfacet
facet normal 0 -0.7 -0.7
outer loop
vertex -50 40 125
vertex -47.5 40 125
vertex -50 34 131
endloop
endfacet
facet normal 0 -0.7 -0.7
outer loop
vertex -47.5 37 128
vertex -50 34 131
vertex -47.5 40 125.5
endloop
endfacet
facet normal -0 -0.7 -0.7
outer loop
vertex -47.5 40 125.5
vertex -50 34 131
vertex -47.5 40 125
endloop
endfacet
facet normal 0 -0.7 0.7
outer loop
vertex -47.5 38.5 123.5
vertex -47.5 40 125
vertex -50 40 125
endloop
endfacet
facet normal -0 -0.7 -0.7
outer loop
vertex -50 47 118
vertex -47.5 41 124
vertex -50 41 124
endloop
endfacet
facet normal 0 -0.7 -0.7
outer loop
vertex -47.5 41 124
vertex -50 47 118
vertex -47.5 47 118
endloop
endfacet
facet normal 0 1 -0
outer loop
vertex -47.5 1 107
vertex -50 1 107
vertex -47.5 1 142
endloop
endfacet
facet normal -0 0.3 1
outer loop
vertex -50 1 107
vertex -47.5 1 107
vertex -50 11.5 104
endloop
endfacet
facet normal -0 0.3 1
outer loop
vertex -47.5 9.5 104.5
vertex -50 11.5 104
vertex -47.5 1 107
endloop
endfacet
facet normal -0 0.7 0.7
outer loop
vertex -50 11.5 104
vertex -47.5 11.5 104
vertex -50 15 100.5
endloop
endfacet
facet normal -0 0.3 1
outer loop
vertex -47.5 9.5 104.5
vertex -47.5 10 104.5
vertex -50 11.5 104
endloop
endfacet
facet normal 0 0.3 1
outer loop
vertex -47.5 10 104.5
vertex -47.5 11.5 104
vertex -50 11.5 104
endloop
endfacet
facet normal 0 0.7 -0.7
outer loop
vertex -50 41 124
vertex -47.5 41 124
vertex -50 16.5 99
endloop
endfacet
facet normal 0 -0.7 0.7
outer loop
vertex -47.5 19.5 104.5
vertex -47.5 38.5 123.5
vertex -50 40 125
endloop
endfacet
facet normal 0 0.7 -0.7
outer loop
vertex -47.5 29.5 112.5
vertex -50 16.5 99
vertex -47.5 41 124
endloop
endfacet
facet normal 0 -0.7 0.7
outer loop
vertex -50 15 100.5
vertex -47.5 15 100.5
vertex -50 40 125
endloop
endfacet
facet normal -0 -0.7 0.7
outer loop
vertex -47.5 19.5 104.5
vertex -50 40 125
vertex -47.5 15 100.5
endloop
endfacet
facet normal -0 0.7 -0.7
outer loop
vertex -47.5 28 111
vertex -50 16.5 99
vertex -47.5 29.5 112.5
endloop
endfacet
facet normal 0 0.7 -0.7
outer loop
vertex -47.5 28 111
vertex -47.5 16.5 99
vertex -50 16.5 99
endloop
endfacet
facet normal 0 0.7 0.7
outer loop
vertex -47.5 11.5 104
vertex -47.5 15 100.5
vertex -50 15 100.5
endloop
endfacet
facet normal -0 0.7 0.7
outer loop
vertex -50 16.5 99
vertex -47.5 16.5 99
vertex -50 20 95.5
endloop
endfacet
facet normal 0 0.7 0.7
outer loop
vertex -47.5 16.5 99
vertex -47.5 20 95.5
vertex -50 20 95.5
endloop
endfacet
facet normal -0 1 0.3
outer loop
vertex -50 20 95.5
vertex -47.5 20 95.5
vertex -50 23 85
endloop
endfacet
facet normal 0 1 0.3
outer loop
vertex -47.5 23 85
vertex -50 23 85
vertex -47.5 20 95.5
endloop
endfacet
facet normal 0 -0 1
outer loop
vertex -50 23 85
vertex -47.5 23 85
vertex -50 58 85
endloop
endfacet
facet normal -0 -0.9 -0.5
outer loop
vertex -47.5 54 104
vertex -47.5 47 118
vertex -50 47 118
endloop
endfacet
facet normal -0 -0.9 -0.5
outer loop
vertex -47.5 54 104
vertex -50 47 118
vertex -47.5 54.5 103.5
endloop
endfacet
facet normal 0 -0.9 -0.5
outer loop
vertex -50 47 118
vertex -50 55 102
vertex -47.5 55 102
endloop
endfacet
facet normal 0 -0.9 -0.5
outer loop
vertex -47.5 54.5 103.5
vertex -50 47 118
vertex -47.5 55 102
endloop
endfacet
facet normal 0 0 1
outer loop
vertex -47.5 51 85
vertex -50 58 85
vertex -47.5 23 85
endloop
endfacet
facet normal -0 -1 -0.2
outer loop
vertex -47.5 57 91.5
vertex -47.5 55 102
vertex -50 55 102
endloop
endfacet
facet normal -0 -1 -0.2
outer loop
vertex -47.5 57 91.5
vertex -50 55 102
vertex -47.5 57 89.5
endloop
endfacet
facet normal 0 -1 -0.2
outer loop
vertex -50 58 85
vertex -47.5 58 85
vertex -50 55 102
endloop
endfacet
facet normal 0 -1 -0.2
outer loop
vertex -47.5 57 89.5
vertex -50 55 102
vertex -47.5 58 85
endloop
endfacet
facet normal 0 -0 1
outer loop
vertex -47.5 51 85
vertex -47.5 57 85
vertex -50 58 85
endloop
endfacet
facet normal 0 -0 1
outer loop
vertex -47.5 57 85
vertex -47.5 58 85
vertex -50 58 85
endloop
endfacet
facet normal -0 -0 -1
outer loop
vertex -47.5 -57 83
vertex -47.5 -58 83
vertex -50 -58 83
endloop
endfacet
facet normal -0 0 -1
outer loop
vertex -47.5 -57 83
vertex -50 -58 83
vertex -47.5 -51 83
endloop
endfacet
facet normal -0 1 0.2
outer loop
vertex -50 -58 83
vertex -47.5 -58 83
vertex -50 -55 66
endloop
endfacet
facet normal -0 1 0.2
outer loop
vertex -47.5 -57 78.5
vertex -50 -55 66
vertex -47.5 -58 83
endloop
endfacet
facet normal -0 1 0.2
outer loop
vertex -47.5 -57 78.5
vertex -47.5 -57 76.5
vertex -50 -55 66
endloop
endfacet
facet normal 0 1 0.2
outer loop
vertex -47.5 -57 76.5
vertex -47.5 -55 66
vertex -50 -55 66
endloop
endfacet
facet normal -0 0 -1
outer loop
vertex -47.5 -51 83
vertex -50 -58 83
vertex -47.5 -23 83
endloop
endfacet
facet normal -0 0.9 0.5
outer loop
vertex -50 -55 66
vertex -47.5 -55 66
vertex -50 -47 50
endloop
endfacet
facet normal 0 0.9 0.5
outer loop
vertex -47.5 -54.5 64.5
vertex -50 -47 50
vertex -47.5 -55 66
endloop
endfacet
facet normal -0 0.9 0.5
outer loop
vertex -47.5 -54.5 64.5
vertex -47.5 -54 64
vertex -50 -47 50
endloop
endfacet
facet normal 0 0.9 0.5
outer loop
vertex -47.5 -54 64
vertex -47.5 -47 50
vertex -50 -47 50
endloop
endfacet
facet normal 0 0 -1
outer loop
vertex -50 -58 83
vertex -50 -23 83
vertex -47.5 -23 83
endloop
endfacet
facet normal -0 -1 -0.3
outer loop
vertex -47.5 -23 83
vertex -50 -23 83
vertex -47.5 -20 72.5
endloop
endfacet
facet normal 0 -1 -0.3
outer loop
vertex -50 -23 83
vertex -50 -20 72.5
vertex -47.5 -20 72.5
endloop
endfacet
facet normal -0 -0.7 -0.7
outer loop
vertex -47.5 -18 70.5
vertex -47.5 -20 72.5
vertex -50 -20 72.5
endloop
endfacet
facet normal 0 -0.7 -0.7
outer loop
vertex -47.5 -18 70.5
vertex -50 -20 72.5
vertex -47.5 -17.5 70
endloop
endfacet
facet normal 0 -0.7 -0.7
outer loop
vertex -50 -20 72.5
vertex -50 -16.5 69
vertex -47.5 -16.5 69
endloop
endfacet
facet normal 0 -0.7 -0.7
outer loop
vertex -47.5 -17.5 70
vertex -50 -20 72.5
vertex -47.5 -16.5 69
endloop
endfacet
facet normal -0 -0.7 -0.7
outer loop
vertex -47.5 -11.5 64
vertex -47.5 -15 67.5
vertex -50 -15 67.5
endloop
endfacet
facet normal 0 -0.7 0.7
outer loop
vertex -47.5 -28 57
vertex -47.5 -16.5 69
vertex -50 -16.5 69
endloop
endfacet
facet normal 0 0.7 -0.7
outer loop
vertex -50 -15 67.5
vertex -47.5 -15 67.5
vertex -50 -40 43
endloop
endfacet
facet normal -0 -0.7 0.7
outer loop
vertex -47.5 -29.5 55.5
vertex -47.5 -28 57
vertex -50 -16.5 69
endloop
endfacet
facet normal 0 0.7 -0.7
outer loop
vertex -47.5 -19.5 63.5
vertex -50 -40 43
vertex -47.5 -15 67.5
endloop
endfacet
facet normal 0 -0.7 0.7
outer loop
vertex -47.5 -29.5 55.5
vertex -50 -16.5 69
vertex -47.5 -41 44
endloop
endfacet
facet normal 0 -0.7 0.7
outer loop
vertex -47.5 -41 44
vertex -50 -16.5 69
vertex -50 -41 44
endloop
endfacet
facet normal -0 0.7 -0.7
outer loop
vertex -47.5 -38.5 44.5
vertex -50 -40 43
vertex -47.5 -19.5 63.5
endloop
endfacet
facet normal 0 -0.7 -0.7
outer loop
vertex -47.5 -11.5 64
vertex -50 -15 67.5
vertex -50 -11.5 64
endloop
endfacet
facet normal -0 -0.3 -1
outer loop
vertex -47.5 -10 63.5
vertex -47.5 -11.5 64
vertex -50 -11.5 64
endloop
endfacet
facet normal 0 -0.3 -1
outer loop
vertex -47.5 -10 63.5
vertex -50 -11.5 64
vertex -47.5 -9.5 63.5
endloop
endfacet
facet normal 0 -0.3 -1
outer loop
vertex -50 -11.5 64
vertex -50 -1 61
vertex -47.5 -1 61
endloop
endfacet
facet normal -0 -0.3 -1
outer loop
vertex -47.5 -9.5 63.5
vertex -50 -11.5 64
vertex -47.5 -1 61
endloop
endfacet
facet normal -0 -1 -0
outer loop
vertex -47.5 -1 61
vertex -50 -1 61
vertex -47.5 -1 26
endloop
endfacet
facet normal -0 0.7 0.7
outer loop
vertex -47.5 -41 44
vertex -50 -47 50
vertex -47.5 -47 50
endloop
endfacet
facet normal 0 0.7 0.7
outer loop
vertex -50 -47 50
vertex -47.5 -41 44
vertex -50 -41 44
endloop
endfacet
facet normal 0 0.7 -0.7
outer loop
vertex -47.5 -38.5 44.5
vertex -47.5 -40 43
vertex -50 -40 43
endloop
endfacet
facet normal -0 0.7 0.7
outer loop
vertex -50 -40 43
vertex -47.5 -40 43
vertex -50 -34 37
endloop
endfacet
facet normal 0 0.7 0.7
outer loop
vertex -47.5 -40 43
vertex -47.5 -34 37
vertex -50 -34 37
endloop
endfacet
facet normal -0 0.5 0.9
outer loop
vertex -50 -34 37
vertex -47.5 -34 37
vertex -50 -18 29
endloop
endfacet
facet normal 0 0.5 0.9
outer loop
vertex -47.5 -34 37
vertex -47.5 -18 29
vertex -50 -18 29
endloop
endfacet
facet normal 0 -1 0
outer loop
vertex -50 -1 61
vertex -50 -1 26
vertex -47.5 -1 26
endloop
endfacet
facet normal -0 0.2 1
outer loop
vertex -50 -18 29
vertex -47.5 -18 29
vertex -50 -1 26
endloop
endfacet
facet normal 0 0.2 1
outer loop
vertex -47.5 -1 26
vertex -50 -1 26
vertex -47.5 -18 29
endloop
endfacet
facet normal 0 0.7 -0.7
outer loop
vertex -50 11.5 64
vertex -50 15 67.5
vertex -47.5 15 67.5
endloop
endfacet
facet normal 0 1 -0.3
outer loop
vertex -47.5 20 72.5
vertex -50 23 83
vertex -47.5 23 83
endloop
endfacet
facet normal 0 1 -0.3
outer loop
vertex -50 20 72.5
vertex -50 23 83
vertex -47.5 20 72.5
endloop
endfacet
facet normal -0 -0 -1
outer loop
vertex -47.5 51 83
vertex -47.5 23 83
vertex -50 23 83
endloop
endfacet
facet normal 0 0.7 -0.7
outer loop
vertex -50 20 72.5
vertex -47.5 20 72.5
vertex -50 16.5 69
endloop
endfacet
facet normal 0 0.7 -0.7
outer loop
vertex -47.5 16.5 69
vertex -50 16.5 69
vertex -47.5 20 72.5
endloop
endfacet
facet normal 0 0.3 -1
outer loop
vertex -50 1 61
vertex -50 11.5 64
vertex -47.5 11.5 64
endloop
endfacet
facet normal 0 0.3 -1
outer loop
vertex -47.5 1 61
vertex -50 1 61
vertex -47.5 11.5 64
endloop
endfacet
facet normal 0 0.7 -0.7
outer loop
vertex -47.5 11.5 64
vertex -50 11.5 64
vertex -47.5 15 67.5
endloop
endfacet
facet normal -0 1 0
outer loop
vertex -50 1 61
vertex -47.5 1 61
vertex -50 1 26
endloop
endfacet
facet normal -0 0.7 0.7
outer loop
vertex -50 16.5 69
vertex -47.5 16.5 69
vertex -50 41 44
endloop
endfacet
facet normal -0 -0.7 -0.7
outer loop
vertex -47.5 15 67.5
vertex -50 15 67.5
vertex -47.5 40 43
endloop
endfacet
facet normal 0 -0.7 -0.7
outer loop
vertex -50 15 67.5
vertex -50 40 43
vertex -47.5 40 43
endloop
endfacet
facet normal 0 0.7 0.7
outer loop
vertex -47.5 41 44
vertex -50 41 44
vertex -47.5 16.5 69
endloop
endfacet
facet normal 0 0 -1
outer loop
vertex -50 23 83
vertex -50 58 83
vertex -47.5 58 83
endloop
endfacet
facet normal -0 0 -1
outer loop
vertex -47.5 51 83
vertex -50 23 83
vertex -47.5 56.5 83
endloop
endfacet
facet normal -0 0 -1
outer loop
vertex -47.5 56.5 83
vertex -50 23 83
vertex -47.5 58 83
endloop
endfacet
facet normal 0 -1 0.2
outer loop
vertex -47.5 56 70.5
vertex -47.5 58 83
vertex -50 58 83
endloop
endfacet
facet normal 0 -1 0.2
outer loop
vertex -50 58 83
vertex -50 55 66
vertex -47.5 55 66
endloop
endfacet
facet normal 0 -1 0.2
outer loop
vertex -47.5 55.5 68
vertex -47.5 56 70.5
vertex -50 58 83
endloop
endfacet
facet normal -0 -1 0.2
outer loop
vertex -47.5 55.5 68
vertex -50 58 83
vertex -47.5 55 66
endloop
endfacet
facet normal 0 -0.9 0.5
outer loop
vertex -50 55 66
vertex -50 47 50
vertex -47.5 47 50
endloop
endfacet
facet normal 0 -0.9 0.5
outer loop
vertex -47.5 47 50
vertex -47.5 55 66
vertex -50 55 66
endloop
endfacet
facet normal 0 1 -0
outer loop
vertex -47.5 1 26
vertex -50 1 26
vertex -47.5 1 61
endloop
endfacet
facet normal 0 -0.5 0.9
outer loop
vertex -50 18 29
vertex -47.5 18 29
vertex -50 34 37
endloop
endfacet
facet normal 0 -0.5 0.9
outer loop
vertex -47.5 34 37
vertex -50 34 37
vertex -47.5 18 29
endloop
endfacet
facet normal 0 -0.2 1
outer loop
vertex -50 1 26
vertex -47.5 1 26
vertex -50 18 29
endloop
endfacet
facet normal 0 -0.2 1
outer loop
vertex -47.5 18 29
vertex -50 18 29
vertex -47.5 1 26
endloop
endfacet
facet normal 0 -0.7 0.7
outer loop
vertex -50 41 44
vertex -47.5 41 44
vertex -50 47 50
endloop
endfacet
facet normal 0 -0.7 0.7
outer loop
vertex -47.5 40 43
vertex -50 40 43
vertex -47.5 34 37
endloop
endfacet
facet normal 0 -0.7 0.7
outer loop
vertex -47.5 41 44
vertex -47.5 47 50
vertex -50 47 50
endloop
endfacet
facet normal 0 -0.7 0.7
outer loop
vertex -50 34 37
vertex -47.5 34 37
vertex -50 40 43
endloop
endfacet
facet normal 0.9 0 -0.4
outer loop
vertex -40 67 41.5
vertex -41.5 69.5 39
vertex -40 69.5 41.5
endloop
endfacet
facet normal 0.9 0 -0.4
outer loop
vertex -40 67 41.5
vertex -41.5 67 39
vertex -41.5 69.5 39
endloop
endfacet
facet normal 0.4 0 -0.9
outer loop
vertex -40 67 41.5
vertex -40 69.5 41.5
vertex -37.5 67 43
endloop
endfacet
facet normal 0.4 0 -0.9
outer loop
vertex -37.5 67 43
vertex -40 69.5 41.5
vertex -37.5 69.5 43
endloop
endfacet
facet normal 0.9 0 0.4
outer loop
vertex -41.5 67 39
vertex -40 69.5 36.5
vertex -41.5 69.5 39
endloop
endfacet
facet normal 0.9 -0 0.4
outer loop
vertex -41.5 67 39
vertex -40 67 36.5
vertex -40 69.5 36.5
endloop
endfacet
facet normal 0.4 0 0.9
outer loop
vertex -40 67 36.5
vertex -37.5 69.5 35
vertex -40 69.5 36.5
endloop
endfacet
facet normal 0.4 -0 0.9
outer loop
vertex -40 67 36.5
vertex -37.5 67 35
vertex -37.5 69.5 35
endloop
endfacet
facet normal 0 0 -1
outer loop
vertex -37.5 67 43
vertex -37.5 69.5 43
vertex -32 67 43
endloop
endfacet
facet normal 0 0 -1
outer loop
vertex -32 67 43
vertex -37.5 69.5 43
vertex -32 69.5 43
endloop
endfacet
facet normal -0 0 1
outer loop
vertex -37.5 69.5 35
vertex -37.5 67 35
vertex -32 69.5 35
endloop
endfacet
facet normal 0 0 1
outer loop
vertex -37.5 67 35
vertex -32 67 35
vertex -32 69.5 35
endloop
endfacet
facet normal -0.4 0 -0.9
outer loop
vertex -31.5 67 42.5
vertex -32 67 43
vertex -32 69.5 43
endloop
endfacet
facet normal -0.4 -0 -0.9
outer loop
vertex -31.5 67 42.5
vertex -32 69.5 43
vertex -29.5 65.5 41.5
endloop
endfacet
facet normal -0.4 -0 -0.9
outer loop
vertex -32 69.5 43
vertex -29.5 69.5 41.5
vertex -29.5 65.5 41.5
endloop
endfacet
facet normal -0.9 0 -0.4
outer loop
vertex -29.5 65.5 41.5
vertex -29.5 69.5 41.5
vertex -28.5 64.5 39
endloop
endfacet
facet normal -0.4 0 0.9
outer loop
vertex -31.5 67 35.5
vertex -32 69.5 35
vertex -32 67 35
endloop
endfacet
facet normal -0.4 -0 0.9
outer loop
vertex -31.5 67 35.5
vertex -29.5 69.5 36.5
vertex -32 69.5 35
endloop
endfacet
facet normal -0.4 0 0.9
outer loop
vertex -31.5 67 35.5
vertex -29.5 65.5 36.5
vertex -29.5 69.5 36.5
endloop
endfacet
facet normal -0.9 0 0.4
outer loop
vertex -28.5 69.5 39
vertex -29.5 69.5 36.5
vertex -29.5 65.5 36.5
endloop
endfacet
facet normal -0.9 -0 -0.4
outer loop
vertex -29.5 69.5 41.5
vertex -28.5 69.5 39
vertex -28.5 64.5 39
endloop
endfacet
facet normal -0.9 0 0.4
outer loop
vertex -28.5 69.5 39
vertex -29.5 65.5 36.5
vertex -28.5 64.5 39
endloop
endfacet
facet normal -0.9 -0.4 0
outer loop
vertex -42 -68.5 155
vertex -42 -68.5 157
vertex -43 -65.5 155
endloop
endfacet
facet normal 0 0 -1
outer loop
vertex -42 -68.5 155
vertex -43 -65.5 155
vertex -42 -65.5 155
endloop
endfacet
facet normal 0 0 -1
outer loop
vertex -42 -68.5 155
vertex -42 -65.5 155
vertex -39 -69.5 155
endloop
endfacet
facet normal -0.4 -0.9 0
outer loop
vertex -42 -68.5 155
vertex -39 -69.5 155
vertex -42 -68.5 157
endloop
endfacet
facet normal -0.9 -0.4 0
outer loop
vertex -43 -65.5 155
vertex -42 -68.5 157
vertex -43 -65.5 157
endloop
endfacet
facet normal -0.4 -0.9 0
outer loop
vertex -39 -69.5 155
vertex -39 -69.5 157
vertex -42 -68.5 157
endloop
endfacet
facet normal -0.7 -0.3 0.7
outer loop
vertex -42 -68.5 157
vertex -41 -67.5 158
vertex -43 -65.5 157
endloop
endfacet
facet normal -0.7 -0.3 0.7
outer loop
vertex -43 -65.5 157
vertex -41 -67.5 158
vertex -42 -65.5 158
endloop
endfacet
facet normal -0.3 -0.7 0.7
outer loop
vertex -42 -68.5 157
vertex -39 -69.5 157
vertex -41 -67.5 158
endloop
endfacet
facet normal 0 0 1
outer loop
vertex -42 -65.5 158
vertex -41 -67.5 158
vertex -39 -68.5 158
endloop
endfacet
facet normal -0 0 1
outer loop
vertex -42 -65.5 158
vertex -40 -61.5 158
vertex -41 -60.5 158
endloop
endfacet
facet normal -0.3 -0.7 0.7
outer loop
vertex -41 -67.5 158
vertex -39 -69.5 157
vertex -39 -68.5 158
endloop
endfacet
facet normal -0 0 -1
outer loop
vertex -39 -69.5 155
vertex -38.5 -47 155
vertex -38 -48.5 155
endloop
endfacet
facet normal 0 -0 -1
outer loop
vertex -39 -69.5 155
vertex -38 -48.5 155
vertex -25 -48.5 155
endloop
endfacet
facet normal 0 0 1
outer loop
vertex -35 -54.5 158
vertex -37 -48.5 158
vertex -36 -53.5 158
endloop
endfacet
facet normal 0 -0 1
outer loop
vertex -40 -53.5 158
vertex -37 -48.5 158
vertex -38 -48 158
endloop
endfacet
facet normal 0 -0 1
outer loop
vertex -40 -53.5 158
vertex -38 -48 158
vertex -38.5 -47 158
endloop
endfacet
facet normal 0 -0 1
outer loop
vertex -40 -53.5 158
vertex -36 -53.5 158
vertex -37 -48.5 158
endloop
endfacet
facet normal 0 0 -1
outer loop
vertex -39 -69.5 155
vertex -25 -48.5 155
vertex -18 -51 155
endloop
endfacet
facet normal 0 0 -1
outer loop
vertex -39 -69.5 155
vertex -18 -51 155
vertex -16.5 -51.5 155
endloop
endfacet
facet normal 0 -0 1
outer loop
vertex -35 -54.5 158
vertex -16.5 -51.5 158
vertex -17.5 -51 158
endloop
endfacet
facet normal 0 0 1
outer loop
vertex -35 -54.5 158
vertex -24 -48.5 158
vertex -37 -48.5 158
endloop
endfacet
facet normal -0 -0 -1
outer loop
vertex -23.5 -48 155
vertex -18 -51 155
vertex -25 -48.5 155
endloop
endfacet
facet normal -0 -0 -1
outer loop
vertex -23 -47 155
vertex -18 -51 155
vertex -23.5 -48 155
endloop
endfacet
facet normal 0 0 -1
outer loop
vertex -24 -45.5 155
vertex -18 -51 155
vertex -23 -47 155
endloop
endfacet
facet normal -0 0 1
outer loop
vertex -35 -54.5 158
vertex -17.5 -51 158
vertex -24 -48.5 158
endloop
endfacet
facet normal -0 -0 1
outer loop
vertex -24 -48.5 158
vertex -18 -50 158
vertex -23 -47 158
endloop
endfacet
facet normal -0 -0 1
outer loop
vertex -23 -47 158
vertex -18 -50 158
vertex -23.5 -46 158
endloop
endfacet
facet normal 0 0 -1
outer loop
vertex -43 -65.5 155
vertex -43 65.5 155
vertex -42 -65.5 155
endloop
endfacet
facet normal 0 0 -1
outer loop
vertex -42 -65.5 155
vertex -42 68.5 155
vertex -39 -69.5 155
endloop
endfacet
facet normal -1 0 0
outer loop
vertex -43 -65.5 155
vertex -43 -65.5 157
vertex -43 65.5 157
endloop
endfacet
facet normal 0 -0 -1
outer loop
vertex -39 -69.5 155
vertex -37 45.5 155
vertex -38.5 -47 155
endloop
endfacet
facet normal -0.7 0 0.7
outer loop
vertex -43 -65.5 157
vertex -42 -65.5 158
vertex -43 65.5 157
endloop
endfacet
facet normal 0 -0 1
outer loop
vertex -42 -65.5 158
vertex -41 -60.5 158
vertex -41 67.5 158
endloop
endfacet
facet normal 0 -0 -1
outer loop
vertex -38.5 -47 155
vertex -37 45.5 155
vertex -38 -46 155
endloop
endfacet
facet normal 0 -0 1
outer loop
vertex -41 -60.5 158
vertex -41 -54.5 158
vertex -41 67.5 158
endloop
endfacet
facet normal 0 -0 1
outer loop
vertex -41 -54.5 158
vertex -40 -53.5 158
vertex -41 67.5 158
endloop
endfacet
facet normal 0 -0 1
outer loop
vertex -40 -53.5 158
vertex -38.5 -47 158
vertex -40 53.5 158
endloop
endfacet
facet normal 0 0 1
outer loop
vertex -40 53.5 158
vertex -38.5 -47 158
vertex -38 -45.5 158
endloop
endfacet
facet normal -0 -0 1
outer loop
vertex -40 53.5 158
vertex -38 -45.5 158
vertex -25 -45.5 158
endloop
endfacet
facet normal 0 0 1
outer loop
vertex -18 30 158
vertex -25 -45.5 158
vertex -23.5 -46 158
endloop
endfacet
facet normal 0 -0 -1
outer loop
vertex -38 -46 155
vertex -18 50 155
vertex -37 -45.5 155
endloop
endfacet
facet normal 0 -0 -1
outer loop
vertex -37 -45.5 155
vertex -18 50 155
vertex -24 -45.5 155
endloop
endfacet
facet normal 0 -0 1
outer loop
vertex -35 -54.5 158
vertex -11 -51.5 158
vertex -16.5 -51.5 158
endloop
endfacet
facet normal 0 -0 1
outer loop
vertex -35 -54.5 158
vertex -5.5 -51.5 158
vertex -11 -51.5 158
endloop
endfacet
facet normal 0 -1 0
outer loop
vertex -39 -69.5 155
vertex 39 -69.5 157
vertex -39 -69.5 157
endloop
endfacet
facet normal -0 -0 1
outer loop
vertex -42 -65.5 158
vertex 41 -67.5 158
vertex -40 -61.5 158
endloop
endfacet
facet normal 0 -0.7 0.7
outer loop
vertex -39 -69.5 157
vertex 39 -69.5 157
vertex -39 -68.5 158
endloop
endfacet
facet normal -0 0 1
outer loop
vertex -42 -65.5 158
vertex -39 -68.5 158
vertex 41 -67.5 158
endloop
endfacet
facet normal 0 0 1
outer loop
vertex -40 -61.5 158
vertex 41 -67.5 158
vertex -36 -61.5 158
endloop
endfacet
facet normal -0 -0 1
outer loop
vertex -18 -50 158
vertex -24 -48.5 158
vertex -17.5 -51 158
endloop
endfacet
facet normal 0 0 -1
outer loop
vertex -11 -51.5 155
vertex -15.5 -51 155
vertex -12 -51 155
endloop
endfacet
facet normal 0 0 -1
outer loop
vertex -15.5 -51 155
vertex -12.5 -50 155
vertex -12 -51 155
endloop
endfacet
facet normal -0 0 1
outer loop
vertex -16.5 -51.5 158
vertex -12 -51 158
vertex -15.5 -51 158
endloop
endfacet
facet normal -0 0 1
outer loop
vertex -15.5 -51 158
vertex -12 -51 158
vertex -15 -50 158
endloop
endfacet
facet normal 0 -0 1
outer loop
vertex -16.5 -51.5 158
vertex -11 -51.5 158
vertex -12 -51 158
endloop
endfacet
facet normal -0 -0 1
outer loop
vertex -36 -61.5 158
vertex 41 -67.5 158
vertex -35 -60.5 158
endloop
endfacet
facet normal -0 -0 1
outer loop
vertex -35 -60.5 158
vertex 41 -67.5 158
vertex -35 -54.5 158
endloop
endfacet
facet normal 0 0 -1
outer loop
vertex -39 -69.5 155
vertex -16.5 -51.5 155
vertex 42 -68.5 155
endloop
endfacet
facet normal 0 -0 1
outer loop
vertex -35 -54.5 158
vertex 35 -54.5 158
vertex -5.5 -51.5 158
endloop
endfacet
facet normal 0 0 -1
outer loop
vertex -10 -51 155
vertex -5.5 -51.5 155
vertex -11 -51.5 155
endloop
endfacet
facet normal -0 -0 -1
outer loop
vertex -10 -51 155
vertex -7 -50 155
vertex -6.5 -51 155
endloop
endfacet
facet normal -0 -0 -1
outer loop
vertex -10 -51 155
vertex -6.5 -51 155
vertex -5.5 -51.5 155
endloop
endfacet
facet normal -0 0 1
outer loop
vertex -11 -51.5 158
vertex -6.5 -51 158
vertex -10 -51 158
endloop
endfacet
facet normal -0 0 1
outer loop
vertex -10 -51 158
vertex -6.5 -51 158
vertex -9.5 -50 158
endloop
endfacet
facet normal 0 -0 1
outer loop
vertex -11 -51.5 158
vertex -5.5 -51.5 158
vertex -6.5 -51 158
endloop
endfacet
facet normal 0 0 -1
outer loop
vertex -4.5 -51 155
vertex 0 -51.5 155
vertex -5.5 -51.5 155
endloop
endfacet
facet normal -0 -0 -1
outer loop
vertex -4.5 -51 155
vertex -1.5 -50 155
vertex -1 -51 155
endloop
endfacet
facet normal -0 -0 -1
outer loop
vertex -4.5 -51 155
vertex -1 -51 155
vertex 0 -51.5 155
endloop
endfacet
facet normal 0 -0 1
outer loop
vertex -5.5 -51.5 158
vertex -1 -51 158
vertex -4.5 -51 158
endloop
endfacet
facet normal 0 -0 1
outer loop
vertex -4.5 -51 158
vertex -1.5 -50 158
vertex -4 -50 158
endloop
endfacet
facet normal 0 -0 1
outer loop
vertex -5.5 -51.5 158
vertex 0 -51.5 158
vertex -1 -51 158
endloop
endfacet
facet normal 0 -0 1
outer loop
vertex -4.5 -51 158
vertex -1 -51 158
vertex -1.5 -50 158
endloop
endfacet
facet normal 0 0 1
outer loop
vertex -18 30 158
vertex -23.5 -46 158
vertex -18 -50 158
endloop
endfacet
facet normal -0 -0 -1
outer loop
vertex -18 50 155
vertex -18 -51 155
vertex -24 -45.5 155
endloop
endfacet
facet normal 0 -0 -1
outer loop
vertex -15 50 155
vertex -12.5 -50 155
vertex -15.5 -51 155
endloop
endfacet
facet normal -0 0 1
outer loop
vertex -12.5 50 158
vertex -15 -50 158
vertex -12 -51 158
endloop
endfacet
facet normal -0 -0 -1
outer loop
vertex -9.5 50 155
vertex -7 -50 155
vertex -10 -51 155
endloop
endfacet
facet normal -0 0 1
outer loop
vertex -7 50 158
vertex -9.5 -50 158
vertex -6.5 -51 158
endloop
endfacet
facet normal -0 -0 -1
outer loop
vertex -4 50 155
vertex -1.5 -50 155
vertex -4.5 -51 155
endloop
endfacet
facet normal -0 0 1
outer loop
vertex -1.5 50 158
vertex -4 -50 158
vertex -1.5 -50 158
endloop
endfacet
facet normal 0 0 -1
outer loop
vertex -39 -69.5 155
vertex -38.5 47 155
vertex -38 46 155
endloop
endfacet
facet normal 0 0 -1
outer loop
vertex -39 -69.5 155
vertex -38 46 155
vertex -37 45.5 155
endloop
endfacet
facet normal 0 0 -1
outer loop
vertex -39 -69.5 155
vertex -42 68.5 155
vertex -38.5 47 155
endloop
endfacet
facet normal 0 0 -1
outer loop
vertex -38 -46 155
vertex -37 45.5 155
vertex -25 45.5 155
endloop
endfacet
facet normal 0 0 1
outer loop
vertex -25 -45.5 158
vertex -38 46 158
vertex -38.5 47 158
endloop
endfacet
facet normal 0 0 1
outer loop
vertex -25 -45.5 158
vertex -37 45.5 158
vertex -38 46 158
endloop
endfacet
facet normal 0 0 -1
outer loop
vertex -42 -65.5 155
vertex -43 65.5 155
vertex -42 68.5 155
endloop
endfacet
facet normal -1 0 0
outer loop
vertex -43 -65.5 155
vertex -43 65.5 157
vertex -43 65.5 155
endloop
endfacet
facet normal -0.7 0 0.7
outer loop
vertex -42 -65.5 158
vertex -42 65.5 158
vertex -43 65.5 157
endloop
endfacet
facet normal 0 -0 1
outer loop
vertex -42 -65.5 158
vertex -41 67.5 158
vertex -42 65.5 158
endloop
endfacet
facet normal 0 0 1
outer loop
vertex -40 -53.5 158
vertex -41 54.5 158
vertex -41 67.5 158
endloop
endfacet
facet normal 0 -0 1
outer loop
vertex -40 -53.5 158
vertex -40 53.5 158
vertex -41 54.5 158
endloop
endfacet
facet normal -0 -0 1
outer loop
vertex -40 53.5 158
vertex -25 -45.5 158
vertex -38.5 47 158
endloop
endfacet
facet normal 0 0 -1
outer loop
vertex -38 -46 155
vertex -25 45.5 155
vertex -23.5 46 155
endloop
endfacet
facet normal 0 0 -1
outer loop
vertex -38 -46 155
vertex -23.5 46 155
vertex -18 50 155
endloop
endfacet
facet normal 0 -0 1
outer loop
vertex -25 -45.5 158
vertex -18 30 158
vertex -37 45.5 158
endloop
endfacet
facet normal -0 0 1
outer loop
vertex -40 53.5 158
vertex -38.5 47 158
vertex -38 48 158
endloop
endfacet
facet normal -0 0 1
outer loop
vertex -40 53.5 158
vertex -38 48 158
vertex -37 48.5 158
endloop
endfacet
facet normal -0 0 1
outer loop
vertex -40 53.5 158
vertex -37 48.5 158
vertex -36 53.5 158
endloop
endfacet
facet normal -0 0 1
outer loop
vertex -36 53.5 158
vertex -37 48.5 158
vertex -25 48.5 158
endloop
endfacet
facet normal 0 -0 -1
outer loop
vertex -42 68.5 155
vertex -38 48 155
vertex -38.5 47 155
endloop
endfacet
facet normal 0 -0 -1
outer loop
vertex -42 68.5 155
vertex -37 48.5 155
vertex -38 48 155
endloop
endfacet
facet normal -0.9 0.4 0
outer loop
vertex -43 65.5 155
vertex -43 65.5 157
vertex -42 68.5 155
endloop
endfacet
facet normal -0.4 0.9 0
outer loop
vertex -42 68.5 155
vertex -42 68.5 157
vertex -39 69.5 155
endloop
endfacet
facet normal -0.9 0.4 0
outer loop
vertex -42 68.5 155
vertex -43 65.5 157
vertex -42 68.5 157
endloop
endfacet
facet normal -0.4 0.9 0
outer loop
vertex -39 69.5 155
vertex -42 68.5 157
vertex -39 69.5 157
endloop
endfacet
facet normal 0 -0 1
outer loop
vertex -41 54.5 158
vertex -41 60.5 158
vertex -41 67.5 158
endloop
endfacet
facet normal -0 -0 1
outer loop
vertex -41 60.5 158
vertex -40 61.5 158
vertex -41 67.5 158
endloop
endfacet
facet normal -0.7 0.3 0.7
outer loop
vertex -43 65.5 157
vertex -41 67.5 158
vertex -42 68.5 157
endloop
endfacet
facet normal -0.7 0.3 0.7
outer loop
vertex -43 65.5 157
vertex -42 65.5 158
vertex -41 67.5 158
endloop
endfacet
facet normal -0.3 0.7 0.7
outer loop
vertex -42 68.5 157
vertex -41 67.5 158
vertex -39 69.5 157
endloop
endfacet
facet normal 0 0 1
outer loop
vertex -41 67.5 158
vertex -40 61.5 158
vertex -36 61.5 158
endloop
endfacet
facet normal -0.3 0.7 0.7
outer loop
vertex -41 67.5 158
vertex -39 68.5 158
vertex -39 69.5 157
endloop
endfacet
facet normal -0 -0 -1
outer loop
vertex -42 68.5 155
vertex -25 48.5 155
vertex -37 48.5 155
endloop
endfacet
facet normal 0 0 1
outer loop
vertex -41 67.5 158
vertex -36 61.5 158
vertex -35 60.5 158
endloop
endfacet
facet normal -0 -0 1
outer loop
vertex -37 45.5 158
vertex -18 30 158
vertex -25 45.5 158
endloop
endfacet
facet normal -0 -0 1
outer loop
vertex -25 45.5 158
vertex -18 30 158
vertex -23.5 46 158
endloop
endfacet
facet normal 0 -0 -1
outer loop
vertex -23 47 155
vertex -18 50 155
vertex -23.5 46 155
endloop
endfacet
facet normal 0 -0 -1
outer loop
vertex -23.5 48 155
vertex -18 50 155
vertex -23 47 155
endloop
endfacet
facet normal -0 0 1
outer loop
vertex -35 54.5 158
vertex -25 48.5 158
vertex -18 51 158
endloop
endfacet
facet normal 0 -0 1
outer loop
vertex -23.5 46 158
vertex -18 51 158
vertex -23 47 158
endloop
endfacet
facet normal 0 -0 1
outer loop
vertex -23 47 158
vertex -18 51 158
vertex -23.5 48 158
endloop
endfacet
facet normal 0 -0 1
outer loop
vertex -23.5 48 158
vertex -18 51 158
vertex -25 48.5 158
endloop
endfacet
facet normal -0 -0 -1
outer loop
vertex -42 68.5 155
vertex -23.5 48 155
vertex -25 48.5 155
endloop
endfacet
facet normal 0 -0 -1
outer loop
vertex -42 68.5 155
vertex -18 50 155
vertex -23.5 48 155
endloop
endfacet
facet normal -0 -0 1
outer loop
vertex -36 53.5 158
vertex -25 48.5 158
vertex -35 54.5 158
endloop
endfacet
facet normal 0 -0 -1
outer loop
vertex -42 68.5 155
vertex -17.5 51 155
vertex -18 50 155
endloop
endfacet
facet normal 0 -0 -1
outer loop
vertex -42 68.5 155
vertex -16.5 51.5 155
vertex -17.5 51 155
endloop
endfacet
facet normal -0 0 1
outer loop
vertex -35 54.5 158
vertex -18 51 158
vertex -16.5 51.5 158
endloop
endfacet
facet normal 0 0 -1
outer loop
vertex -12.5 -50 155
vertex -15 50 155
vertex -12.5 50 155
endloop
endfacet
facet normal 0 0 1
outer loop
vertex -12.5 50 158
vertex -15 50 158
vertex -15 -50 158
endloop
endfacet
facet normal 0 0 -1
outer loop
vertex -7 -50 155
vertex -9.5 50 155
vertex -7 50 155
endloop
endfacet
facet normal 0 -0 1
outer loop
vertex -9.5 -50 158
vertex -7 50 158
vertex -9.5 50 158
endloop
endfacet
facet normal 0 0 -1
outer loop
vertex -1.5 -50 155
vertex -4 50 155
vertex -1.5 50 155
endloop
endfacet
facet normal 0 -0 1
outer loop
vertex -4 -50 158
vertex -1.5 50 158
vertex -4 50 158
endloop
endfacet
facet normal 0 -0 1
outer loop
vertex -18 30 158
vertex -18 51 158
vertex -23.5 46 158
endloop
endfacet
facet normal -0 -0 -1
outer loop
vertex -15.5 51 155
vertex -12.5 50 155
vertex -15 50 155
endloop
endfacet
facet normal 0 -0 -1
outer loop
vertex -15.5 51 155
vertex -12 51 155
vertex -12.5 50 155
endloop
endfacet
facet normal 0 0 -1
outer loop
vertex -12 51 155
vertex -15.5 51 155
vertex -11 51.5 155
endloop
endfacet
facet normal 0 -0 1
outer loop
vertex -15 50 158
vertex -12 51 158
vertex -15.5 51 158
endloop
endfacet
facet normal 0 -0 1
outer loop
vertex -15.5 51 158
vertex -11 51.5 158
vertex -16.5 51.5 158
endloop
endfacet
facet normal 0 0 1
outer loop
vertex -15 50 158
vertex -12.5 50 158
vertex -12 51 158
endloop
endfacet
facet normal 0 0 1
outer loop
vertex -15.5 51 158
vertex -12 51 158
vertex -11 51.5 158
endloop
endfacet
facet normal 0 -0 1
outer loop
vertex -35 54.5 158
vertex 35 60.5 158
vertex -35 60.5 158
endloop
endfacet
facet normal 0 0 -1
outer loop
vertex -42 68.5 155
vertex -39 69.5 155
vertex 39 69.5 155
endloop
endfacet
facet normal 0 1 0
outer loop
vertex -39 69.5 155
vertex -39 69.5 157
vertex 39 69.5 157
endloop
endfacet
facet normal -0 0 1
outer loop
vertex -41 67.5 158
vertex -35 60.5 158
vertex 35 60.5 158
endloop
endfacet
facet normal 0 -0 1
outer loop
vertex -41 67.5 158
vertex 39 68.5 158
vertex -39 68.5 158
endloop
endfacet
facet normal -0 0.7 0.7
outer loop
vertex -39 69.5 157
vertex -39 68.5 158
vertex 39 68.5 158
endloop
endfacet
facet normal -0 -0 -1
outer loop
vertex -10 51 155
vertex -7 50 155
vertex -9.5 50 155
endloop
endfacet
facet normal -0 -0 -1
outer loop
vertex -11 51.5 155
vertex -6.5 51 155
vertex -10 51 155
endloop
endfacet
facet normal 0 -0 -1
outer loop
vertex -10 51 155
vertex -6.5 51 155
vertex -7 50 155
endloop
endfacet
facet normal 0 -0 -1
outer loop
vertex -11 51.5 155
vertex -5.5 51.5 155
vertex -6.5 51 155
endloop
endfacet
facet normal 0 -0 1
outer loop
vertex -10 51 158
vertex -5.5 51.5 158
vertex -11 51.5 158
endloop
endfacet
facet normal 0 -0 1
outer loop
vertex -9.5 50 158
vertex -6.5 51 158
vertex -10 51 158
endloop
endfacet
facet normal 0 0 1
outer loop
vertex -9.5 50 158
vertex -7 50 158
vertex -6.5 51 158
endloop
endfacet
facet normal 0 0 1
outer loop
vertex -10 51 158
vertex -6.5 51 158
vertex -5.5 51.5 158
endloop
endfacet
facet normal -0 -0 -1
outer loop
vertex -5.5 51.5 155
vertex -1 51 155
vertex -4.5 51 155
endloop
endfacet
facet normal -0 -0 -1
outer loop
vertex -4.5 51 155
vertex -1.5 50 155
vertex -4 50 155
endloop
endfacet
facet normal 0 -0 -1
outer loop
vertex -4.5 51 155
vertex -1 51 155
vertex -1.5 50 155
endloop
endfacet
facet normal 0 -0 -1
outer loop
vertex -5.5 51.5 155
vertex 0 51.5 155
vertex -1 51 155
endloop
endfacet
facet normal 0 -0 1
outer loop
vertex -4 50 158
vertex -1 51 158
vertex -4.5 51 158
endloop
endfacet
facet normal 0 -0 1
outer loop
vertex -4.5 51 158
vertex 0 51.5 158
vertex -5.5 51.5 158
endloop
endfacet
facet normal 0 0 1
outer loop
vertex -4 50 158
vertex -1.5 50 158
vertex -1 51 158
endloop
endfacet
facet normal 0 0 1
outer loop
vertex -4.5 51 158
vertex -1 51 158
vertex 0 51.5 158
endloop
endfacet
facet normal -0 0 1
outer loop
vertex -35 54.5 158
vertex -16.5 51.5 158
vertex 35 60.5 158
endloop
endfacet
facet normal 0 -0 -1
outer loop
vertex -42 68.5 155
vertex 39 69.5 155
vertex -16.5 51.5 155
endloop
endfacet
facet normal 0 0 -1
outer loop
vertex 42 -68.5 155
vertex -16.5 -51.5 155
vertex -15.5 -51 155
endloop
endfacet
facet normal 0 0 -1
outer loop
vertex 42 -68.5 155
vertex -15.5 -51 155
vertex -11 -51.5 155
endloop
endfacet
facet normal 0 0 -1
outer loop
vertex 42 -68.5 155
vertex -11 -51.5 155
vertex -5.5 -51.5 155
endloop
endfacet
facet normal 0 0 1
outer loop
vertex 35 -54.5 158
vertex 0 -51.5 158
vertex -5.5 -51.5 158
endloop
endfacet
facet normal 0 0 -1
outer loop
vertex 0 -51.5 155
vertex 1 -51 155
vertex 5.5 -51.5 155
endloop
endfacet
facet normal -0 -0 -1
outer loop
vertex 1.5 -50 155
vertex 4.5 -51 155
vertex 1 -51 155
endloop
endfacet
facet normal 0 0 -1
outer loop
vertex 1.5 -50 155
vertex 4 -50 155
vertex 4.5 -51 155
endloop
endfacet
facet normal 0 0 -1
outer loop
vertex 1 -51 155
vertex 4.5 -51 155
vertex 5.5 -51.5 155
endloop
endfacet
facet normal 0 -0 1
outer loop
vertex 0 -51.5 158
vertex 4.5 -51 158
vertex 1 -51 158
endloop
endfacet
facet normal 0 -0 1
outer loop
vertex 1 -51 158
vertex 4 -50 158
vertex 1.5 -50 158
endloop
endfacet
facet normal 0 -0 1
outer loop
vertex 0 -51.5 158
vertex 5.5 -51.5 158
vertex 4.5 -51 158
endloop
endfacet
facet normal 0 -0 1
outer loop
vertex 1 -51 158
vertex 4.5 -51 158
vertex 4 -50 158
endloop
endfacet
facet normal -0 -0 -1
outer loop
vertex 6.5 -51 155
vertex 11 -51.5 155
vertex 5.5 -51.5 155
endloop
endfacet
facet normal -0 -0 -1
outer loop
vertex 7 -50 155
vertex 10 -51 155
vertex 6.5 -51 155
endloop
endfacet
facet normal 0 0 -1
outer loop
vertex 6.5 -51 155
vertex 10 -51 155
vertex 11 -51.5 155
endloop
endfacet
facet normal 0 0 -1
outer loop
vertex 7 -50 155
vertex 9.5 -50 155
vertex 10 -51 155
endloop
endfacet
facet normal 0 -0 1
outer loop
vertex 5.5 -51.5 158
vertex 10 -51 158
vertex 6.5 -51 158
endloop
endfacet
facet normal 0 -0 1
outer loop
vertex 6.5 -51 158
vertex 9.5 -50 158
vertex 7 -50 158
endloop
endfacet
facet normal 0 -0 1
outer loop
vertex 6.5 -51 158
vertex 10 -51 158
vertex 9.5 -50 158
endloop
endfacet
facet normal 0 -0 1
outer loop
vertex 5.5 -51.5 158
vertex 11 -51.5 158
vertex 10 -51 158
endloop
endfacet
facet normal 0 -1 0
outer loop
vertex -39 -69.5 155
vertex 39 -69.5 155
vertex 39 -69.5 157
endloop
endfacet
facet normal 0 -0 -1
outer loop
vertex -39 -69.5 155
vertex 42 -68.5 155
vertex 39 -69.5 155
endloop
endfacet
facet normal 0 -0.7 0.7
outer loop
vertex -39 -68.5 158
vertex 39 -69.5 157
vertex 39 -68.5 158
endloop
endfacet
facet normal 0 0 1
outer loop
vertex -39 -68.5 158
vertex 39 -68.5 158
vertex 41 -67.5 158
endloop
endfacet
facet normal -0 -0 1
outer loop
vertex -35 -54.5 158
vertex 41 -67.5 158
vertex 36 -61.5 158
endloop
endfacet
facet normal 0 0 -1
outer loop
vertex 42 -68.5 155
vertex -5.5 -51.5 155
vertex 0 -51.5 155
endloop
endfacet
facet normal 0 0 -1
outer loop
vertex 42 -68.5 155
vertex 0 -51.5 155
vertex 5.5 -51.5 155
endloop
endfacet
facet normal -0 -0 1
outer loop
vertex -35 -54.5 158
vertex 36 -61.5 158
vertex 35 -60.5 158
endloop
endfacet
facet normal -0 0 1
outer loop
vertex -35 -54.5 158
vertex 35 -60.5 158
vertex 35 -54.5 158
endloop
endfacet
facet normal 0 0 1
outer loop
vertex 35 -54.5 158
vertex 5.5 -51.5 158
vertex 0 -51.5 158
endloop
endfacet
facet normal 0 0 -1
outer loop
vertex 42 -68.5 155
vertex 5.5 -51.5 155
vertex 11 -51.5 155
endloop
endfacet
facet normal 0 0 1
outer loop
vertex 35 -54.5 158
vertex 11 -51.5 158
vertex 5.5 -51.5 158
endloop
endfacet
facet normal 0 0 1
outer loop
vertex 35 -54.5 158
vertex 16.5 -51.5 158
vertex 11 -51.5 158
endloop
endfacet
facet normal -0 -0 -1
outer loop
vertex 12 -51 155
vertex 16.5 -51.5 155
vertex 11 -51.5 155
endloop
endfacet
facet normal -0 -0 -1
outer loop
vertex 12.5 -50 155
vertex 15.5 -51 155
vertex 12 -51 155
endloop
endfacet
facet normal 0 0 -1
outer loop
vertex 12 -51 155
vertex 15.5 -51 155
vertex 16.5 -51.5 155
endloop
endfacet
facet normal 0 0 -1
outer loop
vertex 12.5 -50 155
vertex 15 -50 155
vertex 15.5 -51 155
endloop
endfacet
facet normal 0 -0 1
outer loop
vertex 11 -51.5 158
vertex 15.5 -51 158
vertex 12 -51 158
endloop
endfacet
facet normal 0 -0 1
outer loop
vertex 12 -51 158
vertex 15 -50 158
vertex 12.5 -50 158
endloop
endfacet
facet normal 0 -0 1
outer loop
vertex 11 -51.5 158
vertex 16.5 -51.5 158
vertex 15.5 -51 158
endloop
endfacet
facet normal 0 -0 1
outer loop
vertex 12 -51 158
vertex 15.5 -51 158
vertex 15 -50 158
endloop
endfacet
facet normal 0 -0 -1
outer loop
vertex 18 -50 155
vertex 23.5 -48 155
vertex 17.5 -51 155
endloop
endfacet
facet normal 0 -0 1
outer loop
vertex 18 -51 158
vertex 23.5 -46 158
vertex 18 -30 158
endloop
endfacet
facet normal -0 -0 -1
outer loop
vertex 1.5 50 155
vertex 4 -50 155
vertex 1.5 -50 155
endloop
endfacet
facet normal -0 0 1
outer loop
vertex 4 50 158
vertex 1.5 -50 158
vertex 4 -50 158
endloop
endfacet
facet normal -0 -0 -1
outer loop
vertex 7 50 155
vertex 9.5 -50 155
vertex 7 -50 155
endloop
endfacet
facet normal -0 0 1
outer loop
vertex 9.5 50 158
vertex 7 -50 158
vertex 9.5 -50 158
endloop
endfacet
facet normal 0 0 -1
outer loop
vertex 18 -50 155
vertex 18 32 155
vertex 23 -47 155
endloop
endfacet
facet normal -0 -0 -1
outer loop
vertex 12.5 50 155
vertex 15 -50 155
vertex 12.5 -50 155
endloop
endfacet
facet normal -0 0 1
outer loop
vertex 15 50 158
vertex 12.5 -50 158
vertex 15 -50 158
endloop
endfacet
facet normal 0 0 -1
outer loop
vertex 42 -68.5 155
vertex 11 -51.5 155
vertex 16.5 -51.5 155
endloop
endfacet
facet normal 0 0 -1
outer loop
vertex 42 -68.5 155
vertex 16.5 -51.5 155
vertex 17.5 -51 155
endloop
endfacet
facet normal 0 0 1
outer loop
vertex 35 -54.5 158
vertex 18 -51 158
vertex 16.5 -51.5 158
endloop
endfacet
facet normal 0 0 -1
outer loop
vertex 42 -68.5 155
vertex 17.5 -51 155
vertex 25 -48.5 155
endloop
endfacet
facet normal 0 -0 1
outer loop
vertex 35 -54.5 158
vertex 36 -53.5 158
vertex 25 -48.5 158
endloop
endfacet
facet normal -0 0 -1
outer loop
vertex 25 -48.5 155
vertex 17.5 -51 155
vertex 23.5 -48 155
endloop
endfacet
facet normal -0 0 -1
outer loop
vertex 23.5 -48 155
vertex 18 -50 155
vertex 23 -47 155
endloop
endfacet
facet normal -0 0 1
outer loop
vertex 23.5 -48 158
vertex 18 -51 158
vertex 25 -48.5 158
endloop
endfacet
facet normal -0 0 1
outer loop
vertex 23 -47 158
vertex 18 -51 158
vertex 23.5 -48 158
endloop
endfacet
facet normal -0 0 1
outer loop
vertex 23.5 -46 158
vertex 18 -51 158
vertex 23 -47 158
endloop
endfacet
facet normal 0 0 1
outer loop
vertex 35 -54.5 158
vertex 25 -48.5 158
vertex 18 -51 158
endloop
endfacet
facet normal 0 0 1
outer loop
vertex 25 -45.5 158
vertex 18 -30 158
vertex 23.5 -46 158
endloop
endfacet
facet normal 0 0 -1
outer loop
vertex 42 -68.5 155
vertex 25 -48.5 155
vertex 37 -48.5 155
endloop
endfacet
facet normal 0.4 -0.9 0
outer loop
vertex 39 -69.5 155
vertex 42 -68.5 155
vertex 39 -69.5 157
endloop
endfacet
facet normal 0.9 -0.4 0
outer loop
vertex 42 -68.5 155
vertex 43 -65.5 155
vertex 42 -68.5 157
endloop
endfacet
facet normal 0.4 -0.9 0
outer loop
vertex 42 -68.5 155
vertex 42 -68.5 157
vertex 39 -69.5 157
endloop
endfacet
facet normal 0.9 -0.4 0
outer loop
vertex 43 -65.5 155
vertex 43 -65.5 157
vertex 42 -68.5 157
endloop
endfacet
facet normal 0.3 -0.7 0.7
outer loop
vertex 39 -69.5 157
vertex 41 -67.5 158
vertex 39 -68.5 158
endloop
endfacet
facet normal -0 -0 1
outer loop
vertex 36 -61.5 158
vertex 41 -67.5 158
vertex 40 -61.5 158
endloop
endfacet
facet normal 0.3 -0.7 0.7
outer loop
vertex 39 -69.5 157
vertex 42 -68.5 157
vertex 41 -67.5 158
endloop
endfacet
facet normal 0.7 -0.3 0.7
outer loop
vertex 42 -68.5 157
vertex 43 -65.5 157
vertex 41 -67.5 158
endloop
endfacet
facet normal 0.7 -0.3 0.7
outer loop
vertex 43 -65.5 157
vertex 42 -65.5 158
vertex 41 -67.5 158
endloop
endfacet
facet normal 0 0 1
outer loop
vertex 40 -61.5 158
vertex 41 -67.5 158
vertex 41 -60.5 158
endloop
endfacet
facet normal 0 0 1
outer loop
vertex 41 -67.5 158
vertex 41 -54.5 158
vertex 41 -60.5 158
endloop
endfacet
facet normal 0 0 -1
outer loop
vertex 42 -68.5 155
vertex 37 -48.5 155
vertex 38 -48 155
endloop
endfacet
facet normal 0 0 -1
outer loop
vertex 42 -68.5 155
vertex 38 -48 155
vertex 38.5 -47 155
endloop
endfacet
facet normal 0 -0 1
outer loop
vertex 36 -53.5 158
vertex 37 -48.5 158
vertex 25 -48.5 158
endloop
endfacet
facet normal 0 -0 1
outer loop
vertex 36 -53.5 158
vertex 40 -53.5 158
vertex 37 -48.5 158
endloop
endfacet
facet normal 0 0 1
outer loop
vertex 40 -53.5 158
vertex 38 -48 158
vertex 37 -48.5 158
endloop
endfacet
facet normal 0 0 1
outer loop
vertex 40 -53.5 158
vertex 38.5 -47 158
vertex 38 -48 158
endloop
endfacet
facet normal 0 0 -1
outer loop
vertex 23 -47 155
vertex 18 32 155
vertex 23.5 -46 155
endloop
endfacet
facet normal 0 0 -1
outer loop
vertex 23.5 -46 155
vertex 18 32 155
vertex 25 -45.5 155
endloop
endfacet
facet normal 0 0 -1
outer loop
vertex 25 -45.5 155
vertex 18 32 155
vertex 37 -45.5 155
endloop
endfacet
facet normal -0 0 1
outer loop
vertex 18 -30 158
vertex 25 -45.5 158
vertex 37 45.5 158
endloop
endfacet
facet normal 0 0 -1
outer loop
vertex 42 -68.5 155
vertex 38.5 -47 155
vertex 38 46 155
endloop
endfacet
facet normal 0 0 -1
outer loop
vertex 42 -68.5 155
vertex 43 65.5 155
vertex 43 -65.5 155
endloop
endfacet
facet normal 1 0 -0
outer loop
vertex 43 -65.5 155
vertex 43 65.5 157
vertex 43 -65.5 157
endloop
endfacet
facet normal 0.7 0 0.7
outer loop
vertex 43 -65.5 157
vertex 42 65.5 158
vertex 42 -65.5 158
endloop
endfacet
facet normal 0 0 1
outer loop
vertex 41 -67.5 158
vertex 42 -65.5 158
vertex 42 65.5 158
endloop
endfacet
facet normal 0 -0 1
outer loop
vertex 41 -67.5 158
vertex 41 67.5 158
vertex 41 -54.5 158
endloop
endfacet
facet normal 0 0 -1
outer loop
vertex 37 -45.5 155
vertex 38 46 155
vertex 38 -46 155
endloop
endfacet
facet normal -0 0 1
outer loop
vertex 40 53.5 158
vertex 25 -45.5 158
vertex 37 -45.5 158
endloop
endfacet
facet normal 0 0 -1
outer loop
vertex 38 -46 155
vertex 38 46 155
vertex 38.5 -47 155
endloop
endfacet
facet normal 0 0 1
outer loop
vertex 40 53.5 158
vertex 38 -46 158
vertex 38.5 -47 158
endloop
endfacet
facet normal 0 -0 1
outer loop
vertex 40 -53.5 158
vertex 40 53.5 158
vertex 38.5 -47 158
endloop
endfacet
facet normal 0 0 1
outer loop
vertex 40 53.5 158
vertex 37 -45.5 158
vertex 38 -46 158
endloop
endfacet
facet normal -0 0 1
outer loop
vertex 40 -53.5 158
vertex 41 -54.5 158
vertex 41 67.5 158
endloop
endfacet
facet normal 0 0 -1
outer loop
vertex 4 -50 155
vertex 1.5 50 155
vertex 4 50 155
endloop
endfacet
facet normal 0 -0 1
outer loop
vertex 1.5 -50 158
vertex 4 50 158
vertex 1.5 50 158
endloop
endfacet
facet normal 0 0 -1
outer loop
vertex 9.5 -50 155
vertex 7 50 155
vertex 9.5 50 155
endloop
endfacet
facet normal 0 -0 1
outer loop
vertex 7 -50 158
vertex 9.5 50 158
vertex 7 50 158
endloop
endfacet
facet normal 0 0 -1
outer loop
vertex 15 -50 155
vertex 12.5 50 155
vertex 15 50 155
endloop
endfacet
facet normal 0 0 1
outer loop
vertex 15 50 158
vertex 12.5 50 158
vertex 12.5 -50 158
endloop
endfacet
facet normal 0 -0 1
outer loop
vertex 18 -30 158
vertex 23.5 46 158
vertex 18 50 158
endloop
endfacet
facet normal -0 -0 -1
outer loop
vertex 0 51.5 155
vertex 4.5 51 155
vertex 1 51 155
endloop
endfacet
facet normal -0 -0 -1
outer loop
vertex 1 51 155
vertex 4 50 155
vertex 1.5 50 155
endloop
endfacet
facet normal 0 -0 -1
outer loop
vertex 1 51 155
vertex 4.5 51 155
vertex 4 50 155
endloop
endfacet
facet normal 0 -0 -1
outer loop
vertex 0 51.5 155
vertex 5.5 51.5 155
vertex 4.5 51 155
endloop
endfacet
facet normal 0 -0 1
outer loop
vertex 1.5 50 158
vertex 4.5 51 158
vertex 1 51 158
endloop
endfacet
facet normal 0 -0 1
outer loop
vertex 1 51 158
vertex 5.5 51.5 158
vertex 0 51.5 158
endloop
endfacet
facet normal 0 0 1
outer loop
vertex 1.5 50 158
vertex 4 50 158
vertex 4.5 51 158
endloop
endfacet
facet normal 0 0 1
outer loop
vertex 1 51 158
vertex 4.5 51 158
vertex 5.5 51.5 158
endloop
endfacet
facet normal -0 -0 -1
outer loop
vertex 5.5 51.5 155
vertex 10 51 155
vertex 6.5 51 155
endloop
endfacet
facet normal -0 -0 -1
outer loop
vertex 6.5 51 155
vertex 9.5 50 155
vertex 7 50 155
endloop
endfacet
facet normal 0 -0 -1
outer loop
vertex 6.5 51 155
vertex 10 51 155
vertex 9.5 50 155
endloop
endfacet
facet normal 0 -0 -1
outer loop
vertex 5.5 51.5 155
vertex 11 51.5 155
vertex 10 51 155
endloop
endfacet
facet normal 0 -0 1
outer loop
vertex 7 50 158
vertex 10 51 158
vertex 6.5 51 158
endloop
endfacet
facet normal 0 -0 1
outer loop
vertex 6.5 51 158
vertex 11 51.5 158
vertex 5.5 51.5 158
endloop
endfacet
facet normal 0 0 1
outer loop
vertex 7 50 158
vertex 9.5 50 158
vertex 10 51 158
endloop
endfacet
facet normal 0 0 1
outer loop
vertex 6.5 51 158
vertex 10 51 158
vertex 11 51.5 158
endloop
endfacet
facet normal -0 0 -1
outer loop
vertex 39 69.5 155
vertex -15.5 51 155
vertex -16.5 51.5 155
endloop
endfacet
facet normal 0 0 -1
outer loop
vertex 39 69.5 155
vertex -11 51.5 155
vertex -15.5 51 155
endloop
endfacet
facet normal -0 0 1
outer loop
vertex 35 60.5 158
vertex -16.5 51.5 158
vertex -11 51.5 158
endloop
endfacet
facet normal -0 0 -1
outer loop
vertex 39 69.5 155
vertex -5.5 51.5 155
vertex -11 51.5 155
endloop
endfacet
facet normal -0 0 1
outer loop
vertex 35 60.5 158
vertex -11 51.5 158
vertex -5.5 51.5 158
endloop
endfacet
facet normal -0 0 1
outer loop
vertex 35 60.5 158
vertex -5.5 51.5 158
vertex 0 51.5 158
endloop
endfacet
facet normal -0 0 1
outer loop
vertex -41 67.5 158
vertex 35 60.5 158
vertex 36 61.5 158
endloop
endfacet
facet normal -0 -0 -1
outer loop
vertex 12 51 155
vertex 15 50 155
vertex 12.5 50 155
endloop
endfacet
facet normal -0 -0 -1
outer loop
vertex 11 51.5 155
vertex 15.5 51 155
vertex 12 51 155
endloop
endfacet
facet normal 0 -0 -1
outer loop
vertex 12 51 155
vertex 15.5 51 155
vertex 15 50 155
endloop
endfacet
facet normal 0 -0 -1
outer loop
vertex 11 51.5 155
vertex 16.5 51.5 155
vertex 15.5 51 155
endloop
endfacet
facet normal 0 -0 1
outer loop
vertex 12.5 50 158
vertex 15.5 51 158
vertex 12 51 158
endloop
endfacet
facet normal 0 -0 1
outer loop
vertex 12 51 158
vertex 16.5 51.5 158
vertex 11 51.5 158
endloop
endfacet
facet normal 0 0 1
outer loop
vertex 12.5 50 158
vertex 15 50 158
vertex 15.5 51 158
endloop
endfacet
facet normal 0 0 1
outer loop
vertex 12 51 158
vertex 15.5 51 158
vertex 16.5 51.5 158
endloop
endfacet
facet normal 0 0 -1
outer loop
vertex 18 32 155
vertex 18 50 155
vertex 23.5 46 155
endloop
endfacet
facet normal -0 -0 -1
outer loop
vertex 17.5 51 155
vertex 23.5 48 155
vertex 18 50 155
endloop
endfacet
facet normal -0 -0 1
outer loop
vertex 18 50 158
vertex 23.5 48 158
vertex 17.5 51 158
endloop
endfacet
facet normal -0 0 -1
outer loop
vertex 39 69.5 155
vertex 0 51.5 155
vertex -5.5 51.5 155
endloop
endfacet
facet normal -0 0 -1
outer loop
vertex 39 69.5 155
vertex 5.5 51.5 155
vertex 0 51.5 155
endloop
endfacet
facet normal -0 0 1
outer loop
vertex 35 60.5 158
vertex 0 51.5 158
vertex 5.5 51.5 158
endloop
endfacet
facet normal -0 1 0
outer loop
vertex -39 69.5 155
vertex 39 69.5 157
vertex 39 69.5 155
endloop
endfacet
facet normal -0 -0 1
outer loop
vertex -41 67.5 158
vertex 36 61.5 158
vertex 40 61.5 158
endloop
endfacet
facet normal 0 0.7 0.7
outer loop
vertex -39 69.5 157
vertex 39 68.5 158
vertex 39 69.5 157
endloop
endfacet
facet normal 0 0 1
outer loop
vertex -41 67.5 158
vertex 40 61.5 158
vertex 41 67.5 158
endloop
endfacet
facet normal 0 -0 1
outer loop
vertex -41 67.5 158
vertex 41 67.5 158
vertex 39 68.5 158
endloop
endfacet
facet normal -0 0 -1
outer loop
vertex 39 69.5 155
vertex 11 51.5 155
vertex 5.5 51.5 155
endloop
endfacet
facet normal -0 0 1
outer loop
vertex 35 60.5 158
vertex 5.5 51.5 158
vertex 11 51.5 158
endloop
endfacet
facet normal -0 0 1
outer loop
vertex 35 60.5 158
vertex 11 51.5 158
vertex 16.5 51.5 158
endloop
endfacet
facet normal 0 0 -1
outer loop
vertex 37 -45.5 155
vertex 18 32 155
vertex 37 45.5 155
endloop
endfacet
facet normal 0 -0 1
outer loop
vertex 18 -30 158
vertex 25 45.5 158
vertex 23.5 46 158
endloop
endfacet
facet normal 0 -0 1
outer loop
vertex 18 -30 158
vertex 37 45.5 158
vertex 25 45.5 158
endloop
endfacet
facet normal 0 0 -1
outer loop
vertex 37 -45.5 155
vertex 37 45.5 155
vertex 38 46 155
endloop
endfacet
facet normal 0 -0 1
outer loop
vertex 25 -45.5 158
vertex 38 46 158
vertex 37 45.5 158
endloop
endfacet
facet normal 0 -0 1
outer loop
vertex 25 -45.5 158
vertex 38.5 47 158
vertex 38 46 158
endloop
endfacet
facet normal 0 0 -1
outer loop
vertex 42 -68.5 155
vertex 38 46 155
vertex 38.5 47 155
endloop
endfacet
facet normal 0 0 -1
outer loop
vertex 42 -68.5 155
vertex 38.5 47 155
vertex 39 69.5 155
endloop
endfacet
facet normal 0 0 1
outer loop
vertex 40 53.5 158
vertex 38.5 47 158
vertex 25 -45.5 158
endloop
endfacet
facet normal 0 0 -1
outer loop
vertex 42 -68.5 155
vertex 39 69.5 155
vertex 43 65.5 155
endloop
endfacet
facet normal 1 0 0
outer loop
vertex 43 -65.5 155
vertex 43 65.5 155
vertex 43 65.5 157
endloop
endfacet
facet normal 0 -0 1
outer loop
vertex 40 -53.5 158
vertex 41 54.5 158
vertex 40 53.5 158
endloop
endfacet
facet normal 0.7 -0 0.7
outer loop
vertex 43 -65.5 157
vertex 43 65.5 157
vertex 42 65.5 158
endloop
endfacet
facet normal 0 -0 1
outer loop
vertex 40 -53.5 158
vertex 41 67.5 158
vertex 41 54.5 158
endloop
endfacet
facet normal 0 -0 1
outer loop
vertex 41 -67.5 158
vertex 42 65.5 158
vertex 41 67.5 158
endloop
endfacet
facet normal 0 0 -1
outer loop
vertex 18 32 155
vertex 23.5 46 155
vertex 25 45.5 155
endloop
endfacet
facet normal -0 0 -1
outer loop
vertex 37 45.5 155
vertex 18 32 155
vertex 25 45.5 155
endloop
endfacet
facet normal 0 0 -1
outer loop
vertex 23.5 46 155
vertex 18 50 155
vertex 23 47 155
endloop
endfacet
facet normal 0 0 -1
outer loop
vertex 23 47 155
vertex 18 50 155
vertex 23.5 48 155
endloop
endfacet
facet normal 0 0 -1
outer loop
vertex 23.5 48 155
vertex 17.5 51 155
vertex 25 48.5 155
endloop
endfacet
facet normal 0 0 1
outer loop
vertex 23 47 158
vertex 18 50 158
vertex 23.5 46 158
endloop
endfacet
facet normal 0 0 1
outer loop
vertex 23.5 48 158
vertex 18 50 158
vertex 23 47 158
endloop
endfacet
facet normal 0 0 1
outer loop
vertex 25 48.5 158
vertex 17.5 51 158
vertex 23.5 48 158
endloop
endfacet
facet normal -0 0 -1
outer loop
vertex 39 69.5 155
vertex 16.5 51.5 155
vertex 11 51.5 155
endloop
endfacet
facet normal -0 0 -1
outer loop
vertex 39 69.5 155
vertex 17.5 51 155
vertex 16.5 51.5 155
endloop
endfacet
facet normal 0 0 1
outer loop
vertex 35 60.5 158
vertex 16.5 51.5 158
vertex 17.5 51 158
endloop
endfacet
facet normal 0 0 1
outer loop
vertex 35 60.5 158
vertex 17.5 51 158
vertex 25 48.5 158
endloop
endfacet
facet normal -0 0 -1
outer loop
vertex 39 69.5 155
vertex 25 48.5 155
vertex 17.5 51 155
endloop
endfacet
facet normal 0 0 1
outer loop
vertex 36 53.5 158
vertex 35 54.5 158
vertex 25 48.5 158
endloop
endfacet
facet normal 0 -0 1
outer loop
vertex 35 54.5 158
vertex 35 60.5 158
vertex 25 48.5 158
endloop
endfacet
facet normal -0 0 1
outer loop
vertex 36 53.5 158
vertex 25 48.5 158
vertex 37 48.5 158
endloop
endfacet
facet normal -0 0 1
outer loop
vertex 36 53.5 158
vertex 37 48.5 158
vertex 40 53.5 158
endloop
endfacet
facet normal 0 0 1
outer loop
vertex 40 53.5 158
vertex 38 48 158
vertex 38.5 47 158
endloop
endfacet
facet normal 0 0 1
outer loop
vertex 40 53.5 158
vertex 37 48.5 158
vertex 38 48 158
endloop
endfacet
facet normal -0 0 -1
outer loop
vertex 39 69.5 155
vertex 37 48.5 155
vertex 25 48.5 155
endloop
endfacet
facet normal -0 0 -1
outer loop
vertex 39 69.5 155
vertex 38 48 155
vertex 37 48.5 155
endloop
endfacet
facet normal -0 0 -1
outer loop
vertex 39 69.5 155
vertex 38.5 47 155
vertex 38 48 155
endloop
endfacet
facet normal 0.4 0.9 -0
outer loop
vertex 39 69.5 155
vertex 39 69.5 157
vertex 42 68.5 155
endloop
endfacet
facet normal 0 0 -1
outer loop
vertex 39 69.5 155
vertex 42 68.5 155
vertex 43 65.5 155
endloop
endfacet
facet normal 0.9 0.4 0
outer loop
vertex 43 65.5 155
vertex 42 68.5 155
vertex 43 65.5 157
endloop
endfacet
facet normal 0.4 0.9 0
outer loop
vertex 42 68.5 155
vertex 39 69.5 157
vertex 42 68.5 157
endloop
endfacet
facet normal 0.9 0.4 -0
outer loop
vertex 42 68.5 155
vertex 42 68.5 157
vertex 43 65.5 157
endloop
endfacet
facet normal 0.3 0.7 0.7
outer loop
vertex 39 69.5 157
vertex 39 68.5 158
vertex 41 67.5 158
endloop
endfacet
facet normal 0 -0 1
outer loop
vertex 41 54.5 158
vertex 41 67.5 158
vertex 41 60.5 158
endloop
endfacet
facet normal 0 -0 1
outer loop
vertex 41 60.5 158
vertex 41 67.5 158
vertex 40 61.5 158
endloop
endfacet
facet normal 0.3 0.7 0.7
outer loop
vertex 39 69.5 157
vertex 41 67.5 158
vertex 42 68.5 157
endloop
endfacet
facet normal 0.7 0.3 0.7
outer loop
vertex 43 65.5 157
vertex 42 68.5 157
vertex 41 67.5 158
endloop
endfacet
facet normal 0.7 0.3 0.7
outer loop
vertex 43 65.5 157
vertex 41 67.5 158
vertex 42 65.5 158
endloop
endfacet
facet normal -0.7 -0.7 -0.3
outer loop
vertex -40 -61.5 158
vertex -41 -60.5 158
vertex -41 -60.5 158
endloop
endfacet
facet normal -0.9 -0 -0.4
outer loop
vertex -41 -60.5 158
vertex -41 -54.5 158
vertex -41 -60.5 158
endloop
endfacet
facet normal -0.9 0 -0.4
outer loop
vertex -41 -60.5 158
vertex -41 -54.5 158
vertex -41 -54.5 158
endloop
endfacet
facet normal -0.7 0.7 -0.3
outer loop
vertex -41 -54.5 158
vertex -40 -53.5 158
vertex -41 -54.5 158
endloop
endfacet
facet normal -0.7 0.7 -0.3
outer loop
vertex -41 -54.5 158
vertex -40 -53.5 158
vertex -40 -53.5 158
endloop
endfacet
facet normal -0 1 -0
outer loop
vertex -40 -53.5 158
vertex -40 -53.5 158
vertex -36 -53.5 158
endloop
endfacet
facet normal -0.7 -0.7 -0
outer loop
vertex -40 -61.5 158
vertex -41 -60.5 165
vertex -41 -60.5 158
endloop
endfacet
facet normal -0.7 -0.7 -0
outer loop
vertex -40 -61.5 158
vertex -40 -61.5 165
vertex -41 -60.5 165
endloop
endfacet
facet normal -1 0 -0
outer loop
vertex -41 -60.5 158
vertex -41 -54.5 165
vertex -41 -54.5 158
endloop
endfacet
facet normal -0.7 0.7 0
outer loop
vertex -41 -54.5 158
vertex -40 -53.5 165
vertex -40 -53.5 158
endloop
endfacet
facet normal 0 1 0
outer loop
vertex -40 -53.5 158
vertex -40 -53.5 165
vertex -36 -53.5 158
endloop
endfacet
facet normal -1 0 -0
outer loop
vertex -41 -60.5 158
vertex -41 -60.5 165
vertex -41 -54.5 165
endloop
endfacet
facet normal -0.7 0.7 0
outer loop
vertex -41 -54.5 158
vertex -41 -54.5 165
vertex -40 -53.5 165
endloop
endfacet
facet normal -0 -1 0
outer loop
vertex -40 -61.5 158
vertex -36 -61.5 158
vertex -36 -61.5 165.5
endloop
endfacet
facet normal 0.7 -0.7 0
outer loop
vertex -36 -61.5 158
vertex -35 -60.5 158
vertex -35 -60.5 165.5
endloop
endfacet
facet normal 1 0 0
outer loop
vertex -35 -60.5 158
vertex -35 -54.5 158
vertex -35 -54.5 165.5
endloop
endfacet
facet normal 0.7 0.7 -0
outer loop
vertex -35 -54.5 158
vertex -36 -53.5 158
vertex -36 -53.5 165.5
endloop
endfacet
facet normal -0 -1 0
outer loop
vertex -40 -61.5 158
vertex -36 -61.5 165.5
vertex -40 -61.5 165
endloop
endfacet
facet normal -0.7 -0.7 0.3
outer loop
vertex -40 -61.5 165
vertex -38.5 -61.5 168.5
vertex -41 -60.5 165
endloop
endfacet
facet normal -0 -1 -0
outer loop
vertex -40 -61.5 165
vertex -36 -61.5 165.5
vertex -38.5 -61.5 168.5
endloop
endfacet
facet normal -0.9 -0 0.4
outer loop
vertex -41 -60.5 165
vertex -39.5 -54.5 168.5
vertex -41 -54.5 165
endloop
endfacet
facet normal -0.7 0.7 0.3
outer loop
vertex -41 -54.5 165
vertex -39.5 -54.5 168.5
vertex -40 -53.5 165
endloop
endfacet
facet normal 0.7 -0.7 0
outer loop
vertex -36 -61.5 158
vertex -35 -60.5 165.5
vertex -36 -61.5 165.5
endloop
endfacet
facet normal 1 0 -0
outer loop
vertex -35 -60.5 158
vertex -35 -54.5 165.5
vertex -35 -60.5 165.5
endloop
endfacet
facet normal -0 1 0
outer loop
vertex -36 -53.5 158
vertex -40 -53.5 165
vertex -36 -53.5 165.5
endloop
endfacet
facet normal 0.7 0.7 0
outer loop
vertex -35 -54.5 158
vertex -36 -53.5 165.5
vertex -35 -54.5 165.5
endloop
endfacet
facet normal -0.7 -0.7 0.3
outer loop
vertex -41 -60.5 165
vertex -38.5 -61.5 168.5
vertex -39.5 -60.5 168.5
endloop
endfacet
facet normal -0.9 0 0.4
outer loop
vertex -41 -60.5 165
vertex -39.5 -60.5 168.5
vertex -39.5 -54.5 168.5
endloop
endfacet
facet normal -0.7 0.7 0.3
outer loop
vertex -40 -53.5 165
vertex -39.5 -54.5 168.5
vertex -38.5 -53.5 168.5
endloop
endfacet
facet normal 0.6 -0.6 -0.6
outer loop
vertex -36 -61.5 165.5
vertex -35 -60.5 165.5
vertex -20.5 -60.5 180
endloop
endfacet
facet normal 0.7 0 -0.7
outer loop
vertex -35 -60.5 165.5
vertex -35 -54.5 165.5
vertex -20.5 -60.5 180
endloop
endfacet
facet normal 0.6 0.6 -0.6
outer loop
vertex -35 -54.5 165.5
vertex -36 -53.5 165.5
vertex -20.5 -54.5 180
endloop
endfacet
facet normal -0.6 -0.6 0.6
outer loop
vertex -38.5 -61.5 168.5
vertex -23.5 -60.5 184.5
vertex -39.5 -60.5 168.5
endloop
endfacet
facet normal -0 1 -0
outer loop
vertex -40 -53.5 165
vertex -23.5 -53.5 183.5
vertex -36 -53.5 165.5
endloop
endfacet
facet normal 0 1 -0
outer loop
vertex -40 -53.5 165
vertex -38.5 -53.5 168.5
vertex -23.5 -53.5 183.5
endloop
endfacet
facet normal -0.6 0.6 0.6
outer loop
vertex -39.5 -54.5 168.5
vertex -23.5 -53.5 183.5
vertex -38.5 -53.5 168.5
endloop
endfacet
facet normal -0 -1 0
outer loop
vertex -36 -61.5 165.5
vertex -20.5 -61.5 181
vertex -38.5 -61.5 168.5
endloop
endfacet
facet normal -0.6 -0.6 0.6
outer loop
vertex -38.5 -61.5 168.5
vertex -23.5 -61.5 183.5
vertex -23.5 -60.5 184.5
endloop
endfacet
facet normal -0 -1 0
outer loop
vertex -38.5 -61.5 168.5
vertex -20.5 -61.5 181
vertex -23.5 -61.5 183.5
endloop
endfacet
facet normal 0 1 -0
outer loop
vertex -36 -53.5 165.5
vertex -23.5 -53.5 183.5
vertex -20.5 -53.5 181
endloop
endfacet
facet normal 0.6 -0.6 -0.6
outer loop
vertex -36 -61.5 165.5
vertex -20.5 -60.5 180
vertex -20.5 -61.5 181
endloop
endfacet
facet normal 0.7 0 -0.7
outer loop
vertex -35 -54.5 165.5
vertex -20.5 -54.5 180
vertex -20.5 -60.5 180
endloop
endfacet
facet normal 0.6 0.6 -0.6
outer loop
vertex -36 -53.5 165.5
vertex -20.5 -53.5 181
vertex -20.5 -54.5 180
endloop
endfacet
facet normal -0.7 0 0.7
outer loop
vertex -39.5 -54.5 168.5
vertex -39.5 -60.5 168.5
vertex -23.5 -54.5 184.5
endloop
endfacet
facet normal -0.6 0.6 0.6
outer loop
vertex -39.5 -54.5 168.5
vertex -23.5 -54.5 184.5
vertex -23.5 -53.5 183.5
endloop
endfacet
facet normal -0.3 -0.7 0.7
outer loop
vertex -23.5 -61.5 183.5
vertex -20 -60.5 186
vertex -23.5 -60.5 184.5
endloop
endfacet
facet normal -0.7 0 0.7
outer loop
vertex -39.5 -60.5 168.5
vertex -23.5 -60.5 184.5
vertex -23.5 -54.5 184.5
endloop
endfacet
facet normal -0.4 0 0.9
outer loop
vertex -23.5 -60.5 184.5
vertex -20 -54.5 186
vertex -23.5 -54.5 184.5
endloop
endfacet
facet normal -0.3 0.7 0.7
outer loop
vertex -23.5 -53.5 183.5
vertex -23.5 -54.5 184.5
vertex -20 -54.5 186
endloop
endfacet
facet normal -0.3 -0.7 0.7
outer loop
vertex -23.5 -61.5 183.5
vertex -20 -61.5 185
vertex -20 -60.5 186
endloop
endfacet
facet normal -0.4 0 0.9
outer loop
vertex -23.5 -60.5 184.5
vertex -20 -60.5 186
vertex -20 -54.5 186
endloop
endfacet
facet normal -0.3 0.7 0.7
outer loop
vertex -23.5 -53.5 183.5
vertex -20 -54.5 186
vertex -20 -53.5 185
endloop
endfacet
facet normal 0 -0.7 -0.7
outer loop
vertex -20.5 -61.5 181
vertex -20.5 -60.5 180
vertex 20.5 -60.5 180
endloop
endfacet
facet normal -0 -1 0
outer loop
vertex -23.5 -61.5 183.5
vertex -20.5 -61.5 181
vertex 23.5 -61.5 183.5
endloop
endfacet
facet normal 0 0 -1
outer loop
vertex -20.5 -60.5 180
vertex -20.5 -54.5 180
vertex 20.5 -54.5 180
endloop
endfacet
facet normal 0 0.7 -0.7
outer loop
vertex -20.5 -54.5 180
vertex -20.5 -53.5 181
vertex 20.5 -53.5 181
endloop
endfacet
facet normal 0 1 -0
outer loop
vertex -23.5 -53.5 183.5
vertex 23.5 -53.5 183.5
vertex -20.5 -53.5 181
endloop
endfacet
facet normal -0 -1 -0
outer loop
vertex -23.5 -61.5 183.5
vertex 23.5 -61.5 183.5
vertex -20 -61.5 185
endloop
endfacet
facet normal 0 -0.7 0.7
outer loop
vertex -20 -61.5 185
vertex 20 -61.5 185
vertex -20 -60.5 186
endloop
endfacet
facet normal 0 1 0
outer loop
vertex -23.5 -53.5 183.5
vertex -20 -53.5 185
vertex 23.5 -53.5 183.5
endloop
endfacet
facet normal 0 -0 1
outer loop
vertex -20 -60.5 186
vertex 20 -54.5 186
vertex -20 -54.5 186
endloop
endfacet
facet normal 0 0.7 0.7
outer loop
vertex -20 -53.5 185
vertex -20 -54.5 186
vertex 20 -53.5 185
endloop
endfacet
facet normal 0.7 -0.7 -0.3
outer loop
vertex 40 -61.5 158
vertex 41 -60.5 158
vertex 41 -60.5 158
endloop
endfacet
facet normal -0 1 0
outer loop
vertex 36 -53.5 158
vertex 40 -53.5 158
vertex 40 -53.5 158
endloop
endfacet
facet normal 0.7 0.7 -0.3
outer loop
vertex 40 -53.5 158
vertex 40 -53.5 158
vertex 41 -54.5 158
endloop
endfacet
facet normal 0.9 0 -0.4
outer loop
vertex 41 -60.5 158
vertex 41 -54.5 158
vertex 41 -60.5 158
endloop
endfacet
facet normal 0.9 0 -0.4
outer loop
vertex 41 -60.5 158
vertex 41 -54.5 158
vertex 41 -54.5 158
endloop
endfacet
facet normal 0.7 0.7 -0.3
outer loop
vertex 40 -53.5 158
vertex 41 -54.5 158
vertex 41 -54.5 158
endloop
endfacet
facet normal -0.7 -0.7 0
outer loop
vertex 36 -61.5 158
vertex 36 -61.5 165.5
vertex 35 -60.5 158
endloop
endfacet
facet normal 0 -1 0
outer loop
vertex 36 -61.5 158
vertex 40 -61.5 158
vertex 36 -61.5 165.5
endloop
endfacet
facet normal -1 0 0
outer loop
vertex 35 -60.5 158
vertex 35 -60.5 165.5
vertex 35 -54.5 158
endloop
endfacet
facet normal -0.7 0.7 0
outer loop
vertex 35 -54.5 158
vertex 35 -54.5 165.5
vertex 36 -53.5 158
endloop
endfacet
facet normal -0 1 0
outer loop
vertex 36 -53.5 158
vertex 36 -53.5 165.5
vertex 40 -53.5 158
endloop
endfacet
facet normal 0.7 -0.7 -0
outer loop
vertex 40 -61.5 158
vertex 41 -60.5 158
vertex 41 -60.5 165
endloop
endfacet
facet normal 0.7 -0.7 -0
outer loop
vertex 40 -61.5 158
vertex 41 -60.5 165
vertex 40 -61.5 165
endloop
endfacet
facet normal 1 0 -0
outer loop
vertex 41 -60.5 158
vertex 41 -54.5 158
vertex 41 -54.5 165
endloop
endfacet
facet normal 0.7 0.7 0
outer loop
vertex 40 -53.5 158
vertex 41 -54.5 165
vertex 41 -54.5 158
endloop
endfacet
facet normal 1 -0 0
outer loop
vertex 41 -60.5 158
vertex 41 -54.5 165
vertex 41 -60.5 165
endloop
endfacet
facet normal 0.7 0.7 0
outer loop
vertex 40 -53.5 158
vertex 40 -53.5 165
vertex 41 -54.5 165
endloop
endfacet
facet normal -0.6 -0.6 -0.6
outer loop
vertex 36 -61.5 165.5
vertex 20.5 -60.5 180
vertex 35 -60.5 165.5
endloop
endfacet
facet normal -0.7 0 -0.7
outer loop
vertex 35 -60.5 165.5
vertex 20.5 -54.5 180
vertex 35 -54.5 165.5
endloop
endfacet
facet normal -0.7 -0.7 0
outer loop
vertex 35 -60.5 158
vertex 36 -61.5 165.5
vertex 35 -60.5 165.5
endloop
endfacet
facet normal -1 0 0
outer loop
vertex 35 -54.5 158
vertex 35 -60.5 165.5
vertex 35 -54.5 165.5
endloop
endfacet
facet normal -0.7 0.7 0
outer loop
vertex 36 -53.5 158
vertex 35 -54.5 165.5
vertex 36 -53.5 165.5
endloop
endfacet
facet normal 0 -1 0
outer loop
vertex 40 -61.5 158
vertex 40 -61.5 165
vertex 36 -61.5 165.5
endloop
endfacet
facet normal 0 -1 -0
outer loop
vertex 36 -61.5 165.5
vertex 40 -61.5 165
vertex 38.5 -61.5 168.5
endloop
endfacet
facet normal 0.7 -0.7 0.3
outer loop
vertex 40 -61.5 165
vertex 41 -60.5 165
vertex 38.5 -61.5 168.5
endloop
endfacet
facet normal 0 1 0
outer loop
vertex 40 -53.5 158
vertex 36 -53.5 165.5
vertex 40 -53.5 165
endloop
endfacet
facet normal 0.9 -0 0.4
outer loop
vertex 41 -60.5 165
vertex 41 -54.5 165
vertex 39.5 -60.5 168.5
endloop
endfacet
facet normal 0 1 -0
outer loop
vertex 36 -53.5 165.5
vertex 38.5 -53.5 168.5
vertex 40 -53.5 165
endloop
endfacet
facet normal 0.7 0.7 0.3
outer loop
vertex 40 -53.5 165
vertex 38.5 -53.5 168.5
vertex 41 -54.5 165
endloop
endfacet
facet normal 0.7 -0.7 0.3
outer loop
vertex 41 -60.5 165
vertex 39.5 -60.5 168.5
vertex 38.5 -61.5 168.5
endloop
endfacet
facet normal 0.9 0 0.4
outer loop
vertex 41 -54.5 165
vertex 39.5 -54.5 168.5
vertex 39.5 -60.5 168.5
endloop
endfacet
facet normal 0.7 0.7 0.3
outer loop
vertex 41 -54.5 165
vertex 38.5 -53.5 168.5
vertex 39.5 -54.5 168.5
endloop
endfacet
facet normal 0 -0.7 -0.7
outer loop
vertex -20.5 -61.5 181
vertex 20.5 -60.5 180
vertex 20.5 -61.5 181
endloop
endfacet
facet normal 0 -1 0
outer loop
vertex -20.5 -61.5 181
vertex 20.5 -61.5 181
vertex 23.5 -61.5 183.5
endloop
endfacet
facet normal 0 0 -1
outer loop
vertex -20.5 -60.5 180
vertex 20.5 -54.5 180
vertex 20.5 -60.5 180
endloop
endfacet
facet normal 0 0.7 -0.7
outer loop
vertex -20.5 -54.5 180
vertex 20.5 -53.5 181
vertex 20.5 -54.5 180
endloop
endfacet
facet normal -0 1 0
outer loop
vertex -20.5 -53.5 181
vertex 23.5 -53.5 183.5
vertex 20.5 -53.5 181
endloop
endfacet
facet normal 0 -1 0
outer loop
vertex -20 -61.5 185
vertex 23.5 -61.5 183.5
vertex 20 -61.5 185
endloop
endfacet
facet normal 0 -0.7 0.7
outer loop
vertex -20 -60.5 186
vertex 20 -61.5 185
vertex 20 -60.5 186
endloop
endfacet
facet normal 0 0 1
outer loop
vertex -20 -60.5 186
vertex 20 -60.5 186
vertex 20 -54.5 186
endloop
endfacet
facet normal -0 1 0
outer loop
vertex -20 -53.5 185
vertex 20 -53.5 185
vertex 23.5 -53.5 183.5
endloop
endfacet
facet normal -0 0.7 0.7
outer loop
vertex -20 -54.5 186
vertex 20 -54.5 186
vertex 20 -53.5 185
endloop
endfacet
facet normal 0.3 -0.7 0.7
outer loop
vertex 20 -61.5 185
vertex 23.5 -61.5 183.5
vertex 20 -60.5 186
endloop
endfacet
facet normal 0.4 0 0.9
outer loop
vertex 20 -60.5 186
vertex 23.5 -54.5 184.5
vertex 20 -54.5 186
endloop
endfacet
facet normal 0.3 0.7 0.7
outer loop
vertex 20 -53.5 185
vertex 20 -54.5 186
vertex 23.5 -53.5 183.5
endloop
endfacet
facet normal 0 -1 0
outer loop
vertex 36 -61.5 165.5
vertex 38.5 -61.5 168.5
vertex 20.5 -61.5 181
endloop
endfacet
facet normal -0.6 0.6 -0.6
outer loop
vertex 35 -54.5 165.5
vertex 20.5 -53.5 181
vertex 36 -53.5 165.5
endloop
endfacet
facet normal -0 1 -0
outer loop
vertex 36 -53.5 165.5
vertex 20.5 -53.5 181
vertex 38.5 -53.5 168.5
endloop
endfacet
facet normal -0.6 -0.6 -0.6
outer loop
vertex 36 -61.5 165.5
vertex 20.5 -61.5 181
vertex 20.5 -60.5 180
endloop
endfacet
facet normal -0.7 0 -0.7
outer loop
vertex 35 -60.5 165.5
vertex 20.5 -60.5 180
vertex 20.5 -54.5 180
endloop
endfacet
facet normal -0.6 0.6 -0.6
outer loop
vertex 35 -54.5 165.5
vertex 20.5 -54.5 180
vertex 20.5 -53.5 181
endloop
endfacet
facet normal 0 -1 0
outer loop
vertex 38.5 -61.5 168.5
vertex 26 -61.5 181
vertex 20.5 -61.5 181
endloop
endfacet
facet normal 0.6 -0.6 0.6
outer loop
vertex 38.5 -61.5 168.5
vertex 27 -60.5 181
vertex 26 -61.5 181
endloop
endfacet
facet normal 0 1 -0
outer loop
vertex 38.5 -53.5 168.5
vertex 20.5 -53.5 181
vertex 26 -53.5 181
endloop
endfacet
facet normal 0.7 -0 0.7
outer loop
vertex 39.5 -60.5 168.5
vertex 23.5 -54.5 184.5
vertex 27 -60.5 181
endloop
endfacet
facet normal 0.7 0 0.7
outer loop
vertex 39.5 -60.5 168.5
vertex 27 -55 181
vertex 23.5 -54.5 184.5
endloop
endfacet
facet normal 0.6 -0.6 0.6
outer loop
vertex 39.5 -60.5 168.5
vertex 27 -60.5 181
vertex 27 -60.5 181
endloop
endfacet
facet normal 0.6 0.6 0.6
outer loop
vertex 38.5 -53.5 168.5
vertex 26 -53.5 181
vertex 27 -54.5 181
endloop
endfacet
facet normal 0.7 0 0.7
outer loop
vertex 39.5 -54.5 168.5
vertex 27 -54.5 181
vertex 27 -55 181
endloop
endfacet
facet normal 0.6 0.6 0.6
outer loop
vertex 39.5 -54.5 168.5
vertex 27 -54.5 181
vertex 27 -54.5 181
endloop
endfacet
facet normal 0.6 -0.6 0.6
outer loop
vertex 38.5 -61.5 168.5
vertex 39.5 -60.5 168.5
vertex 27 -60.5 181
endloop
endfacet
facet normal 0.6 0.6 0.6
outer loop
vertex 38.5 -53.5 168.5
vertex 27 -54.5 181
vertex 39.5 -54.5 168.5
endloop
endfacet
facet normal 0.7 -0 0.7
outer loop
vertex 39.5 -60.5 168.5
vertex 39.5 -54.5 168.5
vertex 27 -55 181
endloop
endfacet
facet normal 0 -1 0
outer loop
vertex 20.5 -61.5 181
vertex 26 -61.5 181
vertex 23.5 -61.5 183.5
endloop
endfacet
facet normal 0.6 -0.6 0.6
outer loop
vertex 26 -61.5 181
vertex 26 -61 181.5
vertex 23.5 -61.5 183.5
endloop
endfacet
facet normal 0.6 -0.6 0.6
outer loop
vertex 26 -61.5 181
vertex 27 -60.5 181
vertex 26 -61 181.5
endloop
endfacet
facet normal -0 1 0
outer loop
vertex 20.5 -53.5 181
vertex 23.5 -53.5 183.5
vertex 26 -53.5 181
endloop
endfacet
facet normal 0.6 -0.6 0.6
outer loop
vertex 26 -61 181.5
vertex 27 -60.5 181
vertex 27 -60.5 181
endloop
endfacet
facet normal 0.6 0.6 0.6
outer loop
vertex 26 -53.5 181
vertex 23.5 -53.5 183.5
vertex 26 -54 181.5
endloop
endfacet
facet normal 0.6 0.6 0.6
outer loop
vertex 26 -54 181.5
vertex 27 -54.5 181
vertex 27 -54.5 181
endloop
endfacet
facet normal 0.6 0.6 0.6
outer loop
vertex 26 -53.5 181
vertex 26 -54 181.5
vertex 27 -54.5 181
endloop
endfacet
facet normal 0.6 -0.6 0.6
outer loop
vertex 26 -61 181.5
vertex 23.5 -60.5 184.5
vertex 23.5 -61.5 183.5
endloop
endfacet
facet normal 0.3 -0.7 0.7
outer loop
vertex 20 -60.5 186
vertex 23.5 -61.5 183.5
vertex 23.5 -60.5 184.5
endloop
endfacet
facet normal 0.6 -0.6 0.6
outer loop
vertex 26 -61 181.5
vertex 27 -60.5 181
vertex 23.5 -60.5 184.5
endloop
endfacet
facet normal 0.7 -0 0.7
outer loop
vertex 23.5 -54.5 184.5
vertex 23.5 -60.5 184.5
vertex 27 -60.5 181
endloop
endfacet
facet normal 0.6 0.6 0.6
outer loop
vertex 26 -54 181.5
vertex 23.5 -54.5 184.5
vertex 27 -54.5 181
endloop
endfacet
facet normal 0.7 -0 0.7
outer loop
vertex 27 -55 181
vertex 27 -54.5 181
vertex 23.5 -54.5 184.5
endloop
endfacet
facet normal 0.6 0.6 0.6
outer loop
vertex 26 -54 181.5
vertex 23.5 -53.5 183.5
vertex 23.5 -54.5 184.5
endloop
endfacet
facet normal 0.4 -0 0.9
outer loop
vertex 20 -60.5 186
vertex 23.5 -60.5 184.5
vertex 23.5 -54.5 184.5
endloop
endfacet
facet normal 0.3 0.7 0.7
outer loop
vertex 20 -54.5 186
vertex 23.5 -54.5 184.5
vertex 23.5 -53.5 183.5
endloop
endfacet
facet normal -0.7 -0.7 -0.3
outer loop
vertex -41 54.5 158
vertex -41 54.5 158
vertex -40 53.5 158
endloop
endfacet
facet normal -0.9 -0 -0.4
outer loop
vertex -41 54.5 158
vertex -41 60.5 158
vertex -41 54.5 158
endloop
endfacet
facet normal -0.9 0 -0.4
outer loop
vertex -41 54.5 158
vertex -41 60.5 158
vertex -41 60.5 158
endloop
endfacet
facet normal -0.7 -0.7 -0.3
outer loop
vertex -41 54.5 158
vertex -40 53.5 158
vertex -40 53.5 158
endloop
endfacet
facet normal -0.7 0.7 -0.3
outer loop
vertex -41 60.5 158
vertex -40 61.5 158
vertex -41 60.5 158
endloop
endfacet
facet normal -0.7 -0.7 -0
outer loop
vertex -41 54.5 158
vertex -40 53.5 158
vertex -41 54.5 165
endloop
endfacet
facet normal -1 0 -0
outer loop
vertex -41 54.5 158
vertex -41 60.5 165
vertex -41 60.5 158
endloop
endfacet
facet normal -0 -1 0
outer loop
vertex -40 53.5 158
vertex -36 53.5 165.5
vertex -40 53.5 158
endloop
endfacet
facet normal -0.7 -0.7 0
outer loop
vertex -40 53.5 158
vertex -40 53.5 165
vertex -41 54.5 165
endloop
endfacet
facet normal -1 -0 -0
outer loop
vertex -41 54.5 158
vertex -41 54.5 165
vertex -41 60.5 165
endloop
endfacet
facet normal -0.7 0.7 -0
outer loop
vertex -41 60.5 158
vertex -40 61.5 165
vertex -40 61.5 158
endloop
endfacet
facet normal 0 1 -0
outer loop
vertex -40 61.5 158
vertex -40 61.5 165
vertex -36 61.5 158
endloop
endfacet
facet normal -0.7 0.7 -0
outer loop
vertex -41 60.5 158
vertex -41 60.5 165
vertex -40 61.5 165
endloop
endfacet
facet normal 0 -1 0
outer loop
vertex -40 53.5 158
vertex -36 53.5 158
vertex -36 53.5 165.5
endloop
endfacet
facet normal 0.7 -0.7 0
outer loop
vertex -36 53.5 158
vertex -35 54.5 158
vertex -35 54.5 165.5
endloop
endfacet
facet normal 1 0 0
outer loop
vertex -35 54.5 158
vertex -35 60.5 158
vertex -35 60.5 165.5
endloop
endfacet
facet normal 0.7 0.7 -0
outer loop
vertex -35 60.5 158
vertex -36 61.5 158
vertex -36 61.5 165.5
endloop
endfacet
facet normal -0 -1 0
outer loop
vertex -40 53.5 158
vertex -36 53.5 165.5
vertex -40 53.5 165
endloop
endfacet
facet normal -0.7 -0.7 0.3
outer loop
vertex -41 54.5 165
vertex -40 53.5 165
vertex -38.5 53.5 168.5
endloop
endfacet
facet normal -0 -1 -0
outer loop
vertex -40 53.5 165
vertex -36 53.5 165.5
vertex -38.5 53.5 168.5
endloop
endfacet
facet normal -0.9 -0 0.4
outer loop
vertex -41 54.5 165
vertex -39.5 60.5 168.5
vertex -41 60.5 165
endloop
endfacet
facet normal -0.7 0.7 0.3
outer loop
vertex -41 60.5 165
vertex -39.5 60.5 168.5
vertex -40 61.5 165
endloop
endfacet
facet normal 0.7 -0.7 0
outer loop
vertex -36 53.5 158
vertex -35 54.5 165.5
vertex -36 53.5 165.5
endloop
endfacet
facet normal 1 0 -0
outer loop
vertex -35 54.5 158
vertex -35 60.5 165.5
vertex -35 54.5 165.5
endloop
endfacet
facet normal 0 1 0
outer loop
vertex -36 61.5 158
vertex -40 61.5 165
vertex -36 61.5 165.5
endloop
endfacet
facet normal 0.7 0.7 0
outer loop
vertex -35 60.5 158
vertex -36 61.5 165.5
vertex -35 60.5 165.5
endloop
endfacet
facet normal -0.7 -0.7 0.3
outer loop
vertex -41 54.5 165
vertex -38.5 53.5 168.5
vertex -39.5 54.5 168.5
endloop
endfacet
facet normal -0.9 0 0.4
outer loop
vertex -41 54.5 165
vertex -39.5 54.5 168.5
vertex -39.5 60.5 168.5
endloop
endfacet
facet normal -0.7 0.7 0.3
outer loop
vertex -40 61.5 165
vertex -39.5 60.5 168.5
vertex -38.5 61.5 168.5
endloop
endfacet
facet normal 0.6 -0.6 -0.6
outer loop
vertex -36 53.5 165.5
vertex -35 54.5 165.5
vertex -20.5 54.5 180
endloop
endfacet
facet normal 0.7 0 -0.7
outer loop
vertex -35 54.5 165.5
vertex -35 60.5 165.5
vertex -20.5 54.5 180
endloop
endfacet
facet normal 0.6 0.6 -0.6
outer loop
vertex -35 60.5 165.5
vertex -36 61.5 165.5
vertex -20.5 60.5 180
endloop
endfacet
facet normal -0.6 -0.6 0.6
outer loop
vertex -39.5 54.5 168.5
vertex -38.5 53.5 168.5
vertex -23.5 54.5 184.5
endloop
endfacet
facet normal 0 1 0
outer loop
vertex -40 61.5 165
vertex -23.5 61.5 183.5
vertex -36 61.5 165.5
endloop
endfacet
facet normal 0 1 0
outer loop
vertex -40 61.5 165
vertex -38.5 61.5 168.5
vertex -23.5 61.5 183.5
endloop
endfacet
facet normal -0.6 0.6 0.6
outer loop
vertex -39.5 60.5 168.5
vertex -23.5 61.5 183.5
vertex -38.5 61.5 168.5
endloop
endfacet
facet normal -0 -1 0
outer loop
vertex -36 53.5 165.5
vertex -20.5 53.5 181
vertex -38.5 53.5 168.5
endloop
endfacet
facet normal -0.6 -0.6 0.6
outer loop
vertex -38.5 53.5 168.5
vertex -23.5 53.5 183.5
vertex -23.5 54.5 184.5
endloop
endfacet
facet normal 0 -1 -0
outer loop
vertex -38.5 53.5 168.5
vertex -20.5 53.5 181
vertex -23.5 53.5 183.5
endloop
endfacet
facet normal -0 1 0
outer loop
vertex -36 61.5 165.5
vertex -23.5 61.5 183.5
vertex -20.5 61.5 181
endloop
endfacet
facet normal 0.6 -0.6 -0.6
outer loop
vertex -36 53.5 165.5
vertex -20.5 54.5 180
vertex -20.5 53.5 181
endloop
endfacet
facet normal 0.7 0 -0.7
outer loop
vertex -35 60.5 165.5
vertex -20.5 60.5 180
vertex -20.5 54.5 180
endloop
endfacet
facet normal 0.6 0.6 -0.6
outer loop
vertex -36 61.5 165.5
vertex -20.5 61.5 181
vertex -20.5 60.5 180
endloop
endfacet
facet normal -0.7 0 0.7
outer loop
vertex -39.5 60.5 168.5
vertex -39.5 54.5 168.5
vertex -23.5 60.5 184.5
endloop
endfacet
facet normal -0.6 0.6 0.6
outer loop
vertex -39.5 60.5 168.5
vertex -23.5 60.5 184.5
vertex -23.5 61.5 183.5
endloop
endfacet
facet normal -0.7 -0 0.7
outer loop
vertex -39.5 54.5 168.5
vertex -23.5 54.5 184.5
vertex -23.5 60.5 184.5
endloop
endfacet
facet normal -0.3 -0.7 0.7
outer loop
vertex -23.5 53.5 183.5
vertex -20 54.5 186
vertex -23.5 54.5 184.5
endloop
endfacet
facet normal -0.4 -0 0.9
outer loop
vertex -23.5 54.5 184.5
vertex -20 60.5 186
vertex -23.5 60.5 184.5
endloop
endfacet
facet normal -0.3 0.7 0.7
outer loop
vertex -23.5 60.5 184.5
vertex -20 60.5 186
vertex -23.5 61.5 183.5
endloop
endfacet
facet normal -0.3 -0.7 0.7
outer loop
vertex -23.5 53.5 183.5
vertex -20 53.5 185
vertex -20 54.5 186
endloop
endfacet
facet normal -0.4 0 0.9
outer loop
vertex -23.5 54.5 184.5
vertex -20 54.5 186
vertex -20 60.5 186
endloop
endfacet
facet normal -0.3 0.7 0.7
outer loop
vertex -23.5 61.5 183.5
vertex -20 60.5 186
vertex -20 61.5 185
endloop
endfacet
facet normal 0 0 -1
outer loop
vertex -20.5 54.5 180
vertex -20.5 60.5 180
vertex 20.5 60.5 180
endloop
endfacet
facet normal 0 -0.7 -0.7
outer loop
vertex -20.5 54.5 180
vertex 20.5 54.5 180
vertex -20.5 53.5 181
endloop
endfacet
facet normal 0 -1 -0
outer loop
vertex -23.5 53.5 183.5
vertex -20.5 53.5 181
vertex 23.5 53.5 183.5
endloop
endfacet
facet normal 0 0.7 -0.7
outer loop
vertex -20.5 60.5 180
vertex -20.5 61.5 181
vertex 20.5 61.5 181
endloop
endfacet
facet normal -0 1 0
outer loop
vertex -23.5 61.5 183.5
vertex 23.5 61.5 183.5
vertex -20.5 61.5 181
endloop
endfacet
facet normal 0 -1 0
outer loop
vertex -23.5 53.5 183.5
vertex 23.5 53.5 183.5
vertex -20 53.5 185
endloop
endfacet
facet normal 0 -0.7 0.7
outer loop
vertex -20 53.5 185
vertex 20 53.5 185
vertex -20 54.5 186
endloop
endfacet
facet normal 0 -0 1
outer loop
vertex -20 54.5 186
vertex 20 60.5 186
vertex -20 60.5 186
endloop
endfacet
facet normal -0 1 -0
outer loop
vertex -23.5 61.5 183.5
vertex -20 61.5 185
vertex 23.5 61.5 183.5
endloop
endfacet
facet normal 0 0.7 0.7
outer loop
vertex -20 60.5 186
vertex 20 61.5 185
vertex -20 61.5 185
endloop
endfacet
facet normal 0 -1 0
outer loop
vertex 36 53.5 158
vertex 40 53.5 158
vertex 40 53.5 158
endloop
endfacet
facet normal 0.7 -0.7 -0.3
outer loop
vertex 40 53.5 158
vertex 41 54.5 158
vertex 40 53.5 158
endloop
endfacet
facet normal 0.7 -0.7 -0.3
outer loop
vertex 40 53.5 158
vertex 41 54.5 158
vertex 41 54.5 158
endloop
endfacet
facet normal 0.9 0 -0.4
outer loop
vertex 41 54.5 158
vertex 41 60.5 158
vertex 41 54.5 158
endloop
endfacet
facet normal 0.9 0 -0.4
outer loop
vertex 41 54.5 158
vertex 41 60.5 158
vertex 41 60.5 158
endloop
endfacet
facet normal 0.7 0.7 -0.3
outer loop
vertex 41 60.5 158
vertex 40 61.5 158
vertex 41 60.5 158
endloop
endfacet
facet normal -0.7 -0.7 0
outer loop
vertex 36 53.5 158
vertex 36 53.5 165.5
vertex 35 54.5 158
endloop
endfacet
facet normal 0 -1 0
outer loop
vertex 36 53.5 158
vertex 40 53.5 158
vertex 36 53.5 165.5
endloop
endfacet
facet normal -1 0 0
outer loop
vertex 35 54.5 158
vertex 35 54.5 165.5
vertex 35 60.5 158
endloop
endfacet
facet normal -0.7 0.7 0
outer loop
vertex 35 60.5 158
vertex 35 60.5 165.5
vertex 36 61.5 158
endloop
endfacet
facet normal -0 1 0
outer loop
vertex 36 61.5 158
vertex 36 61.5 165.5
vertex 40 61.5 158
endloop
endfacet
facet normal 0.7 -0.7 0
outer loop
vertex 40 53.5 158
vertex 41 54.5 158
vertex 41 54.5 165
endloop
endfacet
facet normal 1 -0 0
outer loop
vertex 41 54.5 158
vertex 41 60.5 158
vertex 41 60.5 165
endloop
endfacet
facet normal 0.7 -0.7 -0
outer loop
vertex 40 53.5 158
vertex 41 54.5 165
vertex 40 53.5 165
endloop
endfacet
facet normal 1 -0 0
outer loop
vertex 41 54.5 158
vertex 41 60.5 165
vertex 41 54.5 165
endloop
endfacet
facet normal 0.7 0.7 -0
outer loop
vertex 41 60.5 158
vertex 40 61.5 158
vertex 41 60.5 165
endloop
endfacet
facet normal 0.7 0.7 -0
outer loop
vertex 40 61.5 158
vertex 40 61.5 165
vertex 41 60.5 165
endloop
endfacet
facet normal -0.6 -0.6 -0.6
outer loop
vertex 36 53.5 165.5
vertex 20.5 54.5 180
vertex 35 54.5 165.5
endloop
endfacet
facet normal -0.7 0 -0.7
outer loop
vertex 35 54.5 165.5
vertex 20.5 60.5 180
vertex 35 60.5 165.5
endloop
endfacet
facet normal -0.7 -0.7 0
outer loop
vertex 35 54.5 158
vertex 36 53.5 165.5
vertex 35 54.5 165.5
endloop
endfacet
facet normal -1 0 0
outer loop
vertex 35 60.5 158
vertex 35 54.5 165.5
vertex 35 60.5 165.5
endloop
endfacet
facet normal -0.7 0.7 0
outer loop
vertex 36 61.5 158
vertex 35 60.5 165.5
vertex 36 61.5 165.5
endloop
endfacet
facet normal 0 -1 0
outer loop
vertex 40 53.5 158
vertex 40 53.5 165
vertex 36 53.5 165.5
endloop
endfacet
facet normal 0 -1 -0
outer loop
vertex 36 53.5 165.5
vertex 40 53.5 165
vertex 38.5 53.5 168.5
endloop
endfacet
facet normal 0.7 -0.7 0.3
outer loop
vertex 40 53.5 165
vertex 41 54.5 165
vertex 38.5 53.5 168.5
endloop
endfacet
facet normal 0.9 0 0.4
outer loop
vertex 41 54.5 165
vertex 41 60.5 165
vertex 39.5 54.5 168.5
endloop
endfacet
facet normal -0 1 -0
outer loop
vertex 40 61.5 158
vertex 36 61.5 165.5
vertex 40 61.5 165
endloop
endfacet
facet normal -0 1 0
outer loop
vertex 36 61.5 165.5
vertex 38.5 61.5 168.5
vertex 40 61.5 165
endloop
endfacet
facet normal 0.7 0.7 0.3
outer loop
vertex 41 60.5 165
vertex 40 61.5 165
vertex 38.5 61.5 168.5
endloop
endfacet
facet normal 0.7 -0.7 0.3
outer loop
vertex 41 54.5 165
vertex 39.5 54.5 168.5
vertex 38.5 53.5 168.5
endloop
endfacet
facet normal 0.9 0 0.4
outer loop
vertex 41 60.5 165
vertex 39.5 60.5 168.5
vertex 39.5 54.5 168.5
endloop
endfacet
facet normal 0.7 0.7 0.3
outer loop
vertex 41 60.5 165
vertex 38.5 61.5 168.5
vertex 39.5 60.5 168.5
endloop
endfacet
facet normal 0 0 -1
outer loop
vertex -20.5 54.5 180
vertex 20.5 60.5 180
vertex 20.5 54.5 180
endloop
endfacet
facet normal 0 -0.7 -0.7
outer loop
vertex -20.5 53.5 181
vertex 20.5 54.5 180
vertex 20.5 53.5 181
endloop
endfacet
facet normal 0 -1 0
outer loop
vertex -20.5 53.5 181
vertex 20.5 53.5 181
vertex 23.5 53.5 183.5
endloop
endfacet
facet normal 0 0.7 -0.7
outer loop
vertex -20.5 60.5 180
vertex 20.5 61.5 181
vertex 20.5 60.5 180
endloop
endfacet
facet normal -0 1 0
outer loop
vertex -20.5 61.5 181
vertex 23.5 61.5 183.5
vertex 20.5 61.5 181
endloop
endfacet
facet normal 0 -1 0
outer loop
vertex -20 53.5 185
vertex 23.5 53.5 183.5
vertex 20 53.5 185
endloop
endfacet
facet normal 0 -0.7 0.7
outer loop
vertex -20 54.5 186
vertex 20 53.5 185
vertex 20 54.5 186
endloop
endfacet
facet normal 0 0 1
outer loop
vertex -20 54.5 186
vertex 20 54.5 186
vertex 20 60.5 186
endloop
endfacet
facet normal -0 1 0
outer loop
vertex -20 61.5 185
vertex 20 61.5 185
vertex 23.5 61.5 183.5
endloop
endfacet
facet normal -0 0.7 0.7
outer loop
vertex -20 60.5 186
vertex 20 60.5 186
vertex 20 61.5 185
endloop
endfacet
facet normal 0.3 -0.7 0.7
outer loop
vertex 20 53.5 185
vertex 23.5 53.5 183.5
vertex 20 54.5 186
endloop
endfacet
facet normal 0.4 0 0.9
outer loop
vertex 20 54.5 186
vertex 23.5 60.5 184.5
vertex 20 60.5 186
endloop
endfacet
facet normal 0.3 0.7 0.7
outer loop
vertex 20 60.5 186
vertex 23.5 61.5 183.5
vertex 20 61.5 185
endloop
endfacet
facet normal 0 -1 0
outer loop
vertex 36 53.5 165.5
vertex 38.5 53.5 168.5
vertex 20.5 53.5 181
endloop
endfacet
facet normal -0.6 0.6 -0.6
outer loop
vertex 35 60.5 165.5
vertex 20.5 61.5 181
vertex 36 61.5 165.5
endloop
endfacet
facet normal -0 1 -0
outer loop
vertex 36 61.5 165.5
vertex 20.5 61.5 181
vertex 38.5 61.5 168.5
endloop
endfacet
facet normal -0.6 -0.6 -0.6
outer loop
vertex 36 53.5 165.5
vertex 20.5 53.5 181
vertex 20.5 54.5 180
endloop
endfacet
facet normal -0.7 0 -0.7
outer loop
vertex 35 54.5 165.5
vertex 20.5 54.5 180
vertex 20.5 60.5 180
endloop
endfacet
facet normal -0.6 0.6 -0.6
outer loop
vertex 35 60.5 165.5
vertex 20.5 60.5 180
vertex 20.5 61.5 181
endloop
endfacet
facet normal 0 -1 0
outer loop
vertex 38.5 53.5 168.5
vertex 26 53.5 181
vertex 20.5 53.5 181
endloop
endfacet
facet normal 0.6 -0.6 0.6
outer loop
vertex 38.5 53.5 168.5
vertex 27 54.5 181
vertex 26 53.5 181
endloop
endfacet
facet normal 0.7 -0 0.7
outer loop
vertex 39.5 54.5 168.5
vertex 23.5 60.5 184.5
vertex 27 54.5 181
endloop
endfacet
facet normal 0.6 -0.6 0.6
outer loop
vertex 39.5 54.5 168.5
vertex 27 54.5 181
vertex 27 54.5 181
endloop
endfacet
facet normal 0.7 0 0.7
outer loop
vertex 39.5 54.5 168.5
vertex 27 60 181
vertex 23.5 60.5 184.5
endloop
endfacet
facet normal 0.6 0.6 0.6
outer loop
vertex 39.5 60.5 168.5
vertex 27 60.5 181
vertex 27 60.5 181
endloop
endfacet
facet normal 0.7 0 0.7
outer loop
vertex 39.5 60.5 168.5
vertex 27 60.5 181
vertex 27 60 181
endloop
endfacet
facet normal 0 1 -0
outer loop
vertex 38.5 61.5 168.5
vertex 20.5 61.5 181
vertex 26 61.5 181
endloop
endfacet
facet normal 0.6 0.6 0.6
outer loop
vertex 38.5 61.5 168.5
vertex 26 61.5 181
vertex 27 60.5 181
endloop
endfacet
facet normal 0.6 -0.6 0.6
outer loop
vertex 38.5 53.5 168.5
vertex 39.5 54.5 168.5
vertex 27 54.5 181
endloop
endfacet
facet normal 0.7 -0 0.7
outer loop
vertex 39.5 54.5 168.5
vertex 39.5 60.5 168.5
vertex 27 60 181
endloop
endfacet
facet normal 0.6 0.6 0.6
outer loop
vertex 39.5 60.5 168.5
vertex 38.5 61.5 168.5
vertex 27 60.5 181
endloop
endfacet
facet normal 0 -1 0
outer loop
vertex 20.5 53.5 181
vertex 26 53.5 181
vertex 23.5 53.5 183.5
endloop
endfacet
facet normal 0.6 -0.6 0.6
outer loop
vertex 26 53.5 181
vertex 26 54 181.5
vertex 23.5 53.5 183.5
endloop
endfacet
facet normal 0.6 -0.6 0.6
outer loop
vertex 26 53.5 181
vertex 27 54.5 181
vertex 26 54 181.5
endloop
endfacet
facet normal 0.6 -0.6 0.6
outer loop
vertex 26 54 181.5
vertex 27 54.5 181
vertex 27 54.5 181
endloop
endfacet
facet normal 0.6 0.6 0.6
outer loop
vertex 26 61 181.5
vertex 27 60.5 181
vertex 27 60.5 181
endloop
endfacet
facet normal -0 1 0
outer loop
vertex 20.5 61.5 181
vertex 23.5 61.5 183.5
vertex 26 61.5 181
endloop
endfacet
facet normal 0.6 0.6 0.6
outer loop
vertex 26 61 181.5
vertex 26 61.5 181
vertex 23.5 61.5 183.5
endloop
endfacet
facet normal 0.6 0.6 0.6
outer loop
vertex 26 61 181.5
vertex 27 60.5 181
vertex 26 61.5 181
endloop
endfacet
facet normal 0.6 -0.6 0.6
outer loop
vertex 26 54 181.5
vertex 27 54.5 181
vertex 23.5 54.5 184.5
endloop
endfacet
facet normal 0.7 -0 0.7
outer loop
vertex 23.5 60.5 184.5
vertex 23.5 54.5 184.5
vertex 27 54.5 181
endloop
endfacet
facet normal 0.6 -0.6 0.6
outer loop
vertex 26 54 181.5
vertex 23.5 54.5 184.5
vertex 23.5 53.5 183.5
endloop
endfacet
facet normal 0.6 0.6 0.6
outer loop
vertex 26 61 181.5
vertex 23.5 60.5 184.5
vertex 27 60.5 181
endloop
endfacet
facet normal 0.7 -0 0.7
outer loop
vertex 27 60 181
vertex 27 60.5 181
vertex 23.5 60.5 184.5
endloop
endfacet
facet normal 0.3 -0.7 0.7
outer loop
vertex 20 54.5 186
vertex 23.5 53.5 183.5
vertex 23.5 54.5 184.5
endloop
endfacet
facet normal 0.4 -0 0.9
outer loop
vertex 20 54.5 186
vertex 23.5 54.5 184.5
vertex 23.5 60.5 184.5
endloop
endfacet
facet normal 0.6 0.6 0.6
outer loop
vertex 26 61 181.5
vertex 23.5 61.5 183.5
vertex 23.5 60.5 184.5
endloop
endfacet
facet normal 0.3 0.7 0.7
outer loop
vertex 20 60.5 186
vertex 23.5 60.5 184.5
vertex 23.5 61.5 183.5
endloop
endfacet
facet normal 0.9 0.4 0
outer loop
vertex -38.5 -47 158
vertex -38 -48.5 155
vertex -38.5 -47 155
endloop
endfacet
facet normal 0.9 -0.4 -0
outer loop
vertex -38 -45.5 158
vertex -38.5 -47 155
vertex -38 -46 155
endloop
endfacet
facet normal 0.9 0.4 0
outer loop
vertex -38.5 -47 158
vertex -38 -48 158
vertex -38 -48.5 155
endloop
endfacet
facet normal 0.9 -0.4 0
outer loop
vertex -38 -45.5 158
vertex -38.5 -47 158
vertex -38.5 -47 155
endloop
endfacet
facet normal 0.4 -0.9 0
outer loop
vertex -38 -45.5 158
vertex -38 -46 155
vertex -37 -45.5 155
endloop
endfacet
facet normal 0 1 0.1
outer loop
vertex -37 -48.5 158
vertex -25 -48.5 155
vertex -38 -48.5 155
endloop
endfacet
facet normal 0.4 0.9 -0
outer loop
vertex -38 -48 158
vertex -37 -48.5 158
vertex -38 -48.5 155
endloop
endfacet
facet normal 0 -1 -0.1
outer loop
vertex -25 -45.5 158
vertex -38 -45.5 158
vertex -37 -45.5 155
endloop
endfacet
facet normal -0 -1 0.1
outer loop
vertex -37 -45.5 155
vertex -24 -45.5 155
vertex -25 -45.5 158
endloop
endfacet
facet normal -0 1 -0.1
outer loop
vertex -37 -48.5 158
vertex -24 -48.5 158
vertex -25 -48.5 155
endloop
endfacet
facet normal -0.4 0.9 0
outer loop
vertex -23.5 -48 155
vertex -25 -48.5 155
vertex -24 -48.5 158
endloop
endfacet
facet normal -0.9 0.4 -0
outer loop
vertex -23 -47 155
vertex -23.5 -48 155
vertex -24 -48.5 158
endloop
endfacet
facet normal -0.9 -0.4 0
outer loop
vertex -24 -45.5 155
vertex -23 -47 155
vertex -23 -47 158
endloop
endfacet
facet normal -0.4 -0.9 -0
outer loop
vertex -24 -45.5 155
vertex -23.5 -46 158
vertex -25 -45.5 158
endloop
endfacet
facet normal -0.9 0.4 0
outer loop
vertex -23 -47 155
vertex -24 -48.5 158
vertex -23 -47 158
endloop
endfacet
facet normal -0.9 -0.4 0
outer loop
vertex -24 -45.5 155
vertex -23 -47 158
vertex -23.5 -46 158
endloop
endfacet
facet normal 0.9 0.4 0
outer loop
vertex -38.5 47 158
vertex -38 46 155
vertex -38.5 47 155
endloop
endfacet
facet normal 0.9 -0.4 0
outer loop
vertex -38 48 158
vertex -38.5 47 155
vertex -38 48 155
endloop
endfacet
facet normal 0.9 -0.4 0
outer loop
vertex -38 48 158
vertex -38.5 47 158
vertex -38.5 47 155
endloop
endfacet
facet normal 0.9 0.4 0
outer loop
vertex -38.5 47 158
vertex -38 46 158
vertex -38 46 155
endloop
endfacet
facet normal 0.4 0.9 0
outer loop
vertex -38 46 158
vertex -37 45.5 155
vertex -38 46 155
endloop
endfacet
facet normal 0.4 -0.9 0
outer loop
vertex -37 48.5 158
vertex -38 48 155
vertex -37 48.5 155
endloop
endfacet
facet normal 0 1 0
outer loop
vertex -37 45.5 158
vertex -25 45.5 155
vertex -37 45.5 155
endloop
endfacet
facet normal 0.4 0.9 0
outer loop
vertex -38 46 158
vertex -37 45.5 158
vertex -37 45.5 155
endloop
endfacet
facet normal 0.4 -0.9 0
outer loop
vertex -37 48.5 158
vertex -38 48 158
vertex -38 48 155
endloop
endfacet
facet normal -0 -1 -0
outer loop
vertex -25 48.5 158
vertex -37 48.5 158
vertex -37 48.5 155
endloop
endfacet
facet normal 0 -1 0
outer loop
vertex -37 48.5 155
vertex -25 48.5 155
vertex -25 48.5 158
endloop
endfacet
facet normal 0 1 -0
outer loop
vertex -25 45.5 155
vertex -37 45.5 158
vertex -25 45.5 158
endloop
endfacet
facet normal -0.4 0.9 0
outer loop
vertex -23.5 46 155
vertex -25 45.5 155
vertex -25 45.5 158
endloop
endfacet
facet normal -0.9 0.4 0
outer loop
vertex -23 47 155
vertex -23.5 46 155
vertex -23.5 46 158
endloop
endfacet
facet normal -0.9 -0.4 0
outer loop
vertex -23.5 48 155
vertex -23 47 155
vertex -23 47 158
endloop
endfacet
facet normal -0.4 -0.9 0
outer loop
vertex -25 48.5 155
vertex -23.5 48 155
vertex -23.5 48 158
endloop
endfacet
facet normal -0.4 -0.9 0
outer loop
vertex -25 48.5 155
vertex -23.5 48 158
vertex -25 48.5 158
endloop
endfacet
facet normal -0.4 0.9 0
outer loop
vertex -23.5 46 155
vertex -25 45.5 158
vertex -23.5 46 158
endloop
endfacet
facet normal -0.9 0.4 0
outer loop
vertex -23 47 155
vertex -23.5 46 158
vertex -23 47 158
endloop
endfacet
facet normal -0.9 -0.4 0
outer loop
vertex -23.5 48 155
vertex -23 47 158
vertex -23.5 48 158
endloop
endfacet
facet normal 0.4 0.9 -0
outer loop
vertex 25 -48.5 155
vertex 23.5 -48 155
vertex 23.5 -48 158
endloop
endfacet
facet normal 0.9 0.4 -0
outer loop
vertex 23.5 -48 155
vertex 23 -47 155
vertex 23 -47 158
endloop
endfacet
facet normal 0.9 -0.4 0
outer loop
vertex 23 -47 155
vertex 23.5 -46 155
vertex 23.5 -46 158
endloop
endfacet
facet normal 0.4 -0.9 0
outer loop
vertex 23.5 -46 155
vertex 25 -45.5 155
vertex 25 -45.5 158
endloop
endfacet
facet normal 0.9 0.4 0
outer loop
vertex 23.5 -48 155
vertex 23 -47 158
vertex 23.5 -48 158
endloop
endfacet
facet normal 0.9 -0.4 0
outer loop
vertex 23 -47 155
vertex 23.5 -46 158
vertex 23 -47 158
endloop
endfacet
facet normal 0.4 -0.9 0
outer loop
vertex 23.5 -46 155
vertex 25 -45.5 158
vertex 23.5 -46 158
endloop
endfacet
facet normal 0.4 0.9 0
outer loop
vertex 25 -48.5 155
vertex 23.5 -48 158
vertex 25 -48.5 158
endloop
endfacet
facet normal 0 1 -0
outer loop
vertex 37 -48.5 155
vertex 25 -48.5 155
vertex 25 -48.5 158
endloop
endfacet
facet normal 0 -1 0
outer loop
vertex 25 -45.5 155
vertex 37 -45.5 158
vertex 25 -45.5 158
endloop
endfacet
facet normal 0 -1 0
outer loop
vertex 25 -45.5 155
vertex 37 -45.5 155
vertex 37 -45.5 158
endloop
endfacet
facet normal -0.4 0.9 0
outer loop
vertex 38 -48 155
vertex 37 -48.5 155
vertex 37 -48.5 158
endloop
endfacet
facet normal -0.4 -0.9 0
outer loop
vertex 37 -45.5 155
vertex 38 -46 155
vertex 38 -46 158
endloop
endfacet
facet normal -0 1 0
outer loop
vertex 25 -48.5 158
vertex 37 -48.5 158
vertex 37 -48.5 155
endloop
endfacet
facet normal -0.4 0.9 0
outer loop
vertex 38 -48 155
vertex 37 -48.5 158
vertex 38 -48 158
endloop
endfacet
facet normal -0.4 -0.9 0
outer loop
vertex 37 -45.5 155
vertex 38 -46 158
vertex 37 -45.5 158
endloop
endfacet
facet normal -0.9 0.4 0
outer loop
vertex 38.5 -47 155
vertex 38 -48 155
vertex 38 -48 158
endloop
endfacet
facet normal -0.9 -0.4 0
outer loop
vertex 38 -46 155
vertex 38.5 -47 155
vertex 38.5 -47 158
endloop
endfacet
facet normal -0.9 -0.4 0
outer loop
vertex 38 -46 155
vertex 38.5 -47 158
vertex 38 -46 158
endloop
endfacet
facet normal -0.9 0.4 0
outer loop
vertex 38.5 -47 155
vertex 38 -48 158
vertex 38.5 -47 158
endloop
endfacet
facet normal 0.9 0.4 -0
outer loop
vertex 23.5 46 155
vertex 23 47 155
vertex 23 47 158
endloop
endfacet
facet normal 0.4 0.9 -0
outer loop
vertex 25 45.5 155
vertex 23.5 46 155
vertex 23.5 46 158
endloop
endfacet
facet normal 0.9 -0.4 0
outer loop
vertex 23 47 155
vertex 23.5 48 155
vertex 23.5 48 158
endloop
endfacet
facet normal 0.4 -0.9 0
outer loop
vertex 23.5 48 155
vertex 25 48.5 155
vertex 25 48.5 158
endloop
endfacet
facet normal 0.9 0.4 0
outer loop
vertex 23.5 46 155
vertex 23 47 158
vertex 23.5 46 158
endloop
endfacet
facet normal 0.9 -0.4 0
outer loop
vertex 23 47 155
vertex 23.5 48 158
vertex 23 47 158
endloop
endfacet
facet normal 0.4 -0.9 0
outer loop
vertex 23.5 48 155
vertex 25 48.5 158
vertex 23.5 48 158
endloop
endfacet
facet normal 0.4 0.9 0
outer loop
vertex 25 45.5 155
vertex 23.5 46 158
vertex 25 45.5 158
endloop
endfacet
facet normal 0 1 -0
outer loop
vertex 37 45.5 155
vertex 25 45.5 155
vertex 25 45.5 158
endloop
endfacet
facet normal 0 -1 0
outer loop
vertex 25 48.5 155
vertex 37 48.5 155
vertex 25 48.5 158
endloop
endfacet
facet normal -0.4 0.9 0
outer loop
vertex 38 46 155
vertex 37 45.5 155
vertex 37 45.5 158
endloop
endfacet
facet normal -0.4 -0.9 0
outer loop
vertex 37 48.5 155
vertex 38 48 155
vertex 38 48 158
endloop
endfacet
facet normal -0 1 0
outer loop
vertex 25 45.5 158
vertex 37 45.5 158
vertex 37 45.5 155
endloop
endfacet
facet normal -0 -1 -0
outer loop
vertex 37 48.5 158
vertex 25 48.5 158
vertex 37 48.5 155
endloop
endfacet
facet normal -0.4 0.9 0
outer loop
vertex 38 46 155
vertex 37 45.5 158
vertex 38 46 158
endloop
endfacet
facet normal -0.4 -0.9 0
outer loop
vertex 37 48.5 155
vertex 38 48 158
vertex 37 48.5 158
endloop
endfacet
facet normal -0.9 0.4 0
outer loop
vertex 38.5 47 155
vertex 38 46 155
vertex 38 46 158
endloop
endfacet
facet normal -0.9 -0.4 0
outer loop
vertex 38 48 155
vertex 38.5 47 155
vertex 38.5 47 158
endloop
endfacet
facet normal -0.9 0.4 0
outer loop
vertex 38.5 47 155
vertex 38 46 158
vertex 38.5 47 158
endloop
endfacet
facet normal -0.9 -0.4 0
outer loop
vertex 38 48 155
vertex 38.5 47 158
vertex 38 48 158
endloop
endfacet
facet normal 0.5 0.9 0
outer loop
vertex -16.5 -51.5 155
vertex -18 -51 155
vertex -17.5 -51 158
endloop
endfacet
facet normal -0.4 0.9 0
outer loop
vertex -15.5 -51 155
vertex -16.5 -51.5 155
vertex -16.5 -51.5 158
endloop
endfacet
facet normal 0.9 0.4 -0
outer loop
vertex -18 -51 155
vertex -18 -50 158
vertex -17.5 -51 158
endloop
endfacet
facet normal 0.4 0.9 0
outer loop
vertex -16.5 -51.5 155
vertex -17.5 -51 158
vertex -16.5 -51.5 158
endloop
endfacet
facet normal -0.4 0.9 0
outer loop
vertex -15.5 -51 155
vertex -16.5 -51.5 158
vertex -15.5 -51 158
endloop
endfacet
facet normal -0.9 0.4 -0
outer loop
vertex -15.5 -51 155
vertex -15.5 -51 158
vertex -15 -50 158
endloop
endfacet
facet normal 1 0 0.1
outer loop
vertex -18 50 155
vertex -18 -50 158
vertex -18 -51 155
endloop
endfacet
facet normal -1 0 0.1
outer loop
vertex -15 50 155
vertex -15.5 -51 155
vertex -15 -50 158
endloop
endfacet
facet normal 1 0 0
outer loop
vertex -18 50 155
vertex -18 30 158
vertex -18 -50 158
endloop
endfacet
facet normal -1 0 0
outer loop
vertex -15 -50 158
vertex -15 50 158
vertex -15 50 155
endloop
endfacet
facet normal 1 -0 -0.1
outer loop
vertex -18 30 158
vertex -18 50 155
vertex -18 51 158
endloop
endfacet
facet normal 0.9 -0.4 0
outer loop
vertex -18 50 155
vertex -17.5 51 155
vertex -18 51 158
endloop
endfacet
facet normal 0.4 -0.9 0
outer loop
vertex -17.5 51 155
vertex -16.5 51.5 155
vertex -16.5 51.5 158
endloop
endfacet
facet normal 0.5 -0.9 -0
outer loop
vertex -17.5 51 155
vertex -16.5 51.5 158
vertex -18 51 158
endloop
endfacet
facet normal -0.4 -0.9 0
outer loop
vertex -16.5 51.5 155
vertex -15.5 51 158
vertex -16.5 51.5 158
endloop
endfacet
facet normal -0.4 -0.9 0
outer loop
vertex -16.5 51.5 155
vertex -15.5 51 155
vertex -15.5 51 158
endloop
endfacet
facet normal -0.9 -0.4 0
outer loop
vertex -15.5 51 155
vertex -15 50 155
vertex -15 50 158
endloop
endfacet
facet normal -0.9 -0.4 0
outer loop
vertex -15.5 51 155
vertex -15 50 158
vertex -15.5 51 158
endloop
endfacet
facet normal 0.9 0.4 0
outer loop
vertex -12 -51 155
vertex -12.5 -50 155
vertex -12 -51 158
endloop
endfacet
facet normal 0.4 0.9 -0
outer loop
vertex -11 -51.5 155
vertex -12 -51 155
vertex -12 -51 158
endloop
endfacet
facet normal 0.4 0.9 0
outer loop
vertex -11 -51.5 155
vertex -12 -51 158
vertex -11 -51.5 158
endloop
endfacet
facet normal -0.4 0.9 0
outer loop
vertex -10 -51 155
vertex -11 -51.5 155
vertex -11 -51.5 158
endloop
endfacet
facet normal -0.4 0.9 0
outer loop
vertex -10 -51 155
vertex -11 -51.5 158
vertex -10 -51 158
endloop
endfacet
facet normal -0.9 0.4 -0
outer loop
vertex -10 -51 155
vertex -10 -51 158
vertex -9.5 -50 158
endloop
endfacet
facet normal 1 0 -0.1
outer loop
vertex -12.5 50 158
vertex -12 -51 158
vertex -12.5 -50 155
endloop
endfacet
facet normal -1 0 0.1
outer loop
vertex -9.5 50 155
vertex -10 -51 155
vertex -9.5 -50 158
endloop
endfacet
facet normal 1 0 0
outer loop
vertex -12.5 -50 155
vertex -12.5 50 155
vertex -12.5 50 158
endloop
endfacet
facet normal -1 0 0
outer loop
vertex -9.5 -50 158
vertex -9.5 50 158
vertex -9.5 50 155
endloop
endfacet
facet normal 0.9 -0.4 0
outer loop
vertex -12.5 50 155
vertex -12 51 155
vertex -12 51 158
endloop
endfacet
facet normal 0.4 -0.9 0
outer loop
vertex -12 51 155
vertex -11 51.5 155
vertex -11 51.5 158
endloop
endfacet
facet normal 0.9 -0.4 0
outer loop
vertex -12.5 50 155
vertex -12 51 158
vertex -12.5 50 158
endloop
endfacet
facet normal 0.4 -0.9 0
outer loop
vertex -12 51 155
vertex -11 51.5 158
vertex -12 51 158
endloop
endfacet
facet normal -0.4 -0.9 0
outer loop
vertex -11 51.5 155
vertex -10 51 155
vertex -10 51 158
endloop
endfacet
facet normal -0.9 -0.4 0
outer loop
vertex -10 51 155
vertex -9.5 50 155
vertex -9.5 50 158
endloop
endfacet
facet normal -0.4 -0.9 0
outer loop
vertex -11 51.5 155
vertex -10 51 158
vertex -11 51.5 158
endloop
endfacet
facet normal -0.9 -0.4 0
outer loop
vertex -10 51 155
vertex -9.5 50 158
vertex -10 51 158
endloop
endfacet
facet normal 0.9 0.4 0
outer loop
vertex -6.5 -51 155
vertex -7 -50 155
vertex -6.5 -51 158
endloop
endfacet
facet normal 0.4 0.9 -0
outer loop
vertex -5.5 -51.5 155
vertex -6.5 -51 155
vertex -6.5 -51 158
endloop
endfacet
facet normal 0.4 0.9 0
outer loop
vertex -5.5 -51.5 155
vertex -6.5 -51 158
vertex -5.5 -51.5 158
endloop
endfacet
facet normal -0.4 0.9 0
outer loop
vertex -4.5 -51 155
vertex -5.5 -51.5 155
vertex -5.5 -51.5 158
endloop
endfacet
facet normal -0.4 0.9 0
outer loop
vertex -4.5 -51 155
vertex -5.5 -51.5 158
vertex -4.5 -51 158
endloop
endfacet
facet normal -0.9 0.4 -0
outer loop
vertex -4.5 -51 155
vertex -4.5 -51 158
vertex -4 -50 158
endloop
endfacet
facet normal 1 0 -0.1
outer loop
vertex -7 50 158
vertex -6.5 -51 158
vertex -7 -50 155
endloop
endfacet
facet normal -1 0 0.1
outer loop
vertex -4 50 155
vertex -4.5 -51 155
vertex -4 -50 158
endloop
endfacet
facet normal 1 0 0
outer loop
vertex -7 -50 155
vertex -7 50 155
vertex -7 50 158
endloop
endfacet
facet normal -1 0 0
outer loop
vertex -4 -50 158
vertex -4 50 158
vertex -4 50 155
endloop
endfacet
facet normal 0.9 -0.4 0
outer loop
vertex -7 50 155
vertex -6.5 51 155
vertex -6.5 51 158
endloop
endfacet
facet normal 0.4 -0.9 0
outer loop
vertex -6.5 51 155
vertex -5.5 51.5 155
vertex -5.5 51.5 158
endloop
endfacet
facet normal 0.9 -0.4 0
outer loop
vertex -7 50 155
vertex -6.5 51 158
vertex -7 50 158
endloop
endfacet
facet normal 0.4 -0.9 0
outer loop
vertex -6.5 51 155
vertex -5.5 51.5 158
vertex -6.5 51 158
endloop
endfacet
facet normal -0.4 -0.9 0
outer loop
vertex -5.5 51.5 155
vertex -4.5 51 155
vertex -4.5 51 158
endloop
endfacet
facet normal -0.9 -0.4 0
outer loop
vertex -4.5 51 155
vertex -4 50 155
vertex -4 50 158
endloop
endfacet
facet normal -0.4 -0.9 0
outer loop
vertex -5.5 51.5 155
vertex -4.5 51 158
vertex -5.5 51.5 158
endloop
endfacet
facet normal -0.9 -0.4 0
outer loop
vertex -4.5 51 155
vertex -4 50 158
vertex -4.5 51 158
endloop
endfacet
facet normal 0.9 0.4 -0
outer loop
vertex -1 -51 155
vertex -1.5 -50 155
vertex -1.5 -50 158
endloop
endfacet
facet normal 0.4 0.9 -0
outer loop
vertex -1 -51 155
vertex -1 -51 158
vertex 0 -51.5 155
endloop
endfacet
facet normal 0.9 0.4 0
outer loop
vertex -1 -51 155
vertex -1.5 -50 158
vertex -1 -51 158
endloop
endfacet
facet normal 0.4 0.9 0
outer loop
vertex 0 -51.5 155
vertex -1 -51 158
vertex 0 -51.5 158
endloop
endfacet
facet normal 1 0 0
outer loop
vertex -1.5 50 158
vertex -1.5 -50 158
vertex -1.5 -50 155
endloop
endfacet
facet normal 1 0 0
outer loop
vertex -1.5 -50 155
vertex -1.5 50 155
vertex -1.5 50 158
endloop
endfacet
facet normal 0.9 -0.4 0
outer loop
vertex -1.5 50 155
vertex -1 51 155
vertex -1 51 158
endloop
endfacet
facet normal 0.4 -0.9 0
outer loop
vertex -1 51 155
vertex 0 51.5 155
vertex 0 51.5 158
endloop
endfacet
facet normal 0.9 -0.4 0
outer loop
vertex -1.5 50 155
vertex -1 51 158
vertex -1.5 50 158
endloop
endfacet
facet normal 0.4 -0.9 0
outer loop
vertex -1 51 155
vertex 0 51.5 158
vertex -1 51 158
endloop
endfacet
facet normal -0.4 0.9 0
outer loop
vertex 0 -51.5 155
vertex 0 -51.5 158
vertex 1 -51 155
endloop
endfacet
facet normal -0.9 0.4 0
outer loop
vertex 1.5 -50 155
vertex 1 -51 155
vertex 1 -51 158
endloop
endfacet
facet normal -0.4 0.9 0
outer loop
vertex 1 -51 155
vertex 0 -51.5 158
vertex 1 -51 158
endloop
endfacet
facet normal -0.9 0.4 0
outer loop
vertex 1.5 -50 155
vertex 1 -51 158
vertex 1.5 -50 158
endloop
endfacet
facet normal -1 0 0
outer loop
vertex 1.5 50 155
vertex 1.5 -50 155
vertex 1.5 -50 158
endloop
endfacet
facet normal -1 0 0
outer loop
vertex 1.5 -50 158
vertex 1.5 50 158
vertex 1.5 50 155
endloop
endfacet
facet normal -0.4 -0.9 0
outer loop
vertex 0 51.5 155
vertex 1 51 155
vertex 1 51 158
endloop
endfacet
facet normal -0.9 -0.4 0
outer loop
vertex 1 51 155
vertex 1.5 50 155
vertex 1.5 50 158
endloop
endfacet
facet normal -0.4 -0.9 0
outer loop
vertex 0 51.5 155
vertex 1 51 158
vertex 0 51.5 158
endloop
endfacet
facet normal -0.9 -0.4 0
outer loop
vertex 1 51 155
vertex 1.5 50 158
vertex 1 51 158
endloop
endfacet
facet normal 0.9 0.4 -0
outer loop
vertex 4.5 -51 155
vertex 4 -50 155
vertex 4 -50 158
endloop
endfacet
facet normal 0.4 0.9 -0
outer loop
vertex 5.5 -51.5 155
vertex 4.5 -51 155
vertex 4.5 -51 158
endloop
endfacet
facet normal 0.9 0.4 0
outer loop
vertex 4.5 -51 155
vertex 4 -50 158
vertex 4.5 -51 158
endloop
endfacet
facet normal 0.4 0.9 0
outer loop
vertex 5.5 -51.5 155
vertex 4.5 -51 158
vertex 5.5 -51.5 158
endloop
endfacet
facet normal -0.4 0.9 0
outer loop
vertex 6.5 -51 155
vertex 5.5 -51.5 155
vertex 5.5 -51.5 158
endloop
endfacet
facet normal -0.9 0.4 0
outer loop
vertex 7 -50 155
vertex 6.5 -51 155
vertex 6.5 -51 158
endloop
endfacet
facet normal -0.4 0.9 0
outer loop
vertex 6.5 -51 155
vertex 5.5 -51.5 158
vertex 6.5 -51 158
endloop
endfacet
facet normal -0.9 0.4 0
outer loop
vertex 7 -50 155
vertex 6.5 -51 158
vertex 7 -50 158
endloop
endfacet
facet normal 1 0 0
outer loop
vertex 4 50 158
vertex 4 -50 158
vertex 4 -50 155
endloop
endfacet
facet normal -1 0 0
outer loop
vertex 7 50 155
vertex 7 -50 155
vertex 7 -50 158
endloop
endfacet
facet normal 1 0 0
outer loop
vertex 4 -50 155
vertex 4 50 155
vertex 4 50 158
endloop
endfacet
facet normal -1 0 0
outer loop
vertex 7 -50 158
vertex 7 50 158
vertex 7 50 155
endloop
endfacet
facet normal 0.9 -0.4 0
outer loop
vertex 4 50 155
vertex 4.5 51 155
vertex 4.5 51 158
endloop
endfacet
facet normal 0.4 -0.9 0
outer loop
vertex 4.5 51 155
vertex 5.5 51.5 155
vertex 5.5 51.5 158
endloop
endfacet
facet normal 0.9 -0.4 0
outer loop
vertex 4 50 155
vertex 4.5 51 158
vertex 4 50 158
endloop
endfacet
facet normal 0.4 -0.9 0
outer loop
vertex 4.5 51 155
vertex 5.5 51.5 158
vertex 4.5 51 158
endloop
endfacet
facet normal -0.4 -0.9 0
outer loop
vertex 5.5 51.5 155
vertex 6.5 51 155
vertex 6.5 51 158
endloop
endfacet
facet normal -0.9 -0.4 0
outer loop
vertex 6.5 51 155
vertex 7 50 155
vertex 7 50 158
endloop
endfacet
facet normal -0.4 -0.9 0
outer loop
vertex 5.5 51.5 155
vertex 6.5 51 158
vertex 5.5 51.5 158
endloop
endfacet
facet normal -0.9 -0.4 0
outer loop
vertex 6.5 51 155
vertex 7 50 158
vertex 6.5 51 158
endloop
endfacet
facet normal 0.9 0.4 -0
outer loop
vertex 10 -51 155
vertex 9.5 -50 155
vertex 9.5 -50 158
endloop
endfacet
facet normal 0.4 0.9 -0
outer loop
vertex 11 -51.5 155
vertex 10 -51 155
vertex 10 -51 158
endloop
endfacet
facet normal 0.9 0.4 0
outer loop
vertex 10 -51 155
vertex 9.5 -50 158
vertex 10 -51 158
endloop
endfacet
facet normal 0.4 0.9 0
outer loop
vertex 11 -51.5 155
vertex 10 -51 158
vertex 11 -51.5 158
endloop
endfacet
facet normal -0.4 0.9 0
outer loop
vertex 12 -51 155
vertex 11 -51.5 155
vertex 11 -51.5 158
endloop
endfacet
facet normal -0.9 0.4 0
outer loop
vertex 12.5 -50 155
vertex 12 -51 155
vertex 12 -51 158
endloop
endfacet
facet normal -0.4 0.9 0
outer loop
vertex 12 -51 155
vertex 11 -51.5 158
vertex 12 -51 158
endloop
endfacet
facet normal -0.9 0.4 0
outer loop
vertex 12.5 -50 155
vertex 12 -51 158
vertex 12.5 -50 158
endloop
endfacet
facet normal 1 0 0
outer loop
vertex 9.5 50 158
vertex 9.5 -50 158
vertex 9.5 -50 155
endloop
endfacet
facet normal -1 0 0
outer loop
vertex 12.5 50 155
vertex 12.5 -50 155
vertex 12.5 -50 158
endloop
endfacet
facet normal 1 0 0
outer loop
vertex 9.5 -50 155
vertex 9.5 50 155
vertex 9.5 50 158
endloop
endfacet
facet normal -1 0 0
outer loop
vertex 12.5 -50 158
vertex 12.5 50 158
vertex 12.5 50 155
endloop
endfacet
facet normal 0.9 -0.4 0
outer loop
vertex 9.5 50 155
vertex 10 51 155
vertex 10 51 158
endloop
endfacet
facet normal 0.4 -0.9 0
outer loop
vertex 10 51 155
vertex 11 51.5 155
vertex 11 51.5 158
endloop
endfacet
facet normal 0.9 -0.4 0
outer loop
vertex 9.5 50 155
vertex 10 51 158
vertex 9.5 50 158
endloop
endfacet
facet normal 0.4 -0.9 0
outer loop
vertex 10 51 155
vertex 11 51.5 158
vertex 10 51 158
endloop
endfacet
facet normal -0.4 -0.9 0
outer loop
vertex 11 51.5 155
vertex 12 51 155
vertex 12 51 158
endloop
endfacet
facet normal -0.9 -0.4 0
outer loop
vertex 12 51 155
vertex 12.5 50 155
vertex 12.5 50 158
endloop
endfacet
facet normal -0.4 -0.9 0
outer loop
vertex 11 51.5 155
vertex 12 51 158
vertex 11 51.5 158
endloop
endfacet
facet normal -0.9 -0.4 0
outer loop
vertex 12 51 155
vertex 12.5 50 158
vertex 12 51 158
endloop
endfacet
facet normal 0.9 0.4 -0
outer loop
vertex 15.5 -51 155
vertex 15 -50 155
vertex 15 -50 158
endloop
endfacet
facet normal 0.4 0.9 -0
outer loop
vertex 16.5 -51.5 155
vertex 15.5 -51 155
vertex 15.5 -51 158
endloop
endfacet
facet normal 0.9 0.4 0
outer loop
vertex 15.5 -51 155
vertex 15 -50 158
vertex 15.5 -51 158
endloop
endfacet
facet normal -0.4 0.9 0
outer loop
vertex 17.5 -51 155
vertex 16.5 -51.5 155
vertex 16.5 -51.5 158
endloop
endfacet
facet normal -0.9 0.4 0
outer loop
vertex 18 -50 155
vertex 17.5 -51 155
vertex 18 -51 158
endloop
endfacet
facet normal 0.4 0.9 0
outer loop
vertex 16.5 -51.5 155
vertex 15.5 -51 158
vertex 16.5 -51.5 158
endloop
endfacet
facet normal -0.5 0.9 -0
outer loop
vertex 17.5 -51 155
vertex 16.5 -51.5 158
vertex 18 -51 158
endloop
endfacet
facet normal -1 0 -0.1
outer loop
vertex 18 -50 155
vertex 18 -51 158
vertex 18 -30 158
endloop
endfacet
facet normal 1 0 0
outer loop
vertex 15 50 158
vertex 15 -50 158
vertex 15 -50 155
endloop
endfacet
facet normal -1 0 0
outer loop
vertex 18 -50 155
vertex 18 -30 158
vertex 18 32 155
endloop
endfacet
facet normal 1 0 0
outer loop
vertex 15 -50 155
vertex 15 50 155
vertex 15 50 158
endloop
endfacet
facet normal -1 -0 -0
outer loop
vertex 18 -30 158
vertex 18 50 155
vertex 18 32 155
endloop
endfacet
facet normal -1 0 0
outer loop
vertex 18 -30 158
vertex 18 50 158
vertex 18 50 155
endloop
endfacet
facet normal 0.9 -0.4 0
outer loop
vertex 15 50 155
vertex 15.5 51 155
vertex 15.5 51 158
endloop
endfacet
facet normal 0.9 -0.4 0
outer loop
vertex 15 50 155
vertex 15.5 51 158
vertex 15 50 158
endloop
endfacet
facet normal 0.4 -0.9 0
outer loop
vertex 15.5 51 155
vertex 16.5 51.5 158
vertex 15.5 51 158
endloop
endfacet
facet normal 0.4 -0.9 0
outer loop
vertex 15.5 51 155
vertex 16.5 51.5 155
vertex 16.5 51.5 158
endloop
endfacet
facet normal -0.4 -0.9 0
outer loop
vertex 16.5 51.5 155
vertex 17.5 51 155
vertex 17.5 51 158
endloop
endfacet
facet normal -0.9 -0.4 0
outer loop
vertex 17.5 51 155
vertex 18 50 155
vertex 18 50 158
endloop
endfacet
facet normal -0.4 -0.9 0
outer loop
vertex 16.5 51.5 155
vertex 17.5 51 158
vertex 16.5 51.5 158
endloop
endfacet
facet normal -0.9 -0.4 0
outer loop
vertex 17.5 51 155
vertex 18 50 158
vertex 17.5 51 158
endloop
endfacet
facet normal 0 0 1
outer loop
vertex -42 -68.5 13
vertex -42 -65.5 13
vertex -43 -65.5 13
endloop
endfacet
facet normal -0 -0 1
outer loop
vertex -42 -68.5 13
vertex -39 -69.5 13
vertex -42 -65.5 13
endloop
endfacet
facet normal -0.9 -0.4 0
outer loop
vertex -42 -68.5 13
vertex -43 -65.5 13
vertex -42 -68.5 11
endloop
endfacet
facet normal -0.4 -0.9 -0
outer loop
vertex -42 -68.5 13
vertex -42 -68.5 11
vertex -39 -69.5 13
endloop
endfacet
facet normal -0.9 -0.4 -0
outer loop
vertex -43 -65.5 13
vertex -43 -65.5 11
vertex -42 -68.5 11
endloop
endfacet
facet normal -0.4 -0.9 0
outer loop
vertex -39 -69.5 13
vertex -42 -68.5 11
vertex -39 -69.5 11
endloop
endfacet
facet normal 0 -0 1
outer loop
vertex -39 -69.5 13
vertex -38 -48.5 13
vertex -38.5 -47 13
endloop
endfacet
facet normal 0 -0 1
outer loop
vertex -39 -69.5 13
vertex -25 -48.5 13
vertex -38 -48.5 13
endloop
endfacet
facet normal -0.7 -0.3 -0.7
outer loop
vertex -42 -68.5 11
vertex -43 -65.5 11
vertex -41 -67.5 10
endloop
endfacet
facet normal -0.3 -0.7 -0.7
outer loop
vertex -42 -68.5 11
vertex -41 -67.5 10
vertex -39 -69.5 11
endloop
endfacet
facet normal -0.7 -0.3 -0.7
outer loop
vertex -43 -65.5 11
vertex -42 -65.5 10
vertex -41 -67.5 10
endloop
endfacet
facet normal 0 0 -1
outer loop
vertex -41 -67.5 10
vertex -42 -65.5 10
vertex -39 -68.5 10
endloop
endfacet
facet normal -0.3 -0.7 -0.7
outer loop
vertex -39 -69.5 11
vertex -41 -67.5 10
vertex -39 -68.5 10
endloop
endfacet
facet normal 0 -0 -1
outer loop
vertex -42 -65.5 10
vertex -38 -65 10
vertex -39 -68.5 10
endloop
endfacet
facet normal 0 0 -1
outer loop
vertex -42 -65.5 10
vertex -39 -62 10
vertex -38 -65 10
endloop
endfacet
facet normal 0 -0 -1
outer loop
vertex -42 -65.5 10
vertex -38 -59 10
vertex -39 -62 10
endloop
endfacet
facet normal 0 -0 -1
outer loop
vertex -42 -65.5 10
vertex -37 -48.5 10
vertex -38 -59 10
endloop
endfacet
facet normal 0 0 -1
outer loop
vertex -42 -65.5 10
vertex -38.5 -47 10
vertex -38 -48 10
endloop
endfacet
facet normal 0 0 -1
outer loop
vertex -42 -65.5 10
vertex -38 -48 10
vertex -37 -48.5 10
endloop
endfacet
facet normal 0 0 -1
outer loop
vertex -39 -68.5 10
vertex -38 -65 10
vertex -35 -66 10
endloop
endfacet
facet normal 0 0 -1
outer loop
vertex -38 -59 10
vertex -37 -48.5 10
vertex -35 -58 10
endloop
endfacet
facet normal 0 0 -1
outer loop
vertex -35 -58 10
vertex -37 -48.5 10
vertex -32 -59 10
endloop
endfacet
facet normal 0 -0 1
outer loop
vertex -39 -69.5 13
vertex -17.5 -51 13
vertex -25 -48.5 13
endloop
endfacet
facet normal 0 -0 1
outer loop
vertex -39 -69.5 13
vertex -16.5 -51.5 13
vertex -17.5 -51 13
endloop
endfacet
facet normal 0 -0 -1
outer loop
vertex -32 -59 10
vertex -24 -48.5 10
vertex -17.5 -51 10
endloop
endfacet
facet normal 0 0 -1
outer loop
vertex -32 -59 10
vertex -17.5 -51 10
vertex -16.5 -51.5 10
endloop
endfacet
facet normal 0 0 1
outer loop
vertex -23.5 -48 13
vertex -25 -48.5 13
vertex -17.5 -51 13
endloop
endfacet
facet normal 0 0 1
outer loop
vertex -23 -47 13
vertex -23.5 -48 13
vertex -18 -50 13
endloop
endfacet
facet normal -0 -0 1
outer loop
vertex -24 -45.5 13
vertex -23 -47 13
vertex -18 -50 13
endloop
endfacet
facet normal -0 -0 -1
outer loop
vertex -32 -59 10
vertex -37 -48.5 10
vertex -24 -48.5 10
endloop
endfacet
facet normal 0 0 -1
outer loop
vertex -24 -48.5 10
vertex -23 -47 10
vertex -18 -50 10
endloop
endfacet
facet normal 0 0 -1
outer loop
vertex -23 -47 10
vertex -23.5 -46 10
vertex -18 -50 10
endloop
endfacet
facet normal -0 -0 1
outer loop
vertex -42 -65.5 13
vertex -39 -69.5 13
vertex -42 68.5 13
endloop
endfacet
facet normal 0 -0 1
outer loop
vertex -43 -65.5 13
vertex -42 -65.5 13
vertex -43 65.5 13
endloop
endfacet
facet normal 0 0 1
outer loop
vertex -39 -69.5 13
vertex -38.5 -47 13
vertex -37 45.5 13
endloop
endfacet
facet normal -1 -0 -0
outer loop
vertex -43 -65.5 13
vertex -43 65.5 11
vertex -43 -65.5 11
endloop
endfacet
facet normal -0.7 0 -0.7
outer loop
vertex -43 -65.5 11
vertex -43 65.5 11
vertex -42 -65.5 10
endloop
endfacet
facet normal 0 -0 -1
outer loop
vertex -42 -65.5 10
vertex -37 45.5 10
vertex -38.5 -47 10
endloop
endfacet
facet normal 0 0 1
outer loop
vertex -38.5 -47 13
vertex -38 -46 13
vertex -37 45.5 13
endloop
endfacet
facet normal 0 0 -1
outer loop
vertex -37 45.5 10
vertex -38 -45.5 10
vertex -38.5 -47 10
endloop
endfacet
facet normal -0 0 -1
outer loop
vertex -25 -45.5 10
vertex -38 -45.5 10
vertex -18 30 10
endloop
endfacet
facet normal 0 0 -1
outer loop
vertex -23.5 -46 10
vertex -25 -45.5 10
vertex -18 30 10
endloop
endfacet
facet normal 0 0 1
outer loop
vertex -38 -46 13
vertex -37 -45.5 13
vertex -18 50 13
endloop
endfacet
facet normal -0 0 1
outer loop
vertex -37 -45.5 13
vertex -24 -45.5 13
vertex -18 50 13
endloop
endfacet
facet normal 0 -1 0
outer loop
vertex -39 -69.5 13
vertex -39 -69.5 11
vertex 39 -69.5 11
endloop
endfacet
facet normal 0 0 -1
outer loop
vertex -32 -59 10
vertex -16.5 -51.5 10
vertex -11 -51.5 10
endloop
endfacet
facet normal 0 0 -1
outer loop
vertex -32 -59 10
vertex -11 -51.5 10
vertex -5.5 -51.5 10
endloop
endfacet
facet normal 0 -0.7 -0.7
outer loop
vertex -39 -69.5 11
vertex -39 -68.5 10
vertex 39 -69.5 11
endloop
endfacet
facet normal 0 0 -1
outer loop
vertex -39 -68.5 10
vertex -35 -66 10
vertex 41 -67.5 10
endloop
endfacet
facet normal 0 0 -1
outer loop
vertex -35 -66 10
vertex -32 -65 10
vertex 32 -65 10
endloop
endfacet
facet normal 0 0 1
outer loop
vertex -17.5 -51 13
vertex -18 -50 13
vertex -23.5 -48 13
endloop
endfacet
facet normal -0 -0 1
outer loop
vertex -15.5 -51 13
vertex -12 -51 13
vertex -12.5 -50 13
endloop
endfacet
facet normal -0 -0 1
outer loop
vertex -11 -51.5 13
vertex -12 -51 13
vertex -15.5 -51 13
endloop
endfacet
facet normal 0 0 -1
outer loop
vertex -18 -50 10
vertex -17.5 -51 10
vertex -24 -48.5 10
endloop
endfacet
facet normal 0 -0 -1
outer loop
vertex -16.5 -51.5 10
vertex -15.5 -51 10
vertex -12 -51 10
endloop
endfacet
facet normal 0 -0 -1
outer loop
vertex -15.5 -51 10
vertex -15 -50 10
vertex -12 -51 10
endloop
endfacet
facet normal 0 0 -1
outer loop
vertex -16.5 -51.5 10
vertex -12 -51 10
vertex -11 -51.5 10
endloop
endfacet
facet normal 0 -0 1
outer loop
vertex -39 -69.5 13
vertex 42 -68.5 13
vertex -16.5 -51.5 13
endloop
endfacet
facet normal 0 0 -1
outer loop
vertex -32 -65 10
vertex -31 -62 10
vertex 31 -62 10
endloop
endfacet
facet normal 0 0 -1
outer loop
vertex -31 -62 10
vertex -32 -59 10
vertex 32 -59 10
endloop
endfacet
facet normal 0 0 -1
outer loop
vertex -32 -59 10
vertex -5.5 -51.5 10
vertex 32 -59 10
endloop
endfacet
facet normal -0 0 1
outer loop
vertex -10 -51 13
vertex -11 -51.5 13
vertex -5.5 -51.5 13
endloop
endfacet
facet normal -0 -0 1
outer loop
vertex -10 -51 13
vertex -6.5 -51 13
vertex -7 -50 13
endloop
endfacet
facet normal -0 -0 1
outer loop
vertex -10 -51 13
vertex -5.5 -51.5 13
vertex -6.5 -51 13
endloop
endfacet
facet normal -0 0 1
outer loop
vertex -4.5 -51 13
vertex -5.5 -51.5 13
vertex 0 -51.5 13
endloop
endfacet
facet normal -0 -0 1
outer loop
vertex -4.5 -51 13
vertex -1 -51 13
vertex -1.5 -50 13
endloop
endfacet
facet normal -0 -0 1
outer loop
vertex -4.5 -51 13
vertex 0 -51.5 13
vertex -1 -51 13
endloop
endfacet
facet normal 0 -0 -1
outer loop
vertex -11 -51.5 10
vertex -10 -51 10
vertex -6.5 -51 10
endloop
endfacet
facet normal 0 -0 -1
outer loop
vertex -10 -51 10
vertex -9.5 -50 10
vertex -6.5 -51 10
endloop
endfacet
facet normal 0 0 -1
outer loop
vertex -11 -51.5 10
vertex -6.5 -51 10
vertex -5.5 -51.5 10
endloop
endfacet
facet normal 0 0 -1
outer loop
vertex -5.5 -51.5 10
vertex -4.5 -51 10
vertex -1 -51 10
endloop
endfacet
facet normal 0 0 -1
outer loop
vertex -4.5 -51 10
vertex -4 -50 10
vertex -1 -51 10
endloop
endfacet
facet normal 0 0 -1
outer loop
vertex -5.5 -51.5 10
vertex -1 -51 10
vertex 0 -51.5 10
endloop
endfacet
facet normal -0 -0 -1
outer loop
vertex -18 30 10
vertex -18 -50 10
vertex -23.5 -46 10
endloop
endfacet
facet normal 0 0 1
outer loop
vertex -18 50 13
vertex -24 -45.5 13
vertex -18 -50 13
endloop
endfacet
facet normal -0 -0 1
outer loop
vertex -15 50 13
vertex -15.5 -51 13
vertex -12.5 -50 13
endloop
endfacet
facet normal 0 -0 -1
outer loop
vertex -12.5 50 10
vertex -12 -51 10
vertex -15 -50 10
endloop
endfacet
facet normal -0 0 1
outer loop
vertex -9.5 50 13
vertex -10 -51 13
vertex -7 -50 13
endloop
endfacet
facet normal -0 0 1
outer loop
vertex -4 50 13
vertex -4.5 -51 13
vertex -1.5 -50 13
endloop
endfacet
facet normal 0 -0 -1
outer loop
vertex -7 50 10
vertex -6.5 -51 10
vertex -9.5 -50 10
endloop
endfacet
facet normal -0 -0 -1
outer loop
vertex -1.5 50 10
vertex -1 -51 10
vertex -4 -50 10
endloop
endfacet
facet normal 0 -0 1
outer loop
vertex -39 -69.5 13
vertex -38 46 13
vertex -38.5 47 13
endloop
endfacet
facet normal 0 -0 1
outer loop
vertex -39 -69.5 13
vertex -37 45.5 13
vertex -38 46 13
endloop
endfacet
facet normal 0 -0 1
outer loop
vertex -39 -69.5 13
vertex -38.5 47 13
vertex -42 68.5 13
endloop
endfacet
facet normal 0 -0 1
outer loop
vertex -38 -46 13
vertex -25 45.5 13
vertex -37 45.5 13
endloop
endfacet
facet normal 0 0 -1
outer loop
vertex -42 -65.5 10
vertex -38 46 10
vertex -37 45.5 10
endloop
endfacet
facet normal 0 0 -1
outer loop
vertex -42 -65.5 10
vertex -38.5 47 10
vertex -38 46 10
endloop
endfacet
facet normal 0 0 -1
outer loop
vertex -42 -65.5 10
vertex -39 62 10
vertex -38.5 47 10
endloop
endfacet
facet normal -1 0 0
outer loop
vertex -43 -65.5 13
vertex -43 65.5 13
vertex -43 65.5 11
endloop
endfacet
facet normal 0 -0 1
outer loop
vertex -42 -65.5 13
vertex -42 68.5 13
vertex -43 65.5 13
endloop
endfacet
facet normal -0.7 0 -0.7
outer loop
vertex -42 -65.5 10
vertex -43 65.5 11
vertex -42 65.5 10
endloop
endfacet
facet normal 0 0 -1
outer loop
vertex -42 -65.5 10
vertex -41 67.5 10
vertex -39 62 10
endloop
endfacet
facet normal 0 0 -1
outer loop
vertex -42 -65.5 10
vertex -42 65.5 10
vertex -41 67.5 10
endloop
endfacet
facet normal 0 -0 1
outer loop
vertex -38 -46 13
vertex -23.5 46 13
vertex -25 45.5 13
endloop
endfacet
facet normal 0 -0 1
outer loop
vertex -38 -46 13
vertex -18 50 13
vertex -23.5 46 13
endloop
endfacet
facet normal 0 -0 -1
outer loop
vertex -37 45.5 10
vertex -18 30 10
vertex -38 -45.5 10
endloop
endfacet
facet normal 0 -0 -1
outer loop
vertex -39 62 10
vertex -38 48.5 10
vertex -38.5 47 10
endloop
endfacet
facet normal -0 0 1
outer loop
vertex -42 68.5 13
vertex -38.5 47 13
vertex -38 48 13
endloop
endfacet
facet normal -0 0 1
outer loop
vertex -42 68.5 13
vertex -38 48 13
vertex -37 48.5 13
endloop
endfacet
facet normal -0.9 0.4 0
outer loop
vertex -43 65.5 13
vertex -42 68.5 13
vertex -43 65.5 11
endloop
endfacet
facet normal -0.4 0.9 0
outer loop
vertex -42 68.5 13
vertex -39 69.5 13
vertex -42 68.5 11
endloop
endfacet
facet normal -0.9 0.4 0
outer loop
vertex -42 68.5 13
vertex -42 68.5 11
vertex -43 65.5 11
endloop
endfacet
facet normal -0.4 0.9 0
outer loop
vertex -39 69.5 13
vertex -39 69.5 11
vertex -42 68.5 11
endloop
endfacet
facet normal -0 -0 1
outer loop
vertex -42 68.5 13
vertex -37 48.5 13
vertex -24 48.5 13
endloop
endfacet
facet normal -0 0 -1
outer loop
vertex -38 59 10
vertex -38 48.5 10
vertex -39 62 10
endloop
endfacet
facet normal -0.7 0.3 -0.7
outer loop
vertex -43 65.5 11
vertex -42 68.5 11
vertex -41 67.5 10
endloop
endfacet
facet normal -0.3 0.7 -0.7
outer loop
vertex -42 68.5 11
vertex -39 69.5 11
vertex -41 67.5 10
endloop
endfacet
facet normal -0.7 0.3 -0.7
outer loop
vertex -43 65.5 11
vertex -41 67.5 10
vertex -42 65.5 10
endloop
endfacet
facet normal 0 -0 -1
outer loop
vertex -41 67.5 10
vertex -38 65 10
vertex -39 62 10
endloop
endfacet
facet normal -0.3 0.7 -0.7
outer loop
vertex -39 69.5 11
vertex -39 68.5 10
vertex -41 67.5 10
endloop
endfacet
facet normal 0 -0 -1
outer loop
vertex -41 67.5 10
vertex -35 66 10
vertex -38 65 10
endloop
endfacet
facet normal 0 -0 -1
outer loop
vertex -38 59 10
vertex -35 58 10
vertex -38 48.5 10
endloop
endfacet
facet normal -0 0 1
outer loop
vertex -23 47 13
vertex -23.5 46 13
vertex -18 50 13
endloop
endfacet
facet normal 0 -0 1
outer loop
vertex -24 48.5 13
vertex -23 47 13
vertex -18 50 13
endloop
endfacet
facet normal 0 -0 -1
outer loop
vertex -35 58 10
vertex -25 48.5 10
vertex -38 48.5 10
endloop
endfacet
facet normal 0 0 -1
outer loop
vertex -37 45.5 10
vertex -24 45.5 10
vertex -18 30 10
endloop
endfacet
facet normal 0 -0 -1
outer loop
vertex -24 45.5 10
vertex -23 47 10
vertex -18 51 10
endloop
endfacet
facet normal 0 0 -1
outer loop
vertex -23 47 10
vertex -23.5 48 10
vertex -18 51 10
endloop
endfacet
facet normal 0 0 -1
outer loop
vertex -23.5 48 10
vertex -25 48.5 10
vertex -18 51 10
endloop
endfacet
facet normal 0 0 1
outer loop
vertex -42 68.5 13
vertex -24 48.5 13
vertex -18 50 13
endloop
endfacet
facet normal -0 0 1
outer loop
vertex -42 68.5 13
vertex -18 50 13
vertex -17.5 51 13
endloop
endfacet
facet normal -0 0 1
outer loop
vertex -42 68.5 13
vertex -17.5 51 13
vertex -16.5 51.5 13
endloop
endfacet
facet normal 0 0 -1
outer loop
vertex -35 58 10
vertex -32 59 10
vertex -25 48.5 10
endloop
endfacet
facet normal 0 -0 -1
outer loop
vertex -32 59 10
vertex -18 51 10
vertex -25 48.5 10
endloop
endfacet
facet normal 0 -0 -1
outer loop
vertex -32 59 10
vertex -16.5 51.5 10
vertex -18 51 10
endloop
endfacet
facet normal 0 -0 1
outer loop
vertex -12.5 -50 13
vertex -12 51 13
vertex -15 50 13
endloop
endfacet
facet normal -0 0 -1
outer loop
vertex -12.5 50 10
vertex -15 -50 10
vertex -15.5 51 10
endloop
endfacet
facet normal 0 -0 1
outer loop
vertex -7 -50 13
vertex -6.5 51 13
vertex -9.5 50 13
endloop
endfacet
facet normal 0 -0 1
outer loop
vertex -1.5 -50 13
vertex -1 51 13
vertex -4 50 13
endloop
endfacet
facet normal -0 0 -1
outer loop
vertex -9.5 -50 10
vertex -10 51 10
vertex -7 50 10
endloop
endfacet
facet normal -0 0 -1
outer loop
vertex -4 -50 10
vertex -4.5 51 10
vertex -1.5 50 10
endloop
endfacet
facet normal -0 0 1
outer loop
vertex -15.5 51 13
vertex -15 50 13
vertex -12 51 13
endloop
endfacet
facet normal 0 -0 1
outer loop
vertex -12 51 13
vertex -11 51.5 13
vertex -15.5 51 13
endloop
endfacet
facet normal -0 0 -1
outer loop
vertex -18 30 10
vertex -24 45.5 10
vertex -18 51 10
endloop
endfacet
facet normal 0 -0 -1
outer loop
vertex -15.5 51 10
vertex -16.5 51.5 10
vertex -11 51.5 10
endloop
endfacet
facet normal -0 0 -1
outer loop
vertex -15.5 51 10
vertex -12 51 10
vertex -12.5 50 10
endloop
endfacet
facet normal -0 0 -1
outer loop
vertex -15.5 51 10
vertex -11 51.5 10
vertex -12 51 10
endloop
endfacet
facet normal 0 -0 1
outer loop
vertex -42 68.5 13
vertex 39 69.5 13
vertex -39 69.5 13
endloop
endfacet
facet normal 0 1 0
outer loop
vertex -39 69.5 13
vertex 39 69.5 11
vertex -39 69.5 11
endloop
endfacet
facet normal -0 -0 -1
outer loop
vertex -32 59 10
vertex -11 51.5 10
vertex -16.5 51.5 10
endloop
endfacet
facet normal -0 -0 -1
outer loop
vertex -32 59 10
vertex -5.5 51.5 10
vertex -11 51.5 10
endloop
endfacet
facet normal -0 -0 -1
outer loop
vertex -41 67.5 10
vertex 32 65 10
vertex -35 66 10
endloop
endfacet
facet normal 0 0 -1
outer loop
vertex -41 67.5 10
vertex -39 68.5 10
vertex 39 68.5 10
endloop
endfacet
facet normal -0 -0 -1
outer loop
vertex -35 66 10
vertex 32 65 10
vertex -32 65 10
endloop
endfacet
facet normal 0 0.7 -0.7
outer loop
vertex -39 69.5 11
vertex 39 68.5 10
vertex -39 68.5 10
endloop
endfacet
facet normal 0 0 1
outer loop
vertex -11 51.5 13
vertex -10 51 13
vertex -6.5 51 13
endloop
endfacet
facet normal -0 0 1
outer loop
vertex -10 51 13
vertex -9.5 50 13
vertex -6.5 51 13
endloop
endfacet
facet normal -0 0 1
outer loop
vertex -11 51.5 13
vertex -6.5 51 13
vertex -5.5 51.5 13
endloop
endfacet
facet normal 0 0 1
outer loop
vertex -5.5 51.5 13
vertex -4.5 51 13
vertex -1 51 13
endloop
endfacet
facet normal -0 0 1
outer loop
vertex -4.5 51 13
vertex -4 50 13
vertex -1 51 13
endloop
endfacet
facet normal -0 0 1
outer loop
vertex -5.5 51.5 13
vertex -1 51 13
vertex 0 51.5 13
endloop
endfacet
facet normal 0 -0 -1
outer loop
vertex -10 51 10
vertex -11 51.5 10
vertex -5.5 51.5 10
endloop
endfacet
facet normal -0 0 -1
outer loop
vertex -10 51 10
vertex -6.5 51 10
vertex -7 50 10
endloop
endfacet
facet normal -0 0 -1
outer loop
vertex -10 51 10
vertex -5.5 51.5 10
vertex -6.5 51 10
endloop
endfacet
facet normal 0 -0 -1
outer loop
vertex -4.5 51 10
vertex -5.5 51.5 10
vertex 0 51.5 10
endloop
endfacet
facet normal -0 0 -1
outer loop
vertex -4.5 51 10
vertex -1 51 10
vertex -1.5 50 10
endloop
endfacet
facet normal -0 0 -1
outer loop
vertex -4.5 51 10
vertex 0 51.5 10
vertex -1 51 10
endloop
endfacet
facet normal -0 0 1
outer loop
vertex -42 68.5 13
vertex -16.5 51.5 13
vertex 39 69.5 13
endloop
endfacet
facet normal 0 0 -1
outer loop
vertex -32 59 10
vertex -31 62 10
vertex 31 62 10
endloop
endfacet
facet normal 0 0 -1
outer loop
vertex -31 62 10
vertex -32 65 10
vertex 32 65 10
endloop
endfacet
facet normal 0 -0 -1
outer loop
vertex -32 59 10
vertex 32 59 10
vertex -5.5 51.5 10
endloop
endfacet
facet normal 0 0 1
outer loop
vertex 42 -68.5 13
vertex -15.5 -51 13
vertex -16.5 -51.5 13
endloop
endfacet
facet normal -0 -0 1
outer loop
vertex 42 -68.5 13
vertex -11 -51.5 13
vertex -15.5 -51 13
endloop
endfacet
facet normal 0 0 1
outer loop
vertex 42 -68.5 13
vertex -5.5 -51.5 13
vertex -11 -51.5 13
endloop
endfacet
facet normal 0 0 -1
outer loop
vertex -35 -66 10
vertex 32 -65 10
vertex 35 -66 10
endloop
endfacet
facet normal 0 0 -1
outer loop
vertex -32 -65 10
vertex 31 -62 10
vertex 32 -65 10
endloop
endfacet
facet normal 0 -0 -1
outer loop
vertex -31 -62 10
vertex 32 -59 10
vertex 31 -62 10
endloop
endfacet
facet normal 0 0 -1
outer loop
vertex 32 -59 10
vertex -5.5 -51.5 10
vertex 0 -51.5 10
endloop
endfacet
facet normal 0 -0 1
outer loop
vertex 0 -51.5 13
vertex 5.5 -51.5 13
vertex 1 -51 13
endloop
endfacet
facet normal -0 -0 1
outer loop
vertex 1 -51 13
vertex 4.5 -51 13
vertex 4 -50 13
endloop
endfacet
facet normal -0 -0 1
outer loop
vertex 1 -51 13
vertex 5.5 -51.5 13
vertex 4.5 -51 13
endloop
endfacet
facet normal -0 0 1
outer loop
vertex 6.5 -51 13
vertex 5.5 -51.5 13
vertex 11 -51.5 13
endloop
endfacet
facet normal -0 -0 1
outer loop
vertex 6.5 -51 13
vertex 10 -51 13
vertex 9.5 -50 13
endloop
endfacet
facet normal -0 -0 1
outer loop
vertex 6.5 -51 13
vertex 11 -51.5 13
vertex 10 -51 13
endloop
endfacet
facet normal 0 -0 -1
outer loop
vertex 0 -51.5 10
vertex 1 -51 10
vertex 4.5 -51 10
endloop
endfacet
facet normal 0 -0 -1
outer loop
vertex 1 -51 10
vertex 1.5 -50 10
vertex 4.5 -51 10
endloop
endfacet
facet normal 0 0 -1
outer loop
vertex 0 -51.5 10
vertex 4.5 -51 10
vertex 5.5 -51.5 10
endloop
endfacet
facet normal 0 -0 -1
outer loop
vertex 5.5 -51.5 10
vertex 6.5 -51 10
vertex 10 -51 10
endloop
endfacet
facet normal 0 -0 -1
outer loop
vertex 6.5 -51 10
vertex 7 -50 10
vertex 10 -51 10
endloop
endfacet
facet normal 0 0 -1
outer loop
vertex 5.5 -51.5 10
vertex 10 -51 10
vertex 11 -51.5 10
endloop
endfacet
facet normal 0 -1 0
outer loop
vertex -39 -69.5 13
vertex 39 -69.5 11
vertex 39 -69.5 13
endloop
endfacet
facet normal 0 0 1
outer loop
vertex -39 -69.5 13
vertex 39 -69.5 13
vertex 42 -68.5 13
endloop
endfacet
facet normal 0 0 1
outer loop
vertex 42 -68.5 13
vertex 0 -51.5 13
vertex -5.5 -51.5 13
endloop
endfacet
facet normal 0 0 1
outer loop
vertex 42 -68.5 13
vertex 5.5 -51.5 13
vertex 0 -51.5 13
endloop
endfacet
facet normal 0 0 1
outer loop
vertex 42 -68.5 13
vertex 11 -51.5 13
vertex 5.5 -51.5 13
endloop
endfacet
facet normal 0 -0.7 -0.7
outer loop
vertex -39 -68.5 10
vertex 39 -68.5 10
vertex 39 -69.5 11
endloop
endfacet
facet normal 0 -0 -1
outer loop
vertex -39 -68.5 10
vertex 41 -67.5 10
vertex 39 -68.5 10
endloop
endfacet
facet normal 0 0 -1
outer loop
vertex -35 -66 10
vertex 35 -66 10
vertex 41 -67.5 10
endloop
endfacet
facet normal 0 0 -1
outer loop
vertex 32 -59 10
vertex 0 -51.5 10
vertex 5.5 -51.5 10
endloop
endfacet
facet normal 0 0 -1
outer loop
vertex 32 -59 10
vertex 5.5 -51.5 10
vertex 11 -51.5 10
endloop
endfacet
facet normal 0 0 -1
outer loop
vertex 32 -59 10
vertex 11 -51.5 10
vertex 16.5 -51.5 10
endloop
endfacet
facet normal -0 0 1
outer loop
vertex 12 -51 13
vertex 11 -51.5 13
vertex 16.5 -51.5 13
endloop
endfacet
facet normal -0 -0 1
outer loop
vertex 12 -51 13
vertex 15.5 -51 13
vertex 15 -50 13
endloop
endfacet
facet normal -0 -0 1
outer loop
vertex 12 -51 13
vertex 16.5 -51.5 13
vertex 15.5 -51 13
endloop
endfacet
facet normal 0 -0 -1
outer loop
vertex 11 -51.5 10
vertex 12 -51 10
vertex 15.5 -51 10
endloop
endfacet
facet normal 0 -0 -1
outer loop
vertex 12 -51 10
vertex 12.5 -50 10
vertex 15.5 -51 10
endloop
endfacet
facet normal 0 0 -1
outer loop
vertex 11 -51.5 10
vertex 15.5 -51 10
vertex 16.5 -51.5 10
endloop
endfacet
facet normal 0 -0 -1
outer loop
vertex 18 -51 10
vertex 18 -30 10
vertex 24 -45.5 10
endloop
endfacet
facet normal -0 0 1
outer loop
vertex 1.5 50 13
vertex 1 -51 13
vertex 4 -50 13
endloop
endfacet
facet normal -0 0 1
outer loop
vertex 7 50 13
vertex 6.5 -51 13
vertex 9.5 -50 13
endloop
endfacet
facet normal 0 -0 -1
outer loop
vertex 4 50 10
vertex 4.5 -51 10
vertex 1.5 -50 10
endloop
endfacet
facet normal 0 -0 -1
outer loop
vertex 9.5 50 10
vertex 10 -51 10
vertex 7 -50 10
endloop
endfacet
facet normal 0 -0 1
outer loop
vertex 18 -51 13
vertex 23 -47 13
vertex 18 32 13
endloop
endfacet
facet normal -0 0 1
outer loop
vertex 12.5 50 13
vertex 12 -51 13
vertex 15 -50 13
endloop
endfacet
facet normal 0 -0 -1
outer loop
vertex 15 50 10
vertex 15.5 -51 10
vertex 12.5 -50 10
endloop
endfacet
facet normal 0 0 1
outer loop
vertex 42 -68.5 13
vertex 16.5 -51.5 13
vertex 11 -51.5 13
endloop
endfacet
facet normal 0 0 1
outer loop
vertex 42 -68.5 13
vertex 18 -51 13
vertex 16.5 -51.5 13
endloop
endfacet
facet normal 0 0 1
outer loop
vertex 42 -68.5 13
vertex 24 -48.5 13
vertex 18 -51 13
endloop
endfacet
facet normal 0 0 -1
outer loop
vertex 32 -59 10
vertex 16.5 -51.5 10
vertex 18 -51 10
endloop
endfacet
facet normal 0 0 -1
outer loop
vertex 32 -59 10
vertex 18 -51 10
vertex 25 -48.5 10
endloop
endfacet
facet normal 0 0 -1
outer loop
vertex 32 -59 10
vertex 25 -48.5 10
vertex 35 -58 10
endloop
endfacet
facet normal 0 -0 1
outer loop
vertex 24 -48.5 13
vertex 23 -47 13
vertex 18 -51 13
endloop
endfacet
facet normal 0 -0 -1
outer loop
vertex 23.5 -48 10
vertex 25 -48.5 10
vertex 18 -51 10
endloop
endfacet
facet normal 0 -0 -1
outer loop
vertex 23 -47 10
vertex 23.5 -48 10
vertex 18 -51 10
endloop
endfacet
facet normal -0 0 -1
outer loop
vertex 24 -45.5 10
vertex 23 -47 10
vertex 18 -51 10
endloop
endfacet
facet normal -0 -0 -1
outer loop
vertex 37 -45.5 10
vertex 24 -45.5 10
vertex 18 -30 10
endloop
endfacet
facet normal 0 0 -1
outer loop
vertex 35 -58 10
vertex 25 -48.5 10
vertex 38 -48.5 10
endloop
endfacet
facet normal -0 -0 1
outer loop
vertex 42 -68.5 13
vertex 37 -48.5 13
vertex 24 -48.5 13
endloop
endfacet
facet normal 0.4 -0.9 0
outer loop
vertex 39 -69.5 13
vertex 39 -69.5 11
vertex 42 -68.5 13
endloop
endfacet
facet normal 0.9 -0.4 0
outer loop
vertex 42 -68.5 13
vertex 42 -68.5 11
vertex 43 -65.5 13
endloop
endfacet
facet normal 0.4 -0.9 0
outer loop
vertex 42 -68.5 13
vertex 39 -69.5 11
vertex 42 -68.5 11
endloop
endfacet
facet normal 0.9 -0.4 0
outer loop
vertex 43 -65.5 13
vertex 42 -68.5 11
vertex 43 -65.5 11
endloop
endfacet
facet normal 0 0 1
outer loop
vertex 42 -68.5 13
vertex 38 -48 13
vertex 37 -48.5 13
endloop
endfacet
facet normal 0 0 1
outer loop
vertex 42 -68.5 13
vertex 38.5 -47 13
vertex 38 -48 13
endloop
endfacet
facet normal 0 -0 -1
outer loop
vertex 35 -58 10
vertex 38 -48.5 10
vertex 38 -59 10
endloop
endfacet
facet normal 0.3 -0.7 -0.7
outer loop
vertex 39 -69.5 11
vertex 41 -67.5 10
vertex 42 -68.5 11
endloop
endfacet
facet normal 0.7 -0.3 -0.7
outer loop
vertex 42 -68.5 11
vertex 41 -67.5 10
vertex 43 -65.5 11
endloop
endfacet
facet normal 0.3 -0.7 -0.7
outer loop
vertex 39 -69.5 11
vertex 39 -68.5 10
vertex 41 -67.5 10
endloop
endfacet
facet normal 0 0 -1
outer loop
vertex 35 -66 10
vertex 38 -65 10
vertex 41 -67.5 10
endloop
endfacet
facet normal 0 0 -1
outer loop
vertex 38 -65 10
vertex 39 -62 10
vertex 41 -67.5 10
endloop
endfacet
facet normal 0.7 -0.3 -0.7
outer loop
vertex 43 -65.5 11
vertex 41 -67.5 10
vertex 42 -65.5 10
endloop
endfacet
facet normal 0 0 -1
outer loop
vertex 39 -62 10
vertex 38 -59 10
vertex 38 -48.5 10
endloop
endfacet
facet normal 0 0 -1
outer loop
vertex 39 -62 10
vertex 38 -48.5 10
vertex 38.5 -47 10
endloop
endfacet
facet normal 0 -0 1
outer loop
vertex 23 -47 13
vertex 23.5 -46 13
vertex 18 32 13
endloop
endfacet
facet normal 0 -0 1
outer loop
vertex 23.5 -46 13
vertex 25 -45.5 13
vertex 18 32 13
endloop
endfacet
facet normal 0 -0 1
outer loop
vertex 25 -45.5 13
vertex 37 -45.5 13
vertex 18 32 13
endloop
endfacet
facet normal 0 0 -1
outer loop
vertex 18 -30 10
vertex 25 45.5 10
vertex 37 -45.5 10
endloop
endfacet
facet normal 0 0 1
outer loop
vertex 42 -68.5 13
vertex 38 46 13
vertex 38.5 -47 13
endloop
endfacet
facet normal 0 0 1
outer loop
vertex 42 -68.5 13
vertex 43 -65.5 13
vertex 43 65.5 13
endloop
endfacet
facet normal 1 -0 0
outer loop
vertex 43 -65.5 13
vertex 43 -65.5 11
vertex 43 65.5 11
endloop
endfacet
facet normal 0 0 -1
outer loop
vertex 41 -67.5 10
vertex 42 65.5 10
vertex 42 -65.5 10
endloop
endfacet
facet normal 0.7 0 -0.7
outer loop
vertex 43 -65.5 11
vertex 42 -65.5 10
vertex 42 65.5 10
endloop
endfacet
facet normal 0 0 -1
outer loop
vertex 39 -62 10
vertex 41 67.5 10
vertex 41 -67.5 10
endloop
endfacet
facet normal -0 0 1
outer loop
vertex 37 -45.5 13
vertex 38 -46 13
vertex 38 46 13
endloop
endfacet
facet normal -0 -0 1
outer loop
vertex 38 -46 13
vertex 38.5 -47 13
vertex 38 46 13
endloop
endfacet
facet normal 0 0 -1
outer loop
vertex 39 -62 10
vertex 38.5 -47 10
vertex 41 67.5 10
endloop
endfacet
facet normal -0 0 -1
outer loop
vertex 41 67.5 10
vertex 38 -46 10
vertex 37 -45.5 10
endloop
endfacet
facet normal -0 0 -1
outer loop
vertex 41 67.5 10
vertex 38.5 -47 10
vertex 38 -46 10
endloop
endfacet
facet normal 0 -0 1
outer loop
vertex 4 -50 13
vertex 4.5 51 13
vertex 1.5 50 13
endloop
endfacet
facet normal 0 -0 1
outer loop
vertex 9.5 -50 13
vertex 10 51 13
vertex 7 50 13
endloop
endfacet
facet normal 0 0 -1
outer loop
vertex 1.5 -50 10
vertex 1 51 10
vertex 4 50 10
endloop
endfacet
facet normal -0 0 -1
outer loop
vertex 9.5 50 10
vertex 7 -50 10
vertex 6.5 51 10
endloop
endfacet
facet normal 0 -0 1
outer loop
vertex 15 -50 13
vertex 15.5 51 13
vertex 12.5 50 13
endloop
endfacet
facet normal -0 0 -1
outer loop
vertex 15 50 10
vertex 12.5 -50 10
vertex 12 51 10
endloop
endfacet
facet normal -0 0 -1
outer loop
vertex 18 -30 10
vertex 17.5 51 10
vertex 23.5 46 10
endloop
endfacet
facet normal 0 0 1
outer loop
vertex 0 51.5 13
vertex 1 51 13
vertex 4.5 51 13
endloop
endfacet
facet normal -0 0 1
outer loop
vertex 1 51 13
vertex 1.5 50 13
vertex 4.5 51 13
endloop
endfacet
facet normal -0 0 1
outer loop
vertex 0 51.5 13
vertex 4.5 51 13
vertex 5.5 51.5 13
endloop
endfacet
facet normal 0 0 1
outer loop
vertex 5.5 51.5 13
vertex 6.5 51 13
vertex 10 51 13
endloop
endfacet
facet normal -0 0 1
outer loop
vertex 6.5 51 13
vertex 7 50 13
vertex 10 51 13
endloop
endfacet
facet normal -0 0 1
outer loop
vertex 5.5 51.5 13
vertex 10 51 13
vertex 11 51.5 13
endloop
endfacet
facet normal 0 0 -1
outer loop
vertex 1 51 10
vertex 0 51.5 10
vertex 5.5 51.5 10
endloop
endfacet
facet normal 0 -0 -1
outer loop
vertex 1 51 10
vertex 4.5 51 10
vertex 4 50 10
endloop
endfacet
facet normal 0 -0 -1
outer loop
vertex 1 51 10
vertex 5.5 51.5 10
vertex 4.5 51 10
endloop
endfacet
facet normal 0 -0 -1
outer loop
vertex 6.5 51 10
vertex 5.5 51.5 10
vertex 11 51.5 10
endloop
endfacet
facet normal -0 0 -1
outer loop
vertex 6.5 51 10
vertex 10 51 10
vertex 9.5 50 10
endloop
endfacet
facet normal -0 0 -1
outer loop
vertex 6.5 51 10
vertex 11 51.5 10
vertex 10 51 10
endloop
endfacet
facet normal 0 0 1
outer loop
vertex 39 69.5 13
vertex -16.5 51.5 13
vertex -15.5 51 13
endloop
endfacet
facet normal -0 0 1
outer loop
vertex 39 69.5 13
vertex -15.5 51 13
vertex -11 51.5 13
endloop
endfacet
facet normal -0 0 1
outer loop
vertex 39 69.5 13
vertex -11 51.5 13
vertex -5.5 51.5 13
endloop
endfacet
facet normal -0 0 -1
outer loop
vertex 32 59 10
vertex 0 51.5 10
vertex -5.5 51.5 10
endloop
endfacet
facet normal 0 0 -1
outer loop
vertex -32 59 10
vertex 31 62 10
vertex 32 59 10
endloop
endfacet
facet normal 0 -0 -1
outer loop
vertex -31 62 10
vertex 32 65 10
vertex 31 62 10
endloop
endfacet
facet normal 0 -0 -1
outer loop
vertex -41 67.5 10
vertex 35 66 10
vertex 32 65 10
endloop
endfacet
facet normal 0 0 1
outer loop
vertex 11 51.5 13
vertex 12 51 13
vertex 15.5 51 13
endloop
endfacet
facet normal -0 0 1
outer loop
vertex 12 51 13
vertex 12.5 50 13
vertex 15.5 51 13
endloop
endfacet
facet normal -0 0 1
outer loop
vertex 11 51.5 13
vertex 15.5 51 13
vertex 16.5 51.5 13
endloop
endfacet
facet normal -0 0 1
outer loop
vertex 18 32 13
vertex 24 45.5 13
vertex 18 50 13
endloop
endfacet
facet normal 0 0 1
outer loop
vertex 17.5 51 13
vertex 18 50 13
vertex 23.5 48 13
endloop
endfacet
facet normal 0 -0 -1
outer loop
vertex 12 51 10
vertex 11 51.5 10
vertex 16.5 51.5 10
endloop
endfacet
facet normal -0 0 -1
outer loop
vertex 12 51 10
vertex 15.5 51 10
vertex 15 50 10
endloop
endfacet
facet normal -0 0 -1
outer loop
vertex 12 51 10
vertex 16.5 51.5 10
vertex 15.5 51 10
endloop
endfacet
facet normal -0 0 1
outer loop
vertex 39 69.5 13
vertex -5.5 51.5 13
vertex 0 51.5 13
endloop
endfacet
facet normal -0 0 1
outer loop
vertex 39 69.5 13
vertex 0 51.5 13
vertex 5.5 51.5 13
endloop
endfacet
facet normal -0 1 0
outer loop
vertex -39 69.5 13
vertex 39 69.5 13
vertex 39 69.5 11
endloop
endfacet
facet normal -0 0 1
outer loop
vertex 39 69.5 13
vertex 5.5 51.5 13
vertex 11 51.5 13
endloop
endfacet
facet normal -0 0 -1
outer loop
vertex 32 59 10
vertex 5.5 51.5 10
vertex 0 51.5 10
endloop
endfacet
facet normal 0 0.7 -0.7
outer loop
vertex -39 69.5 11
vertex 39 69.5 11
vertex 39 68.5 10
endloop
endfacet
facet normal 0 -0 -1
outer loop
vertex -41 67.5 10
vertex 41 67.5 10
vertex 35 66 10
endloop
endfacet
facet normal 0 0 -1
outer loop
vertex -41 67.5 10
vertex 39 68.5 10
vertex 41 67.5 10
endloop
endfacet
facet normal -0 0 -1
outer loop
vertex 32 59 10
vertex 11 51.5 10
vertex 5.5 51.5 10
endloop
endfacet
facet normal -0 0 -1
outer loop
vertex 32 59 10
vertex 16.5 51.5 10
vertex 11 51.5 10
endloop
endfacet
facet normal 0 -0 1
outer loop
vertex 37 -45.5 13
vertex 37 45.5 13
vertex 18 32 13
endloop
endfacet
facet normal 0 0 -1
outer loop
vertex 18 -30 10
vertex 23.5 46 10
vertex 25 45.5 10
endloop
endfacet
facet normal 0 -0 1
outer loop
vertex 37 -45.5 13
vertex 38 46 13
vertex 37 45.5 13
endloop
endfacet
facet normal 0 0 1
outer loop
vertex 42 -68.5 13
vertex 38.5 47 13
vertex 38 46 13
endloop
endfacet
facet normal 0 0 1
outer loop
vertex 42 -68.5 13
vertex 39 69.5 13
vertex 38.5 47 13
endloop
endfacet
facet normal -0 -0 -1
outer loop
vertex 25 45.5 10
vertex 38 45.5 10
vertex 37 -45.5 10
endloop
endfacet
facet normal 0 -0 -1
outer loop
vertex 37 -45.5 10
vertex 38 45.5 10
vertex 38.5 47 10
endloop
endfacet
facet normal 1 -0 0
outer loop
vertex 43 -65.5 13
vertex 43 65.5 11
vertex 43 65.5 13
endloop
endfacet
facet normal 0 -0 1
outer loop
vertex 42 -68.5 13
vertex 43 65.5 13
vertex 39 69.5 13
endloop
endfacet
facet normal 0.7 0 -0.7
outer loop
vertex 43 -65.5 11
vertex 42 65.5 10
vertex 43 65.5 11
endloop
endfacet
facet normal -0 0 -1
outer loop
vertex 41 67.5 10
vertex 37 -45.5 10
vertex 38.5 47 10
endloop
endfacet
facet normal 0 0 -1
outer loop
vertex 41 -67.5 10
vertex 41 67.5 10
vertex 42 65.5 10
endloop
endfacet
facet normal 0 -0 1
outer loop
vertex 37 45.5 13
vertex 24 45.5 13
vertex 18 32 13
endloop
endfacet
facet normal 0 0 1
outer loop
vertex 24 45.5 13
vertex 23 47 13
vertex 18 50 13
endloop
endfacet
facet normal 0 -0 1
outer loop
vertex 23 47 13
vertex 23.5 48 13
vertex 18 50 13
endloop
endfacet
facet normal 0 -0 1
outer loop
vertex 23.5 48 13
vertex 25 48.5 13
vertex 17.5 51 13
endloop
endfacet
facet normal -0 -0 -1
outer loop
vertex 23 47 10
vertex 23.5 46 10
vertex 17.5 51 10
endloop
endfacet
facet normal -0 0 -1
outer loop
vertex 23.5 48 10
vertex 23 47 10
vertex 17.5 51 10
endloop
endfacet
facet normal -0 0 -1
outer loop
vertex 25 48.5 10
vertex 23.5 48 10
vertex 17.5 51 10
endloop
endfacet
facet normal -0 -0 -1
outer loop
vertex 32 59 10
vertex 37 48.5 10
vertex 25 48.5 10
endloop
endfacet
facet normal -0 0 1
outer loop
vertex 39 69.5 13
vertex 11 51.5 13
vertex 16.5 51.5 13
endloop
endfacet
facet normal 0 0 1
outer loop
vertex 39 69.5 13
vertex 16.5 51.5 13
vertex 17.5 51 13
endloop
endfacet
facet normal 0 0 1
outer loop
vertex 39 69.5 13
vertex 17.5 51 13
vertex 25 48.5 13
endloop
endfacet
facet normal 0 -0 -1
outer loop
vertex 32 59 10
vertex 17.5 51 10
vertex 16.5 51.5 10
endloop
endfacet
facet normal -0 0 -1
outer loop
vertex 32 59 10
vertex 25 48.5 10
vertex 17.5 51 10
endloop
endfacet
facet normal -0 -0 -1
outer loop
vertex 35 58 10
vertex 38 48 10
vertex 37 48.5 10
endloop
endfacet
facet normal -0 -0 -1
outer loop
vertex 38 59 10
vertex 38.5 47 10
vertex 38 48 10
endloop
endfacet
facet normal 0 0 1
outer loop
vertex 39 69.5 13
vertex 25 48.5 13
vertex 38 48.5 13
endloop
endfacet
facet normal 0 0 1
outer loop
vertex 39 69.5 13
vertex 38 48.5 13
vertex 38.5 47 13
endloop
endfacet
facet normal 0.4 0.9 0
outer loop
vertex 39 69.5 13
vertex 42 68.5 13
vertex 39 69.5 11
endloop
endfacet
facet normal -0 -0 1
outer loop
vertex 39 69.5 13
vertex 43 65.5 13
vertex 42 68.5 13
endloop
endfacet
facet normal 0.9 0.4 0
outer loop
vertex 43 65.5 13
vertex 43 65.5 11
vertex 42 68.5 13
endloop
endfacet
facet normal 0.4 0.9 0
outer loop
vertex 42 68.5 13
vertex 42 68.5 11
vertex 39 69.5 11
endloop
endfacet
facet normal 0.9 0.4 0
outer loop
vertex 42 68.5 13
vertex 43 65.5 11
vertex 42 68.5 11
endloop
endfacet
facet normal 0 0 -1
outer loop
vertex 32 59 10
vertex 35 58 10
vertex 37 48.5 10
endloop
endfacet
facet normal 0 0 -1
outer loop
vertex 35 58 10
vertex 38 59 10
vertex 38 48 10
endloop
endfacet
facet normal 0 -0 -1
outer loop
vertex 38 59 10
vertex 39 62 10
vertex 38.5 47 10
endloop
endfacet
facet normal 0 -0 -1
outer loop
vertex 39 62 10
vertex 41 67.5 10
vertex 38.5 47 10
endloop
endfacet
facet normal 0.3 0.7 -0.7
outer loop
vertex 39 69.5 11
vertex 42 68.5 11
vertex 41 67.5 10
endloop
endfacet
facet normal 0.7 0.3 -0.7
outer loop
vertex 43 65.5 11
vertex 41 67.5 10
vertex 42 68.5 11
endloop
endfacet
facet normal 0 -0 -1
outer loop
vertex 38 65 10
vertex 41 67.5 10
vertex 39 62 10
endloop
endfacet
facet normal 0.3 0.7 -0.7
outer loop
vertex 39 69.5 11
vertex 41 67.5 10
vertex 39 68.5 10
endloop
endfacet
facet normal 0 -0 -1
outer loop
vertex 35 66 10
vertex 41 67.5 10
vertex 38 65 10
endloop
endfacet
facet normal 0.7 0.3 -0.7
outer loop
vertex 43 65.5 11
vertex 42 65.5 10
vertex 41 67.5 10
endloop
endfacet
facet normal -0.9 -0.4 0
outer loop
vertex -39 -62 10
vertex -38 -65 6
vertex -38 -65 10
endloop
endfacet
facet normal -0.9 0.4 0
outer loop
vertex -39 -62 10
vertex -38 -59 10
vertex -39 -62 6
endloop
endfacet
facet normal -0.4 -0.9 0
outer loop
vertex -38 -65 10
vertex -35 -66 6
vertex -35 -66 10
endloop
endfacet
facet normal 0.4 -0.9 0
outer loop
vertex -35 -66 10
vertex -32 -65 6
vertex -32 -65 10
endloop
endfacet
facet normal -0.4 0.9 0
outer loop
vertex -38 -59 10
vertex -35 -58 10
vertex -38 -59 6
endloop
endfacet
facet normal 0.4 0.9 0
outer loop
vertex -35 -58 10
vertex -32 -59 10
vertex -35 -58 6
endloop
endfacet
facet normal -0.9 -0.4 -0
outer loop
vertex -39 -62 10
vertex -39 -62 6
vertex -38 -65 6
endloop
endfacet
facet normal -0.9 0.4 0
outer loop
vertex -38 -59 10
vertex -38 -59 6
vertex -39 -62 6
endloop
endfacet
facet normal -0.4 -0.9 -0
outer loop
vertex -38 -65 10
vertex -38 -65 6
vertex -35 -66 6
endloop
endfacet
facet normal 0.4 -0.9 0
outer loop
vertex -35 -66 10
vertex -35 -66 6
vertex -32 -65 6
endloop
endfacet
facet normal -0.4 0.9 0
outer loop
vertex -35 -58 10
vertex -35 -58 6
vertex -38 -59 6
endloop
endfacet
facet normal 0.4 0.9 0
outer loop
vertex -32 -59 10
vertex -32 -59 6
vertex -35 -58 6
endloop
endfacet
facet normal 0.9 -0.4 0
outer loop
vertex -32 -65 10
vertex -31 -62 6
vertex -31 -62 10
endloop
endfacet
facet normal 0.9 0.4 -0
outer loop
vertex -31 -62 10
vertex -32 -59 6
vertex -32 -59 10
endloop
endfacet
facet normal 0.9 -0.4 0
outer loop
vertex -32 -65 10
vertex -32 -65 6
vertex -31 -62 6
endloop
endfacet
facet normal 0.9 0.4 0
outer loop
vertex -31 -62 10
vertex -31 -62 6
vertex -32 -59 6
endloop
endfacet
facet normal -0.7 -0.3 0.7
outer loop
vertex -39 -62 6
vertex -43 -62 2
vertex -38 -65 6
endloop
endfacet
facet normal -0.7 -0.3 0.7
outer loop
vertex -38 -65 6
vertex -43 -62 2
vertex -40.5 -67.5 2
endloop
endfacet
facet normal -0.3 -0.7 0.7
outer loop
vertex -38 -65 6
vertex -40.5 -67.5 2
vertex -35 -70 2
endloop
endfacet
facet normal -0.7 0.3 0.7
outer loop
vertex -39 -62 6
vertex -38 -59 6
vertex -43 -62 2
endloop
endfacet
facet normal -0.7 0.3 0.7
outer loop
vertex -38 -59 6
vertex -40.5 -56.5 2
vertex -43 -62 2
endloop
endfacet
facet normal -0.3 0.7 0.7
outer loop
vertex -38 -59 6
vertex -35 -54 2
vertex -40.5 -56.5 2
endloop
endfacet
facet normal -0.3 -0.7 0.7
outer loop
vertex -38 -65 6
vertex -35 -70 2
vertex -35 -66 6
endloop
endfacet
facet normal 0.3 -0.7 0.7
outer loop
vertex -35 -66 6
vertex -35 -70 2
vertex -32 -65 6
endloop
endfacet
facet normal -0.3 0.7 0.7
outer loop
vertex -38 -59 6
vertex -35 -58 6
vertex -35 -54 2
endloop
endfacet
facet normal 0.3 0.7 0.7
outer loop
vertex -35 -58 6
vertex -32 -59 6
vertex -35 -54 2
endloop
endfacet
facet normal 0.7 -0.3 0.7
outer loop
vertex -32 -65 6
vertex -27 -62 2
vertex -31 -62 6
endloop
endfacet
facet normal 0.3 -0.7 0.7
outer loop
vertex -32 -65 6
vertex -35 -70 2
vertex -29.5 -67.5 2
endloop
endfacet
facet normal 0.7 -0.3 0.7
outer loop
vertex -32 -65 6
vertex -29.5 -67.5 2
vertex -27 -62 2
endloop
endfacet
facet normal 0.7 0.3 0.7
outer loop
vertex -31 -62 6
vertex -27 -62 2
vertex -32 -59 6
endloop
endfacet
facet normal 0.3 0.7 0.7
outer loop
vertex -32 -59 6
vertex -29.5 -56.5 2
vertex -35 -54 2
endloop
endfacet
facet normal 0.7 0.3 0.7
outer loop
vertex -32 -59 6
vertex -27 -62 2
vertex -29.5 -56.5 2
endloop
endfacet
facet normal -0.9 -0.4 -0
outer loop
vertex -40.5 -67.5 2
vertex -43 -62 2
vertex -43 -62 0
endloop
endfacet
facet normal -0.9 -0.4 0
outer loop
vertex -40.5 -67.5 2
vertex -43 -62 0
vertex -40.5 -67.5 0
endloop
endfacet
facet normal 0 0 -1
outer loop
vertex -40.5 -67.5 0
vertex -43 -62 0
vertex -40.5 -56.5 0
endloop
endfacet
facet normal -0.4 -0.9 -0
outer loop
vertex -40.5 -67.5 2
vertex -40.5 -67.5 0
vertex -35 -70 0
endloop
endfacet
facet normal 0 0 -1
outer loop
vertex -40.5 -67.5 0
vertex -40.5 -56.5 0
vertex -35 -70 0
endloop
endfacet
facet normal -0.9 0.4 0
outer loop
vertex -43 -62 2
vertex -40.5 -56.5 2
vertex -40.5 -56.5 0
endloop
endfacet
facet normal -0.4 0.9 0
outer loop
vertex -40.5 -56.5 2
vertex -35 -54 2
vertex -40.5 -56.5 0
endloop
endfacet
facet normal -0.9 0.4 0
outer loop
vertex -43 -62 2
vertex -40.5 -56.5 0
vertex -43 -62 0
endloop
endfacet
facet normal -0.4 -0.9 0
outer loop
vertex -40.5 -67.5 2
vertex -35 -70 0
vertex -35 -70 2
endloop
endfacet
facet normal 0.4 -0.9 0
outer loop
vertex -35 -70 2
vertex -35 -70 0
vertex -29.5 -67.5 0
endloop
endfacet
facet normal 0 0 -1
outer loop
vertex -35 -70 0
vertex -35 -54 0
vertex -29.5 -67.5 0
endloop
endfacet
facet normal 0.4 0.9 0
outer loop
vertex -35 -54 2
vertex -29.5 -56.5 2
vertex -35 -54 0
endloop
endfacet
facet normal 0 0 -1
outer loop
vertex -40.5 -56.5 0
vertex -35 -54 0
vertex -35 -70 0
endloop
endfacet
facet normal -0.4 0.9 0
outer loop
vertex -35 -54 2
vertex -35 -54 0
vertex -40.5 -56.5 0
endloop
endfacet
facet normal 0.4 -0.9 0
outer loop
vertex -35 -70 2
vertex -29.5 -67.5 0
vertex -29.5 -67.5 2
endloop
endfacet
facet normal 0.9 -0.4 0
outer loop
vertex -29.5 -67.5 2
vertex -29.5 -67.5 0
vertex -27 -62 2
endloop
endfacet
facet normal 0.9 -0.4 0
outer loop
vertex -27 -62 2
vertex -29.5 -67.5 0
vertex -27 -62 0
endloop
endfacet
facet normal 0 0 -1
outer loop
vertex -29.5 -67.5 0
vertex -29.5 -56.5 0
vertex -27 -62 0
endloop
endfacet
facet normal 0.9 0.4 0
outer loop
vertex -27 -62 2
vertex -27 -62 0
vertex -29.5 -56.5 2
endloop
endfacet
facet normal 0 0 -1
outer loop
vertex -35 -54 0
vertex -29.5 -56.5 0
vertex -29.5 -67.5 0
endloop
endfacet
facet normal 0.4 0.9 0
outer loop
vertex -35 -54 0
vertex -29.5 -56.5 2
vertex -29.5 -56.5 0
endloop
endfacet
facet normal 0.9 0.4 0
outer loop
vertex -29.5 -56.5 2
vertex -27 -62 0
vertex -29.5 -56.5 0
endloop
endfacet
facet normal -0.9 -0.4 0
outer loop
vertex -38 59 10
vertex -39 62 10
vertex -38 59 6
endloop
endfacet
facet normal -0.9 0.4 0
outer loop
vertex -39 62 10
vertex -38 65 10
vertex -39 62 6
endloop
endfacet
facet normal -0.4 -0.9 0
outer loop
vertex -38 59 10
vertex -35 58 6
vertex -35 58 10
endloop
endfacet
facet normal 0.4 -0.9 0
outer loop
vertex -35 58 10
vertex -32 59 6
vertex -32 59 10
endloop
endfacet
facet normal -0.4 0.9 0
outer loop
vertex -38 65 10
vertex -35 66 10
vertex -38 65 6
endloop
endfacet
facet normal 0.4 0.9 0
outer loop
vertex -35 66 10
vertex -32 65 10
vertex -35 66 6
endloop
endfacet
facet normal -0.9 -0.4 -0
outer loop
vertex -39 62 10
vertex -39 62 6
vertex -38 59 6
endloop
endfacet
facet normal -0.9 0.4 0
outer loop
vertex -38 65 10
vertex -38 65 6
vertex -39 62 6
endloop
endfacet
facet normal -0.4 -0.9 -0
outer loop
vertex -38 59 10
vertex -38 59 6
vertex -35 58 6
endloop
endfacet
facet normal 0.4 -0.9 0
outer loop
vertex -35 58 10
vertex -35 58 6
vertex -32 59 6
endloop
endfacet
facet normal -0.4 0.9 0
outer loop
vertex -35 66 10
vertex -35 66 6
vertex -38 65 6
endloop
endfacet
facet normal 0.4 0.9 0
outer loop
vertex -32 65 10
vertex -32 65 6
vertex -35 66 6
endloop
endfacet
facet normal 0.9 -0.4 0
outer loop
vertex -32 59 10
vertex -31 62 6
vertex -31 62 10
endloop
endfacet
facet normal 0.9 0.4 -0
outer loop
vertex -31 62 10
vertex -32 65 6
vertex -32 65 10
endloop
endfacet
facet normal 0.9 -0.4 0
outer loop
vertex -32 59 10
vertex -32 59 6
vertex -31 62 6
endloop
endfacet
facet normal 0.9 0.4 0
outer loop
vertex -31 62 10
vertex -31 62 6
vertex -32 65 6
endloop
endfacet
facet normal -0.7 -0.3 0.7
outer loop
vertex -38 59 6
vertex -39 62 6
vertex -43 62 2
endloop
endfacet
facet normal -0.7 -0.3 0.7
outer loop
vertex -38 59 6
vertex -43 62 2
vertex -40.5 56.5 2
endloop
endfacet
facet normal -0.3 -0.7 0.7
outer loop
vertex -38 59 6
vertex -40.5 56.5 2
vertex -35 54 2
endloop
endfacet
facet normal -0.7 0.3 0.7
outer loop
vertex -39 62 6
vertex -38 65 6
vertex -43 62 2
endloop
endfacet
facet normal -0.7 0.3 0.7
outer loop
vertex -38 65 6
vertex -40.5 67.5 2
vertex -43 62 2
endloop
endfacet
facet normal -0.3 0.7 0.7
outer loop
vertex -38 65 6
vertex -35 70 2
vertex -40.5 67.5 2
endloop
endfacet
facet normal -0.3 -0.7 0.7
outer loop
vertex -38 59 6
vertex -35 54 2
vertex -35 58 6
endloop
endfacet
facet normal 0.3 -0.7 0.7
outer loop
vertex -35 58 6
vertex -35 54 2
vertex -32 59 6
endloop
endfacet
facet normal -0.3 0.7 0.7
outer loop
vertex -38 65 6
vertex -35 66 6
vertex -35 70 2
endloop
endfacet
facet normal 0.3 0.7 0.7
outer loop
vertex -35 66 6
vertex -32 65 6
vertex -35 70 2
endloop
endfacet
facet normal 0.7 -0.3 0.7
outer loop
vertex -32 59 6
vertex -27 62 2
vertex -31 62 6
endloop
endfacet
facet normal 0.3 -0.7 0.7
outer loop
vertex -32 59 6
vertex -35 54 2
vertex -29.5 56.5 2
endloop
endfacet
facet normal 0.7 -0.3 0.7
outer loop
vertex -32 59 6
vertex -29.5 56.5 2
vertex -27 62 2
endloop
endfacet
facet normal 0.7 0.3 0.7
outer loop
vertex -31 62 6
vertex -27 62 2
vertex -32 65 6
endloop
endfacet
facet normal 0.3 0.7 0.7
outer loop
vertex -32 65 6
vertex -29.5 67.5 2
vertex -35 70 2
endloop
endfacet
facet normal 0.7 0.3 0.7
outer loop
vertex -32 65 6
vertex -27 62 2
vertex -29.5 67.5 2
endloop
endfacet
facet normal -0.9 -0.4 -0
outer loop
vertex -40.5 56.5 2
vertex -43 62 2
vertex -43 62 0
endloop
endfacet
facet normal -0.9 -0.4 0
outer loop
vertex -40.5 56.5 2
vertex -43 62 0
vertex -40.5 56.5 0
endloop
endfacet
facet normal -0.4 -0.9 -0
outer loop
vertex -40.5 56.5 2
vertex -40.5 56.5 0
vertex -35 54 0
endloop
endfacet
facet normal 0 0 -1
outer loop
vertex -40.5 56.5 0
vertex -40.5 67.5 0
vertex -35 54 0
endloop
endfacet
facet normal -0.9 0.4 0
outer loop
vertex -43 62 2
vertex -40.5 67.5 2
vertex -40.5 67.5 0
endloop
endfacet
facet normal -0.4 0.9 0
outer loop
vertex -40.5 67.5 2
vertex -35 70 2
vertex -40.5 67.5 0
endloop
endfacet
facet normal -0.9 0.4 0
outer loop
vertex -43 62 2
vertex -40.5 67.5 0
vertex -43 62 0
endloop
endfacet
facet normal 0 0 -1
outer loop
vertex -40.5 56.5 0
vertex -43 62 0
vertex -40.5 67.5 0
endloop
endfacet
facet normal -0.4 -0.9 0
outer loop
vertex -40.5 56.5 2
vertex -35 54 0
vertex -35 54 2
endloop
endfacet
facet normal 0.4 -0.9 0
outer loop
vertex -35 54 2
vertex -35 54 0
vertex -29.5 56.5 0
endloop
endfacet
facet normal 0 0 -1
outer loop
vertex -35 54 0
vertex -35 70 0
vertex -29.5 56.5 0
endloop
endfacet
facet normal 0.4 0.9 0
outer loop
vertex -35 70 2
vertex -29.5 67.5 2
vertex -35 70 0
endloop
endfacet
facet normal 0 0 -1
outer loop
vertex -40.5 67.5 0
vertex -35 70 0
vertex -35 54 0
endloop
endfacet
facet normal -0.4 0.9 0
outer loop
vertex -35 70 2
vertex -35 70 0
vertex -40.5 67.5 0
endloop
endfacet
facet normal 0.4 -0.9 0
outer loop
vertex -35 54 2
vertex -29.5 56.5 0
vertex -29.5 56.5 2
endloop
endfacet
facet normal 0.9 -0.4 0
outer loop
vertex -29.5 56.5 2
vertex -29.5 56.5 0
vertex -27 62 2
endloop
endfacet
facet normal 0.9 -0.4 0
outer loop
vertex -27 62 2
vertex -29.5 56.5 0
vertex -27 62 0
endloop
endfacet
facet normal 0.9 0.4 0
outer loop
vertex -27 62 2
vertex -27 62 0
vertex -29.5 67.5 2
endloop
endfacet
facet normal 0 0 -1
outer loop
vertex -35 70 0
vertex -29.5 67.5 0
vertex -29.5 56.5 0
endloop
endfacet
facet normal 0.4 0.9 0
outer loop
vertex -35 70 0
vertex -29.5 67.5 2
vertex -29.5 67.5 0
endloop
endfacet
facet normal 0 0 -1
outer loop
vertex -29.5 56.5 0
vertex -29.5 67.5 0
vertex -27 62 0
endloop
endfacet
facet normal 0.9 0.4 0
outer loop
vertex -29.5 67.5 2
vertex -27 62 0
vertex -29.5 67.5 0
endloop
endfacet
facet normal -0.9 -0.4 0
outer loop
vertex 32 -65 10
vertex 31 -62 10
vertex 32 -65 6
endloop
endfacet
facet normal -0.9 0.4 0
outer loop
vertex 31 -62 10
vertex 32 -59 10
vertex 31 -62 6
endloop
endfacet
facet normal -0.9 -0.4 -0
outer loop
vertex 31 -62 10
vertex 31 -62 6
vertex 32 -65 6
endloop
endfacet
facet normal -0.9 0.4 0
outer loop
vertex 32 -59 10
vertex 32 -59 6
vertex 31 -62 6
endloop
endfacet
facet normal -0.4 -0.9 0
outer loop
vertex 32 -65 10
vertex 35 -66 6
vertex 35 -66 10
endloop
endfacet
facet normal 0.4 -0.9 0
outer loop
vertex 35 -66 10
vertex 38 -65 6
vertex 38 -65 10
endloop
endfacet
facet normal -0.4 0.9 0
outer loop
vertex 32 -59 10
vertex 35 -58 10
vertex 32 -59 6
endloop
endfacet
facet normal 0.4 0.9 0
outer loop
vertex 35 -58 10
vertex 38 -59 10
vertex 35 -58 6
endloop
endfacet
facet normal 0.9 -0.4 0
outer loop
vertex 38 -65 10
vertex 39 -62 6
vertex 39 -62 10
endloop
endfacet
facet normal 0.9 0.4 -0
outer loop
vertex 39 -62 10
vertex 38 -59 6
vertex 38 -59 10
endloop
endfacet
facet normal -0.4 -0.9 -0
outer loop
vertex 32 -65 10
vertex 32 -65 6
vertex 35 -66 6
endloop
endfacet
facet normal 0.4 -0.9 0
outer loop
vertex 35 -66 10
vertex 35 -66 6
vertex 38 -65 6
endloop
endfacet
facet normal -0.4 0.9 0
outer loop
vertex 35 -58 10
vertex 35 -58 6
vertex 32 -59 6
endloop
endfacet
facet normal 0.4 0.9 0
outer loop
vertex 38 -59 10
vertex 38 -59 6
vertex 35 -58 6
endloop
endfacet
facet normal 0.9 -0.4 0
outer loop
vertex 38 -65 10
vertex 38 -65 6
vertex 39 -62 6
endloop
endfacet
facet normal 0.9 0.4 0
outer loop
vertex 39 -62 10
vertex 39 -62 6
vertex 38 -59 6
endloop
endfacet
facet normal -0.7 -0.3 0.7
outer loop
vertex 32 -65 6
vertex 31 -62 6
vertex 27 -62 2
endloop
endfacet
facet normal -0.7 -0.3 0.7
outer loop
vertex 32 -65 6
vertex 27 -62 2
vertex 29.5 -67.5 2
endloop
endfacet
facet normal -0.3 -0.7 0.7
outer loop
vertex 32 -65 6
vertex 29.5 -67.5 2
vertex 35 -70 2
endloop
endfacet
facet normal -0.7 0.3 0.7
outer loop
vertex 31 -62 6
vertex 32 -59 6
vertex 27 -62 2
endloop
endfacet
facet normal -0.7 0.3 0.7
outer loop
vertex 32 -59 6
vertex 29.5 -56.5 2
vertex 27 -62 2
endloop
endfacet
facet normal -0.3 0.7 0.7
outer loop
vertex 32 -59 6
vertex 35 -54 2
vertex 29.5 -56.5 2
endloop
endfacet
facet normal -0.3 -0.7 0.7
outer loop
vertex 32 -65 6
vertex 35 -70 2
vertex 35 -66 6
endloop
endfacet
facet normal 0.3 -0.7 0.7
outer loop
vertex 35 -66 6
vertex 35 -70 2
vertex 38 -65 6
endloop
endfacet
facet normal -0.3 0.7 0.7
outer loop
vertex 32 -59 6
vertex 35 -58 6
vertex 35 -54 2
endloop
endfacet
facet normal 0.3 0.7 0.7
outer loop
vertex 35 -58 6
vertex 38 -59 6
vertex 35 -54 2
endloop
endfacet
facet normal 0.7 -0.3 0.7
outer loop
vertex 38 -65 6
vertex 43 -62 2
vertex 39 -62 6
endloop
endfacet
facet normal 0.3 -0.7 0.7
outer loop
vertex 38 -65 6
vertex 35 -70 2
vertex 40.5 -67.5 2
endloop
endfacet
facet normal 0.7 -0.3 0.7
outer loop
vertex 38 -65 6
vertex 40.5 -67.5 2
vertex 43 -62 2
endloop
endfacet
facet normal 0.7 0.3 0.7
outer loop
vertex 39 -62 6
vertex 43 -62 2
vertex 38 -59 6
endloop
endfacet
facet normal 0.3 0.7 0.7
outer loop
vertex 38 -59 6
vertex 40.5 -56.5 2
vertex 35 -54 2
endloop
endfacet
facet normal 0.7 0.3 0.7
outer loop
vertex 38 -59 6
vertex 43 -62 2
vertex 40.5 -56.5 2
endloop
endfacet
facet normal -0.9 -0.4 -0
outer loop
vertex 29.5 -67.5 2
vertex 27 -62 2
vertex 27 -62 0
endloop
endfacet
facet normal -0.9 -0.4 0
outer loop
vertex 29.5 -67.5 2
vertex 27 -62 0
vertex 29.5 -67.5 0
endloop
endfacet
facet normal 0 0 -1
outer loop
vertex 29.5 -67.5 0
vertex 27 -62 0
vertex 29.5 -56.5 0
endloop
endfacet
facet normal -0.4 -0.9 -0
outer loop
vertex 29.5 -67.5 2
vertex 29.5 -67.5 0
vertex 35 -70 0
endloop
endfacet
facet normal 0 0 -1
outer loop
vertex 29.5 -67.5 0
vertex 29.5 -56.5 0
vertex 35 -70 0
endloop
endfacet
facet normal -0.9 0.4 0
outer loop
vertex 27 -62 2
vertex 29.5 -56.5 2
vertex 29.5 -56.5 0
endloop
endfacet
facet normal -0.4 0.9 0
outer loop
vertex 29.5 -56.5 2
vertex 35 -54 2
vertex 29.5 -56.5 0
endloop
endfacet
facet normal -0.9 0.4 0
outer loop
vertex 27 -62 2
vertex 29.5 -56.5 0
vertex 27 -62 0
endloop
endfacet
facet normal -0.4 -0.9 0
outer loop
vertex 29.5 -67.5 2
vertex 35 -70 0
vertex 35 -70 2
endloop
endfacet
facet normal 0.4 -0.9 0
outer loop
vertex 35 -70 2
vertex 35 -70 0
vertex 40.5 -67.5 0
endloop
endfacet
facet normal 0 0 -1
outer loop
vertex 35 -70 0
vertex 35 -54 0
vertex 40.5 -67.5 0
endloop
endfacet
facet normal 0.4 0.9 0
outer loop
vertex 35 -54 2
vertex 40.5 -56.5 2
vertex 35 -54 0
endloop
endfacet
facet normal 0 0 -1
outer loop
vertex 29.5 -56.5 0
vertex 35 -54 0
vertex 35 -70 0
endloop
endfacet
facet normal -0.4 0.9 0
outer loop
vertex 29.5 -56.5 0
vertex 35 -54 2
vertex 35 -54 0
endloop
endfacet
facet normal 0.4 -0.9 0
outer loop
vertex 35 -70 2
vertex 40.5 -67.5 0
vertex 40.5 -67.5 2
endloop
endfacet
facet normal 0.9 -0.4 0
outer loop
vertex 40.5 -67.5 2
vertex 40.5 -67.5 0
vertex 43 -62 2
endloop
endfacet
facet normal 0.9 -0.4 0
outer loop
vertex 43 -62 2
vertex 40.5 -67.5 0
vertex 43 -62 0
endloop
endfacet
facet normal 0 0 -1
outer loop
vertex 40.5 -67.5 0
vertex 40.5 -56.5 0
vertex 43 -62 0
endloop
endfacet
facet normal 0.9 0.4 0
outer loop
vertex 43 -62 2
vertex 43 -62 0
vertex 40.5 -56.5 2
endloop
endfacet
facet normal 0 0 -1
outer loop
vertex 35 -54 0
vertex 40.5 -56.5 0
vertex 40.5 -67.5 0
endloop
endfacet
facet normal 0.4 0.9 0
outer loop
vertex 40.5 -56.5 2
vertex 40.5 -56.5 0
vertex 35 -54 0
endloop
endfacet
facet normal 0.9 0.4 0
outer loop
vertex 40.5 -56.5 2
vertex 43 -62 0
vertex 40.5 -56.5 0
endloop
endfacet
facet normal -0.9 -0.4 0
outer loop
vertex 32 59 10
vertex 31 62 10
vertex 32 59 6
endloop
endfacet
facet normal -0.9 0.4 0
outer loop
vertex 31 62 10
vertex 32 65 10
vertex 31 62 6
endloop
endfacet
facet normal -0.9 -0.4 -0
outer loop
vertex 31 62 10
vertex 31 62 6
vertex 32 59 6
endloop
endfacet
facet normal -0.9 0.4 0
outer loop
vertex 32 65 10
vertex 32 65 6
vertex 31 62 6
endloop
endfacet
facet normal -0.4 -0.9 0
outer loop
vertex 32 59 10
vertex 35 58 6
vertex 35 58 10
endloop
endfacet
facet normal 0.4 -0.9 0
outer loop
vertex 35 58 10
vertex 38 59 6
vertex 38 59 10
endloop
endfacet
facet normal -0.4 0.9 0
outer loop
vertex 32 65 10
vertex 35 66 10
vertex 32 65 6
endloop
endfacet
facet normal 0.4 0.9 0
outer loop
vertex 35 66 10
vertex 38 65 10
vertex 35 66 6
endloop
endfacet
facet normal 0.9 -0.4 0
outer loop
vertex 38 59 10
vertex 39 62 6
vertex 39 62 10
endloop
endfacet
facet normal 0.9 0.4 0
outer loop
vertex 38 65 10
vertex 39 62 10
vertex 38 65 6
endloop
endfacet
facet normal -0.4 -0.9 -0
outer loop
vertex 32 59 10
vertex 32 59 6
vertex 35 58 6
endloop
endfacet
facet normal 0.4 -0.9 0
outer loop
vertex 35 58 10
vertex 35 58 6
vertex 38 59 6
endloop
endfacet
facet normal -0.4 0.9 0
outer loop
vertex 35 66 10
vertex 35 66 6
vertex 32 65 6
endloop
endfacet
facet normal 0.4 0.9 0
outer loop
vertex 38 65 10
vertex 38 65 6
vertex 35 66 6
endloop
endfacet
facet normal 0.9 -0.4 0
outer loop
vertex 38 59 10
vertex 38 59 6
vertex 39 62 6
endloop
endfacet
facet normal 0.9 0.4 0
outer loop
vertex 39 62 10
vertex 39 62 6
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
