hakanuzum/gmktec-k11-dual-fan-case/docs/images/fan-side.png

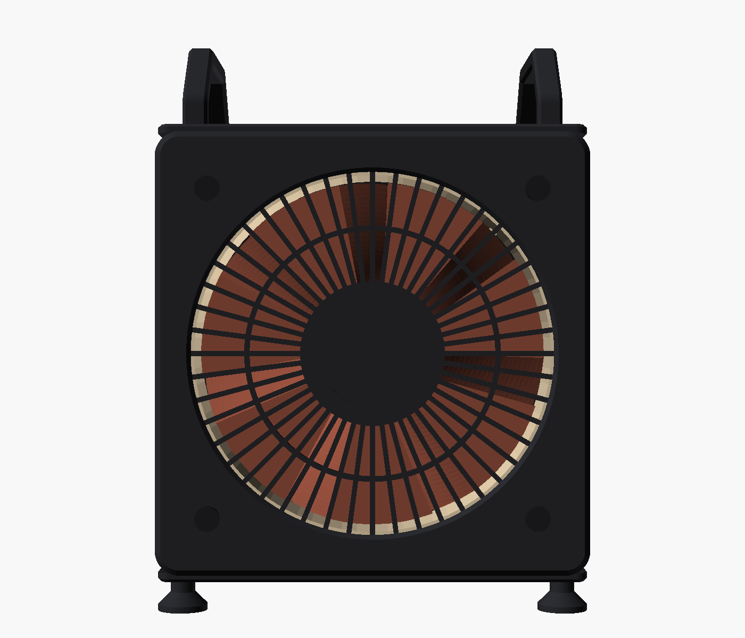
docs/images/fan-side.png
