hakanuzum/gmktec-k11-dual-fan-case/docs/images/holder-inside.png

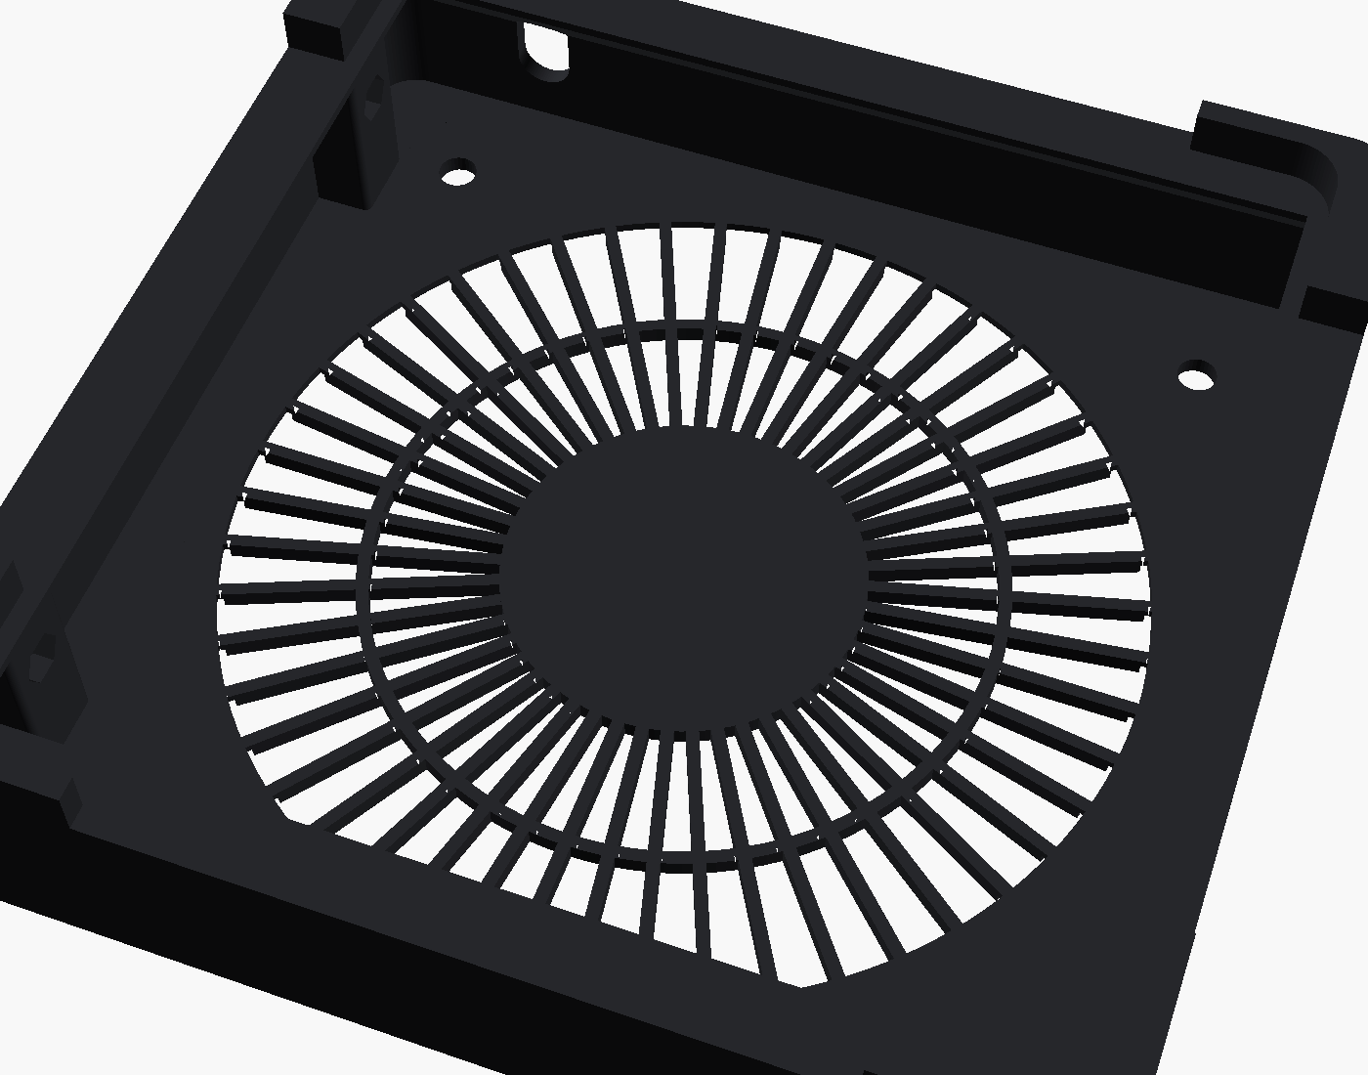
docs/images/holder-inside.png
