hakanuzum/gmktec-k11-dual-fan-case/docs/images/rear.png

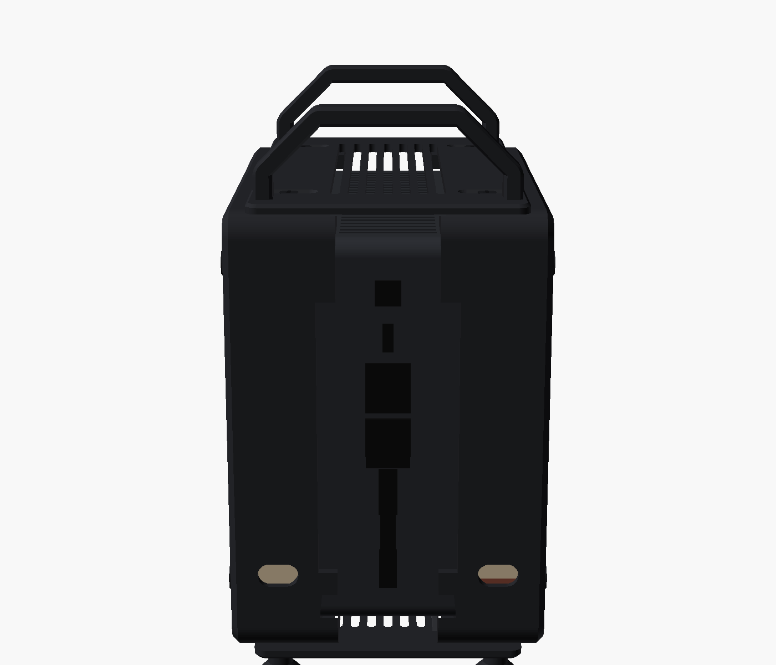
docs/images/rear.png
