hakanuzum/gmktec-k11-dual-fan-case/docs/images/section.png

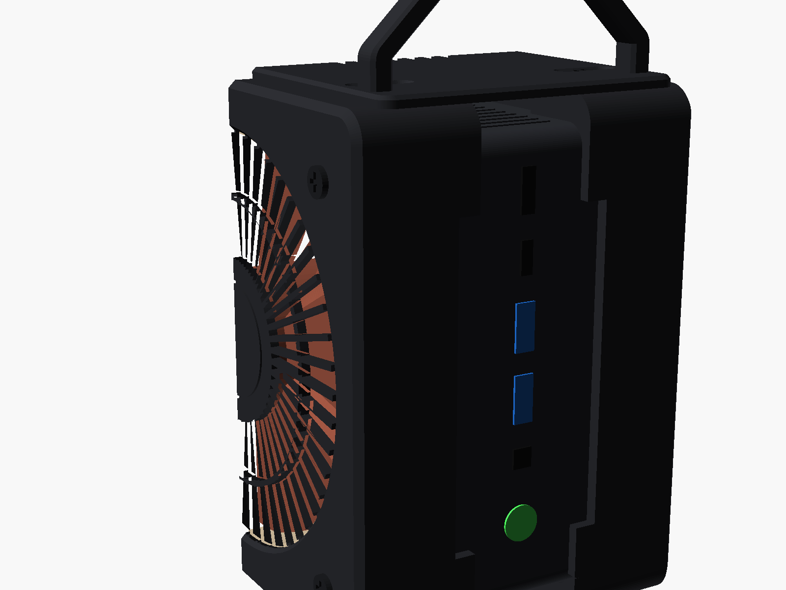
docs/images/section.png
