hakanuzum/gmktec-k11-dual-fan-case/stl/heat-set-insert/fan_holder_right.stl

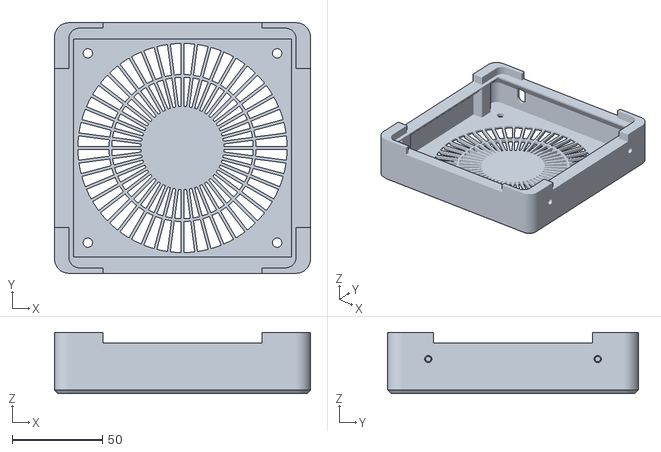
[picture p6: CAD file, 2026-11-01]
stl/heat-set-insert/fan_holder_right.stl
142.0 x 139.0 x 34.0
