hakanuzum/gmktec-k11-dual-fan-case/stl/top_plate.stl

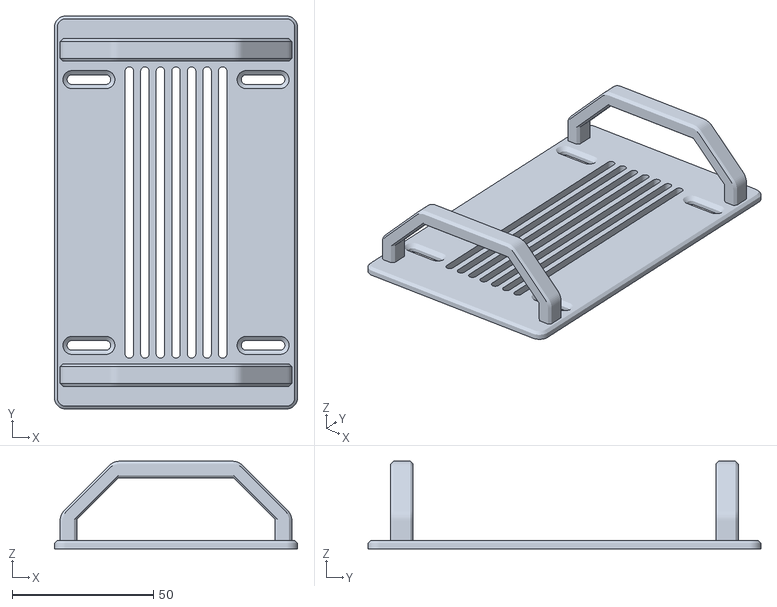
[picture p7: CAD file, 2026-11-01]
stl/top_plate.stl
86.0 x 139.0 x 31.0
