hakanuzum/gmktec-k11-dual-fan-case/stl/bottom_plate.stl

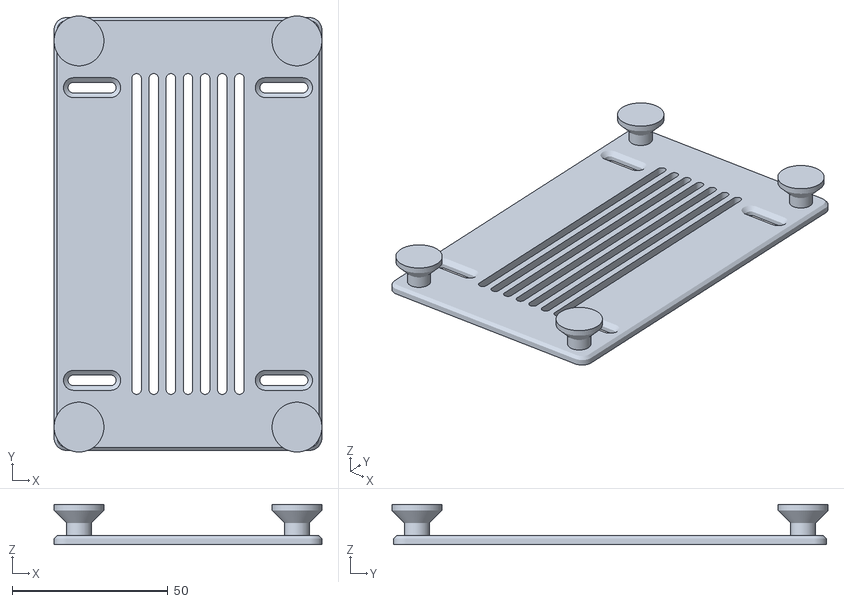
[picture p8: CAD file, 2026-11-01]
stl/bottom_plate.stl
86.0 x 140.0 x 13.0
