hakanuzum/gmktec-k11-dual-fan-case/(list of files, cad)

Other CAD files:
stl/fan_holder_left.stl
stl/heat-set-insert/fan_holder_left.stl
stl/fan_holder_right.stl
