hakanuzum/gmktec-k11-dual-fan-case/docs/images/print-layout.png

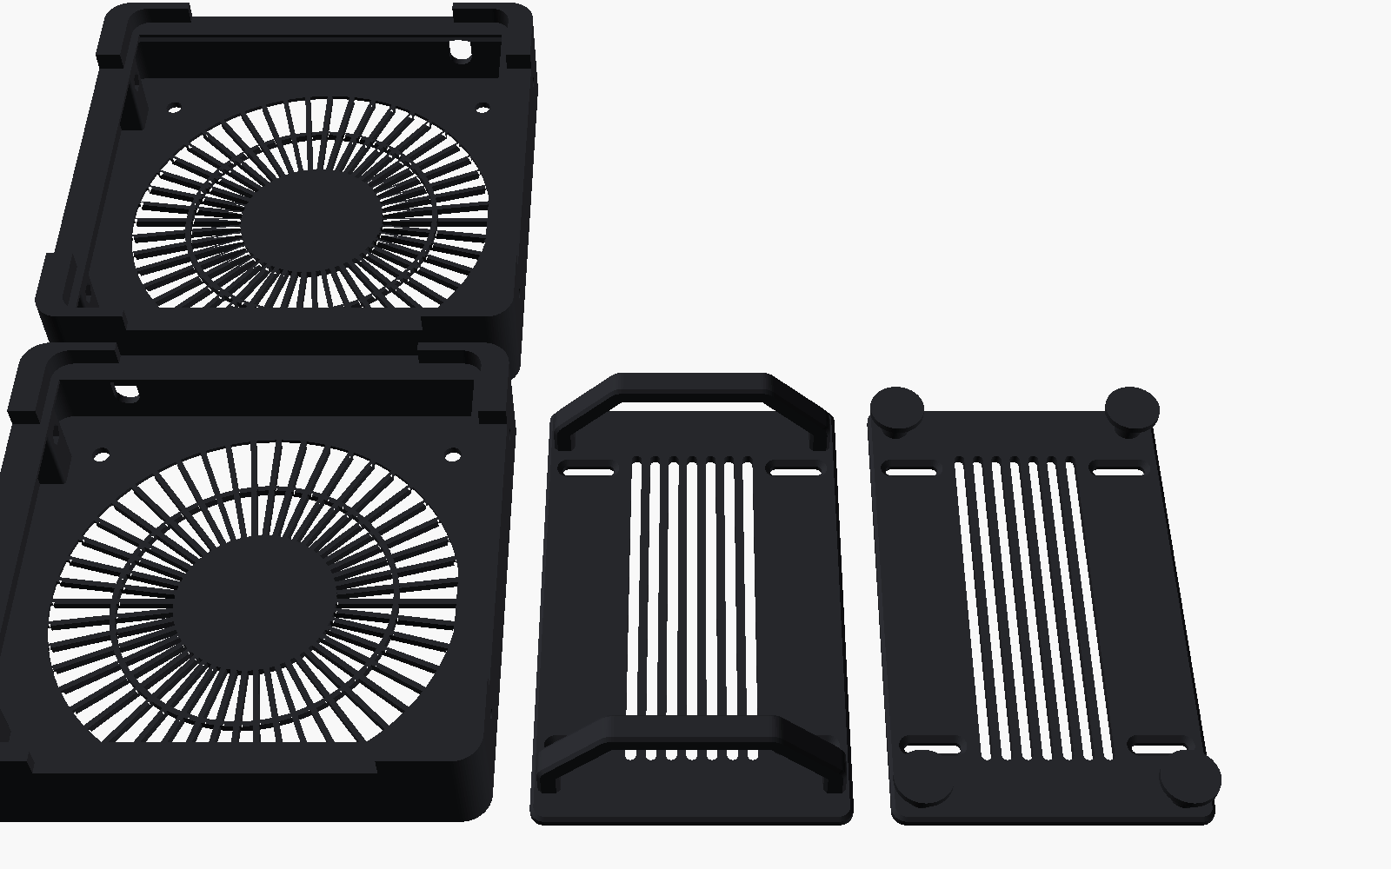
docs/images/print-layout.png
