hakanuzum/gmktec-k11-dual-fan-case/(commit log)

2026-11-01 GMKtec K11 dual-fan case: OpenSCAD source, STLs, 3D viewer, docs
    Two USB-powered 120 mm fans in a closed, printable enclosure for the
    GMKtec K11. Front and rear ports stay open; slotted plates fit any body
    thickness from 32 to 56 mm; plate screws thread into captive M3 nuts
    (heat-set insert variant included).
    - cad/: parametric OpenSCAD source
    - stl/: print-ready parts (+ heat-set-insert fan holders)
    - viewer/: interactive 3D viewer (GitHub Pages)
    - docs/: bill of materials, printing, assembly, fans and power, design notes
    - tools/: build script and 540 geometric acceptance checks
    [bottom_plate.stl, fan_holder_left.stl, fan_holder_right.stl, handle.stl, k11_dual_fan_case.scad, top_plate.stl]
2026-11-01 Explain how the screwless handles are held: assembly pictures
2026-11-01 One-piece top plate with handles; support-free printing; assembly-path checks
    The separate handles could not be assembled: a closed U with flanges wider
    than the plate holes cannot pass through them. The handles are now part
    of the top plate (70 x 22 mm finger opening, 45° shoulders, one 40 mm
    bridge per handle), so there is nothing to attach.
    Printability fixes found by the new layer-by-layer overhang analysis:
    - fan holders: the seat frame was an 8 mm ledge over the hollow cavity;
    the cavity roof now slopes at 45° up to the frame
    - nut pockets: flats up/down in print, roof is a 3.3 mm bridge
    - cable hole cuts through the 45° roof into the cavity
    New checks: straight-line assembly pa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
    [fan_holder_left.stl, fan_holder_right.stl, handle.stl, k11_dual_fan_case.scad, top_plate.stl]
