hakanuzum/gmktec-k11-dual-fan-case/(notices)

Notices in the files:
README.md:
License:
Design files (`cad/`, `stl/`, `docs/`) are licensed under [CC BY-SA 4.0](https://creativecommons.org/licenses/by-sa/4.0/). Code (`tools/`, the viewer script) is under the MIT License. See [LICENSE.md](LICENSE.md).
